aryankalra404/Neuryo-Headset/pcb/README.md

# Neuryo EEG board, rev B (plan)

**Status (5th pass, 11 Nov 2026):** designed in KiCad 10 ([neuryo-rev-b/](neuryo-rev-b/)), ERC/DRC/netlist checked after every step, firmware written, order files drafted ([order-draft-do-not-order/](neuryo-rev-b/review/order-draft-do-not-order/)), **not ordered**: the owner's checks before paying are in [checklist section 9](neuryo-rev-b/REVIEW-CHECKLIST.md) ([5th-pass changes](neuryo-rev-b/CHANGES.md#5th-pass-11-nov-2026), [assembly notes and placement-preview list](neuryo-rev-b/ASSEMBLY.md)). Rev B copies the analog half of a proven open board and adds a ready-made ESP32 board. Rev A (30 Oct, the v3 board: Cyton circuit, auto-routed, 100 × 80 mm, DevKit on sockets) is removed from this folder; it is in the git history (commit `14b8c37` and earlier).

| Folder | What is in it |
|---|---|
| [neuryo-rev-b/](neuryo-rev-b/) | Rev B in KiCad 10: project, [change list](neuryo-rev-b/CHANGES.md), [review checklist](neuryo-rev-b/REVIEW-CHECKLIST.md), renders, ERC/DRC reports, netlist and copper diffs against the reference, the reference imported into KiCad, and the scripts that made the edits |
| [low-cost-eeg/](low-cost-eeg/) | The upstream repo, complete (hardware, production files, firmware, receiver, case STLs, docs). The design rev B copies: [Low-Cost-EEG](https://github.com/XavierAsghar/Low-Cost-EEG) by Xavier Asghar, commit `3730d31` (12 Aug 2026). GPL-3.0 ([LICENSE](low-cost-eeg/LICENSE)); what was left out is listed in its [NOTICE](low-cost-eeg/NOTICE.md). **Do not order from `low-cost-eeg/Production_Files/NC Drill` as it is:** its drill coordinates are offset from the Gerbers (round-hole centres span x 64.4–158.9 mm, y 51.7–97.9 mm, while the Gerber outline is 0–100 × 0–50 mm) |

## Why this board
- **Same chips as ours:** ADS1299 (8 channels, SRB2 reference, bias drive) and an ESP32-S3, battery powered, 4-layer.
- **Built and used:** it recorded ECG, EMG, eyes-closed alpha, SSVEPs and P300s (Final Report, chapter 5), and a second person [rebuilt it](https://github.com/agteo/diy-eeg-mac) from the same files and recorded alpha.
- **Measured:** 1.10 µVpp input-referred noise with the inputs shorted, on the board itself (Final Report, section 6.1; the 2 µVpp earlier in the report is TI's evaluation board). The ADS1299 datasheet gives 1.13 µVpp typical at gain 12, 250 SPS.
- **Its analog section follows the OpenBCI Cyton**, like rev A did.

## What rev B copies unchanged (the analog half, about 55 × 50 mm)
In the KiCad rev B the analog half (x < 56 mm) and the LM27762 block are unchanged apart from the review changes; the TPS7A20 and its two capacitors had to be re-laid out in a strip under the LM27762 block (see [CHANGES B4](neuryo-rev-b/CHANGES.md)).

Placement, routing, ground pours and stitching kept as in the reference, left half of its board:
- Electrode inputs: 2.54 mm pin headers, 8 differential pairs, BIAS, SRB2.
- TPD4E1B06 ESD diodes, then 2.2 kΩ + 1 nF C0G low-pass on every input.
- ADS1299 with its decoupling, bipolar ±2.5 V mode.
- LM27762 charge-pump LDO for ±2.5 V; TPS7A20 low-noise LDO giving the ADS1299 its own 3.3 V.
- Stack-up: signal / ground / segmented power / signal; no split ground plane; analog left, digital right.

## What rev B changes (the digital half)
| Removed from the reference | Added in rev B |
|---|---|
| ESP32-S3-WROOM-1 and its 3.3 V LDO | Seeed XIAO ESP32-S3, soldered flat on castellated pads (Seeed's KiCad footprint); its 3V3 feeds the digital parts |
| USB-C, USB ESD, boot and reset buttons | The XIAO's own USB-C and buttons |
| USB / battery selector switch | Battery on/off slide switch (C&K PCM12, right edge); battery JST-PH (right edge) to the XIAO's BAT pads (the XIAO charges it) and to the LM27762 and TPS7A20 inputs |
| UART header | J6: earlobe MAX30102 and J7: BMI270, 1×4 headers on one I²C bus (the forehead MAX30102 header J8 was dropped) |
| | Battery divider (2 × 220 kΩ + 100 nF) to an ADC pin; USB-present divider; USB interlock (Q1, R37, R38) |
| | Outline 77 × 50 mm (the LM27762 block is kept in place, so 70 was not reachable), 2 mounting holes, for the v6 left pod |

## XIAO pin map
Final map in [neuryo-rev-b/CHANGES.md](neuryo-rev-b/CHANGES.md#final-xiao-pin-map-replaces-the-draft-in-pcbreadmemd). SPI on D1–D5 (330 Ω in series on SCLK, MOSI, CS since the 4th pass), battery on D0, I²C on D7/D8 (4.7 k pull-ups), USB sense on D9, ADS1299 RESET on D10 (4th pass); START and PWDN are tied (change 4).

## Review (8 Nov 2026): changes needed before ordering
Checked against the reference schematic and firmware (upstream `main.cpp`), the ADS1299 datasheet and the Seeed XIAO ESP32-S3 wiki.

| # | Change | Why |
|---|---|---|
| 1 | **Reference through SRB2, filtered.** Move R27 (2.2 kΩ) and C31 (1 nF) from SRB1 (pin 17) to SRB2 (pin 18, the next pin); leave SRB1 open and drop the header's direct SRB2 line. | On the reference, the REF header goes through R27/C31 to SRB1, but its SRB2 pin runs straight to the ADS1299 with no series resistor or filter. Upstream firmware uses SRB1 (MISC1 = 0x20, electrodes on the P inputs). D25 needs SRB2 so channel 8 can run differential (ECG). |
| 2 | **Analog off while USB is plugged in.** XIAO 5V pin → 2N7002 gate (100 kΩ to ground); its drain pulls the LM27762 EN+/EN− and TPS7A20 EN net (100 kΩ up to the battery) low. D9 (GPIO8) reads USB-present through a divider; firmware keeps the SPI pins high-impedance then. | Recording only on battery isolates the patient from mains. The XIAO's 5V pin is live only on USB (Seeed). The reference author lists this as the top-priority fix (Final Report 6.4). |
| 3 | **Charge batteries outside the headset.** Removable JST-PH cell, a separate charger and a spare. | The XIAO ESP32-S3 charges at 50 mA (Seeed), about 20 h for 1000 mAh. |
| 4 | **Pins with no XIAO GPIO:** START to ground through 10 kΩ (use the START command), RESET and PWDN to DVDD through 10 kΩ (RESET command), CLKSEL high as on the reference. Firmware sets BIASREF_INT = 1 (CONFIG3), as upstream does; the BIASREF pin is tied to AVSS on this board. | Datasheet: keep START low when using the command; mode pins through ≥ 10 kΩ. Upstream issue #1 (RESET on GPIO8 vs GPIO14) does not apply: rev B has no RESET GPIO. |
| 5 | **BIAS series resistor 51 kΩ** (R10, was 2.2 kΩ). Inputs stay 2.2 kΩ for the prototype; revisit with the test lab. | The bias amplifier can source 1.1 mA (datasheet) against DC patient-current limits of 10 µA normal and 50 µA single fault. TI's own figures show 51 kΩ patient-protection resistors. A 51 kΩ input resistor would add about 0.23 µVrms of noise, so not on the inputs yet. The reference author found the bias drive gave no benefit on ECG, so test with it on and off. |
| 6 | **Keep the bottom-side parts.** The 17 input filter capacitors, R32–R35, C49 and D6 are on the bottom: order two-sided assembly or hand-solder them; don't move analog parts. | The analog layout is the part that is proven. |
| 7 | **XIAO flat on the board:** its BAT pads are underneath, so the footprint needs matching pads and hot-air or hot-plate soldering; no copper or vias under its other pads. | Castellated edges can be hand-soldered, the underside cannot. |
| 8 | **Stock check:** ADS1299IPAGR, LM27762DSSR, TPS7A2033PDBVR, TPD4E1B06DCKR at LCSC/JLCPCB. | One order. |

## Channel map (v4)
Electrodes on the N inputs with M1 on SRB2 (through the filtered REF path, change 1), as on the Cyton: ch 1 Fp1, ch 2 Fp2, ch 3 Fz, ch 4 Pz, ch 5 M2, ch 6 eye, ch 7 free (no Cz pod anywhere, decision D36, v6.3), ch 8 ECG (SRB2 off, differential, test kit). BIAS to Fpz.

## Steps
1. ~~Import the reference into KiCad and check it~~ (done 8 Nov: BOM references and board/schematic connectivity match; sheet-by-sheet PDF comparison is on the checklist).
2. ~~Remove the module side; add the XIAO, J6, J7, interlock, dividers~~ (done; see the change list).
3. ~~ERC, DRC, netlist diff after every change~~ (done; reports in `neuryo-rev-b/review/`). 3D check in the v6 left pod done in the model (9 Nov, v6.1): with every rev B part at its KiCad position and height, the pod grows to about 98 × 77 mm and 22 mm off the skin (docs/v6.md).
   - Second pass (8 Nov, done): battery and a smaller switch (C&K PCM12) moved back to the right-hand end; XIAO pad 25 to GND (checked against Seeed's module PCB); KiCad SOT-23 for Q1; JLC 1.6 mm stack-up; silkscreen tidied; rev B firmware written ([neuryo-rev-b/firmware/](neuryo-rev-b/firmware/)). See CHANGES "2nd pass".
   - Fifth pass (11 Nov, done): from the 11 Nov review. LCSC numbers for every assembled part (in-stock equivalents for nine out-of-stock reference parts), R37 10 k, J1 drill 0.8 mm, JLCPCB-format placement file, clean order folder (PTH/NPTH split), firmware USB-restart fix, 150 ms reference wait, CONFIG3 0xEE. See CHANGES "5th pass".
   - Fourth pass (10 Nov, done): from the 10 Nov design review. Plated holes through the XIAO's BAT pads and no paste on its pads; 330 Ω on SCLK/MOSI/CS; 4.7 k I²C pull-ups; D10 to ADS1299 RESET; test pads on MISO/DRDY/AEN; bench firmware build and an honest ADS status; LCSC numbers; [ASSEMBLY.md](neuryo-rev-b/ASSEMBLY.md). See CHANGES "4th pass".
4. Professor review ([checklist](neuryo-rev-b/REVIEW-CHECKLIST.md)).
5. Order 2 assembled boards (JLCPCB); hand-solder the XIAOs. For the v6 left pod, leave the electrode input headers off and solder each lead into its two holes (the headers stand about 8.4 mm: Samtec TSW-xxx-26 is a 5.84 mm post on a 2.54 mm body). Footprints and layout stay as in the reference.
   - v7 pod (11 Nov): also leave JP1 and TP1 off (both hand-solder parts in `bom-hand.csv`; their footprints stay on the board). With v7's flat pod face, JP1 with its shunt (16.6 mm off the skin on the pod axis) would set the cover 4 mm higher, TP1 (12.6 mm) just above J1 (12.4 mm). JP1 joins BIAS_OUT to the ADS1299's BIASIN pin; the bias drive to Fpz runs BIAS_OUT → R10 → BIAS and does not go through it, and the firmware leaves BIAS_MEAS off (CONFIG3 0xEE, CHANGES F12). If JP1 ever has to be closed, solder a flat wire link across its two holes instead of the header. For a ground clip during bring-up, use any GND pad instead of TP1.
6. First board: power rails, ADS1299 ID register, shorted-input noise against the 6 µVpp target, then alpha with eyes closed.

## Licence
The reference is GPL-3.0, so rev B's board files will be GPL-3.0 too. That is fine for the prototype; decide before the product whether to keep the board open or redraw it.
