aryankalra404/Neuryo-Headset/pcb/neuryo-rev-b/README.md

# Neuryo rev B (KiCad 10)

The Low-Cost-EEG board (commit `3730d31`) with its ESP32-S3 module side replaced by a Seeed XIAO ESP32-S3, the review changes from `../README.md`, I²C headers for the earlobe MAX30102 and a BMI270, and a 77 × 50 mm outline for the v6 left pod. Battery and switch sit at the right-hand (digital) end. The stack-up is JLCPCB 4-layer 1.6 mm. 4th pass (10 Nov): 330 Ω on SCLK/MOSI/CS, I²C pull-ups, D10 → RESET, test pads, plated XIAO battery holes, bench firmware build. 5th pass (11 Nov): part numbers for everything JLCPCB assembles, R37 10 k, J1 drill 0.8 mm, order folder in [review/order-draft-do-not-order/](review/order-draft-do-not-order/). **Not ordered; waiting for review.**

| Path | What it is |
|---|---|
| `Neuryo_RevB.kicad_pro` / `.kicad_sch` / `.kicad_pcb` / `.kicad_dru` | The rev B project (KiCad 10.0.8). Zones are filled. |
| `Neuryo_RevB.pretty`, `Neuryo_RevB.kicad_sym` | New footprints and symbols: Seeed XIAO-ESP32-S3-SMD (from Seeed's library), KiCad's SOT-23 and SW_SPDT_PCM12 (C&K PCM12 slide switch), 1×4 header, 2N7002, PWR_FLAG |
| `Low_Cost_EEG-import-fps.pretty` | Footprints imported from the reference |
| [CHANGES.md](CHANGES.md) | Every change, why, its source, and whether it is verified |
| [REVIEW-CHECKLIST.md](REVIEW-CHECKLIST.md) | What to check before ordering |
| [ASSEMBLY.md](ASSEMBLY.md) | Hand-soldered parts (XIAO through its battery holes), bench board, battery polarity, electrodes |
| [firmware/](firmware/) | Rev B firmware (PlatformIO, XIAO ESP32-S3): upstream's with rev B pins, SRB2, command-driven RESET/START, USB interlock, battery and I²C status |
| `baseline-import/` | The reference imported into KiCad unchanged (plus the translated Altium clearance rules), for side-by-side comparison |
| `review/` | Renders (`top.png`, `bottom.png`), `schematic.pdf`, `layers.pdf`, ERC/DRC JSON, netlists, the netlist and copper diffs, the baseline's reports, a draft fab set (not for ordering) and `bom-jlc.csv`, the BOM with part numbers to order from |
| `scripts/` | The scripts that made every edit: `edit_sch.py`, `edit_pcb.py`, `edit_pcb2.py`, `silkplace.py` (reference-designator placement), `convmod.py` (KiCad 5 footprint to current format), `edit_sch_mpn.py` (restores the reference's part numbers), `jlcbom.py` (BOM with part numbers, no KiCad needed), `edit_sch4.py` and `edit_pcb4.py` (4th pass, one letter per plan step), `edit_sch5.py` and `edit_pcb5.py` (5th pass), `jlcbom.py` / `jlccpl.py` (BOM and placement file), plus the checks (`netdiff.py`, `copperdiff.py`, `drcsum.py`, `gerbdiff.py`) and `runner.sh`, which runs `kicad-cli` and PlatformIO. The paths inside them are the build machine's. |

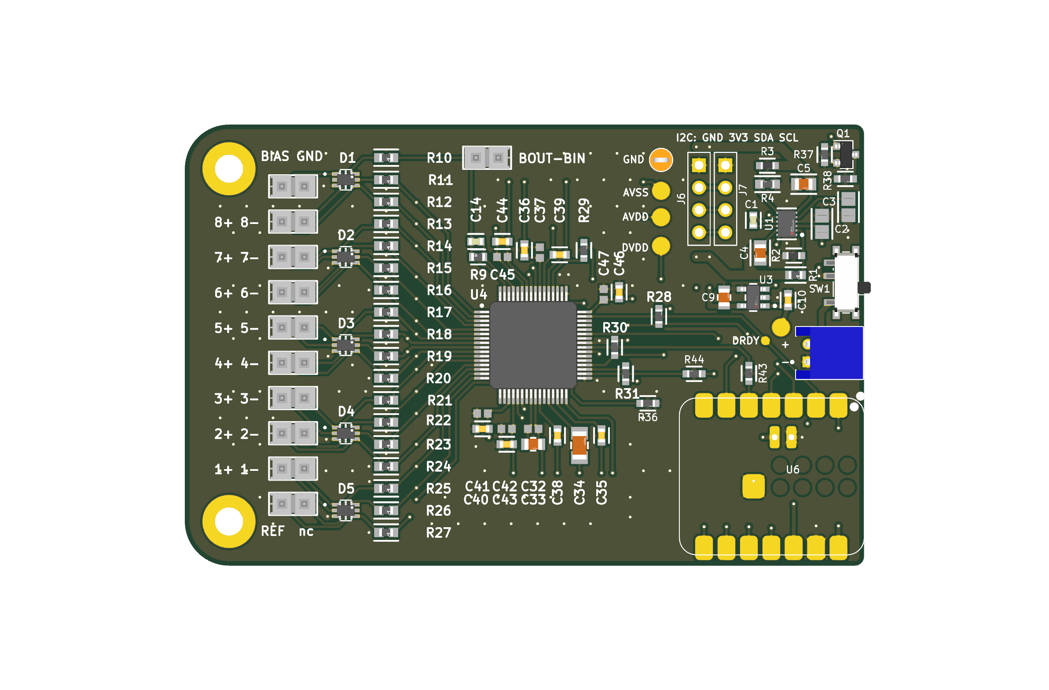
[picture p1: pcb/neuryo-rev-b/review/top.png]
top

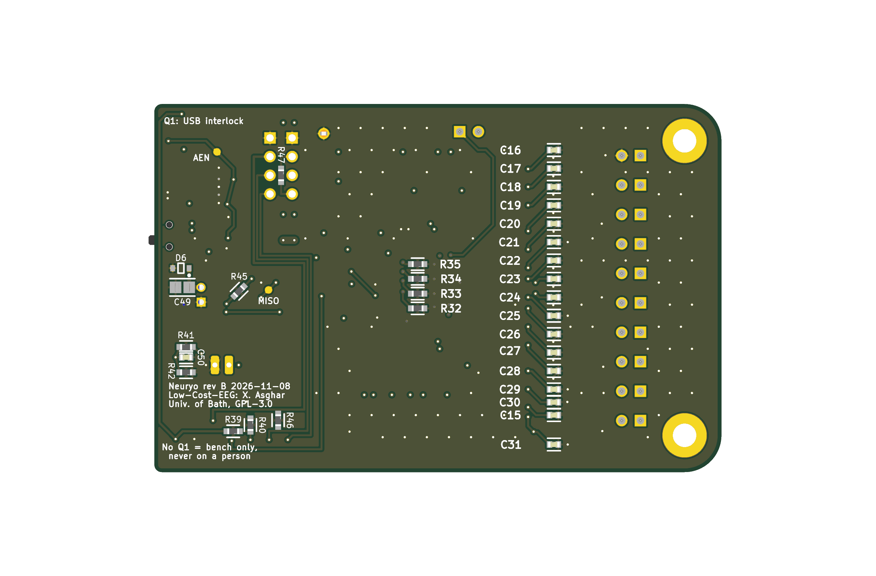
[picture p2: pcb/neuryo-rev-b/review/bottom.png]
bottom
