aryankalra404/Neuryo-Headset/docs/v7.md

# v7 · simplified ring and fixed Fz (11 Nov 2026; v7.1 and v7.2 the same day)

Live: https://aryankalra404.github.io/Neuryo-Headset/designs/v7/

**Status:** proposed lead design; the page and this file are v7.2 (the hair pod and carriage rework, last section; v7.1's fixes from the review of v7 in the section before it). From the 11 Nov design review of v6.3 (commit `de1e33d`) against the Neuryo-Research library (D01 to D36). v6 stays on the page as the adjustable-Fz alternative. Nothing here has been printed or measured: every size is a model estimate unless it says "computed from the model", and those are computed on the shared 540 mm head (nasion–inion 324 mm).

**What it is:** v6's idea, a midline band that lies on the head, made easier to build, slimmer and more repeatable to fit. Unchanged from v6.3: the montage (Fp1, Fp2, Fz, Pz, M2, eye; M1 reference; Fpz bias; no Cz, D36), the forehead and mastoid electrodes, the rev B board layout and KiCad files, the firmware, the shared head and every decision in `00-decisions.md`. v7.2 reworks the hair pod and its carriage (section at the end).

| Part | v7.2 |
|---|---|
| Head ring | One printed strap, 14 × 3 mm PETG, from a pivot behind the left pod, across the forehead, under both pods to a pivot behind the right pod. Unchanged from v6 across the forehead (el 39.5 at the midline, up to 45° each side), then a smooth descent under each pod's lower third, on a lining (3 mm on the forehead as in v6, 1 mm under the pods and to the pivots). Each pod is held on it by 2 × M3 (front hole round, rear hole in the strap a 6 mm slot) in a tunnel in the pod's base. The pods carry no ring tension. v7.1: a shallow cable groove along its upper edge from the anchor to the left pod; printed on its edge as a flat outline with no supports and no heat (to test), the supported edge print in its true curve kept as the fallback. |
| Nape section | The Karam PN521 rear section kept whole (knob, housing, both toothed straps). Each end pivots on the ring strap's 9 mm eye on one M3 screw and a lock nut, left just loose enough to turn. One smooth loop through the hook point under the occiput (15 mm below the inion); the two toothed straps overlap for about 45 mm either side of the dial. Paper mm scale and red index line kept (v6.2). |
| Chin-strap tabs | A printed tab on the ring strap just in front of each pod, hanging 8 mm below the strap's lower edge, with a 12 × 3 mm slot. The strap (10 mm wipe-clean TPU or silicone, side-release buckle, in front of each ear and under the chin) is in the test kit only. |
| Side pods | Outer box about **107.0 × 69.1 × 25.7 mm** (v7 106.7 × 69.0 × 25.2; v6.3 108.4 × 92.8 × 40.2). About 90 × 51 mm along the skin through the pod centre (v6: 97 × 75). Flat outer face parallel to the board, 15.5 mm off the skin at the board centre (v6: 22), with a lower, an upper and a back chamfer. Headset width **180.4 mm** (v7 183.1, v6.3 189.1). Clearance rule 3.0 mm. JP1 and TP1 left off the board; the motion sensor breakout sits on foam tape in the middle of the board. Same shell for the battery pod. Option: lower third in the ring's dark colour (two-tone). |
| Front anchor | As v6 (about 34 × 34 × 7.5 mm), plus three peg holes for the nasion gauge marked 1-3, 4-6, 7-9. Its pointer (v6's notch) now places the forehead strip. v7.1: a snap cap over the two screw heads. |
| Nasion gauge | New. Clip-in TPU 95A stem about 10 × 1.5 mm with a rounded 8 mm foot. Snapped into the anchor at the patient's size, it sets the distance along the skin from the foot (in the nasion) to the band's 0 mm mark to 31.5, 34.5 or 37.5 mm. Removed before recording. |
| Midline band | As v6.3, except: the Fz window is 20 mm long (was 32) with one notch and no numbers; the Pz window's front end is 2 mm further forward; the tail ends in a pull tab with a stretch section and marks; the spare end past the lock folds once in half under two sliding 6 mm TPU keepers. |
| Positions | Zero from the gauge (within 1.5 mm of Fpz). Fz fixed at 69 mm behind the zero (0.2 × 345 mm): at most 9 mm from its 10-20 site over 300–390 mm, up to 7 mm for 320–380 mm. Pz at 0.6 × nasion–inion, nine size notches as v6.3. The model places Fz by interpolation along the band, within 0.1 mm of the readout. |
| Fitting order | Headset first, nasion gauge in, dial, tail, gauge check, gauge out, then the forehead strip from the anchor's pointer. Saved per patient: size number, dial reading, cam-lock mark; only the size number changes where the electrodes sit. |
| Leads | One dark grey colour with a colour band at each end matching the sensor (v7: one pastel colour per lead). The two midline cables run in the ring strap's groove. |
| Midline module | Option, not decided: Display, Midline module off shows the forehead-only configuration (a crown strap from the anchor over the top to the cam lock, the Fz and Pz leads parked on two studs on the left pod, channels 3 and 4 off). Default on. |
| Hair pods (v7.2) | One printed pod body, 14.2 × 8.5 mm, open cavity underneath, solid top and a fill tube up the middle; a 2 × 4 mm Ag/AgCl pin stands 1.5 mm into the foam; single-use tip cartridge (foam in a collar, 12.6 mm chamfered nose, foam 2.5 mm proud) pressed up into the cavity. Two 1.75 mm filament guide pins run in closed slots in the carriage: they stop the pod 3 mm either side of the 1 N position, keep it from turning and point at three force ticks. Snap stud on a removable puck on the carriage top, joined to the pod by a soft pigtail. Carriage: 14.8 mm bore, top at 23.8 mm (was 22). Print files for the pod in `designs/v7/stl/`. |
| Electronics | Unchanged (rev B, XIAO ESP32-S3, BMI270 breakout, 1000 mAh cell in the right pod). |

## What changed from v6, and why

How sure: **Fix** (a clear problem with a clear fix), **Judgement** (a design call), **To test** (needs the frame test).

| ID | v6.3 | v7 | Why | How sure |
|---|---|---|---|---|
| R1 | Front band, then a rigid 98 mm pod, then the rear band: the pod shells carried the ring tension | One continuous ring strap; the pods ride on it (tunnel, 2 × M3, rear hole a 6 mm slot) | The pods acted as stiff links on the side of the head; stiff links whose fit changes with head size are where hot spots came from in the comparison studies v6 cites (C82). A hard-hat headband is one flexible loop with accessories clipped on. The slot lets the strap change curvature for wide and narrow heads without bending the pod | Fix |
| R2 | Nape U with a 60 mm level section and arms ending rigidly at the pods' back corners | PN521 rear section kept whole, pivoting on the ring strap's ends | The pods should not be the mounting points, and a rigid mount fixes the angle of the hook under the occiput, which differs between heads. Flat toothed straps bend round the head but not edgewise, so the loop stays one smooth curve through the gear (the v5 note stands) | Fix |
| R3 | None | Chin-strap tabs on the ring; strap in the test kit | Whatever presses the pods down pulls the ring up by about twice the band tension (`docs/v4.md`); at the 4–10 N of tail tension `tools/band_fit.py` assumes, that is 8–20 N of lift on a ring held by forehead friction and the hook. A chin strap is the standard answer on EEG caps; the tabs cost nothing | To test |
| P1 | Pods about 98 × 77 mm, uniform 22 mm off the skin | Flat face 15 mm off the skin, about 90 × 51 mm along the skin; JP1 and TP1 off; motion sensor lower | The board is flat and the head curves away under its ends, so v6's height was set by the ends while the centre was mostly air | Fix |
| M1 | Anchor notch lined up by eye with the centre mark of a strip placed with a paper template; strip first | Nasion gauge sets the band's zero; headset first, strip after from the anchor's pointer | The size notch is exact; the zero was the weak link. A physical stop repeats it every visit, and shows ride-up for free. Cost: three steps put the zero up to 1.5 mm from 0.1 × nasion–inion | Judgement |
| M2 | Fz carriage slides, five notches (1·2, 3·4, 5·6, 7·8, 9) | Fz fixed, one notch, no numbers; same carriage print as Pz | Fz's range is only 18 mm over 300–390 mm. The product needs the same spot on the same patient every visit (D03), which a fixed pod gives as well as a sliding one. 9 mm is under 3% of nasion–inion; neighbouring 10-10 sites are 10% apart. Removes four notches, labels that did not match Pz's, 12 mm of window and one setting. Cost: v6's "Fz within 2 mm of its site" no longer holds | Judgement |
| M3 | Tail travel "about 50 mm", tension by feel, spare end loose | Travel corrected to about 81 mm; pull tab with a zigzag stretch section and marks; free end folds back up to a keeper on the splice plate | The old figure was left over from the 300–348 mm range. The TPU tail is stiff (about 19 N per mm at 60 mm free length: EA / L with E about 26 MPa and 44 mm²), so a length mark does not set tension, and tension drives band lift and ring ride-up. Spare-end stowing only partly done (see Not done) | To test |
| M4 | None | Print aids in the Build tab: snip-off ribs in the Pz window, shoe gap test first, rinse the plunger sleeves | The rail over the Pz window is a 64 mm curved span that cannot bridge on its edge; the 0.7 mm shoe lip is the most fragile feature; dried saline in a sliding fit can jam | Fix |

## Computed numbers

### P1: what sets the pod height (computed from the v6.3 model)
Height of each part's top above the skin plane at the pod centre, along the pod's normal:

| Part | Top, mm |
|---|---|
| JP1 header with shunt | 16.6 |
| BMI270 breakout and lead (fixed inside the cover in v6) | 15.2 to 16.0 |
| TP1 ground test loop | 12.6 |
| J1 battery connector | 12.4 |
| XIAO USB-C | 11.8 |
| Board top face | 7.6 |

- JP1 and TP1 are "hand-solder if wanted" in `bom-hand.csv`. In v6's uniform shell, leaving JP1 off gained only 0.3 mm (J1 at the board's far end is next); with a flat face it gains 4 mm.
- With JP1 and TP1 not fitted and the BMI270 breakout on 2.1 mm foam tape over the board below the ADS1299 (its top now 12.2 mm, under J1), J1 sets the face: 12.4 + 0.5 mm air + 2 mm wall, so the face is at 15 mm.
- JP1 joins BIAS_OUT to the ADS1299's BIASIN pin. The bias drive to Fpz runs BIAS_OUT → R10 → BIAS and does not go through JP1, and the firmware leaves BIAS_MEAS off (CONFIG3 0xEE). If JP1 ever has to be closed: a flat wire link across its two holes (now in `pcb/README.md` step 5).
- Final pod, v7.1 (fit check, `tools/pod_fit.js`): every board part's bounding-box corners at least **3.01 mm** inside the cover's outer surface (needs 3.0: 0.5 air + 2 wall + 0.5 print margin), set by the XIAO's USB-C; J1 3.06, board 3.49, BMI270 3.6. Face 15.5 mm off the skin at the board centre. (v7: 2.51 mm against a 2.5 mm rule, set by the board's front-low corner, face 15.0 mm.) Footprint about **90 × 51 mm** along the skin through the pod centre (v6: 97 × 75); free space in the pod's board plane: 6.5 mm in front of the board's front edge (lead entry), 12 mm behind its back edge (battery plug, USB-C and switch slots). The footprint follows the board's projection, which drops toward its back end (lower and upper edges on lines, not a rectangle in angle).
- The side walls are taller where the skin falls away under the board's ends and corners. Expected.
- Pod and headset size (`tools/pod_fit.js`, outer box in the pod's own frame; headset width across both pods):

| | Outer box (length × height × thickness) | Along the skin | Headset width |
|---|---|---|---|
| v6.3 | 108.4 × 92.8 × 40.2 mm | 97 × 75 mm | 189.1 mm |
| v7 | 106.7 × 69.0 × 25.2 mm | 90 × 51 mm | 183.1 mm |
| v7.1 | 107.0 × 69.1 × 25.7 mm | 90 × 51 mm | 180.4 mm |
- The battery cell in the right pod moved 4 mm up and 0.6 mm out (model estimate) to clear the strap's tunnel: 1.45 mm between the strap's top and the cell.

### R1: ring path (`tools/ring_check.js`, final keys in the page code)
- Strap's lower edge to the top of the ear: at least **18.7 mm** (needs 8).
- Strap to the forehead strip: at least **3.9 mm** (needs 3), at about 60° each side.
- Strap's top to the board's underside (and its bottom-side parts) under the left pod: at least **2.26 mm** (needs 0.5 with 1 mm lining and 0.5 mm air); the strap fits under the board's lower third.
- No kink: tightest bend of the centre line about 24 mm radius (where the strap descends behind the pod into the nape section, on the head, so it includes the head's own curvature); the turn across each pivot is 1.3°, the same as between neighbouring samples.
- Edge print (model estimate): about 150 × 150 mm in its best-fit plane, inside a 220 × 220 mm bed. It is not flat: the centre line drops about 43 mm from the forehead to the pivots and leaves the best-fit plane by up to 7.9 mm, so printed on its edge it needs supports under the low points.
- Flat-outline edge print (v7.1, to test): developed length **391 mm**, flat outline **154 × 152 mm**, fits a 220 × 220 mm bed. Printed on its edge with the wall vertical, no supports and no heat; it twists into place when worn.

### M3: tail travel (`tools/tail_travel.js`)
The band's rigid part ends **251.5 mm** behind the band's zero (Fpz) for every head (computed from the v6.3 model). The cam lock sits near the inion, 0.895 × nasion–inion behind the zero on this head (290 mm). Free tail:

| Nasion–inion | Free tail |
|---|---|
| 300 mm | 17 mm |
| 324 mm (this head) | 39 mm |
| 390 mm | 98 mm |

- **Travel about 81 mm** (v6 said about 50 mm, from the old 300–348 mm range). Spec estimate was 82 mm (23 to 105 mm with the lock at exactly 0.9 × NI); the model puts the lock at 0.895 × NI along the band.
- At 300 mm the splice plate and the lock's jaw do not meet: about 3 mm between them (plate 16 mm long, jaw 12 mm, model).
- Spare end past the lock (tail plus the 45 mm pull tab), folded once in half (v7.1, F2):

| Nasion–inion | Spare past the lock | Fold reach | Lock to the Pz carriage | Margin |
|---|---|---|---|---|
| 300 mm | 125.6 mm | 62.8 mm | 73.3 mm | 10.5 mm |
| 324 mm (this head) | 103.9 mm | 51.9 mm | 83.0 mm | 31.0 mm |
| 390 mm | 45.0 mm | 22.5 mm | 105.9 mm | 83.4 mm |

- Fold reach is spare / 2, which is conservative. Drawn for this head: the spare end leaves the lock toward the nape, turns up over the tail (second layer, about 43 mm), folds at the splice plate and comes back down (third layer). It reaches 37.6 mm above the lock, because the part below the lock and the two turns use some of the spare.

### M2: Fz offset (fit panel)
Fz is fixed for a 345 mm head. Sign: + means the pod sits behind (further from the nasion than) its 10-20 site.

| Nasion–inion | Pod term 0.2 × (345 − NI) | Gauge step (zero − 0.1 × NI) | Total |
|---|---|---|---|
| 300 mm (size 1, gauge 1-3) | +9.0 | +1.5 | +10.5 |
| 345 mm (size 5, gauge 4-6) | 0 | 0 | 0 |
| 390 mm (size 9, gauge 7-9) | −9.0 | −1.5 | −10.5 |

The fit panel shows both terms. The spec's ±9 mm is the pod term; with the gauge's 1.5 mm steps the extremes are ±10.5 mm.

### Band check (`tools/band_fit_v7.py`, model estimate)
`tools/band_fit.py` copied with v7's band: one 20 mm Fz window with the pod fixed at 0.2 × 345 mm, and the zero from the gauge (three steps) instead of exactly 0.1 × NI. Same assumptions as v6.3 (PETG E about 2.0 GPa, foundation 3 N/mm², all assumed). Largest values over 300–390 mm and front-back vs height ×0.92–1.08:

| Tail / spring | Lift at Pz, v6.3 → v7 → v7.1 | Lift at Fz, v6.3 → v7 → v7.1 | Worst Fz error, v6.3 → v7 → v7.1 | Worst Pz error incl. rounding, v6.3 → v7 → v7.1 |
|---|---|---|---|---|
| 4 N / 1 N | 1.9 → 2.1 → 2.1 mm | 0.2 → 0.3 → 0.3 mm | 2.0 → 10.6 → 10.6 mm | 4.4 → 5.9 → 6.0 mm |
| 4 N / 3 N | 2.6 → 2.8 → 2.8 mm | 0.4 → 0.6 → 0.6 mm | 2.0 → 10.6 → 10.6 mm | 4.9 → 6.5 → 6.5 mm |
| 6 N / 1 N | 1.4 → 1.5 → 1.5 mm | 0.2 → 0.3 → 0.3 mm | 2.0 → 10.6 → 10.6 mm | 4.0 → 5.5 → 5.5 mm |
| 6 N / 3 N | 1.9 → 2.0 → 2.0 mm | 0.3 → 0.3 → 0.3 mm | 2.0 → 10.6 → 10.6 mm | 4.3 → 5.8 → 5.8 mm |
| 10 N / 3 N | 1.1 → 1.2 → 1.2 mm | 0.2 → 0.3 → 0.3 mm | 2.0 → 10.6 → 10.6 mm | 3.7 → 5.2 → 5.2 mm |

- v7.1's 2 mm longer Pz window (F3) shortens the solid section to 93 mm and changes lift by 0.03 mm or less.
- The shorter Fz window and the longer solid section (95 mm, was 90) change lift by 0.2 mm or less. Lift is still at Pz on the largest heads.
- Fz error is the fixed pod (±9 mm) plus the gauge step (±1.5 mm), by design. It repeats for the same patient.
- Pz error grows by 1.5 mm: that is the gauge's step. v6.3's model assumed the template put the zero exactly at 0.1 × NI, which a sticker lined up by eye may not do; the frame test's five-refit check is what compares the two.
- Printing the band in a 345 mm head's curve (still open from v6.3) cuts Pz lift on the largest heads to 0.7–1.9 mm with v7's band too.

## Checks (11 Nov, headless render of `designs/v7/` at v7.2)
Page served from the repo root, Playwright with Chrome (SwiftShader), as `tools/export_glb.js` does. Items 3, 4, 5 and 7 are v7.1's and were not re-run: v7.2 does not change what they measure (side pods, ring strap, tail, band); the folded-tail margin in item 5 uses the carriage's outer radius, which is still 12.2 mm.

1. **Page loads clean.** Product and Test kit mode, with the midline module on and off: every view button, the session walkthrough (11 steps), the pod guide (8 steps, dome and fingered tip, cutaway on and off), the board guide (8 steps), every part in the Parts list (27), every Changes row (40: the 9 v7.2 rows, then v7.1's and the rest), every Build row, every Display toggle on and off, and the nasion–inion slider at 300, 345 and 390 mm: no page errors. Pz readout at 300, 345 and 390 mm unchanged (size 1, 5 and 9). Pod guide: every step screenshotted with the cutaway on; with one hair pod viewed on its own the four layer labels sit on the pod body, the tip cartridge, the Ag/AgCl pin and a guide pin.
2. **Overlaps** (`tools/collide.js`, test kit on): 469 meshes with the midline module on (v7.1: 431; the new carriage is built from more pieces), 300 with it off (as v7.1). Everything v7.1 listed is unchanged. New in v7.2, all by design:
   - in each pod: the Ag/AgCl pin in its socket and in the foam; the guide pins in their holes in the body; the epoxy pot over the pigtail's inner end; the cartridge sleeve in the cavity (press fit) and the foam against the ceiling (the parity test reports a 4.8 mm "depth" at one vertex there, more than the parts are thick, as it does at v7.1's pivot stack);
   - on each carriage: the puck's peg in its hole; the snap stud inside the snap head; the lead's start and its colour end band in the snap head and on the stud.
   - Not reported, as expected: the pod body in the bore (0.3 mm gap), the guide pins through their slots and the pigtail through the slit (under the 0.3 mm tolerance), the spring round the fill tube. The carriage's own pieces are one print and are not compared with each other.
   - The two midline cables still touch at one point beside each other on the band: 0.53 mm (v7.1: 0.44). The lead's route along the band is unchanged; the tube is resampled along its new length.
   - Nothing else touches the hair pods, the carriages, the pucks or the pigtails. With the module off nothing of the hair pods is drawn and nothing touches the two parked leads but what v7.1 listed.
3. **Pod fit** (`tools/pod_fit.js`): every board part's bounding-box corners at least **3.01 mm** inside the cover's outer surface (needs 3.0), set by the XIAO's USB-C; nothing under 3.0. Face 15.5 mm off the skin at the board centre; outer box 107.0 × 69.1 × 25.7 mm; footprint about 90 × 51 mm along the skin; headset 180.4 mm wide (v7: 2.51 mm, 183.1 mm).
4. **Ring path** (`tools/ring_check.js`): strap's lower edge 18.7 mm from the top of the ear, strap 3.9 mm from the forehead strip, strap's top 2.26 mm under the board's underside (set by the board itself, not a bottom-side part), 1.85 mm under the battery cell; the tunnel roof in each pod's base clears the strap by at least 0.44 mm (review fix: the roof was 4.3 mm off the skin and left 0.04 mm at its tightest; it is now 4.7 mm, and the cell sits 0.4 mm higher). No kink: tightest bend about 23.5 mm radius, 1.3° turn across each pivot. Flat-outline edge print: developed length 391 mm, outline 154 × 152 mm, fits a 220 × 220 mm bed. Unchanged by the v7.1 pod chamfers.
5. **Tail travel** (`tools/tail_travel.js`): free tail 17, 39 and 98 mm at nasion–inion 300, 324 and 390 mm; about 81 mm of travel; at 300 mm the splice plate and the lock's jaw are about 3 mm apart. Folded spare end: 10.5, 31.0 and 83.4 mm clear of the Pz carriage at 300, 324 and 390 mm (table in M3).
6. **Pz at sizes 1 and 9** (`tools/pod_clear.js`, the whole Pz group moved to its size 1 and size 9 notch): nearest band lead clip 21.7 mm from the guide-pin ends and 22.3 mm from the stud puck at size 1, over 40 mm at size 9; Fz 17.3 mm (pins) and 23.0 mm (puck). Along the band, the 14.2 mm nose and body sit 2.7 mm behind the Pz window's front end at size 1 (v7.1's F3 contact stays gone) and 1.1 mm in front of its rear end at size 9; 0.92 mm from the rails either side at every size. Overlap test with the Pz group at each notch: it touches nothing outside itself. As before, the leads are drawn for this head's size and do not follow a moved carriage.
7. **Band check** (`tools/band_fit_v7.py`): table above.
8. **Try-on.** `designs/v7/neuryo-v7.glb` re-exported with `tools/export_glb.js` (324 meshes, 5.5 MB; v7.1: 286, 5.0 MB; board, battery and spring left out). `designs/v7/tryon.html` loads it with no page errors (checked with the page's own handle, not a live camera).
9. **Share links.** `#part=fz` reloads with the Fz pod selected; `#part=pz&mode=test` with the Pz pod selected and Test kit on; `#part=crown&view=top&show=nomidline` with the module off, the crown strap selected and the top view. With `show=nomidline`, no mesh of either hair pod or carriage is visible (0 of 84).
10. **Pod travel** (`tools/pod_travel.js`, v7.2): pod and cartridge moved 3 mm up and 3 mm down, spring squeezed or stretched to match. Fz and Pz the same:

| | Up 3 mm (upper stop) | Down 3 mm (lower stop) |
|---|---|---|
| Guide pin to its slot's end | 0.03 mm | 0.03 mm |
| Body top to cap underside | 7.0 mm (spring 7.0 mm long) | 13.0 mm |
| Fill tube top | 7.0 mm above the cap's top face | 1.0 mm above the cap's top face, 1.0 mm below the port ring's rim |
| Touching | only the pod's own parts (as at 1 N) | only the pod's own parts (as at 1 N) |

   Clearances (`tools/pod_clear.js`): the slit and both slots are 60 degrees from a foot's centre, 24.5 degrees from its edge; gap edge to foot edge 19.8 degrees (slit) and 18.3 degrees (slots), 4.2 and 3.9 mm along the outer wall. At the upper stop the stud puck is 2.32 mm and the snap head 2.82 mm from the fill tube (radial).
11. **Print files** (`tools/pod_v72.py`): pod-body.stl 32,392 triangles, 14.2 × 14.2 × 24.55 mm; pod-body-rig.stl 39,446 triangles, 14.2 × 14.2 × 37.55 mm; tip-collar.stl 8,252 triangles, 14.15 × 14.15 × 3.0 mm; stud-puck.stl 7,884 triangles, 11.0 × 11.0 × 6.5 mm; bore-test.stl 62,318 triangles, 60.8 × 19.0 × 6.0 mm. Walls (asserted): socket to guide-pin hole 2.16 mm (needs 1.5), pocket to guide-pin hole 1.67 mm (needs 1.0), guide-pin hole to top face 0.62 mm (needs 0.6), guide-pin hole to ceiling 1.42 mm (needs 1.2). Guide-pin holes checked at 120 and 300 degrees from +x (the lead side).

## Buy-plan delta
Not in the v6 buy-plan PDF (not regenerated; prices not re-read). Nothing is removed.

| Item | For | Qty | Price |
|---|---|---|---|
| Side-release buckle and 10 mm TPU or silicone strap | Chin strap, test kit (R3) | 1 | to quote |
| M3 screws and lock nuts | 2 nape pivots and 4 pod mounts (R1, R2) | 6 | to quote |
| 25 mm plastic cam buckle (option) | Instead of the printed jaw, lever and pin (M3) | 1 | to quote |

The spec listed "4 × M3 screws and lock nuts for the pivots and pod mounts"; the model uses six (one per pivot, two per pod).

v7.2 (hair pod), all to quote, on the Build tab's parts list:

| Item | For | Qty | Price |
|---|---|---|---|
| Sintered Ag/AgCl pellet 2 × 4 mm with silver wire | Pod contact for Fz and Pz, 1 spare (D07, L10) | 3 | to quote |
| Fine silver wire 2 mm, 50 mm | First-build contact and comparison arm: 4 mm pins chlorided in household bleach | 1 | to quote |
| Compression spring 6 mm OD, 0.4 mm wire, about 17 mm long | About 1 N at 10 mm length; check on a kitchen scale | 4 | to quote |
| Silicone wire 28 AWG, 0.5 m, and 4 mm snap studs | Pigtail from each pod to the stud puck on its carriage | 3 studs | to quote |
| Polyester felt pads 10 mm (Emotiv replacement felts) | Tip test arm F (L65, C110) | 1 pack | to quote |
| Baby shampoo, glycerine, distilled water | Saline test arms; rinse water for the pods (C113, C110, C112) | 1 each | to quote |

The TDE-211 row stays (6 bought): 3 for the strip, 3 spare; it is no longer a pod core (the maker lists it as plated, C116). The dropper row is now a needle-free 1 ml syringe. The priced total is unchanged.

## Frame test additions
Add to the existing list:
- Ride-up: after tightening the tail, does the gauge foot still sit in the nasion? Repeat after 5 minutes and after nodding. With and without the chin strap.
- Tail tension with a luggage scale at the pull tab, against band lift at Pz (feeler gauge) and ride-up.
- Refit the same person five times: tape-check Fz and Pz each time. This is the number that matters (D03).
- Pods on the strap: do they rock or leave a gap at the top edge on narrow and wide heads?
- Nape pivot: does the hook seat under the occiput on its own?
- Long hair, a low ponytail and a braid: where do they go relative to the nape strap and the tail?
- Pull-tab coupons: hang 400 g and 600 g; keep the beam width (1.6, 2.0, 2.4 mm at 2 mm thick) that stretches about 10–15 mm at 5 N.
- Ring strap print (v7.1, F5): print it on its edge as a flat outline (wall vertical, no supports, no heat) and check it twists into place on the head without forcing it edgewise; compare with an edge print in its true curve with supports.
- Folded tail (v7.1, F2): on a 300 mm head, does the fold stay clear of the Pz carriage, and do the keepers slide over three layers by hand? Do they catch long hair?
- Press each pod on a kitchen scale and confirm about 100 g at the middle tick (v7.2).
- Bore test print: keep the ring (14.6, 14.8 or 15.0 mm) the pod body slides in without rattling (v7.2).

## Still open
- Nothing printed: every size in this file is a model estimate on one head.
- The ring strap is not flat (up to 7.9 mm out of its best-fit plane). v7.1 prints it on its edge as a flat outline, with no supports and no heat, and lets it twist into place when worn (to test); fallbacks: on its edge in its true curve with supports, two halves joined under the anchor, or the PN521's own headband as the ring if it is the right width at the forehead (a build note in R1).
- Three TPU layers under a keeper may catch hair (v7.1, F2).
- The pull tab's stretch marks are untested, and TPU relaxes under load: the marks may drift with use. Check them against weights at the start of each session day until the frame test says how fast they drift.
- The pods ride on the strap with 2 × M3 each: whether they rock on narrow and wide heads (frame test).
- The nape section's real travel through the PN521 housing (each toothed strap needs about 40 mm for 500–580 mm heads) is on the "measure when it arrives" list.
- The gauge's zero steps add up to 1.5 mm at Pz (band check above). A continuous gauge (a sliding stop with a scale) would remove that at the cost of one more setting.
- Fixed Fz gives up v6's "within 2 mm" at Fz. If the team wants absolute 10-20 accuracy for publication, v6's Fz window goes back in.
- Printing the band in a 345 mm head's curve (from v6.3).
- Disinfecting the pod cavity and pin between patients (v7.2). Rinsing is the maker's guidance for Ag/AgCl (C112); a noncritical device needs low-level disinfection (R18, D32). Test: a 70% isopropyl flush, then drift on the pin.
- Sintered pellet source and price in India. Until then the chlorided silver pin is the first-build contact.
- Real size of the TDE-205 snap head and of the 4 mm studs; the puck's recess is an estimate.
- Whether wet PVA foam under 1 N compresses until the nose touches the hair, and whether that matters. Felt is the stiffer arm.
- Felt pad size against the 10.0 mm collar bore.
- Collar press fit in PETG against TPU: which one releases cleanly after a session.
- Spring from an assortment: how close to 0.14 N/mm the team can get.
- Whether pins 1.5 mm proud catch hair when the headset comes off.

## Not done
- **M3, folding the spare end back up over the tail** (v7): replaced in v7.1 by folding it once in half under two keepers (F2), which clears the Pz carriage on every size.
- **X1** (priority 4, optional): still left. M5 and L1 are in v7.1.
- v7.1 items not done: none. F1 did not reach the review's hoped-for width (see the v7.1 section).
- v7.2, not in its spec: carriage and band print files (the whole v7 frame still has no STLs); the dry spike plunger (a pod-shaped holder for a TDE-212 with its own pigtail and puck), drawn as a placeholder only; a felt option in the pod guide's tip buttons; mobile layout checks beyond "no errors".

## Notes for Neuryo-Research (for Aryan to add under "Still open" only if he agrees; not decisions)
- v7 (11 Nov 2026): continuous head ring with pods riding on it; nape section pivots; nasion gauge sets the band's zero; Fz fixed at 69 mm behind the zero (up to 9 mm from its 10-20 site, repeatable per patient); chin-strap tabs as insurance. Design judgement, no new sources. Would change it: the frame test.
- Fixed Fz gives up v6's "within 2 mm" at Fz. If the team wants absolute 10-20 accuracy for publication, v6's Fz window goes back in.
- Forehead-only configuration: the full-cap subset test should report results with and without Fz and Pz, the same way D36 treats Cz.
- Inclusion gap: no source in the library covers turbans, hijabs or tied-up long hair with midline scalp electrodes.
- Chlorided silver wire as a first-build contact has no row in the evidence log; if kept after the pod test it needs a source.
- D32's wipe-down wording does not yet say the Ag/AgCl pin is rinsed, not wiped (C112).

## On the page
- Fit & finish: the readout adds **Gauge position** (1-3, 4-6, 7-9) and **Fz** (fixed, how far from its site for the head chosen, pod term and gauge step shown); Pz shows its size number and offset.
- Parts: **Nasion gauge** (shown only when picked, in walkthrough steps 5 and 6, and never at the same time as the forehead strip) and, in the test kit, **Chin strap (test kit)**.
- Session walkthrough (11 steps): prep with hair down and combed along the midline; size number on the first visit; tips on and Pz to the size; headset on and gauge in; tail, lock and gauge check; forehead strip from the anchor's pointer; pads and clip; contact check; record; remove and clean.
- Build tab: the v7 frame build (ring strap, pivots, pods with tunnel and M3 mounts, gauge, print aids) and the new parts "to quote"; v7.1 adds the flat strap print (to test), the keepers, the cable groove, the anchor cap and the pod's outer box. Changes tab: v7.1 rows first, then one row per v7 change above the v6 rows.
- v7.1: Display, Midline module (M5); Shell, Two-tone (L1); the walkthrough shows each part from its own step (F4).
- v7.2: the hair pod and carriage rework on the headset; the pod guide rebuilt in 8 steps from the same numbers; Build tab, step 5 and the five pod print files; nine Changes rows on top.

## v7.1 (11 Nov): fixes from the review of v7
Edited in place in `designs/v7/`. Unchanged: v6 and older, the montage, pod internals, the rev B board layout and KiCad files, firmware, the shared head and every decision in `00-decisions.md`. Every size is a model estimate on the 540 mm head.

| ID | What | Why | How sure |
|---|---|---|---|
| F1 | Clearance rule 3.0 mm (0.5 air, 2.0 wall, 0.5 print margin). Face 15.5 mm off the skin; lower, upper and back chamfers; BMI270 moved to the middle of the board. `tools/pod_fit.js` reports the outer box and the headset width. Outer box 107.0 × 69.1 × 25.7 mm, headset 180.4 mm wide (v7 183.1) | v7's 2.5 mm rule had no print margin, and the docs quoted only the skin footprint, which hid the real pod size. The chamfers take corners the board does not use | Fix |
| F2 | Spare end folded once in half under two sliding 6 mm TPU keepers, drawn for this head. `tools/tail_travel.js` reports fold margins: 10.5, 31.0 and 83.4 mm to the Pz carriage at 300, 324 and 390 mm | v7's fold-back reached the Pz carriage on heads under about 341 mm | To test |
| F3 | Pz window's front end 2 mm further forward. `tools/band_fit_v7.py` rerun (band check above); one line added to `docs/v6.md` | At size 1 the Pz pod's tip collar touched the window's front end | Fix |
| F4 | Walkthrough shows each part, its lead and its label only from its own step | The strip socket, the pad leads and the clip lead showed from step 1 | Fix |
| F5 | Ring strap printed on its edge as a flat outline (154 × 152 mm, 391 mm developed length), wall vertical, no supports, no heat; it twists into place when worn. The supported edge print in its true curve stays the fallback. `tools/ring_check.js` reports both | An edge print in the true curve leaves its plane by up to 7.9 mm and needs supports. A 14 × 3 mm PETG strap twists easily, and it has to twist anyway to lie on the head | To test |
| F6 | Fz placed by interpolation between the band's samples, within 0.1 mm of the readout | v7 snapped Fz to the nearest sample | Fix |
| L1 | Leads one dark grey colour with a colour band at each end; a cable groove on the ring strap from the anchor to the left pod; a snap cap over the anchor's screws; a two-tone pod option (Shell: Two-tone) | Pastel leads and loose cables read as lab equipment; the end bands keep each lead identifiable | Judgement |
| M5 | Display, Midline module (default on; share key `show=nomidline`). Off: the band, Fz, Pz, the gauge and their leads are hidden; a crown strap runs from the anchor over the top to the cam lock; the two leads park on studs on the left pod; channels 3 and 4 off; header chip "Forehead-only configuration (option, not decided)" | Lets the team see the forehead-only product if the full-cap subset test says Fz and Pz add little. An option, not a decision | Judgement |

Beyond the review's ask, and notes:
- F1 back chamfer: the review asked for lower and upper chamfers. The XIAO's USB-C sits at the board's back-low corner and set the width, so a third chamfer on the back end was needed to move it. The review hoped for about 3 mm off each side; the board allows about 1.3 mm (width 183.1 → 180.4 mm). The outer box is unchanged because the footprint is.
- F2 keepers are 6 mm wide, not 8: between the splice plate and the lock there is room for two 6 mm keepers with 0.5 mm gaps on this head.
- Still open (F2): three TPU layers under a keeper may catch hair. Check in the frame test with long hair.
- F5 is to test. If the flat-outline strap does not twist into place or has to be forced edgewise, print it on its edge in its true curve with supports, print two halves joined under the anchor, or use the PN521's own headband as the ring.

Review fixes (11 Nov, after v7.1 was merged):
- F5 wording corrected everywhere: the strap is printed on its edge as a flat outline, with no supports and no heat, and twists into place when worn. Earlier text said "printed flat and heat-formed" and called the edge print weak across its layers; neither was meant. On its edge the layers run along the strap, which is the strong direction for wrapping round the head.
- Crown strap text corrected: it runs from the anchor over the top to the cam lock, as the model draws it.
- Strap tunnel under the pods: roof raised from 4.3 to 4.7 mm off the skin, so the strap has at least 0.44 mm of print clearance (was 0.04 mm at the tightest point). The battery cell sits 0.4 mm higher to keep its gap to the roof (now 1.85 mm above the strap's top). Pod fit unchanged (3.01 mm), headset width unchanged (180.4 mm); the pod's outer box is 107.0 × 69.1 × 25.7 mm (was 106.7 × 69.0 × 25.7). The try-on model was not re-exported for this 0.4 mm inside change.

## v7.2 (11 Nov): hair pod and carriage
Edited in place in `designs/v7/`, from the v7.2 change spec (written against commit `61dba76`) and the 11 Nov electrode review (`Neuryo-Research/00-pod-review-v7.md`). Unchanged: everything v7.1 added, the frame, the board, the forehead and mastoid contacts, v1 to v6, the uc-adapter files and every decision in `00-decisions.md`. Every size is a model estimate; nothing has been printed.

### Problems found (review: 1 to 6; reading the carriage code: 7 to 9)
| # | Problem in v7 and v7.1 | Fix in v7.2 | Basis |
|---|---|---|---|
| 1 | Parts list builds the pod on the TDE-211, which is Ag/AgCl plated; build guide asks for sintered | One contact: a 2 × 4 mm Ag/AgCl pin (sintered pellet, or chlorided fine silver for the first build) | C116, L10, L39, D07 |
| 2 | Foam only touches a concave metal face (butt joint, no overlap) | The pin stands 1.5 mm into the foam, and the foam is 1 mm over-length | C110, C113, C85 (all grip or surround the tip) |
| 3 | Fill tube missing; drops fall 8 mm onto a 2 mm hole, then meet a 1.6 mm hole that surface tension can block | Fill tube is part of the pod body and its bore opens directly onto the foam | docs/v5.md; arithmetic |
| 4 | Tip collar is a 15.2 mm flat ring that rides on hair | Cartridge nose is 12.6 mm with a chamfer | C113 (flared pedestal), L58; judgement |
| 5 | No step to seat the pod in hair | Lift by the guide pins and rock 1 to 2 s | C113, C111 |
| 6 | "Wipe everything" includes the Ag/AgCl face; wet tips stored in packs | Rinse the cavity and pin, wipe the rest; tips wetted on the day | C112, C110, C113 |
| 7 | Carriage bore is 21.8 mm round a 14 mm pod: nothing guides the pod and nothing stops the spring pushing it out through the 16 mm band window | 14.8 mm guide bore; two guide pins in closed slots (guide, stop, anti-rotation, force mark) | uc-adapter already works this way |
| 8 | Spring has 5.3 mm of space for "about 6 mm of travel" | 10.0 mm spring space at the 1 N position, carriage 1.8 mm taller | arithmetic |
| 9 | The snap lead's head is drawn 4.8 mm wide on the lid; a real one (about 10 mm) hits the centre tube and spring | Stud moves off the pod to a puck on the carriage top; a soft pigtail joins pod and stud | judgement; lead mass off the moving pod |

### Decisions
| ID | Decision | How sure |
|---|---|---|
| E1 | Pod body is one print: open-bottom cup, solid lid, fill tube. No epoxied lid | Engineering |
| E2 | Contact is a 2 mm × 4 mm Ag/AgCl pin on the lead side, 1.5 mm proud of the cavity ceiling | Judgement |
| E3 | Fill tube bore opens at the cavity ceiling, onto the foam. No gap above the contact, no vent | Engineering |
| E4 | Tip cartridge = foam plug in a collar that press-fits into the pod cavity (the uc-adapter pattern). Nose 12.6 mm, foam 2.5 mm proud | Judgement |
| E5 | Carriage: thick wall with a 14.8 mm bore, two closed pin slots, one lead slit, 10 mm spring space, top at 23.8 mm | Engineering |
| E6 | Guide pins: two 1.75 mm filament pins, 1.5 mm proud of the carriage; they are the lift tabs and the force pointers | Engineering |
| E7 | Snap stud sits on a removable puck on the carriage top; a 28 AWG silicone pigtail runs from the pod through the slit to the puck | Judgement |
| E8 | Paste arm = the same pod with an open collar filled with gel or paste. Dry spike arm needs its own plunger and is drawn but not detailed | Judgement |
| E9 | Procedure: wet on the day, seat by the pins, top up through the tube with a needle-free syringe, rinse cavity and pin, never store a wet tip on a pod | Fix (makers' instructions) |
| E10 | Pod drying test: arm A (1 ml reservoir) dropped; felt, shampoo saline, gel and contact arms added | To test |

### Computed numbers
- Pod body 14.2 × 8.5 mm; cavity 11.6 × 4.7 mm; solid top 3.8 mm; fill tube 4 mm outside, 2.5 mm bore, 16 mm above the body's top.
- Foam 10 × 9 mm free, 2.5 mm proud of the nose, pressed 1 mm by the ceiling. Pin 2 × 4 mm, 1.5 mm into the foam.
- Nose 12.6 mm across: 69% of the old 15.2 mm face's area.
- Bore 14.8 mm (0.3 mm a side round the 14.2 mm body). Travel 3 mm each way from the 1 N position.
- Spring space 10.0 mm at 1 N. Spring: 6 mm OD, 0.4 mm music wire, about 17 mm free, about 10 active coils: about 0.14 N/mm (G = 79 GPa). About 0.6, 1.0 and 1.45 N at the lower stop, the middle tick and the upper stop (13.0, 10.0 and 7.0 mm long); solid height about 4.8 mm, so it never bottoms. From an assortment: one that reads 100 g (± 20) on a kitchen scale when squeezed to 10 mm.
- Carriage top 23.8 mm (was 22). Fill tube top 4 mm above it at 1 N; 7 mm at the upper stop, 1 mm at the lower stop (still inside the 2 mm port ring).
- 1 N on a 10 mm tip is about 12.7 kPa (L54: about 12 kPa was comfortable).
- Drop arithmetic behind E3: a drop can hang over a 1.6 mm hole at about 180 Pa of surface-tension pressure; 1 mm of saline gives about 10 Pa.

### Not changed
Everything v7.1 added (pod chamfers and the 3.0 mm rule, folded tail and keepers, the longer Pz window, cable groove, anchor cap, lead colours, two-tone option, crown strap and the Midline module toggle, walkthrough step visibility), the head ring, nape section, side pods, board, battery, firmware notes, nasion gauge, anchor, the midline band (windows, rails, notches, numbers, tail, lock), the Fz position, the montage, the forehead strip, the mastoid and eye pads, the ear clip, the fit sliders and the try-on page logic. The lead's route along the band is unchanged: only its start moved from the pod lid to the stud on the carriage. The buy-plan PDF was not rebuilt. Nothing in Neuryo-Research was edited.

### On the page and in the repo
- Headset: `POD` and `POD_PROF` next to `makePod`; the pod guide draws from the same numbers. Carriage per section 3.4 of the spec (stacked bands with the slit, two closed slots and the guide lip; force ticks; cap 21.8 to 23.8; port ring r 2.3 to 3.6; stud puck at r 9.8 toward the lead side). Pod layer labels: pod body, tip cartridge, Ag/AgCl pin, guide pin.
- Pod guide: 8 steps (print the body, fit the pin, solder the pigtail and seal, into the carriage, make and wet the tips, tip on and seat it, top up, how it picks up the signal), with a short section of carriage, the spring, both guide pins, the puck and stud and the pigtail where they are needed. The syringe seats on the fill tube's top; drops run down the tube and the foam wets from the top down.
- Texts: Specs ("In hair", "Pods in hair"), references, Fz and Pz parts, buy line, parts list (3 rows edited, 6 added, all to quote; the priced total unchanged), kit list, Build step 5, pod drying test, Indian-hair test, nine Changes rows on top, four walkthrough steps (still 11 steps).
- Print files: `tools/pod_v72.py` writes `designs/v7/stl/`: [pod-body.stl](../designs/v7/stl/pod-body.stl), [pod-body-rig.stl](../designs/v7/stl/pod-body-rig.stl), [tip-collar.stl](../designs/v7/stl/tip-collar.stl), [stud-puck.stl](../designs/v7/stl/stud-puck.stl), [bore-test.stl](../designs/v7/stl/bore-test.stl). The rig body's tube top is at 37.5 mm, the uc-adapter pod's height, so the rig's "flush = 1 N" mark still works; the body is 2.5 mm shorter than the uc pod, so put a 2.5 mm printed washer under the rig's spring. The Build tab lists the five files under the frame steps.
- New tools: `tools/pod_travel.js` (check 10 below), `tools/pod_clear.js` (clearances in check 10).

### Choices made where the spec left them open
- The Ag/AgCl pin, the epoxy pot, the guide pins and the pigtail are added in the carriage loop, where the lead side is known, not passed into `makePod`.
- The pod body now sits beside the tip in the insert group, so the paste arm shows the same pod with an open collar and a paste fill; the dry-spike placeholder (radius 7.1 mm, top at the pod's top) replaces the body. `applyInserts` reads a short list of tips each part goes with.
- Pigtail: drawn in two pieces, the inner part moving with the pod and the slack loop with the carriage. On the headset it crosses the pod's top face at 12.4 mm (the lathe body has no wire channel); in the pod guide and the print file it lies in the 1.4 mm channel at about 11.3 mm. It ends at the puck's rim, where the wire groove starts.
- Snap head 10 × 4 mm (estimate), 0.4 mm above the puck, over the stud. The lead leaves it outward at the same height, swings round outside the carriage toward the left foot and then joins v6.2's last two points.
- Force ticks on one side of each slot, the middle one 2.0 mm long and the two stops 1.2 mm.
- Pod guide state keys: `pin`, `pot`, `cart`, `car` (positions), `fill`, `wet`, `scalp`, `seat` (flags). Lead side at +x; seen from the tube end the pins are 60 and 240 degrees clockwise from it, as on the headset and in the print file; the cutaway keeps the 240 degree slot. Step 6 lifts the pod 3 mm, rocks it and is seen from behind so the ticks show.
- The explode distances (34 and 13 mm) stay: the cartridge comes out below the body.
- The flat tip keeps its last-step texts; one callout that named the old lid stud now says "Pigtail to the stud".
- Text fixes beyond the spec's list, so no hair-pod text contradicts the new pod: page title and header (v7.2); Specs, "Pods in hair" (6 mm of travel and shims replaced by the guide, stops and ticks); the midline band's source line (travel); the spring-assortment row (pick one that reads about 100 g at 10 mm); the dome note ("wetted on the day"; the snap lead clips onto the stud on the carriage top); "pre-wetted" in the Fz part text and the insert name; the hair paste and spike arms' insert names.
- `tools/pod_clear.js` added for the clearances in check 4 of the spec.

### Where the spec did not fit exactly
- Slit and slots against the feet (spec: "at least 24 degrees clear"): each gap's centre is 60 degrees from a foot's centre, so 24.5 degrees from the foot's edge. Edge to edge it is 19.8 degrees for the slit and 18.3 for the slots (4.2 and 3.9 mm along the outer wall).
- Radial-sided gaps (allowed by the spec in the page model) are narrower at the bore than at the outside: at r 7.4 a 2.1 mm slot is 1.58 mm wide against a 1.76 mm pin, and the slit 1.21 mm against a 1.2 mm pigtail. The carriage print, when it is made, needs parallel-sided slots.
- `pod-body.stl`'s tube top measures 24.55 mm, not 24.5: voxel rounding (0.08 mm grid).
- The pod guide's first step shows plain text, so the print-file links went on the Build tab instead (the spec allowed either).
