aryankalra404/Neuryo-Headset/designs/v7/index.html

Loading model…

Neuryo v7.2Forehead-only configuration (option, not decided)v7.2 · 11 Nov · one continuous head ring with the pods riding on it, chamfered flat-faced pods, nasion gauge, fixed Fz, Pz size setting, folded tail, reworked hair pod · no Cz · nothing printed yet

HeadSolidGhostHidden

Display ▾

Show

See-through shellI Electronics onlyE

Overlays

LabelsL SizesS Channel numbersN All 77 10-10 sites Midline module

Colour parts by

How sure the plan isC Single-use vs reusableU v2 behind-ear sites

Try it on Copy link Details ? View in AR

ModeProductTest kit

Fit & finish▾

Head circumference540 mm

Nasion–inion (size tape)324 mm

Soft layerSage

SiliconeKnit ideaSee-through

ShellPorcelain

Everything wipes clean between patients in one step: hard pods, head ring, midline band, carriages and gauge, soft silicone pads where the frame touches the head (D34). The knit sleeve is a dropped idea, kept here only to compare looks.

Test kit · compare options

ForeheadStripGel padsPasteDry flat

HairSemi-dryPasteDry spike

HeartEarlobe+ Forehead

Every option clicks onto the same 4 mm snap, so one frame tests them all. Strip, semi-dry and earlobe are the product; gel pads (three Neo Gel pads with the foam trimmed to 21 mm wide) are the first build; the rest are comparison arms for Study 1 (D30, D22). ECG pads on channel 8 are the reference for the heart sensors.

How sure the plan is

Decided

Needs testing

Design choice

Carried over

After each patient

Single-use: bin

Wipe clean

Washable (knit idea only)

Sealed inside

On intact skin the headset is a CDC “noncritical” item: a low-level disinfectant wipe between patients (R18). Everything that holds gel or touches skin directly is single-use (D32).

×

View on its own

Show everything

PartsSessionBuildChangesSpecsSources

What it is

A 5-minute brain and heart recording taken at each treatment visit; tracks change in the same patient. Monitoring aid, not diagnosis (D01, D31)

First use

Depression treatment courses: baseline, day 7, every follow-up. Hospital psychiatry and rTMS clinics first

On the head

6 channels · Fp1, Fp2, Fz, Pz, M2, eye (VEOG) · no Cz channel (D36, v6.3) · v7.1 option, not decided: forehead-only configuration without the midline band (Fp1, Fp2, M2, eye; Display, Midline module)

EEG chip

ADS1299, 8 channels · ch 7 free · ch 8 ECG (test kit only)

Reference / bias

M1 left mastoid on SRB2 (D25) · bias at Fpz (centre pad of the strip)

Gain, sampling

12 (±375 mV range, D29) · 250 samples/s · 24-bit · noise target < 6 µVpp

Forehead

Single-use 3-pad hydrogel strip, Ag/AgCl (Fp1, Fpz, Fp2), stuck on after the headset is on: centre mark under the front anchor’s pointer, top edge against its tip (v7; the paper nasion template stays in the test kit as the fallback for a pads-first fit); its left end tab carries a small socket; the eye lead plugs in beside the strip, and one short tail cable runs from the socket to the underside of the left pod · one size: pads about 16 mm, 27 mm apart

In hair

Semi-dry pods at Fz and Pz: a one-piece 14.2 mm pod body (8.5 mm tall, fill tube up the middle, Ag/AgCl pin in the cavity) guided in a printed spring carriage by two pins that also show the force · single-use tip cartridge pressed up into each pod, foam 2.5 mm proud, wetted on the day to a set weight (damp, not soaked) · no reservoir: 2 to 4 drops (0.1 to 0.2 ml) of 0.9% saline down the fill tube only when the contact check asks · snap lead clips to a stud on the carriage top, joined to the pod by a soft pigtail

Mastoids, eye

Adhesive gel Ag/AgCl pads (M1, M2) · small hydrogel pad 20 mm below the left eye

Heart

MAX30102 earlobe clip · pulse-rate variability with medication class (D09, D12, D22)

Motion

BMI270 IMU on a breakout inside the left pod, on foam tape in the middle of the board (X29, v7.1)

Main board

Rev B (KiCad), 4-layer, 77 × 50 mm, electrode end forward, in the left pod above the ear; v7: the pod’s outer face is flat, parallel to the board, with JP1 and TP1 left off and the motion sensor lower · v7.1: 3.0 mm clearance rule, face 15.5 mm off the skin at the board centre (v6: 22), chamfered low, high and at the back · pod outer box about 107.0 × 69.1 × 25.7 mm (v7 106.7 × 69.0 × 25.2; v6.3 108.4 × 92.8 × 40.2), about 90 × 51 mm along the skin (v6.3: 97 × 75) · headset 180.4 mm wide (v7 183.1, v6.3 189.1) · fit check of every part on this head, model estimate · analog half copied from Low-Cost-EEG, a built and tested open ADS1299 + ESP32-S3 board (GPL-3.0) · Seeed XIAO ESP32-S3 with USB-C, charger and Bluetooth · flex antenna on the pod’s outer face

Fit

One size for 500–580 mm circumference and 300–390 mm nasion–inion (D19). v7 head ring: one printed strap from a pivot behind the left pod, across the forehead, under both pods (in a tunnel, 2 × M3 each) to a pivot behind the right pod, and the PN521 nape section with the hook and dial pivoting on its ends; chin-strap tabs on the strap for a test-kit chin strap · v4’s midline band lying on the head from a small front anchor to a cam lock above the dial · the band’s zero set from the nasion by a clip-in gauge (three steps, within 1.5 mm of Fpz) · Fz fixed at 69 mm behind the zero (at most 9 mm from its 10-20 site over 300–390 mm, the same spot every visit); Pz at 0.6 × nasion–inion, set by one size number (1–9) from the size tape (size rounding within 3 mm on a bare scalp; hair under the band shifts Pz forward by a few mm) · TPU tail with about 81 mm of travel (free tail 17 mm on a 300 mm head, 98 mm on a 390 mm head: the band’s rigid end is fixed, the lock moves with the head; v6 said about 50 mm), pulled by a tab with stretch marks, spare end folded in half under two sliding keepers (v7.1) · saved per patient: size number, dial reading, lock mark; only the size number changes where the electrodes sit

Pods in hair

Each pod is a plunger in a printed carriage standing on the band’s two rails beside its window, pushed through the window onto the scalp by a compression spring. v7.2: the pod runs in a 14.8 mm bore, 3 mm each way from its 1 N position, stopped by two guide pins in closed slots that point at three force ticks (about 0.6, 1.0 and 1.45 N); the force is checked on a kitchen scale in the frame test. Fz and Pz use the same carriage print; Fz has one notch. Because the band lies on the head, the spring only takes up hair and movement, not head shape (as in Zeto’s cleared headset, C72/C80, and OpenBCI’s spring holders, C71/C77)

Materials

Wipe-clean pods, ring strap, anchor, gauge and carriages (PETG prints for the prototype; PA12 band and PC/ABS shells in the product) · TPU tail with a printed pull tab on the midline band · soft TPU / silicone lining under the ring strap and midline band, the rear hook pad and inside the pods · single-use skin contacts (D32, D34)

Power

1000 mAh LiPo, battery only while worn · about 8–10 h estimated (v4.5: the XIAO ESP32-S3 alone draws about 85 mA with Bluetooth active) · charged through the XIAO’s USB-C, which blocks recording

Session

About 12 min chair time: about 5 min setup (estimate), 5 min recording (EC 2 · EO 1 · EC 2), sitting upright with no headrest behind the head (the rear hook and dial are there), contact checks between blocks (D27, D28)

Output

One-page trend report with personal baseline, change bands, medication class and PHQ-9 on the same timeline (D05)

Regulatory

India: medical device (D23), plan for CDSCO Class B, budget for C · IEC 60601-1, 60601-1-2, 80601-2-26, 62304, ISO 10993

v7.2 (11 Nov 2026): hair pod and carriage rework (one-piece pod with a fill tube, Ag/AgCl pin in the foam, tip cartridge pressed into the pod, guide pins with force ticks, stud on the carriage top). v7.1 (11 Nov 2026): fixes from the review of v7 (pod clearance and chamfers, folded tail, Pz window, walkthrough, flat ring print to test, Fz placement, lead colours, midline module option). v7 (11 Nov 2026, proposed): v6 with one continuous head ring the pods ride on, a pivoting nape section, flat-faced pods 15 mm off the skin, a nasion gauge for the band’s zero, a fixed Fz pod and a pull tab on the tail. v6 stays on the page as the adjustable-Fz alternative. D, K, R and X codes point to decisions and evidence rows in the library. Ring, band, anchor, gauge, lock and pod shapes, part weights and the board layout are model estimates; nothing has been printed or measured.

Every part card says where it comes from. Plan: decisions (D) and evidence IDs from the Neuryo-Research library. Review: the 29 Oct review of v2. From v1: kept from the 26 Oct design doc. Model estimate: a shape or size worked out to make parts fit; measure before building.

New in v4

- Session-based, not continuous (D31). NICE reviews at 2 and 4 weeks; early clinical improvement already has NPV 82–100% but PPV 19–60%, so the day-7 EEG must add to it (D33). NICE NG222 (https://www.nice.org.uk/guidance/ng222/resources/depression-in-adults-treatment-and-management-pdf-66143832307909) · Szegedi 2009 (https://www.psychiatrist.com/jcp/early-improvement-weeks-predictor-treatment-outcome)
- No Cz (D36, v6.3). The session is rest only and every use of Cz in the research library needs a task (P300, P3a). At rest, when single midline electrodes were compared in 168 adults, the depression difference sat at the frontmost site, not Cz. Week-1 central cordance change predicted rTMS outcome in one study of 18; it is a full-array measure this montage cannot claim, and cordance results did not replicate in a third study. Cordance papers: Hunter 2018 (https://searchworks.jioinstitute.edu.in/articles/cmedm__29224411) · Bares 2015 (https://starfos.tacr.cz/vysledky-vyzkumu/RIV%2F00216208%3A11120%2F15%3A43909410) · Bailey 2019 (https://eres.library.adelaide.edu.au/dspace/handle/2440/120632)
- Single-use forehead strip. A cleared home forehead EEG device attaches with a self-adhesive disposable patch at Fp1/Fp2; patients with insomnia or depression self-applied forehead EEG at home. FDA K231546 (https://www.accessdata.fda.gov/cdrh_docs/pdf23/K231546.pdf) · Levendowski 2017 (https://pubmed.ncbi.nlm.nih.gov/28454598/)
- Rigid frame, spring at each pod (D34). Headsets with electrodes in hair hold them with a rigid frame and a spring per electrode: OpenBCI Ultracortex (3D-printable, spring-loaded nodes), Wearable Sensing DSI-24 (spring-loaded arms and pods, about 600 g), Zeto (FDA-cleared semi-rigid, flexible PA12 headset with flexible electrode legs, for outpatient clinics and home). Bitbrain's semi-dry system uses a fabric cap that is washed after every session instead. OpenBCI (https://docs.openbci.com/Deprecated/MarkIII/) · DSI-24 (https://www.medical-xprt.com/products/dry-electrode-eeg-headset-868098) · FDA K260455 (https://fda.innolitics.com/device/K260455) · Bitbrain (https://bci.upatras.gr/training/devices/eeg/bitbrain-versatile/)
- Midline band on the head (v6). Zeto’s FDA-cleared headset holds Fz, Cz and Pz in semi-rigid bands with a spring per electrode and support blocks that carry the headset’s weight; a light strip over the top on a headband was the most comfortable of four systems in Hairston 2014. US 11,166,673 (https://patents.google.com/patent/US11166673B2) · FDA K260455 (https://fda.innolitics.com/device/K260455) · Hairston 2014 (https://doi.org/10.1088/1741-2560/11/4/046018) · Ultracortex Mark IV (https://docs.openbci.com/AddOns/Headwear/MarkIV/)
- Wipe-clean, no fabric (D32, D34). Items on intact skin need low-level disinfection; reusable cloths are often not cleaned well. CDC (https://www.cdc.gov/infection-control/hcp/disinfection-sterilization/rational-approach.html)
- Head-ECG test. ECG reaches head sites (neck and jaw best, forehead worst); mastoids untested, so the earlobe clip stays until Study 1. von Rosenberg 2017 (https://www.commsp.ee.ic.ac.uk/~mandic/WvR_DPM_et_al_Hearables_ECG_RSOS_2017.pdf)
- BMI270 IMU. Current wearable IMU, 685 µA at full rate. Bosch Sensortec (https://www.bosch-sensortec.com/products/motion-sensors/imus/bmi270/)
- Closest competitor. Universal Brain UB ERP: 7 dry channels, about 5 minutes, ERP tasks, now developing treatment-response markers. Universal Brain (https://www.universal-brain.com/)

Why these sites

- Fp1 and Fp2 (D13). A week-1 drop in prefrontal theta predicted antidepressant response, including in an independent Ottawa group (AUC 0.85, n=47). Am J Psychiatry 2006 (https://ajp.psychiatryonline.org/doi/10.1176/ajp.2006.163.8.1426) · Brunovsky 2019 (https://em-consulte.com/article/1299706/article/comparable-efficacy-of-prefrontal-theta-cordance-i) · de la Salle 2020 (https://pmc.ncbi.nlm.nih.gov/articles/PMC10773969/) · Srivastava 2026 meta-analysis (https://journals.sagepub.com/doi/xml/10.1177/02537176241271716)
- Pz for P300 (D08). The FDA-cleared UB ERP system records Fp1, Fp2, F3, F4, Fz, Cz, Pz with a gel EOG. FDA K253767 (https://www.accessdata.fda.gov/cdrh_docs/pdf25/K253767.pdf)
- Eye channel (D26). EOG regression needs a reference channel; ICA can’t run on few channels. Jiang 2019 (https://www.mdpi.com/1424-8220/19/5/987)

Reference and bias

- Mastoid bone (review). The skin around the ear “including the mastoid bone” is described as hair free; adhesive pads fail through hair. Bleichner 2017 (https://www.frontiersin.org/journals/human-neuroscience/articles/10.3389/fnhum.2017.00163/full) · Krishnan 2019 (https://www.andrew.cmu.edu/user/skkelly/Papers/Krishnan_Hydration_BioCAS_2019.pdf)
- No hardware-linked mastoids (D06, D25). Linking ears online bridges the hemispheres; average and REST need far more channels. Yao 2019 (https://link.springer.com/10.1007/s10548-019-00707-x)
- M2 as a heart-artifact reference (judgement). ECG is best seen between the two ears. Anderer 1999 (https://pub.ista.ac.at/~schloegl/publications/Anderer1999a.pdf)

Chip, gain and wiring

- Gain 12 (D29). Input range is ±VREF/gain: ±187.5 mV at 24, ±375 mV at 12; noise 0.16 vs 0.14 µVrms. Electrode offset tolerance is ±300 mV. TI ADS1299 datasheet (https://www.ti.com/lit/ds/symlink/ads1299.pdf) · Xu 2017 (https://repository.tudelft.nl/file/File_0d85ae59-f110-49dd-bb92-282a10ec16e5)
- Reference on SRB2. SRB2 is set per channel (P input); SRB1 ties every N input together, so no channel could run differential. OpenBCI Cyton SDK (https://docs.openbci.com/Cyton/CytonSDK/)
- Battery only, ±2.5 V (judgement). Cyton runs from a battery only and regulates +2.5 V and −2.5 V. OpenBCI Cyton specs (https://docs.openbci.com/Cyton/CytonSpecs/)
- Lead-off between blocks (D27). AC lead-off runs at 7.8 or 31.2 Hz, inside the EEG band. TI ADS1299 datasheet (https://www.ti.com/lit/ds/symlink/ads1299.pdf)

Electrodes

- No dry contact at theta sites (D30). Dry electrodes raised delta and theta against gel and lost more data (10.5% vs 3.9%); high impedance in warm rooms added slow noise. Heijs 2021 (https://pmc.ncbi.nlm.nih.gov/articles/PMC8541549/) · Hinrichs 2020 (https://link.springer.com/10.1038/s41598-020-62154-0) · Kappenman 2010 (https://erpinfo.org/s/Kappenman-2010-Psychophys-Impedance-p398.pdf)
- Paste on the forehead (review). Fp1 to Fpz is 26.9 mm on this head; the budget’s 32 × 25 mm pads would touch. Neo Gel pad size (https://www.tindie.com/products/upsidedownlabs/neo-gel-electrodes-msgst-27x-100pcs-pack/)
- Semi-dry in hair. Under 40 kΩ for 5 h; PVA/PAM 18.2 kΩ on hair. Plain sponges rose in impedance after about 20 min without rewetting (L37); v4.3 records for 5 min, so a pre-wetted tip plus top-up drops on demand replaces the reservoir (D21: a rewetting method is kept). Commercial saline sensors work the same way: wet before use, a few drops through the top when contact drops, no reservoir (C110, C113). Hua 2019 (https://www.mdpi.com/2072-666X/10/8/518) · Li 2024 (https://doaj.org/article/3ff8871db978483683c420e4b16df287) · Emotiv Flex manual (https://emotiv.gitbook.io/flex-2.0-user-manual/flex-wires-and-sensors/flex-saline-sensor-kit) · EGI net manual (https://med.stanford.edu/content/dam/sm/lucasmri/documents/16_0824_EGI_geodesic_sensor_net.pdf)
- Mixing contact types is fine. UB ERP pairs dry EEG with a gel EOG; with a high-impedance amplifier, unequal contacts mainly add mains hum. FDA K253767 (https://www.accessdata.fda.gov/cdrh_docs/pdf25/K253767.pdf) · Ferree 2001 (https://www.eeginfo.com/research/ElectrodeImpedance.pdf)
- Ag/AgCl (D07). Lowest drift and noise. Alves 2026 (https://www.mdpi.com/2079-6412/16/7/781)

Heart sensor and fit

- Earlobe PPG (D22). Earlobe PRV vs ECG HRV r > 0.92 at rest. Vescio 2018 (https://www.mdpi.com/1424-8220/18/3/844) · Mejía-Mejía 2020 (https://www.frontiersin.org/journals/physiology/articles/10.3389/fphys.2020.00779/pdf)
- ECG in the test kit (D09). PPG must be checked against ECG on our own sensor and site before any HRV claim.
- Fitted frame (D19). Re-placement 3.0 mm with a fitted cap vs 9.8 mm with straps. Hunold 2020 (https://link.springer.com/10.1186/s12938-020-00792-1) · Indian adult head circumference 499–578 mm. Shah 2018 (https://proc.3dbody.tech/papers/2018/18114shah.pdf)
- Size range (v4.4). Adult nasion–inion typically 32–38 cm. Campbell 2009 (https://pmc.ncbi.nlm.nih.gov/articles/PMC2824445/) · 80 adult dry skulls 305–356 mm. Rashid 2025 (https://www.ovid.com/jnls/chri/fulltext/10.4103/cjhr.cjhr_11_25~morphometric-localization-of-bregma-in-dry-skull-and-its)
- Mechanics check (v5). Pod forces, hold-down, spine stiffness and fit range: Neuryo headset concept study (7 Nov 2026). Head-surface angles and the pod fit measured on this head model; weights and forces are estimates.
- Main board (v4.5). ADS1299 + ESP32-S3 board built and tested (ECG, EMG, alpha, SSVEP, P300), GPL-3.0. Low-Cost-EEG (https://github.com/XavierAsghar/Low-Cost-EEG) · rebuilt, alpha test. diy-eeg-mac (https://github.com/agteo/diy-eeg-mac)
- Microcontroller (v4.5). XIAO ESP32-S3: 21 × 17.8 mm, LiPo charger, reset and boot buttons, U.FL antenna, about 85 mA with Bluetooth active. Seeed (https://wiki.seeedstudio.com/xiao_esp32s3_getting_started/) · ESP32-S3 has two I²C controllers. Espressif (https://docs.espressif.com/projects/esp-idf/en/v4.4.8/esp32s3/api-reference/peripherals/i2c.html)

Mannequin

- Head, ears, neck. MakeHuman base mesh (CC0), 540 mm head circumference. MakeHuman (https://github.com/makehumancommunity/makehuman)
- M1 and M2 measured on this head by tools/mastoid.py: halfway between ear-canal and earlobe height, 16 mm behind the back edge of the ear so a 25 mm pad clears it.
- Electrode sizes. FRI does not publish TDE-211/212 dimensions; disc, stud and socket sizes are model estimates. Measure the parts and update DIM at the top of the page script.

Still to prove on this hardware

- Contact on Indian hair, oiled and washed, warm and cool rooms: impedance every 15 min for an hour, semi-dry vs paste vs dry spike.
- Forehead strip vs paste; same-day and 1-week retest against the VIT wet cap (theta and alpha at Fp1, Fp2, Fz).
- Earlobe PPG, forehead PPG and the M2 minus M1 head-ECG vs chest ECG on channel 8. No Cz pod (D36). Cz would only come back with an oddball task in the session or if the full-cap subset test shows it adds; either means a reprinted band with a Cz window.
- Setup under 5 minutes; comfort at 0, 30 and 60 minutes. Noise floor with shorted inputs (< 6 µVpp).

Measure: click a pointClearDone

#### How to use this page

- Turn and zoom: drag and scroll. Click any part to see what it is, what to buy, how sure the plan is and where its numbers come from.
- Mode (top left): Product is what a patient wears; Test kit adds the ECG pads, the forehead heart window and the comparison electrodes.
- Fit & finish: slide the head circumference (500–580 mm) and the nasion–inion (300–390 mm) to see the rear dial, the gauge position, the band size number (1–9) that sets Pz and how far the fixed Fz pod sits from its site; compare the silicone pads with the dropped knit idea; pick colours.
- Display: see-through shell, sizes, channel numbers, colour by confidence or by single-use vs reusable.
- Details: Parts, Session (the 12-minute visit), Build (parts, wiring, tests), Changes from v6, Specs, Sources. The nasion gauge and the test-kit chin strap show when you pick them in Parts.
- Guides: the session walkthrough, the electrode pod and the board. Measure gives the distance between two points.
- Copy link shares exactly what you are looking at. Anything marked model estimate: measure before you build.

Keys: 1–5 views · I see-through · E electronics · L labels · S sizes · N channels · C confidence · U single-use · F soft layer · G session · M measure · T test kit · Esc close

Got it

ExitBackNext

← Headset

TipDomeFingers

Cutaway Show underside

BackNext
