aryankalra404/Neuryo-Headset/designs/v7/tryon.html

Neuryo v7 try-onHead ring, midline band and side pods, true to size

v7 3D model

# Try on Neuryo v7

Face the camera and the headset appears on your head, true to size. Turn your head up to about three-quarters; a full side view loses the face.

Start camera The video stays on this device. Face tracking runs in your browser (Google MediaPipe); nothing is uploaded.

Size115%

Up / down1 mm

Forward / back-8 mm

Take photo Show head guide Switch camera Use the head guide to line up the fit, then hide it.
