aryankalra404/Neuryo-Headset/docs/buy-plan/Neuryo-v6-buy-plan.pdf

Neuryo v6 prototype buy plan · 9 Nov 2026 | Page 1

# Neuryo v6 prototype buy plan

9 Nov 2026, updated 10 Nov (v6.2) and 11 Nov (v6.3: no Cz) · for v6 with the rev B board (77 × 50 mm, KiCad) · prices marked 9 Nov were read on the seller page that day; 7 Nov / 8 Nov come from your v4.4 and v5.2 plans; yellow rows are estimates · USD at ₹94.05 mid-market (7 Nov), ₹97.34 on the card

What | When | Total
Domestic orders: Upside Down Labs, Robu, Probots, Vishaworld, Robocraze, Amazon, ToolBuy, chemist | Now | ₹17,186
FRI TDE-211 Ag/AgCl pod cores × 3 (import through VIT) | Now (2–3 weeks by DHL) | ₹6,990
Rev B board × 2 assembled at JLCPCB, Standard PCBA double-sided (import through VIT) | After the professor’s review | ₹32,819
Total, imports through VIT | | | | | ₹56,995
If the VIT lab has PETG, TPU, a 0.01 g scale, a caliper and a breadboard set (−₹4,125) | ₹52,870
If both imports go as personal imports instead (42.08% duty) | ₹68,314

Recommendation. Order the domestic lists and the FRI pods now, and the boards the day your professor signs off. Through VIT this lands at about ₹56,995 (₹52,870 if the lab has the filament, tools and a breadboard set), about ₹2,870 over the ₹50,000 grant. The board is the biggest line and the one that decides the demo, so this plan pays for JLCPCB to place both sides of it rather than you hand-soldering the 17 input filter capacitors on the underside (that option saves about ₹6,341; section 3). Upload the rev B Gerbers, positions and bom-jlc.csv to JLCPCB for the real quote before paying.
v6.3 (11 Nov). No Cz channel in the product or the test kit (decision D36), so there is no Cz pod: FRI pod cores go from 4 to 3 (Fz, Pz and one for the Pz paste fallback), and the snap-cable pack has 2 spares instead of a test-kit Cz lead (same pack, same price). v6.2 (10 Nov): the 2 mm dowel pins are removed (the carriages click into notches). No prices were re-read on 10 or 11 Nov: the totals only drop the fourth FRI core.
Changes from your v4.4 and v5.2 plans. Rev B now exists, so the board is priced from its BOM. Standard PCBA (double-sided) replaces Economic, because rev B has 28 parts on the bottom. No ESP32-S3 DevKitC (the bench XIAO does bench firmware), no Koss headphones (v5 arch only), no BMI270 chips on the board (rev B takes a breakout on J7), no PA12 band (PETG is enough for the demo), no PVA powder or glycerol. One of everything for one headset: 1 cell, 1 charger, 1 MAX30102, 1 BMI270, 1 PN521, 1 snap-cable pack (no ECG pair), 3 FRI pods, and 2 XIAOs (bench + board). Added: a TP4056 charger (the review says to charge the cell outside the headset), JST leads (the only in-stock cell has the wrong plug), the logic analyzer (back in stock) and Ten20 paste as demo insurance. The second JLCPCB board is the assembly minimum: leave it unpopulated until needed.

## 1 · Order now: domestic

## Upside Down Labs

Item | For | Qty | Price | Line Read | Link
UDL colour snap cables, pack of 10 (100 cm, snap one end) | 8 head leads (Fp1, Fp2, Fpz bias, eye, M1, M2, Fz, Pz) + 2 spare; cut the plug end and solder into the board holes | 1 | ₹1,999 | ₹1,999 9 Nov | store.upsidedownlabs.tech/product/differ ent-color-s… (https://store.upsidedownlabs.tech/product/different-color-snap-cables-pack-of-10/)
UDL Neo Gel electrodes, 100 pcs (3.2 × 2.5 cm) | Forehead pads (Fp1, Fpz, Fp2), M1, M2, eye pad, ECG pair | 1 | ₹799 | ₹799 9 Nov | store.upsidedownlabs.tech/product/neo- gel-electrode… (https://store.upsidedownlabs.tech/product/neo-gel-electrodes/)
Upside Down Labs total | Free delivery above ₹999 (store page). | | | ₹2,798

## Robu

Item | For | Qty | Price | Line Read | Link

Seeed Studio XIAO ESP32S3 (plain, not Sense/Plus) 1 for bench firmware now, 1 soldered on the board (rev B footprint is

| the plain XIAO) | 2 | ₹1,139 | ₹2,278 9 Nov | robu.in/product/seeed-studio-xiao…
PETG 1.75 mm, 1 kg (skip if the lab has it) | Pods, midline band (fit tests), carriages, anchor, cam lock, ear clip | 1 | ₹780 | ₹780 7 Nov | robu.in/product/numaker-petg-hs-1…
TPU 95A 1.75 mm, 1 kg (skip if the lab has it) | Midline band tail through the cam lock (v6 needs it); linings can be the silicone sheet | 1 | ₹2,149 | ₹2,149 est
Robu total | XIAO in stock on 9 Nov (Robu search page). Filament: skip if the VIT printer room has it. | | | ₹5,207

## Probots

Item | For | Qty | Price | Line Read | Link
Li-ion 3.7 V 950 mAh YB-503450, protected (50 × 34 × 5 mm) | The headset’s cell; its plug is listed as 3-pin 1.25 mm, so fit the 2 mm JST lead below | 1 | ₹399 | ₹399 9 Nov | probots.co.in/lithium-ion-rechargeable-…
TP4056 1 A charger module, Type-C, with DW01 protection | Rev B review change 3: charge the cell outside the headset | 1 | ₹49 | ₹49 9 Nov | probots.co.in/tp4056-1a-li-ion-lithium-…
GY-MAX30102 pulse sensor | Earlobe clip; check the I²C pull-ups go to 3.3 V | 1 | ₹199 | ₹199 9 Nov | probots.co.in/search/max30102
USB logic analyzer, 24 MHz, 8 ch | Debug the ADS1299 SPI and the USB interlock at bring-up | 1 | ₹449 | ₹449 9 Nov | probots.co.in/search/logic%20analyzer% 2… (https://probots.co.in/search/logic%20analyzer%208%20channel)
Probots shipping | | 1 | ₹99 | ₹99 7 Nov
Probots total | ₹99 flat shipping under ₹4,999 (7 Nov plan). Only in-stock protected cell on 9 Nov. | | | ₹1,195

## Vishaworld

Item | For | Qty | Price | Line Read | Link
7Semi BMI270 Nano IMU (Qwiic) | Rev B: breakout on a 4-wire lead to J7 | 1 | ₹501 | ₹501 9 Nov | vishaworld.com/search (https://vishaworld.com/search?q=bmi270)
Vishaworld total | Shipping shown at checkout. | | | ₹501

## Robocraze

Item | For | Qty | Price | Line Read | Link

2 mm pitch 2-pin JST cable with connector, pack of

10 | Battery leads into J1 (JST-PH 2.0); check polarity against the "+" on the board | 1 | ₹55 | ₹55 9 Nov | robocraze.com/search (https://robocraze.com/search?q=jst+ph+2.0+2+pin)
Robocraze total | Free delivery from ₹999; this order is small, so add it to another Robocraze order or expect a delivery fee. | | | ₹55

## Amazon.in

Item | For | Qty | Price | Line Read | Link
Stainless compression spring assortment | Pod springs, about 1 N at 6 mm; pick on the scale | 1 | ₹300 | ₹300 est
OLEIO M3 × 12 mm screws with nuts | Anchor tongue, band splice, cam lock, pod shells (nuts in printed pockets) | 1 | ₹289 | ₹289 7 Nov | amazon.in/dp/B0HKJ7692J
Silicone rubber sheet 2 mm, 1 × 1 ft | Front band and midline linings, rear hook pad, pod linings | 1 | ₹459 | ₹459 7 Nov | amazon.in/dp/B0D243VWDB
Worison black foam sheets, A4 × 10 | Light-blocking pad on the ear clip | 1 | ₹175 | ₹175 7 Nov | amazon.in/dp/B09G3BDXYL
Araldite Standard 90 g | Seal pod lids, strain relief on soldered leads | 1 | ₹195 | ₹195 7 Nov | amazon.in/dp/B01HS00QX0
Romsons alcohol swabs, 100 | Skin prep | 1 | ₹179 | ₹179 7 Nov | amazon.in/dp/B0G653LQPL
Weaver NuPrep skin prep gel, 114 g | Abrasive skin prep: lowers impedance under the forehead, mastoid and eye gel pads (and the Pz paste fallback); alcohol alone does much less | 1 | ₹1,480 | ₹1,480 9 Nov | amazon.in/s (https://www.amazon.in/s?k=nuprep+skin+prep+gel)
Hypoallergenic medical tape, 2 rolls | Hold leads and pads, strain relief on the ear clip and strip tail | 1 | ₹283 | ₹283 9 Nov | amazon.in/s (https://www.amazon.in/s?k=3m+micropore+surgical+tape+1+inch)
PVA sponge, pack of 2 | Cut into the pods’ foam tips | 1 | ₹239 | ₹239 7 Nov | amazon.in/dp/B0BRGG1LFY
Flat 6-core 28 AWG cable, 5 m | Ear-clip lead (4 wires into J6) and the BMI270 lead (J7) | 1 | ₹140 | ₹140 7 Nov | amazon.in/dp/B084V1TR88
Breadboard, jumper wires, male headers (skip if the lab has it) | Bench firmware on the bench XIAO with the MAX30102 and BMI270 | 1 | ₹508 | ₹508 est
IONIX 150 cm tailor tape | Head circumference, nasion–inion, size tape | 1 | ₹99 | ₹99 7 Nov | amazon.in/dp/B098R1VVWX
Weaver Ten20 paste, 228 g | Demo insurance: paste + a TDE-211 at Pz if the semi-dry pods are not ready for the review. Check seal and expiry | 1 | ₹1,890 | ₹1,890 8 Nov
ATOM pocket scale, 200 g × 0.01 g (skip if the lab has it) | Pod force (1 N ≈ 102 g) and spring picking | 1 | ₹289 | ₹289 7 Nov | amazon.in/dp/B06XMZV7RH
Vinabo digital caliper 150 mm (skip if the lab has it) Print fit, pad and spring sizes | 1 | ₹399 | ₹399 7 Nov | amazon.in/dp/B0BDLX8DWG
Amazon.in total | Delivery depends on the seller. | | | ₹6,924

## ToolBuy

Item | For | Qty | Price | Line Read | Link
Karam PN521 ratchet helmet (harness only) | Cut out the rear dial and both toothed straps (range not published: measure on arrival) | 1 | ₹306 | ₹306 9 Nov | toolbuy.com/tp/karam-isi-marked-shelm … (https://www.toolbuy.com/tp/karam-isi-marked-shelmet-ratchet-type-safety-helmet-with-plastic-cradle-red-pn521)
ToolBuy shipping | | 1 | ₹100 | ₹100 est
ToolBuy total | Dispatch in 2 business days. | | | ₹406

## Chemist

Item | For | Qty | Price | Line Read | Link
0.9% saline + three 1 ml syringes (no needle) | Wetting the pod tips | 1 | ₹60 | ₹60 est
Cotton buds | Apply NuPrep and gel | 1 | ₹40 | ₹40 est
Chemist total | | | | ₹100

## 2 · Imports (route both through VIT purchase)

FRI TDE-211 reusable Ag/AgCl snap electrode | | | | Amount Link

3 × ₹500 (read 9 Nov on FRI’s store): 2 pods (Fz, Pz) + 1 for the Pz paste fallback (v6.3: no Cz pod, D36). No spares: a lost one
means a second DHL shipment

₹1,500 fri-fl-shop.com/products/reusable-snap-ag…

DHL shipping (your 29 Oct cart; FRI shows it only at checkout) | ₹4,400
Duty and clearance through VIT (~10% + ₹500, plan assumption) | ₹1,090
FRI total through VIT (personal import ₹8,883) | | | | ₹6,990

Gate: the professor’s review of rev B. Leave the electrode headers (J10–J19), J6, J7 and the XIAO off the JLCPCB order: you solder the leads and the XIAO (its underside pads need hot air or a hot plate, so borrow the lab’s). J1, JP1 and TP1 are through-hole: solder them yourself too.

Rev B, 2 boards assembled at JLCPCB (Standard PCBA, both sides) | USD Read | Link
4-layer PCB, 1.6 mm, 77 × 50 mm, 5 pcs | | | $10.00 est
Standard PCBA engineering fee, double-sided | $51.12 9 Nov | jlcpcb.com/help/article/pcb-assembly…
Stencil, double-sided assembly | $16.42 9 Nov | jlcpcb.com/help/article/pcb-assembly…
Component loading, about 29 SMT part types × $1.53 | $44.37 est | jlcpcb.com/help/article/pcb-assembly…
SMT joints, about 1,040 × $0.0016 | $1.66 est | jlcpcb.com/help/article/pcb-assembly…
ADS1299IPAGR × 2 at $70.817 (367 in stock) | $141.63 9 Nov | jlcpcb.com/partdetail/TexasInstrumen…
LM27762DSSR × 2, TPS7A2033PDBVR × 2, TPD4E1B06DCKR × 10 | $6.64 7 Nov | jlcpcb.com/parts/componentSearch
0.1 % thin-film resistors, C0G caps, other passives, Q1, SW1 (bom-jlc.csv) | $15.00 est
Shipping to India | | | $15.00 est
Board total $301.84 × ₹97.34 = ₹29,381; through VIT (~10% + ₹500) ₹32,819; personal import ₹42,245 | $301.84

## 3 · Options and what not to buy

Option | Effect

Economic PCBA, top side only, and hand-solder the 28 bottom
parts

About ₹26,478 instead of ₹32,819 (saves about ₹6,341). Not recommended: the 17 underside parts are the input filter capacitors on the noise-critical analog half, and those parts must then be bought separately.

UDL gold cup electrodes, pack of 10 (₹2,999 on 8 Nov) instead of
FRI

Saves about ₹3,991 through VIT. Gold, not Ag/AgCl, so more drift with saline; your semi-dry evidence is for Ag/AgCl. Only if money runs short.

ECG test pair (channel 8) | Needs a second snap-cable pack (₹1,999) for its 2 leads. Left out: the earlobe sensor already gives heart rate; add it after the demo.
Skip Ten20 (₹1,890) | Fine if the semi-dry pods pass the drying test before the review; it is there so the demo can show eyes-closed alpha even if they do not.

Option | Effect
Only if a test fails | EVA foam 7 mm for a small-head insert (only if the PN521 will not close small enough), PVA powder + glycerol for a hydrogel tip (only if the damp foam tips fail the drying test).
Do not buy | ESP32-S3 DevKitC, Koss headphones, BMI270 chips for the board, PA12 bands, heat-set insert kits (M3 nuts in printed pockets), FR4 strip, Philips 13955C pads, OpenBCI parts, BioAmp EXG Pill, drone LiPo packs (unprotected; the in-stock 1000 mAh ones on Robu are these).

## 4 · Checks before paying

- Re-open each link the day you pay; pay if the price is within 15% of this plan. 9 Nov stock: XIAO in stock at Robu (sold out at TNT and Atomlab); every protected 1000 mAh wearable cell at Robu and Probots was out of stock, which is why the 950 mAh YB-503450 is used.
- Battery plug: the YB-503450 page lists a 3-pin 1.25 mm connector; rev B’s J1 is a 2-pin JST-PH 2.0. Cut it off and crimp or solder the 2 mm JST lead, red to the "+" beside J1 pin 2. Check with a meter before plugging in: rev B has no reverse-polarity protection.
- TP4056 charges at a fixed 1 A, about 1 C for this cell: charge on a hard surface, never inside the pod. Charge between sessions (950 mAh lasts hours; a session is about 5 minutes).
- GY-MAX30102: check the I²C pull-ups go to 3.3 V, not 1.8 V, before wiring it to J6.
- JLCPCB: upload the Gerbers, positions.csv and bom-jlc.csv for the real quote; the loading fee basis ("per system") and part count are estimates here. Recheck ADS1299 stock (367 on 9 Nov).
- Ask VIT purchase whether the JLCPCB and FRI orders can go through the institute import route; the ~10% duty is a plan assumption, not a quote.
- PN521: the harness range is not published. Measure it the day it arrives.

## Sources

Opened 9 Nov 2026: seller pages linked in each row (Robu and Probots via their search results), FRI TDE-211, JLCPCB ADS1299IPAGR part page, JLCPCB assembly price (https://jlcpcb.com/help/article/pcb-assembly-price) (Standard double-sided $51.12 setup, $16.42 stencil, $1.53 per component; Economic $8.18, $1.53, $3.07 per extended part). 7 Nov / 8 Nov rows: your v4.4 and v5.2 buy plans. Exchange rate: x-rates, 7 Nov.
