aryankalra404/Neuryo-Headset/pcb/low-cost-eeg/Documentation/Poster.pdf

# Prototyping a

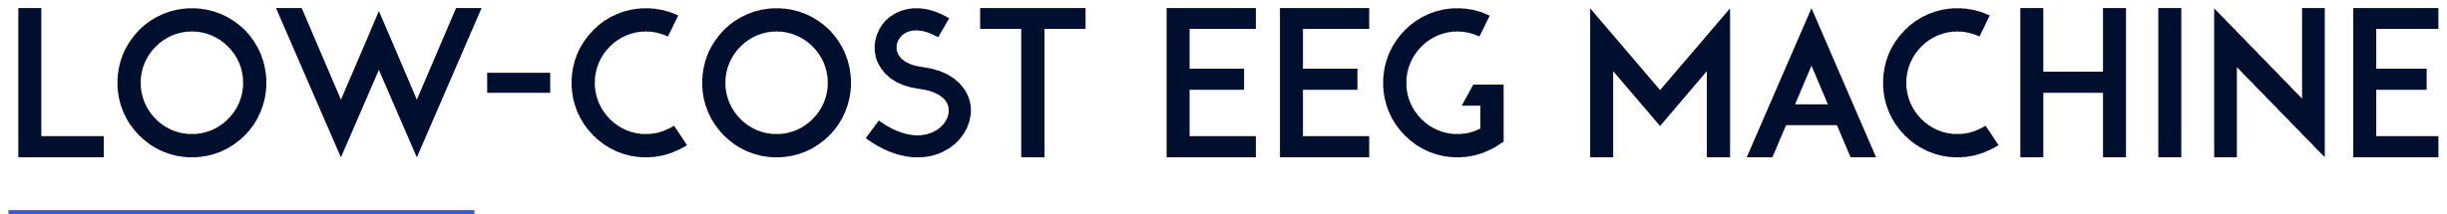
[picture p51: figure]
low - cost EEG machine

## Xavier Asghar – Meng Final Year Project – 2025/26

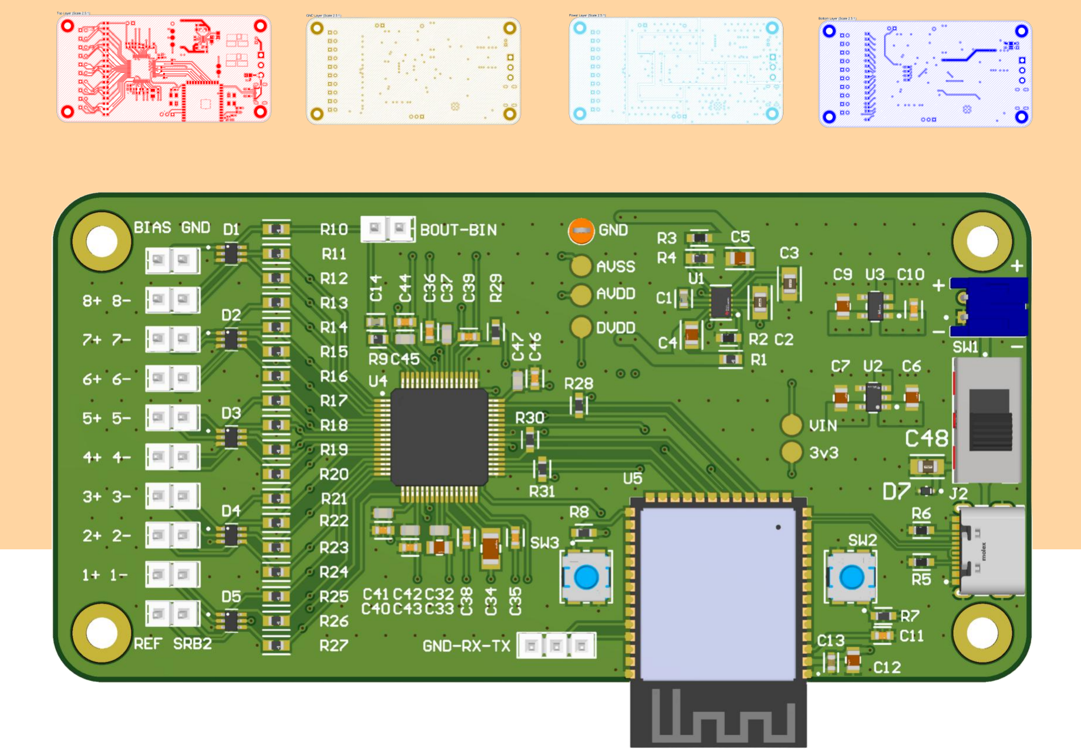
[picture p52: figure]

## The Hardware

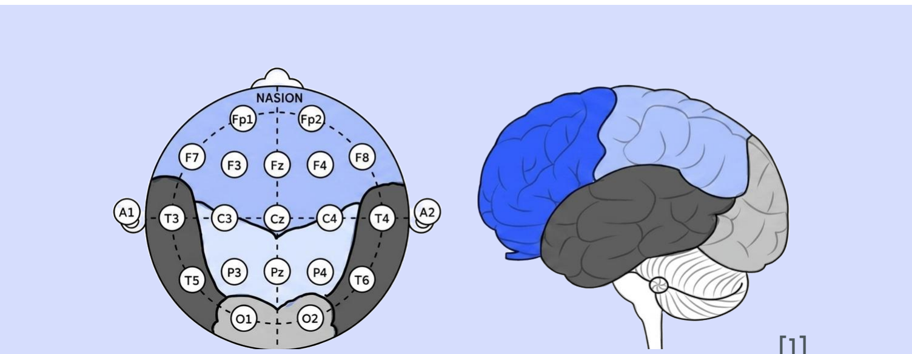
[picture p53: figure]

- Up to 8-channels of electrodes can be connected to the input pin headers
- Texas Instruments ADS1299 EEG Analogue Front-End amplifies and digitises the EEG signal at up to 500 SPS
- The ESP32-S3 then reads the EEG data, and transmits it to a a host computer using Bluetooth Low Energy
- A python script on the host computer unpacks the EEG data, and pushes it to the Lab-Streaming-Layer, for visualisation and recording
- The module is battery powered to ensure patient safety via electrical isolation
- The built in driven right leg helps to cancel common-mode noise

## Introduction

- Electroencephalography (EEG) is a non-invasive method of recording electrical activity in the brain
- EEG has many developing applications, particularly involving brain-computer interfaces (BCIs)
- However, commercial EEG headsets are prohibitively expensive, costing approximately £1000, while clinical EEG machines cost even more
- This project aims to lower the cost of EEG technology, such that it can be utilised in an educational environment, for instance in student research projects, or coursework activites.

# What it Detects

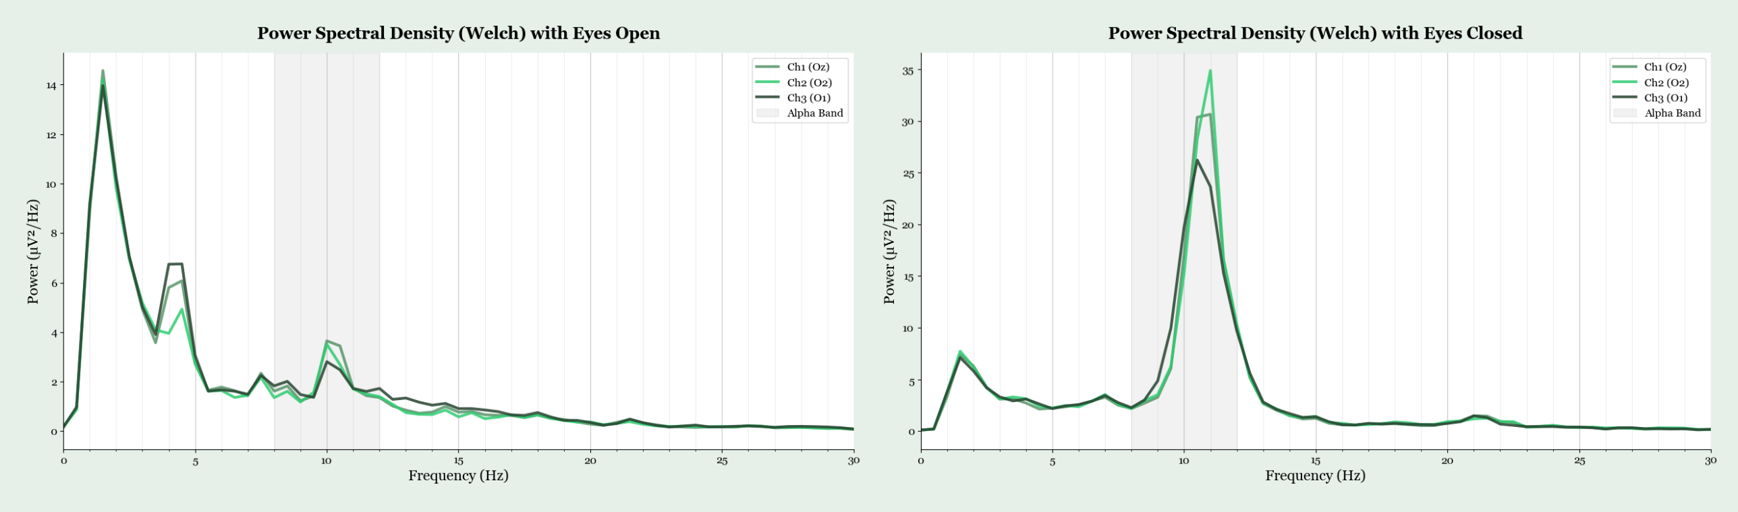
[picture p54: figure]
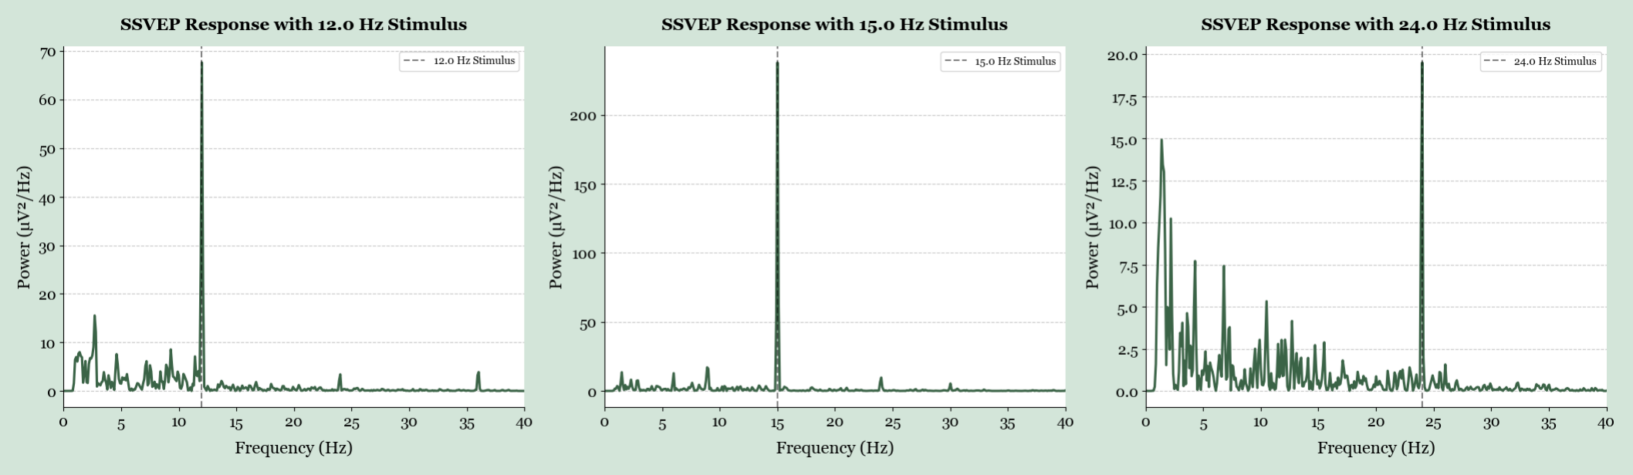
[picture p55: figure]

# Conclusions

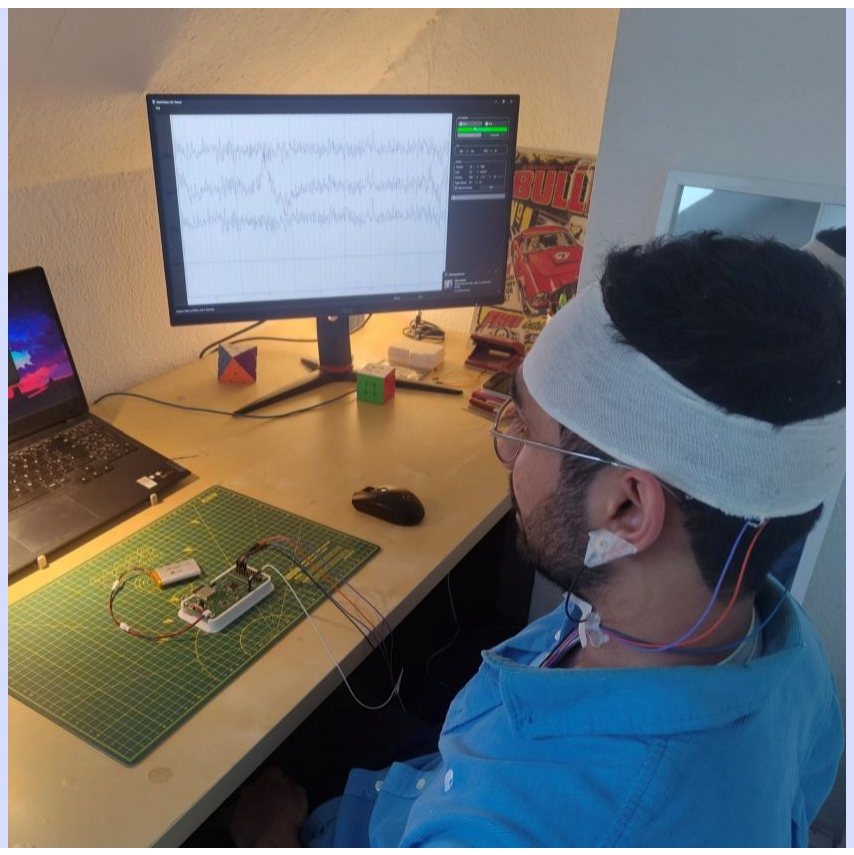
[picture p56: figure]

- The proposed system has been proven to accurately measure EEG features commonly used in BCIs
- The module has a minimum component cost of just £68
- This represents an almost order of magnitude reduction compared to commercial EEG systems, like the OpenBCI Cyton module (£940), or the Emotiv EPOC X headset (£885)
- With this board it would now be feasible to use EEG technology in a final year project, or give to students as part of a coursework task
Alpha Waves • Alpha waves are 8 – 12 Hz oscillations, recorded from the occipital region of the cortex, from an awake subject with their eyes closed. • They are thought to represent the functional inhibition of the brain [66] | P300 Wave • The P300 is a positive deflection occurring approximately 300 ms after a subject detects an informative, task relevant stimulus [38] • The exact origins of the P300 are not yet fully understood.

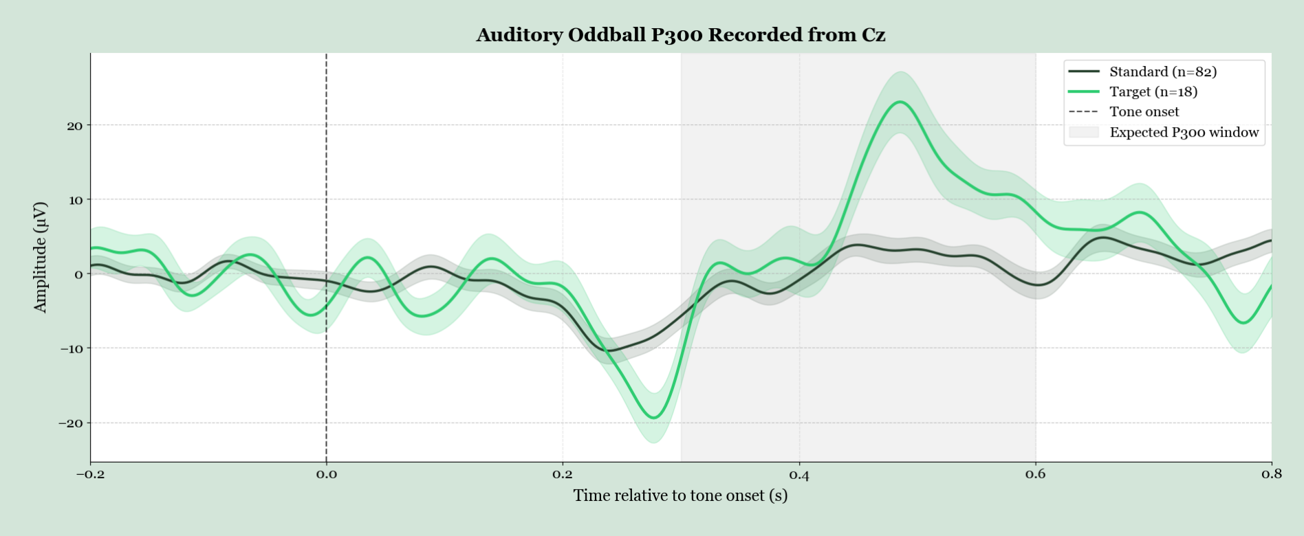
[picture p57: figure]

Steady State Visually Evoked Potentials (SSVEPS) • SSVEPs are evoked responses induced by flickering stimuli, appearing as an increase in amplitude at the frequency of the stimulus [70] • SSVEPs are often used for BCI applications, e.g. BCI spellers | Concealed Information Protocol • The P300 can be used as a forensic tool for memory detection [78] • The subject chose a secret colour (green), and had to count a target colour (yellow). The response to different colour flashes has been recorded:

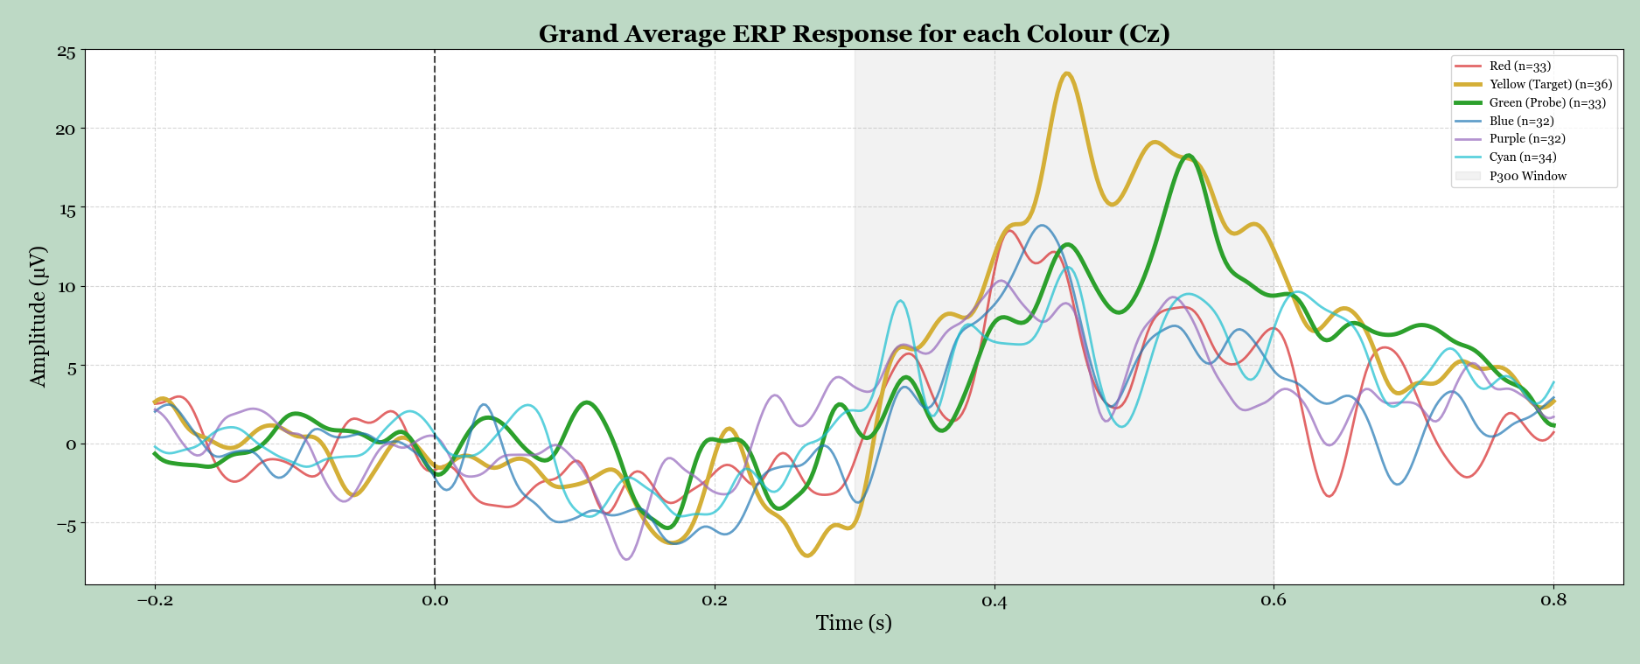
[picture p58: figure]

[1] ‘TMSi — an Artinis company — What Is the 10-20 System for EEG?’, TMSi — an Artinis company. Accessed: Apr. 17, 2026. [Online]. Available: https://www.tmsi.artinis.com/blog/the-10-20-system-for-eeg
[66] W. Klimesch, ‘Alpha-band oscillations, attention, and controlled access to stored information’, Trends Cogn. Sci., vol. 16, no. 12, pp. 606–617, Dec. 2012, doi: 10.1016/j.tics.2012.10.007.
[70] F.-B. Vialatte, M. Maurice, J. Dauwels, and A. Cichocki, ‘Steady-state visually evoked potentials: Focus on essential paradigms and future perspectives’, Prog. Neurobiol., vol. 90, no. 4, pp. 418–438, Apr. 2010, doi: 10.1016/j.pneurobio.2009.11.005.
[38] T. W. Picton, ‘The P300 wave of the human event-related potential’, J. Clin. Neurophysiol. Off. Publ. Am. Electroencephalogr. Soc., vol. 9, no. 4, pp. 456–479, Oct. 1992, doi: 10.1097/00004691-199210000-00002.
[78] L. A. Farwell and E. Donchin, ‘The truth will out: interrogative polygraphy (“lie detection”) with event-related brain potentials’, Psychophysiology, vol. 28, no. 5, pp. 531–547, Sep. 1991, doi: 10.1111/j.1469-8986.1991.tb01990.x.

[1]

Supervisor :
Dr Nic Zhang
