aryankalra404/Neuryo-Headset/docs/v6.md

# v6 · head ring + v4 midline (8 Nov 2026; v6.2, 10 Nov; v6.3, 11 Nov)

Live: https://aryankalra404.github.io/Neuryo-Headset/designs/v6/

**What it is:** v4's midline band and spring carriages on a lighter frame. Electronics are unchanged from v4.5 / v5. The headset has 6 channels on the head (Fp1, Fp2, Fz, Pz, M2, eye; M1 reference, Fpz bias). Since v6.3 there is no Cz channel in the product or the test kit (decision D36 in Neuryo-Research), and the band has no Cz window. See [v6.3](#v63-11-nov-no-cz-two-window-band).

| Part | v6 |
|---|---|
| Head ring | Printed front band (14 × 3 mm, silicone-lined) from pod to pod across the forehead, about 13 mm above the strip; a rear band from pod to pod under the occiput with a hook pad and a dial (rear section cut from a Karam PN521 harness). The rear band is a U: a nearly level section about 60 mm wide under the occiput, where the dial's two toothed straps overlap on one smooth curve, then arms rising to the lower back corner of each pod. (v5's V met at an angle at the dial; a ratchet's straps must run parallel through its gear, so it would jam.) |
| Midline band | v4.4: 30 × 1.8 mm, printed already in the head's midline curve, lying on a 1.2 mm lining. Two real windows (16 mm wide; Fz 32, Pz 64 mm long) with 7 mm rails, 3 mm thick beside the windows (v6.2); solid 1.8 mm for about 90 mm between them (v6.3, no Cz window). Size notches on the right rail's outer edge (Fz 5, Pz 9), numbers on the left rail. TPU tail spliced behind Pz (2 × M3). |
| Front anchor | About 34 × 34 × 7.5 mm (model estimate): a saddle on the front band and a tongue on the band's front end (2 × M3). Its notch goes on the strip's centre mark, so the band's 0 mm mark is over Fpz on every fit. Replaces v4's brow module (about 140 × 65 mm, 29.5 mm off the skin). |
| Cam lock | On a bracket above the rear dial: jaw, two posts and a lever on a pin. The tail runs through it; the mark is saved per patient. |
| Carriages | One print each. v6.2: its two feet wrap the rails (over the top, down the outer edge, a lip underneath), so it slides along the window but cannot lift off; a printed latch in the right shoe clicks into the size notch and a mark on the left shoe points at the size number. A top-up port on top and a slot in the wall for the snap lead (as tall as the pod's travel). Two on the product headset (Fz, Pz). Spring about 6 mm of travel, start at about 1 N, printed shims for 0.5 to 3 N. |
| Positions | Fz and Pz at 0.2 and 0.6 × nasion–inion from Fpz, set by one size number (1–9) from the size tape (v6.3 table: size 1 is 300–309 mm … size 9 is 380–390 mm). Worst case 300–390 mm on a bare scalp: Fz 2, Pz 3 mm, under a fitted cap's 3 mm re-placement error (P186). Hair under the band and band lift on large heads add a forward shift at Pz (estimates in v6.2 and v6.3 below). |
| Electronics | Rev B board (77 × 50 mm, placed from the KiCad file) in a pod above the left ear, electrode end forward; battery in a matching pod above the right (v5). Pods about 98 × 77 mm and 22 mm off the skin (v6.1). |
| Leads | Midline leads about 3 mm outboard of the band's left edge (v6.2: in clips on the solid sections, so the shoes slide past them; v6.3: two clips on the long section between the Fz and Pz windows), past the anchor and along the front band into the front of the left pod. M2 and battery along the rear band; M2 and the right ECG lead run forward inside the pod under the board's lower edge, the battery plugs into J1 at the board's back edge. Each lead ends on its rev B pad (v6.1). |

## Why (changes from v4 and v5)
- **Midline on the head, not over it.** A band lying on the head sets each pod's height from the scalp, so the spring only takes up hair. v5's rigid spine stood 29 mm off the head; the gap changed with head shape, which forced a long spring, wedge-cut carriages and an offset arch. Same principle as Zeto's FDA-cleared headset (semi-rigid bands with fixed Fz, Cz, Pz and a spring per electrode: Neuryo-Research C72, C80) and OpenBCI's spring holders (C71, C77). A light strip over the top on a headband was the most comfortable layout in Hairston 2014 (C82).
- **Small front anchor instead of the brow module.** The board is now above the left ear, so the front only has to hold the band's end and set its 0 mm mark over Fpz.
- **Head ring instead of the arch.** A band that lies on the head has to be held at both ends; the arch could not hold its front end. The front band and anchor do.
- **Cam lock above the dial.** v4 clamped the tail on the battery pod at the back; the battery is now above the right ear.

## Checks
- Model: windows and lining are real openings and the lead leaves each carriage through a slot. A collision check of the frame, band, anchor, carriages, pods and leads on the page (8 Nov) found no parts passing through each other; the only overlaps left are leads plugging into their snap heads and the pods.
- Not yet measured: the harness range (PN521), the front band's fit on small and large foreheads, the anchor size, spring force (kitchen scale). Patent: Zeto US 11,166,673 is probably still in force; check its claims before a product.

## v6.1 (9 Nov): the real rev B board
The board in the model is now rev B as laid out in KiCad (`pcb/neuryo-rev-b`), not the 70 × 50 mm placeholder carried from v1.

| What | v6.1 | Why |
|---|---|---|
| Board | 77 × 50 mm. Copper, pads and silkscreen textures (`designs/v6/revb-top.jpg`, `revb-bottom.jpg`) drawn from `Neuryo_RevB.kicad_pcb`; all 90 other parts at their KiCad positions, the 28 bottom-side parts underneath | The model showed connectors rev B does not have (J2, J3, J5, an on-board IMU) |
| Orientation | Electrode end (input header holes) forward, XIAO, battery connector and switch at the back | Forehead and midline leads arrive from the front; battery from the rear band |
| Part heights | ADS1299 1.2 mm (TQFP-64), J1 4.8 mm (JST part data), JP1 header with shunt about 9 mm (posts 8.4 mm, pcb/README), 0805 1.25 mm, 1206 1.6 mm. Model estimates: XIAO with USB-C 4.2 mm, switch 1.5 mm, GND test loop 5 mm | Fit check below |
| Pods | About 98 × 77 mm (97 × 75 along the skin), 22 mm off the skin at the centre; flatter top and steeper sides. Was about 83 × 72 × 20.5 mm. Same shell for the battery pod | With a 2 mm wall and 0.5 mm air, every part clears by at least 0.9 mm (fit check of every part on this head; ray check on the page: at least 2.7 mm to the shell's outer surface). The flat board's ends sit about 9 mm further from the skin than its centre, which sets the depth. Standing the board upright was worse (the XIAO misses by 3.3 mm) |
| Head ring | Front band and rear band now end at the pods' real edges (from the shell size, not fixed angles) | The pods grew |
| Leads | Each lead ends on its rev B pad: channels on the − hole of their header, M1 on REF, Fpz bias on BIAS, ECG on 8+ and 8−, earlobe clip in J6, battery plug in J1 | Rev B channel map (pcb/README) |
| Motion sensor | BMI270 breakout on a 4-wire lead to J7, fixed inside the pod cover (spot: model estimate) | Rev B has J7 for a breakout, no IMU on the board |
| Board guide | Rewritten for rev B: real connectors, parts, power path and USB interlock | |

Checks (9 Nov, headless render of the page): no page errors in any view, mode or guide; collision check (`tools/collide.js`) with every lead and the test kit shown finds no lead passing through the board; the remaining hits are the same kinds as before (leads ending in their pods and snap heads, the head ring entering the pods) plus the bottom-side parts touching the board's underside (0.02 mm clear, confirmed in board coordinates).

Still model estimates: pod shape and wall, the XIAO stack height, the motion-sensor breakout's size and spot, the battery pouch size (the Witty Fox listing gives no dimensions).

## Try-on (9 Nov)
`designs/v6/tryon.html`: webcam try-on (Google MediaPipe face tracking, in the browser). The headset is `designs/v6/neuryo-v6.glb`, exported from this page with `tools/export_glb.js` (board and battery left out: they sit inside the pods); the shared head is the hidden occluder. Alignment: the head's nasion is placed on MediaPipe's canonical nasion (landmark 168), scaled 1.08 (canonical face vs this head: 1.05 at the eyes, 1.11 at the ears); the Size, Up/down and Forward/back sliders fine-tune it. Defaults (9 Nov) are the fit checked on a real face: Size 115 % (range 85–145 %), Up +1 mm, Forward −8 mm; each viewer's own setting is remembered in their browser.

## v6.2 (10 Nov): fixes from the design review
A review of v6.1 against the Neuryo-Research library (10 Nov). Only the points that are clear problems with a clear fix are changed here. Nothing is printed yet, so sizes are still model estimates. Board changes from the same review are not made yet (listed at the end).

| What | v6.1 | v6.2 | Why |
|---|---|---|---|
| Carriage hold-down | Stood on the rails with a loose 2 mm pin in a size hole | Shoes that wrap the rails: over the top, down the outer edge, a 0.7 mm lip underneath. A printed latch in the right shoe clicks into a notch on the rail's outer edge | The spring pushes the pod down and the carriage up with the same 1–3 N. A pin in a hole stops sliding, not lifting, so the carriage would come off the band. No loose pin to drop in a clinic |
| Rails beside the windows | 7 × 1.8 mm | 7 × 3 mm | Two 1.8 mm rails beside a 64 mm window are the band's weakest point and bridge badly when the band is printed on its edge; the shoes also need an edge to grip. The band is still 1.8 mm everywhere else, so it still follows the head |
| Lining under the rails | 6 mm wide | 3.6 mm, on the window side | Leaves room for the shoe's lip under the rail's outer edge |
| Size marks | Holes in the middle of the right rail; numbers under the carriage's left foot | Notches on the right rail's outer edge; each number 6.5 mm in front of its position, so it shows at the pointer mark on the left shoe's front edge | The number was hidden under the carriage once it was set |
| Leads from the pods | On the band's left edge | 3 mm outboard of the edge, over the left shoe, in clips on the solid sections | The left shoe now slides along that edge |
| Cz pod | Third hair pod, channel 7 | Test kit only. Product headset: Fz and Pz. The band keeps the Cz window and notches, channel 7 stays free on the board | See below |
| Fitting step | Pin each carriage, then fit | Slide to the size number until it clicks; after the tail is locked, slide each carriage one click forward and back | The slide works the tip through the hair, as twisting does on an Ultracortex node (C71) |
| Try-on model | v6.1 | `neuryo-v6.glb` exported again from the v6.2 page with `tools/export_glb.js` | |
| Lead clips (drawn) | Not drawn | Two printed clips on the band's left edge, on the solid sections between the windows: an arm under the leads, an outer wall and a roof; the leads press in through a 2 mm gap beside the band | The section in front of the Fz window is too short for one; the leads go straight on to the anchor there. Sizes are model estimates |
| Dial reading (drawn) | Numbers on the knob | Plain knob; a paper mm scale on the left toothed strap, read at a red index line at the housing edge | The PN521 knob has no numbers. Scale length and place are model estimates |
| Forehead pads, first build (drawn) | Not drawn | Test kit, Forehead option "Gel pads": three Neo Gel pads with about 2 mm of foam trimmed off each long side (25 to 21 mm); the gel is not cut | Untrimmed pads leave about 2 mm between them at 27 mm centres. The trim width is a model estimate |

**Why Cz moved to the test kit (v6.2; superseded by v6.3, which drops Cz altogether).** Its two reasons do not apply to the session as planned: the P300 evidence (M10, C03) needs a task and the 5-minute session is rest only, and central cordance (K102, n=18) cannot be claimed from a 6 to 8 channel montage (D18). The 19+ channel wet-cap study answers whether Cz adds anything, and it does that without a Cz pod on the headset. Dropping it removes one contact that has to pass before a session counts (D11) and one pod to build. v6.2 kept the Cz window so the pod could go back in. v6.3 removes the window too (D36): Cz returns only if an oddball task is added to the session or the subset test shows it adds, and either way that means a reprinted band.

**Kept as it was: two side pods of the same size.** The review suggested moving the battery into the left pod. That was wrong on balance: the board and the cell weigh about the same, so one each side balances the headset, and matching shells look right. Keep both. Twist the battery's two wires together along the rear band, since they carry the radio's current pulses next to the M2 lead.

**Checks (10 Nov, headless render).** No page errors in Product or Test kit mode. `tools/collide.js`: no new overlaps apart from each shoe meeting its own foot (one print) and the thicker rails meeting the band they are part of. Second pass the same day: the session walkthrough (9 steps), pod guide (6 steps, three tips) and board guide (8 steps) were stepped through with no page errors; their text now says two hair pods (two tip cartridges, no Cz highlight). The clips, strap scale and trimmed pads add no overlaps with the leads, band or head ring. The re-exported model loads in `tryon.html` and shows Fz and Pz only (checked with a set head pose, not a live camera).

**Added to the frame test (not model changes).**
- **Hair under the band (estimate).** The band's marks are scalp distances, but the band rides on the hair. A hair mat h thick over the roughly 1.8 rad from the hairline to Pz puts the Pz pod about 1.8 × h forward of the site: 4–7 mm for 2–4 mm of hair, about 1 mm at Fz. It repeats for the same patient unless the hair changes. Tape-check Fz and Pz (30% and 70% of nasion to inion) on short and thick hair. If Pz is off by more than 5 mm, zero the band at the vertex instead of Fpz, which halves the distance the error builds over.
- **Carriages:** none jumps its notch while nodding; the latch can be worked with one hand; the shoes slide on a PETG rail without binding (print the shoe gap at 0.3, 0.4 and 0.5 mm and keep the one that slides).
- **Dial reading:** the PN521 knob has no numbers. Stick a paper scale on the toothed strap and read it at the housing edge, or the saved setting cannot be repeated.
- **Forehead pads:** the 32 × 25 mm gel pads at 27 mm centres leave about 2 mm between them with the 25 mm side across. Trim the foam borders so the gels cannot touch.

**From the same review, for the board (not changed yet):** input capacitors 1 nF down to 100–220 pF (a 30 kΩ pod against a 5 kΩ reference pad limits 50 Hz rejection to about 42 dB with 1 nF); 51 kΩ input resistors on any board a patient wears; 100 Ω in series on SCLK, MOSI and CS; gain 12 in the firmware; the ear sensor at 100 samples a second with its supply pair twisted.

## v6.3 (11 Nov): no Cz, two-window band
Decision D36 (Neuryo-Research, 11 Nov): no Cz channel in the product or the test kit, and the band needs no Cz window. Reasons: the session is rest only and every use of Cz in the library needs a task; at rest, the depression difference among single midline electrodes was at the frontmost site, not Cz (P202); each hair pod is one more contact that must pass before a session counts (D11). Channel 7 stays free on the board; the board is not changed.

| What | v6.2 | v6.3 | Why |
|---|---|---|---|
| Cz | Test-kit pod in the band's Cz window, its own carriage, spring, lead and label; channel 7 | Removed everywhere: pod, carriage, spring, lead, label, parts list, guides, Build and Changes tabs. Channel 7 free | D36 |
| Band windows | Fz, Cz, Pz | Fz and Pz only. The band is solid 1.8 mm from the Fz window to the Pz window, about 90 mm | Nothing to hold at Cz |
| Long solid section | (two short solid sections, 29 and 13 mm) | Kept at 1.8 mm, no rib | Model check below: it bends about half as stiffly as the 7 × 3 mm rail pairs, so it follows the head; a 2.2 mm section helped a little at 6–10 N of tail tension but tripled the lift at Fz at 4 N |
| Lead clips | One between the Fz and Cz windows, one between Cz and Pz | Two on the long section: 15 mm behind the Fz window and 8 mm in front of the Pz window | About where v6.2's two were, so the Pz lead's longest free run stays about 68 mm (one clip in the middle would leave about 100 mm). Still none in front of the Fz window (too short) |
| Size table | Sizes centred 304–384 mm; a 390 mm head fell 6 mm from size 9 (Pz 3.6 mm off) | Centred 305–385 mm: size 1 is 300–309 … size 9 is 380–390 | Fz within 2 and Pz within 3 mm on a bare scalp at every NI from 300 to 390 (the page's fit readout uses the new table) |
| Buy plan | 4 FRI pod cores; snap-cable pack with a test-kit Cz lead | 3 FRI cores (Fz, Pz, Pz paste fallback); the pack's 10th lead is a second spare | Through VIT ₹56,995 (was ₹57,545); ₹52,870 if the lab has filament and tools. Prices not re-read since 9 Nov |

**Band check (model estimate, `tools/band_fit.py`).** A sagittal beam model on the shared head scaled to nasion–inion 300–390 mm and front-back vs height ×0.92–1.08: band printed in this head's curve (324 mm), clamped at the front anchor, pulled by the tail, lying on a soft foundation (lining and hair), pushed off at each carriage by its pod spring. Every input is assumed, not measured: PETG E about 2.0 GPa (PA12 about 1.7), tail tension 4–10 N, pod spring 1–3 N, foundation stiffness. Results (largest values over all heads):

| Tail / spring | Lift at the Pz carriage, v6.2 → v6.3 | Lift at Fz | Worst Pz error incl. size rounding, v6.2 → v6.3 |
|---|---|---|---|
| 4 N / 1 N | 1.9 → 1.9 mm | 0.1 → 0.2 mm | 5.1 → 4.4 mm |
| 4 N / 3 N | 2.8 → 2.6 mm | 0.5 → 0.4 mm | 6.4 → 4.9 mm |
| 6 N / 1 N | 1.2 → 1.4 mm | 0.1 → 0.2 mm | 4.4 → 4.0 mm |
| 6 N / 3 N | 1.7 → 1.9 mm | 0.2 → 0.3 mm | 4.9 → 4.3 mm |
| 10 N / 3 N | 0.8 → 1.1 mm | 0.1 → 0.2 mm | 4.0 → 3.7 mm |

- Removing the Cz window changes lift at the carriages by 0.3 mm or less in either direction. Fz stays within 2 mm in every case.
- The lift is at Pz on the largest heads (370–390 mm), and it is there in v6.2 too. It comes from the band being printed in a 324 mm head's curve and from the rear end of the band, not from the Cz change. Lift makes the Pz pod land forward, which adds to the hair shift (v6.2 estimate). On a bare scalp, rounding alone keeps Pz within 3 mm; with modelled lift the worst case is 3.7–4.9 mm.
- The model's best lever was printing the band in a mid-range head's curve: printed for a 345 mm head, Pz lift on the largest heads fell to 1.2–1.3 mm at 6 N / 3 N and the worst Pz error to 3.8 mm. Not changed here: it is a design call for the frame test (Neuryo-Research, Still open, 11 Nov).
- Peak bending stress in the band when fitted to the largest or smallest heads: about 7–10 MPa (sustained while worn). Creep of a pre-curved PETG band at that stress is not known (README gap).
- Not modelled: twist, side-to-side curvature, friction, the tail's rise into the cam lock, creep, print anisotropy.

**Checks (11 Nov, headless render).**
- No page errors in Product or Test kit mode. The session walkthrough (9 steps), pod guide and board guide were stepped through with no errors; none shows Cz except the board guide's note that channel 7 is left empty.
- `tools/collide.js` (test kit on): every Cz overlap from v6.2 is gone; no new overlap. The one new report, the lining strips beside the Pz window "inside" the long solid band piece, was checked: the lining stops at 1.2 mm off the scalp where the band starts, so they touch by design (the ray test misreads the long open sweep).
- Open (found in the v7 review, 11 Nov; not changed here): at size 1 the Pz pod's tip collar touches the front end of its window by about 1 mm. v7.1 moves that end 2 mm forward (`docs/v7.md`).
- Carriages moved to their size 1 and size 9 notches: no carriage touches a lead clip (at least 7.9 mm clear); the size number shows just in front of the pointer mark on both carriages at sizes 1, 5 and 9. Top and side views of the band at both sizes looked right (leads in those views are drawn for this head's size, so they do not follow the moved carriages).
- `neuryo-v6.glb` re-exported (214 meshes, was 244: the Cz window's rails, notches and numbers are gone); it loads in `tryon.html` with no errors (checked with a set head pose, not a live camera).
- Not tested on a real print: every size, force and lift above is a model estimate.
