aryankalra404/Neuryo-Headset/docs/v4.md

# v4 · 7 Nov product design

**Status:** current plan. Replaces v3.

**Open it:** [designs/v4/](https://aryankalra404.github.io/Neuryo-Headset/designs/v4/). A **View in AR** button appears on headsets that support WebXR (carried over from v3, not yet tested on the Quest). Try-on is v1 only.

**Source:** the "Neuryo v4 product specification" doc (7 Nov 2026) and the Neuryo-Research library (`00-product-v4.md`, decisions D31 to D34, `07-mechanical/frame-and-fit.md`).

**v4.1 frame update (7 Nov 2026):** the soft midline strap, S/M/L frames and knit cover were replaced by a buildable frame: a bought hard-hat ratchet halo, a rigid 3D-printed spine with spring-loaded pod carriages, and a wipe-clean silicone lining (D34). Everything on the frame can be bought online or 3D-printed.

**v4.2 fit update (7 Nov 2026):** the rigid spine is replaced by a flexible midline band that lies on the head, the forehead strip is placed by a nasion template instead of by the frame, and the fit range is 500 to 580 mm to match D19. Why: see [Fit across heads](#fit-across-heads-v42) below.

**v4.3 clinic update (7 Nov 2026):** pods are set by one size number (1 to 5) instead of mm readings, the hair pods use a pre-wetted single-use tip cartridge with a 2 mm top-up hole instead of a 1 ml reservoir, and the contact check tells staff which pod needs drops. The pod is three printed parts (carriage, sealed pod body, tip cartridge) with its cable along the band edge; the ear clip is a printable design; and the test-kit forehead heart sensor moves to its own I²C bus. See [Pods and wetting](#pods-and-wetting-v43-v44) and [Ear clip](#ear-clip-and-heart-sensor-wiring-v43). Codes like D31 are decisions in `00-decisions.md`; codes like K102, C69, R18 or X29 are evidence rows in `evidence-log.csv`.

**v4.4 review update (7 Nov 2026):** four problems found in an outside check of v4.3, and their fixes. See [What changed in v4.4](#what-changed-in-v44-and-why).
1. **Size range too small.** v4.3 assumed nasion–inion 300–348 mm, this mannequin's ratio (0.60 × circumference). Living adults are typically 320–380 mm (P200) and bare skulls alone span 305–356 mm (P201). Now nine sizes cover 300–390 mm, and the page takes nasion–inion as its own measurement.
2. **FR4 band could not be made at its length.** JLCPCB makes 0.6 mm boards only up to 100 × 100 mm and 0.8–1.0 mm only up to 300 × 300 mm (C74). Now the pod section of the band is 3D-printed already in the head's curve and spliced behind Pz to a TPU tail.
3. **Halo range unknown.** Karam publishes no size range for the PN521 (C75). The plan now assumes it closes only to 54 cm, like 3M's suspension, and adds a 7 mm small-head insert next to the 3 mm lining.
4. **Spring squeezes saline out of the tip.** Tips now stick out 2–3 mm instead of 4–6, are wetted to a set weight, start at about 1 N, and a PVA hydrogel tip is added to the drying test.
5. **Session rule:** sit upright with no headrest behind the head. The battery stays at the back, where it balances the brow module.

**v4.5 board update (7 Nov 2026):** the main board copies the analog half of [Low-Cost-EEG](https://github.com/XavierAsghar/Low-Cost-EEG), a built and tested open ADS1299 + ESP32-S3 board, and uses a **Seeed XIAO ESP32-S3** for the rest: about 70 × 50 mm, still in the brow module, which grows to about 140 × 65 mm and 29.5 mm off the skin. Rev A is removed from [pcb/](../pcb/README.md). The v5 side-box trial is dropped. Why: see [Main board](#main-board-v45).

## What the product is
A 5-minute brain and heart recording taken in clinic at baseline, day 7 and every follow-up visit of a depression treatment course. It tracks change in the same patient against their own baseline and shows it next to PHQ-9 and the medication class. It is a monitoring aid, not a diagnosis (D01, D31). First customers: hospital psychiatry departments and rTMS clinics.

Why sessions and not continuous wear (D31): the early-change evidence is all session-based; clinicians do not want streams of passive data; and head-worn devices lose adherence fast when worn at home.

## Spec
| | |
|---|---|
| On the head | 7 channels · Fp1, Fp2, Fz, Cz, Pz, M2, eye (VEOG) |
| EEG chip | ADS1299, 8 channels · ch 7 Cz · ch 8 ECG (test kit only) |
| Reference / bias | M1 left mastoid on SRB2 (D25) · bias at Fpz, the centre pad of the strip |
| Gain, sampling | 12 (±375 mV range, D29) · 250 samples/s · 24-bit · noise target under 6 µVpp |
| Forehead | Single-use 3-pad hydrogel Ag/AgCl strip (Fp1, Fpz, Fp2), placed on the skin with a nasion template (centre pad at 10% of nasion to inion) and plugged into the brow module by a 3-way tail. One size: pads about 16 mm, centres 27 mm apart. Prototype: three 22 × 22 mm Ag/AgCl snap pads |
| In hair | Semi-dry pods at Fz, Cz, Pz: a 9 mm sealed pod body (cup + epoxied lid, 4 mm stud) inside a one-piece printed spring carriage; snap lead out through a small window in the carriage's side. Single-use foam tip cartridge that clicks onto each pod, sticking out 2–3 mm and wetted to a set weight (damp, not soaked). No reservoir: 2 to 4 drops (0.1 to 0.2 ml) of 0.9% saline through a 2 mm lid hole, only when the contact check asks |
| Mastoids, eye | Adhesive gel Ag/AgCl pads (M1, M2) · small hydrogel pad 20 mm below the left eye |
| Heart | MAX30102 breakout in a printed earlobe clip (hinge below the lobe, black padded opposite jaw, light torsion spring) · 5-wire lead to J6 on I²C bus 0 · pulse-rate variability read with the medication class (D09, D12, D22). Test-kit forehead MAX30102 on I²C bus 1 (J8): every MAX30102 has the same address, 0x57 |
| Motion | BMI270 IMU on the frame (X29) |
| Main board | v4.5: rev B, 4-layer, about 70 × 50 mm in the brow module (not yet laid out). Analog half copied from Low-Cost-EEG (inputs, filters, ADS1299, ±2.5 V supply). Seeed XIAO ESP32-S3 (21 × 17.8 mm) soldered flat on its castellated pads: Bluetooth LE 5.0, USB-C, LiPo charger, 3.3 V regulator, reset and boot buttons already on it. Flex antenna on its U.FL socket, stuck inside the shell |
| Fit | One size for 500 to 580 mm circumference and 300 to 390 mm nasion to inion (D19). Bought hard-hat ratchet harness (PN521; range not published, assumed 54–63 cm until measured) with a 3 mm lining, or a 7 mm small-head insert for heads under about 521 mm. Midline band printed already in the head's midline curve, lying on the head, from the brow module to a TPU tail through a cam lock on the battery pod. Each pod passes through a window in the band, and a pin under its carriage foot drops into one hole of a single row beside the window: the patient's size number (1 to 9), read off a size tape laid from nasion to inion (Fz, Cz, Pz at 0.2, 0.4, 0.6 × nasion to inion from Fpz). Circumference, nasion to inion, dial and size number are saved per patient |
| Pods in hair | Each pod is a plunger in a printed carriage pinned to the band, pushed through a window in the band onto the scalp by a compression spring (about 6 mm travel). Start at about 1 N; printed shims under the spring set 0.5 to 3 N, chosen in the frame and drying tests (the only force data, for dry multipin electrodes, found 2 to 3 N best: L26). Because the band follows the head, the spring only takes up hair and movement. Same idea as OpenBCI Ultracortex's printed spring holders (C71); Zeto's cleared headset is semi-rigid PA12 (C72) |
| Materials | Wipe-clean shell and band (PETG prints for the prototype; band printed already curved, PA12 SLS or MJF for Study 1; TPU tail; PC/ABS shell in the product) · soft TPU or silicone lining where the frame touches the head · single-use skin contacts · no fabric (D32, D34) |
| Power | 1000 mAh LiPo wired to the XIAO's battery pads, runs on battery only while worn · about 8–10 h estimated (v4.5; the XIAO alone draws about 85 mA with Bluetooth active) · charged through the XIAO's USB-C (about 50 mA, so about 20 h from empty), which blocks recording |
| Session | About 12 min chair time: under 5 min setup, 5 min recording (eyes closed 2, open 1, closed 2), sitting upright with no headrest behind the head, contact checks between blocks (D27, D28) |
| Output | One-page trend report: personal baseline, change bands, medication class and PHQ-9 on one timeline (D05) |
| Regulatory | India: medical device (D23), plan for CDSCO Class B and budget for C · IEC 60601-1, 60601-1-2, 80601-2-26, 62304, ISO 10993 |

### Channel map
| ADS1299 | Site | Contact |
|---|---|---|
| ch 1 | Fp1 | Strip pad (single-use) |
| ch 2 | Fp2 | Strip pad (single-use) |
| ch 3 | Fz | Semi-dry pod |
| ch 4 | Pz | Semi-dry pod |
| ch 5 | M2 | Gel pad |
| ch 6 | Eye (VEOG) | Small hydrogel pad |
| ch 7 | Cz | Semi-dry pod (new in v4) |
| ch 8 | ECG | Chest pads, test kit only |
| SRB2 | M1 reference | Gel pad |
| BIAS | Fpz | Strip centre pad |

## What changed from v3, and why
| Change | v3 | v4 | Why | How sure |
|---|---|---|---|---|
| Use case finalised | Tracks change | 12-min session (5 min recording) at baseline, day 7, every visit | Early-change evidence is session-based; clinicians are overloaded by passive data; head wearables lose adherence (D31) | High |
| Cz on channel 7 | Ch 7 ECG, ch 8 free | Ch 7 Cz, ch 8 ECG | Central cordance change predicted rTMS outcome (K102); P300 drop in depression largest at Cz (M10). Kept only if Study 1 says it adds | Low to medium |
| Single-use forehead strip | Snap + Ten20 paste | 3-pad hydrogel strip | No paste, no cleanup; a cleared forehead EEG device uses a disposable patch (C69, D32). Paste stays as the fallback | Medium |
| Eye pad | Snap + paste, ring | Small hydrogel pad | Single-use and quicker to place (D32) | Engineering |
| Pod parts | Bare cups on the arc | Three printed parts: carriage, sealed pod body, tip cartridge | v4.3: no separate cap or socket ring (the carriage housing covers the pod), lid epoxied on so one fewer joint can leak, snap lead straight onto the pod's stud. Wipes clean between patients (R18) | Design |
| Midline band, spring pods | Soft midline strap | Band on the head, printed in the head's curve, + spring carriages | A strap cannot hold a pod upright or push it through hair (D34). The v4.1 rigid spine fixed that but stood at one height, so the gap to the scalp changed by 7 to 10 mm across heads (see below); v4.2 made the band lie on the head. v4.4 prints it already curved instead of the v4.3 flat FR4: see [Band](#band-v44-printed-in-the-heads-curve). Spring per electrode as in Ultracortex (C71), semi-rigid PA12 frame as in Zeto (C72) | Medium |
| Pod positions from one tape | Carriage offsets from the 540 mm mannequin | Fz, Cz, Pz at 0.2, 0.4, 0.6 × nasion to inion from Fpz | 10-20 sites are percentages of nasion to inion, so one tape measurement places all three pods on any head shape (D19) | High |
| Size holes 1 to 9 | Slot + thumb nut, mm reading | One row of numbered holes beside each window; one size number per patient | v4.4: nasion to inion runs 300 to 390 mm, not 300 to 348 (P200, P201). Nine 10 mm sizes keep pods within 2 mm (Fz, Cz) and 3 mm (Pz) of their sites, under a fitted cap's 3 mm (P186). See [Size range](#size-range-v44) | High |
| Wet tip, no reservoir | Cup with 1 ml saline above the contact | Damp tip cartridge (set weight, 2–3 mm proud) + 2 to 4 drops when flagged | A standing pool drips into hair and can bridge sites (L06), and the 13 mm cup could not hold 1 ml (model estimate). Recording is 5 min; sponges held about 20 min without rewetting and feedback rewetting held 5–9 kΩ for 90 min (L37), so drops on demand keep a rewetting method (D21). v4.4: less squeeze, see [Pods and wetting](#pods-and-wetting-v43-v44). Decided by the pod drying test | Medium |
| Wetting check | Green or red contact check | Green / amber / red per pod with "add drops" prompts | AC lead-off between blocks (D27) gives each pod's impedance; channel noise flags drying during recording (D11) | Medium |
| Strip placed by template | Strip clicks onto the brow module | Nasion template, then a 3-way tail into the module | The strip's height followed wherever the halo landed. A template puts the centre pad within about 2 mm; one size fits because Fp1 to Fpz is 25.0 to 29.0 mm on 500 to 580 mm heads | High |
| Silicone lining, no fabric | None | Soft wipe-clean lining | A knit cover was tried in the first v4 and dropped: laundry and spares for no gain (R18, D34) | Design |
| Bought ratchet halo | Fitted frame | Hard-hat ratchet harness with a 3 mm lining or a 7 mm small-head insert | Buyable, not made. Karam publishes no PN521 size range (C75); harnesses that do close to 52 cm (Klein, C73) or 54 cm (3M G2N, C76). Indian women go down to 499 mm (P190), so v4.4 assumes 54 cm: the 3 mm lining takes about 19 mm off (2π × 3) and a 7 mm insert about 44 mm. Repeatable fit: 3.0 mm vs 9.8 mm with straps (P186, D19) | Medium |
| Brow module | 45° wide, 19 mm thick | v4.3: 52° wide, 15 mm thick. v4.5: about 140 × 65 mm, 29.5 mm off the skin at its centre | v4.5: holds the 70 × 50 mm board (fit check in [Main board](#main-board-v45)). Shape is still a model estimate | Design |
| Main board | Rev A (Cyton circuit, auto-routed, 100 × 80 mm) | v4.5: Low-Cost-EEG analog half + XIAO, about 70 × 50 mm | The noise-critical half is copied from a board that was built and recorded EEG; only the digital side is new | Engineering |
| Microcontroller | ESP32-S3-MINI-1 module on the board | Seeed XIAO ESP32-S3 soldered flat (v4.5) | A bare module needs our own 3.3 V, reset, boot, USB and charger circuit; the XIAO is the same chip with all of that on it, tested and replaceable by hand. See [Main board](#main-board-v45) | Engineering |
| Battery | 2000 mAh | 1000 mAh, kept at the back | About 8–10 h (v4.5 estimate: XIAO about 85 mA with Bluetooth active, ADS1299 about 5 mW per channel; v4.3 said 14 h at 0.25 W) covers a clinic day of 5-minute sessions if it is switched off between patients. At the back it balances the brow module and shares one rear part with the dial and cam lock; moving it would not help with headrests (the dial and Pz pod are there too). Lay the cell flat | Judgement |
| Motion sensor | MPU-6050 | BMI270 | A current wearable IMU; the MPU-6050 lifecycle could not be confirmed (X29) | Engineering |
| Forehead heart window | None | Test kit only | Compare forehead and earlobe PPG against ECG before choosing (X26, X27, D22) | High |
| Head-ECG check | Not planned | M2 minus M1 vs chest ECG | If it matches, a later version can drop the earlobe clip (X28) | Judgement |

## What changed in v4.4, and why

| Change | v4.3 | v4.4 | Why | How sure |
|---|---|---|---|---|
| Size range | 5 sizes, nasion to inion 300–348 mm (mannequin ratio 0.60 × circumference) | 9 sizes, 300–390 mm; nasion to inion measured, not worked out from circumference | Living adults typically 320–380 mm (P200); bare adult skulls 305–356 mm (P201) | High |
| Size holes | Two staggered rows behind each carriage, pin on a tab | One row in the side rail beside each window, pin under the carriage foot; Fz holes serve two sizes each | A fixed pin can only reach one row, so staggered rows did not work; one row is simpler and still within 2–3 mm | High (geometry) |
| Band | Flat FR4 bare PCB, 0.6–0.8 mm, 26 mm | Printed already in the head's curve, 30 × 1.8 mm, PA12 (PETG for fit tests), spliced to a TPU tail behind Pz | JLCPCB size limits (C74); a flat strip is bent all day and springs off the head near its ends | Medium (frame test) |
| Halo lining | 3 mm only | 3 mm or a 7 mm small-head insert | PN521 range not published (C75); others close only to 52–54 cm | Medium (measure) |
| Foam tip | 4–6 mm proud, stored soaked | 2–3 mm proud, wetted to a set weight; spring from about 1 N with shims to 3 N; hydrogel tip as a test arm | 1–2 N on a 10 mm tip is about 13–25 kPa, enough to squeeze a soaked tip (arithmetic); hydrogel semi-dry worked on hairy scalp (L36) | Medium (drying test) |
| Posture | Seated | Upright, no headrest behind the head | The dial, battery pod and Pz pod are at the back of the head | Design |

## Band (v4.4): printed in the head's curve

A band only has to lie on the head and hold the pods' carriages. v4.3 made it from flat FR4 so it would not creep the way a bent PETG print does. That has two problems:

- **It cannot be made at its length.** JLCPCB makes 0.6 mm boards only up to 100 × 100 mm and 0.8–1.0 mm only up to 300 × 300 mm (C74). The band runs from the brow to past Pz and on to the cam lock, about 290 mm on this 540 mm head before the cam-lock tail (model estimate), and more on larger heads.
- **A flat strip fights the head all day.** Bent to a 60–90 mm radius, 0.8 mm FR4 carries about 0.45–0.67% strain (arithmetic, t/2R), and a stiff strip springs back off the head near its ends.

**Fix:** print the pod section already in the head's midline curve (this mannequin's), standing on its edge so the printed lines run along its length. It then only flexes by the difference between heads: for a 95 mm mean radius and 85–105 mm heads, about 0.1% strain at 1.8 mm thick (judgement), a small fraction of the bent-flat case, so creep is not a concern. Check anyway: leave one band on a head form for 48 h and see whether it takes a set.

| Part | Make it | Notes |
|---|---|---|
| Pod section | Print: PETG on the VIT printer (100% infill) for fit tests; PA12 SLS or MJF from an online service for Study 1 | 30 mm wide, 1.8 mm thick (print 1.5 and 2.0 too, keep the one that lies on the head without lifting at the pods). From the brow module to 12 mm behind the Pz window, about 195 mm chord, fits a 220 × 220 mm bed. Windows and size holes printed in, numbers embossed |
| Tail | Print: TPU 95A, 22 × 2 mm | Spliced to the pod section with a printed plate and two M3 screws; runs through the cam lock on the battery pod |
| Cam lock | Print: PETG | Same as v4.3, five → nine marks |

Every head-worn frame has one trade-off the band cannot remove: whatever presses the pods down pulls the halo up, by about twice the band tension. Keep the pod force low (start at about 1 N) and seat the ratchet low, under the bulge at the back of the head; the frame test checks that the halo does not ride up.

FR4 stays only as a fallback: 0.8 mm, under 300 mm, with 3 mm or larger radii on every window corner.

## Size range (v4.4)

- v4.3 worked out nasion to inion as 0.60 × circumference, this mannequin's ratio, which gives 300–348 mm for 500–580 mm heads. Living heads run longer: a sleep-EEG methods paper gives 32–38 cm as typical for adults (P200), and 80 bare adult skulls already measured 305–356 mm (P201), before any scalp.
- v4.4 covers 300–390 mm in nine 10 mm sizes (centres 304, 314, … 384 mm). The page now has a separate nasion–inion slider; circumference only sets the halo, its lining and the strip spacing.
- **Size holes:** one row per pod in the band's side rail, beside the window, so hole k sits where the pod stands for size k and a pin under the carriage foot drops into it. Cz and Pz have one hole per size (4 and 6 mm apart). One Fz step is only 2 mm, so 5 Fz holes 4 mm apart serve two sizes each (1·2, 3·4, 5·6, 7·8, 9). Worst case anywhere in 300–390 mm: Fz 2 mm, Cz 2 mm, Pz 3 mm, under a fitted cap's 3 mm re-placement error (P186).
- **Windows** are as long as each pod's travel plus the pod: about 32 mm at Fz, 48 mm at Cz and 64 mm at Pz, 16 mm wide, leaving 7 mm rails on a 30 mm band.
- **Size tape:** a printed paper tape laid from nasion to inion with coloured bands 1–9 and the strip height for each, so staff read the size directly. Fpz is 30–39 mm above the nasion across this range.
- **Check before freezing the range:** tape-measure circumference and nasion to inion on 15–20 people, half women, including the largest heads you can find. If they all fall inside a narrower range, drop the unused holes.

## Fit across heads (v4.2)

Modelled on the shared head: the 540 mm mannequin's midline, a frame held between the brow (Fpz) and the back of the halo (inion), and the head scaled to 500 and 580 mm, then made 8% taller or flatter for its length. Numbers are how far the scalp under each pod moves relative to a rigid spine of fixed shape (positive = closer).

| Head | Fz (mm) | Cz (mm) | Pz (mm) |
|---|---|---|---|
| 500 mm, mannequin shape | −4.4 | −6.6 | −6.0 |
| 580 mm, mannequin shape | +4.4 | +6.6 | +6.0 |
| 540 mm, 8% taller for its length | +2.3 | +3.4 | +3.1 |
| 540 mm, 8% flatter for its length | −2.2 | −3.3 | −3.0 |
| 500 mm and flat | −6.5 | −9.7 | −8.8 |
| 580 mm and tall | +6.9 | +10.3 | +9.3 |

- With v4.1's spring (about 0.23 N/mm and 1.4 N at 6 mm, C71), a head 6.6 mm closer bottoms the spring out and one 6.6 mm farther lets the pod lift off. The band lies on the head, so this gap no longer depends on the head.
- The size rows are geometry. The shape rows assume the height-to-length ratio varies up to 8% either way (about 2 SD, judgement); real Indian head shapes may vary more.
- Forehead: Fp1 to Fpz is 5% of circumference, 25.0 mm at 500 mm and 29.0 mm at 580 mm, so one strip with 27 mm centres is off by 2 mm at most, under the 3 mm re-placement error of a fitted cap (P186). Fpz is 10% of nasion to inion above the nasion, 30 to 35 mm.
- Halo (v4.4): the PN521's range is not published (C75); assume it closes to 54 cm like 3M's G2N until measured. Indian adult heads run 499 to 578 mm (P190): the 3 mm lining covers down to about 521 mm and the 7 mm small-head insert down to about 496 mm.

## Pods and wetting (v4.3, v4.4)

**Pod: three printed parts plus bought ones.**

| Part | Make it | Notes |
|---|---|---|
| Carriage | Print, PETG, 0.2 mm layers | One piece: housing, two feet that stand on the band edges either side of the pod window, the size-pin tab, and a small side window (about 5 × 6 mm) for the snap lead. The ring on top is the top-up port. No LED: the app shows contact status. |
| Pod body | Print, resin (SLA) or PETG with 4 or more walls | 14 mm wide, 9 mm tall cup with a side slot for the internal lead, and a lid with a 2 mm top-up hole in the middle and a 4 mm snap stud off to one side. After the contact goes in, the lid is epoxied on for good: one sealed part. |
| Tip cartridge | Print collar (PETG or TPU) + PVA foam | 10 mm foam tip pressed into a thin collar so 2–3 mm sticks out (v4.4; was 4–6), wetted to a set weight and stored in a sealed pack, clicks onto the pod body from below. Single-use. Dome and fingered tips to compare; PVA hydrogel tip as a test arm. |
| Spring, Ag/AgCl contact, 4 mm stud, snap lead | Buy | Spring sits between the carriage top and the pod lid (about 6 mm travel). Start at about 1 N; printed shims set 0.5 to 3 N. Snap lead: FRI TDE-205. |

What changed from the first v4.3 pod: no reservoir (a standing pool drips into hair and can bridge sites, L06); no separate pod cap or socket ring (the carriage housing already covers the pod, and every extra joint can leak); no status LEDs; cup 9 mm instead of 13, so the whole pod stands about 24 mm above the scalp instead of 28.5 and puts less sideways lever on the band.

**Cables from the pods.** The snap lead clips onto the pod's stud, leaves through a small window in the carriage's side with a slack loop (the pod moves about 6 mm on its spring), drops to the band edge outside the carriage feet, and runs forward in printed cable clips into the brow module to J1. Fz and Pz run along the left edge, Cz along the right, so no cable passes under a pod window.

**Top-up.** Drops go through the lid and the contact's centre hole straight into the foam: 2 to 4 drops (0.1 to 0.2 ml) of 0.9% saline, between blocks only, with a dropper or blunt syringe. Tap water works in a pinch (L30); distilled water does not conduct.

Size holes (v4.4): one row per pod in the band's side rail, right beside the window; a pin under the carriage foot drops into the patient's hole. Cz and Pz: nine holes, 4 and 6 mm apart. Fz: five holes 4 mm apart, two sizes each. See [Size range](#size-range-v44).

Build notes: keep saline away from the snap and solder joint; seal the lead slot with epoxy or silicone, not hot glue. All sizes here are model estimates until the first print.

Has it been done before: semi-dry electrodes with a small saline supply are published (Hua 2019 P29, Zhu 2024 L05, Li 2024 L36, Mota 2013 L04) and sold (Brain Products R-Net: Ag/AgCl pellets with exchangeable saltwater sponges in a silicone net). This exact pod has not been tested.

**Less squeeze (v4.4).** A 1–2 N spring on a 10 mm tip presses the foam at about 13–25 kPa (arithmetic: force / 78.5 mm²), enough to squeeze saline out of a soaked tip. So:
- wet each tip to a set weight (weigh it dry and wet; the drying test sets the number), damp, not soaked;
- let only 2–3 mm stick out, so the spring compresses less foam;
- start at about 1 N and only go up if contact needs it;
- test a PVA hydrogel tip, which holds its water under pressure (a PVA/PAM hydrogel semi-dry electrode reached 18.2 kΩ through hair, L36).

The pods are 60–78 mm apart, so a wet path between them is unlikely; drips running onto the mastoid or forehead pads are the realistic risk, and the drying test records them.

**Will it dry out?** Possibly. Sponges rose in impedance after about 20 min on hairy scalp without rewetting (L37); the tips go on about 8 to 10 min before the session ends, so the margin is roughly 2× but untested in warm rooms or on oiled hair. That is why the top-up hole stays.

**Wetting check (app and firmware).**
- Between blocks: the ADS1299's AC lead-off (31.2 Hz) runs on one pod at a time and gives its impedance; it is in band, so never during recording (D27).
- During recording: rising 50 Hz on a channel, slow drift, extra low-frequency noise or a flat line flag that pod for the next pause.
- Colours (starting points, set in Study 1): green under about 20 kΩ and steady; amber 20 to 40 kΩ or up more than 50% since the first check (top up at the next pause); red over about 40 kΩ (top up now, recheck before the next block).
- Calibrate first: 5, 20, 50 and 100 kΩ resistors in place of an electrode; the app should read each within 10%.
- Log every reading, so Study 1 shows how often and when top-ups are needed.

**Pod drying test (before freezing the pod).** Five or more heads with oiled, thick and short hair, normal room without AC, impedance every 2 min for 20 min. A: v4.1 cup with 1 ml reservoir. B: damp tip only. C: damp tip plus 2 to 4 drops when flagged. D: PVA hydrogel tip. Spring at 1, 2 and 3 N. Also dome against fingered tip. A lab LCR meter works before the EEG board exists. Pass: under 40 kΩ, no steep rise to 15 min, no drips and no wet path from a pod. Ship the simplest that passes (B, then C, then D).

## Forehead contacts and the brow module (v4.3)

- **MVP:** three separate 22 × 22 mm Ag/AgCl snap pads stuck on through the nasion template card (centres 27 mm apart, centre pad at 10% of nasion to inion), with three snap leads to the board: Fp1 to J2, Fp2 to J3, Fpz to the bias input. This is how ECG pads are connected, so there is nothing new to design.
- **Product:** one custom 3-pad strip with a single connector tail, made by a disposable-electrode supplier once the MVP has fixed pad size, spacing and adhesive.
- **Pads first, headset second.** The pads hold themselves on; placing them by template means their position does not depend on where the halo lands.
- **The brow module never presses on them.** Its underside sits 6.5 mm off the skin over the pads (a pocket), and it rests on a soft pad on the upper forehead. A rigid module on gel pads is uncomfortable and moves them with every frown. The board sits higher in the module as a result.
- **Later option:** a soft insert under the module with three floating snap sockets, so the headset clicks onto the pads and needs no forehead leads. Not in the MVP: it adds a part to align and could add motion noise, for no gain in signal.

## Ear clip and heart-sensor wiring (v4.3)

**Buy the sensor, print the clip.** A small MAX30102 breakout (sold widely in India). Ready-made "ear-clip pulse sensors" mostly output only a beat pulse, not the raw waveform needed for pulse-rate variability; hospital ear probes are transmissive and need a different front end.

**Clip to print (black PETG or TPU 95A):**
- The earlobe's free edge is at the bottom, so the hinge sits below the lobe and the jaws close upward over it.
- Outer jaw: a pocket sized to the module you bought, with the sensor window flush with the inner face.
- Inner jaw: black, with a black foam pad, so room light cannot shine through the thin lobe.
- A small torsion spring on the hinge pin gives a light, repeatable squeeze. PPG signal rises with contact pressure up to a point and then falls as the vessels collapse (in a lab phantom the best was about 35 to 48 mmHg, X30), so the spring must hold without pinching.
- A strain-relief boot where the lead leaves the top; the lead runs up in front of the ear into the halo.
- Quickest prototype: glue the module to a screw-adjustable clip-on earring finding; the screw sets the pressure.

**Wiring.** Five wires to J6: 3.3 V, ground, SDA, SCL and the interrupt line (optional, makes the firmware simpler). I²C at 100 kHz over a thin twisted cable, about 30 to 40 cm. Some cheap MAX30102 boards pull SDA and SCL up to 1.8 V instead of 3.3 V and are then not detected: check yours and rewire the pull-ups if needed.

**Fix from v4:** the test-kit forehead MAX30102 cannot share the earlobe sensor's bus, because every MAX30102 answers at the same I²C address (0x57). It moves to the ESP32-S3's second I²C bus (J8). A TCA9548A multiplexer is the alternative.

## Main board (v4.5)

**The board copies a proven open design.** Rev B takes the analog half of [Low-Cost-EEG](https://github.com/XavierAsghar/Low-Cost-EEG) (X. Asghar, GPL-3.0) unchanged: electrode inputs, ESD diodes, the 2.2 kΩ + 1 nF C0G filters, the ADS1299 with its decoupling, its LM27762 ±2.5 V supply and the separate TPS7A20 3.3 V for the ADS1299, on the same 4-layer signal/ground/power/signal stack. Only the digital side is new: a Seeed XIAO ESP32-S3 in place of its ESP32-S3-WROOM-1, plus the BMI270 and the two heart-sensor connectors. The files are in [pcb/](../pcb/README.md).

**Why copy it.** EEG is microvolts, so the analog layout decides the noise, and there is one order. Low-Cost-EEG is an ADS1299 + ESP32-S3 board (100 × 50 mm, 4-layer) that was built and recorded ECG, EMG, eyes-closed alpha, SSVEPs and P300s; a second person [rebuilt it](https://github.com/agteo/diy-eeg-mac) from the same files and recorded alpha. Its report gives no noise figure for the board itself: the 2 µVpp in it was measured on TI's evaluation board. Its analog section follows the OpenBCI Cyton, like rev A.

**Why not copy all of it.** It has no I²C connectors for the two MAX30102s (they need separate buses: both answer at 0x57) or the BMI270, and at 100 mm it would push the brow module about 36 mm off the forehead. Its analog half is about 55 × 50 mm; with the XIAO beside it, rev B is about 70 × 50 mm (could reach 75 once laid out).

**Fit check (7 Nov 2026, on this head).** The forehead curves with a radius of about 67 mm, so a flat board lifts off the skin at its ends. Outer height at the thickest point, with 3 mm tall parts, the 6.5 mm pocket over the forehead pads and a 1.5 mm wall:

| Board | Brow module | At the back or side (no pad pocket) |
|---|---|---|
| v4.3's drawn 60 × 32 mm | about 24 mm (the model showed 21.5, so it was already too thin) | about 14 mm |
| Rev B, about 70 × 50 mm | **about 29 mm** | about 17–19 mm |
| Low-Cost-EEG as is, 100 × 50 mm | about 36 mm | about 22 mm |

v4.5 keeps the board in the front: the brow module grows to about 140 × 65 mm and stands about 29.5 mm off the skin at its centre (v4.3: about 141 × 51 mm, 21.5 mm). Its top stays about 20 mm below the Fz pod on this head. A smaller custom board, or a flex board, can slim it in the product once the prototype has proven the signal.

**The microcontroller: Seeed XIAO ESP32-S3**

| | |
|---|---|
| Size | 21 × 17.8 mm, castellated pads, soldered flat by hand (JLCPCB does not place it) |
| On the board already | USB-C, LiPo charger (about 50 mA), 3.3 V regulator (up to 700 mA), reset and boot buttons, so rev B has no ESP32 power, boot or USB circuit of its own |
| Radio | Bluetooth LE 5.0 through a flex antenna on a U.FL socket (one comes with each); stick it inside the shell, away from the board's ground |
| Pins | 11 on the edges; rev B uses 10 (draft map in [pcb/](../pcb/README.md)): ADS1299 SPI (SCLK, MOSI, MISO, CS, DRDY), two I²C buses (the ESP32-S3 has two controllers), battery voltage through a divider. ADS1299 START and RESET are sent as SPI commands |
| Power | About 85 mA with Bluetooth active, 27 mA in modem sleep (Seeed) |
| Buy | Robu, ₹1,139 incl. GST, in stock on 7 Nov. The XIAO ESP32-S3 Plus (18 pins, 100 mA charging) was out of stock at Robu, Robocraze, Hubtronics, Amazon.in and Probots |

Sources: [Low-Cost-EEG](https://github.com/XavierAsghar/Low-Cost-EEG) (files, Final_Report.pdf), [diy-eeg-mac](https://github.com/agteo/diy-eeg-mac), [Seeed XIAO ESP32-S3 wiki](https://wiki.seeedstudio.com/xiao_esp32s3_getting_started/), [Espressif I²C (ESP32-S3)](https://docs.espressif.com/projects/esp-idf/en/v4.4.8/esp32s3/api-reference/peripherals/i2c.html).

**Other options looked at (7 Nov):**
| Option | Why not |
|---|---|
| New 60 × 32 mm layout of the Cyton circuit (first v4.5 plan) | A fresh analog layout is the riskiest part with one order |
| Low-Cost-EEG as is, in the brow module | No I²C for the heart sensors and IMU; about 36 mm off the forehead |
| Low-Cost-EEG as is, at the back, side or in a clip-on box | Needs changes anyway for I²C; the back already holds the ratchet and band lock; the side box looked forced (v5 trial, dropped); a box off the head is not wearable |
| Rev B at the back with the battery | About 19 mm plus the battery, but it must clear the ratchet knob and band lock; leads to the forehead about 25–30 cm (workable: clinical EEG uses long passive leads) |
| Bare ESP32-S3-MINI-1 or WROOM-1 on the board | Our own ESP32 power, boot, USB and charger circuit: more ways for the one order to fail |
| DevKit on the board | Too big, no charger |
| Cerelog ESP-EEG | Hardware files are non-commercial (CC-BY-NC-SA) and no published noise figures |
| XIAO ESP32-C3 | Only one I²C controller |
| Waveshare ESP32-S3-Zero, Adafruit QT Py ESP32-S3 | No battery charger |
| XIAO nRF52840 | Lower Bluetooth power, same footprint, but a different chip and toolchain. Keep the option: rev B's pin map should let it drop in later |

**Before ordering:** a professor's review of the changed parts (digital side, battery and charger wiring, the Altium-to-KiCad import), battery polarity, the UDL snap-lead ends on the 2.54 mm input headers, LM27762 and TPS7A20 stock at JLCPCB. On the first board: power rails, ADS1299 ID register, then shorted-input noise against the 6 µVpp target.

## Cleaning model (D32, D34, R18)
- **Single-use, binned after every session:** forehead strip, M1/M2 pads, eye pad, three wet tip cartridges.
- **Wiped between patients (low-level disinfection, noncritical item):** everything else: shell, band, carriages, pod bodies, lining, earlobe clip, dial, halo. Nothing to wash.

Turn on **Display → Single-use vs reusable** (or press U) to see this on the model.

## Prototype budget
**Current prices and order:** the Neuryo v4.4 prototype buy plan (7 Nov, updated for v4.5). The figures below are the earlier 29 Oct budget.

₹42,555 priced (including two Karam PN521 helmets for their harness, ₹612) plus 10 items to quote (PA12 band prints, forehead snap leads, ear-clip cable and spring, 1000 mAh cells, BMI270 breakout, hydrogel discs and eye pads, spring assortment, M3 screws and heat-set inserts, TPU filament or silicone strip, 22 × 22 mm snap pads). That leaves ₹7,445 of the ₹50,000 grant for all ten, with no margin: quote them before ordering anything large.

## Frame: buy or 3D-print
| Part | Buy or print | Notes |
|---|---|---|
| Halo + dial | Buy | Harness from a ratchet-type safety helmet (Karam PN521, about ₹306). Keep the headband and knob; remove the cradle, chin strap and shell |
| Brow module, battery pod | Print | PETG on the VIT printer or PA12 SLS online; battery pod clips over the ratchet housing |
| Midline band + cam lock | Print | Pod section printed already in the head's curve, on its edge: PETG (VIT) for fit tests, PA12 SLS or MJF for Study 1; 30 × 1.8 mm, windows, one row of size holes and embossed numbers 1–9 printed in. TPU tail spliced on behind Pz with two M3 screws, through a printed cam lock on the battery pod with nine marks |
| 3 pod carriages | Print | One part each: housing, two feet on the band's side rails with a 2 mm pin under one foot, small side window for the snap lead. The pin drops into the size hole. Start from the open-source Ultracortex spring holder, resized for the saline pod |
| Nasion template + size tape | Print | Card with a nose-bridge notch and a 30 to 39 mm scale for the strip centre; paper tape with size bands 1–9 laid from nasion to inion |
| Springs | Buy | Compression spring assortment covering about 0.5–3 N at 6 mm; printed shims fine-tune it. Pick by pressing each pod on a kitchen scale |
| M3 screws, nuts, heat-set inserts | Buy | Robu / Amazon |
| Lining | Print or buy | TPU 95A: 3 mm standard and 7 mm small-head insert; or stick-on silicone strip |

**Build order:** measure 15–20 heads and the bare harness first, then print the frame and test it before ordering boards. Wear it on thick, oiled and short hair, nod and turn, check the pods stay upright and on the scalp and the halo does not ride up, weigh the front and the back, and check the spring force at Fz, Cz and Pz.

**Only for the launched product (contract manufacturer):** moulded shell, moulded band in the same curve, moulded silicone lining, a branded ratchet.

### Building the frame, step by step (7 Nov 2026 notes)

**1. Halo and dial from a safety helmet.** Buy a ratchet-type safety helmet and keep only its harness. Tested choice: Karam PN521 ratchet type with plastic cradle, ₹306 incl. GST on [ToolBuy](https://www.toolbuy.com/tp/karam-isi-marked-shelmet-ratchet-type-safety-helmet-with-plastic-cradle-red-pn521) (also on Karam's own store and Amazon.in). Buy two.
- Keep: the black headband and the ratchet knob (the knob sits at the back of the head).
- Remove: the white X-shaped cradle (unclip its 4 legs from the shell; it sits where Fz, Cz and Pz go), the chin strap and the red shell.
- Check on the first one: whether the headband hooks onto the cradle legs or is riveted. If riveted, cut the legs leaving 1 to 2 cm stubs; they make good screw points for the brow module and battery pod.
- In the headset, the midline band does the job the white cradle did: it holds the halo at the right height.

**2. How the printed parts attach.**
- Brow module: slot on its back; the front of the headband slides in and two M3 screws lock it.
- Battery pod: clips over the ratchet housing, with a hole so the knob stays reachable. On most ratchet harnesses the two toothed headband ends slide past each other inside the housing and stick out sideways as the knob tightens; the pod's clip must leave room for them at the tightest setting, or the knob jams before the halo is snug.
- Midline band: front end pins into the top of the brow module; the back end runs through a cam lock on top of the battery pod, so its length is set per patient. Fitting order: size holes first, headset on, dial snug, then pull the tail until the band lies on the head and close the cam lock. Tightening the dial pulls the back of the halo in a few millimetres, so a band locked first would end up slack; the size mark on the lock is only a starting point. A notch under the brow module lines up with the strip's centre mark, which puts the band's 0 mm mark over Fpz.

**3. Spring carriage (one per pod).**
- The band has a window for each pod and, in its side rail right beside the window, one row of numbered holes: Cz and Pz one per size 1–9 (nasion to inion 304 to 384 mm), Fz one per two sizes. A 2 mm pin under the carriage's foot drops into the patient's hole. The pod passes down through the window.
- Carriage is a printed sleeve; the pod cup slides inside it (about 0.5 mm clearance) with a small flange at its top and a lip at the sleeve bottom so it cannot drop out.
- A bought compression spring (outer diameter about 8 to 10 mm) sits between the sleeve top and the cup, about 6 mm of travel. Starting point: about 1 N; OpenBCI's electrode spring is about 0.23 N/mm, about 1.4 N at 6 mm (C71). Printed shims under the spring tune it; check with a kitchen scale.
- The snap lead clips onto the pod's stud, leaves the carriage through a small side window and runs along the band edge, with slack for the travel.
- Fit test: print sleeves at 14.4, 14.6 and 14.8 mm inner diameter and keep the one that slides best.

**4. Version 1 is simpler on purpose.** First print a curved band with fixed windows at Fz, Cz and Pz for your own heads (no size holes), with springs and pods in them. Print it at 1.5 and 2.0 mm and keep the one that lies on the head without lifting at the pods. Test that the pods stay upright and touch the scalp. Add the windows and size holes for sizes 1–9 in version 2.

**5. Measure the harness, then update the model.** Send: headband width and thickness at the front, ratchet housing width, height and depth, how far the toothed headband ends stick out of the housing at the tightest setting, and the distance from the front of the band to the knob. The 3D model shows the layout correctly but not these exact sizes yet, so the brow module slot, battery pod clip and cam lock are set once these are measured. Also measure the harness fully closed and fully open, bare, with the 3 mm lining and with the 7 mm insert: with the insert it must reach 500 mm.

**Order of work:** frame first (a few hundred rupees), electronics on the bench in parallel (no frame needed; paste and tape or the VIT wet cap for first signals), then put the electronics in the frame with dry or paste inserts, then saline pods. The saline pod (no leaks, foam stays wet) is the riskiest part, not the frame. The full parts list with links is in **Details → Build** on the page.

## On the page
| Control | Where | What it does |
|---|---|---|
| Mode: Product / Test kit | Left | Test kit adds ECG pads, the forehead heart window and the comparison inserts |
| Fit & finish | Left | Head circumference (500 to 580 mm) and nasion to inion (300 to 390 mm) sliders give the ratchet setting and lining (3 mm or the 7 mm insert), the strip height, and the band size number (1 to 9) that sets all three pods and the band lock; the dial on the model turns |
| Soft layer: Silicone / Knit idea / See-through | Left | The product's silicone lining, or the dropped knit sleeve to compare looks (F cycles) |
| Lining and shell colours | Left | Six lining colours, four shell colours |
| Inserts (test kit) | Left | Forehead: strip / paste / dry. Hair: semi-dry / dry spike. Heart: earlobe / + forehead |
| Head: Solid / Ghost / Hidden | Top | Mannequin display |
| Display menu | Top | See-through shell (I), Electronics only (E), Labels (L), Sizes (S), Channel numbers (N), all 77 10-10 sites, colour by How sure the plan is (C) or Single-use vs reusable (U) |
| Copy link | Top | Copies a link that reopens exactly this view, including size, cover, colours and overlays |
| Views | Bottom | Front, Side, Back, Top, Skin side; Explode slider; Measure |
| Guides | Bottom | Session walkthrough (G), Electrode build, Board guide |
| Details | Top | Parts, Session, Build, Changes, Specs, Sources tabs |

The **Session walkthrough** steps through one clinic session on the model in 9 steps: check in, prep the skin, place the strip with the template, click on the wet tips, fit the frame at the patient's size, pads and heart clip, contact check, record (upright, no headrest), remove and clean. Arrow keys move between steps; Esc exits.

## Still open
- Study 1 decides whether Cz earns its channel, strip vs paste on the forehead, and earlobe vs forehead PPG.
- Head-ECG (M2 minus M1) vs chest ECG: if it matches, the earlobe clip may go in a later version.
- Ear clip spring force and jaw size: set on the first print against the module you buy.
- Brow-module shape, board outline and chip positions are model estimates for the product designer.
- Rev B: not laid out yet (see [Main board](#main-board-v45)): final size (70–75 × 50 mm), brow-module fit on small and large heads, real battery life on the 1000 mAh cell.
- Pod spring force, band thickness (1.5, 1.8 or 2.0 mm), whether the halo rides up, and total weight: set by the frame test (D34). Pass marks: the same force at Fz, Cz and Pz on 10 or more heads spanning 500 to 580 mm with only the size number changed; Cz within 5 mm of tape-measured Cz across two operators.
- Size range: 300–390 mm until 15–20 real heads are measured (P200, P201).
- Whether a printed PA12 band takes a set over weeks (48 h head-form check first).
- PN521 harness range, bare and with the 3 mm lining and 7 mm insert (with the insert it must close to 500 mm).
- Pod drying test (A vs B vs C vs D hydrogel, dome vs fingered tip, 1–3 N), the tip's wetting weight and the wetting thresholds.
- Strip pad size and adhesive to be set with the hydrogel supplier.
- CDSCO class (B vs C) to be confirmed with a regulatory consultant.
- Ideas from the 7 Nov review (threaded carriages for head height, deeper spine, weight estimate, frame test on small, large and oiled-hair heads) are in [ideas-v4-review.md](ideas-v4-review.md). Not adopted yet.
