aryankalra404/Neuryo-Headset/docs/v3.md

# v3 · 29 Oct review

**Status:** superseded by [v4](v4.md) (7 Nov product design). Replaced v2.

**Open it:** [designs/v3/](https://aryankalra404.github.io/Neuryo-Headset/designs/v3/). AR and try-on are not set up for this version yet.

**Source:** the 29 Oct review of v2 ("Neuryo v2 review and v3 plan" doc) and the Neuryo-Research library. Codes like D29 are decisions in `00-decisions.md`; codes like P197 or X22 are evidence rows in `evidence-log.csv`.

## Spec
| | |
|---|---|
| On the head | 6 channels · Fp1, Fp2, Fz, Pz, M2, eye (VEOG) |
| EEG chip | ADS1299, 8 channels · ch 7 ECG (test kit only) · ch 8 free |
| Reference | M1, left mastoid bone, on SRB2. Linked mastoids only in software |
| Bias (DRL) | Fpz |
| Gain | 12 · input range ±375 mV (D29) |
| Contact metal | Ag/AgCl at every site |
| Sockets | One 4 mm snap socket at each frame site (Fp1, Fp2, Fpz, Fz, Pz); inserts swap without tools |
| Forehead (Fp1, Fp2, Fpz) | Flat Ag/AgCl snap + a pea-sized dab of Ten20 paste |
| In hair (Fz, Pz) | Semi-dry reservoir pod. Test arms: flat snap + paste, Ag/AgCl 5 mm spikes (dry) |
| Mastoids (M1, M2) | Adhesive gel Ag/AgCl pads, 32 × 25 mm, long side vertical |
| Eye (VEOG) | Spare flat snap + paste under a small adhesive ring, about 20 mm below the left eye |
| Heart | MAX30102 in a left-earlobe clip · pulse-rate variability. Lead runs up in front of the ear |
| Motion | MPU-6050 on the frame (prototype) |
| Power | Battery only while worn · Cyton-style ±2.5 V analog + 3.3 V digital · USB-C for charging and firmware |
| Main recording | Eyes-closed rest block; impedance between blocks |
| Fit | Fitted frame for 500–580 mm heads. Fz slides ±7 mm, Pz ±17 mm |
| Test kit | 2 ECG pads below the collarbones (or on both forearms) on ch 7, plus the comparison inserts |
| Intended use | Tracks change in the same patient across visits. Monitoring aid, not diagnosis (D01) |

## Channel map
| ADS1299 input | Site | Contact | Purpose |
|---|---|---|---|
| Ch 1 | Fp1 | Flat Ag/AgCl + paste | Week-1 frontal theta (core) |
| Ch 2 | Fp2 | Flat Ag/AgCl + paste | Week-1 frontal theta (core) |
| Ch 3 | Fz | Semi-dry pod | Prague region, frontal midline theta |
| Ch 4 | Pz | Semi-dry pod | P300 if adopted; posterior alpha check |
| Ch 5 | M2 | Adhesive gel | Offline linked mastoids; heartbeat reference |
| Ch 6 | Below left eye | Flat Ag/AgCl + paste | VEOG for eye-artifact regression |
| Ch 7 | Chest or forearms | 2 adhesive gel pads, SRB2 off | ECG, test kit only |
| Ch 8 | Free | | Option: Fpz as a channel, or Cz |
| SRB2 | M1 | Adhesive gel | Single online reference |
| Bias | Fpz | Flat Ag/AgCl + paste | Common-mode drive |

## What changed from v2, and why

| Change | v2 | v3 | Why (decision · evidence) | How sure |
|---|---|---|---|---|
| Reference site | TP9, moved 15 mm back | **M1, mastoid bone** | The skin around the ear "including the mastoid bone" is described as hair free (P197); hair cover at TP9 is not reported; adhesive pads fail through hair (L37) | Medium |
| Second mastoid channel | TP10 | **M2** | Moves with the reference | Low to medium |
| EEG chip | ADS1299-6 | **8-channel ADS1299** | Already the part in the 29 Oct budget; same 64-pin package (X22). Frees ch 7 for ECG and ch 8 | Very sure |
| Gain | 24 (from v1) | **12** | ±187.5 mV at gain 24 cannot hold the ±300 mV offset tolerance or the IEC 300 mV test (X22, R17, C01); noise 0.16 vs 0.14 µVrms (D29) | Very sure |
| Reference routing | SRB1 | **SRB2, per channel** | SRB1 ties every N input together; with SRB2 one channel can run differential for ECG (X25) | High |
| Forehead contact | Hydrogel pad on a snap | **Flat Ag/AgCl + Ten20 paste in a snap socket** | Fp1 to Fpz is 26.9 mm on the 540 mm head; the budget's 32 × 25 mm pads would touch (L51). Wet Ag/AgCl is the reference standard. Small hydrogel discs stay a valid alternative | Medium |
| Electrode mounting | Fixed pods | **One 4 mm snap socket per site, swappable inserts** | Lets the team compare paste, semi-dry and dry on the same frame, as the test plan needs. Mixed contact types are fine with a high-impedance amplifier (L53, C03) | Engineering choice |
| Dry contacts | Not in the plan | **Test arms only (D30)** | Dry raised delta and theta against gel and lost more data (L19, L02); high impedance in warm rooms added slow noise (L46) | High-medium |
| Eye contact | Small gel pad | **Spare flat snap + paste, small ring** | The 32 × 25 mm budget pad would reach the lower eyelid at 20 mm below the eye. Uses a part already bought | Engineering choice |
| Power | MT3608 boost → 5 V LDO | **Cyton-style ±2.5 V, battery only** | Avoids a switching boost in front of the analog supply; matches the design being copied (X24) | Judgement call |
| Top arc | Fixed pods | **Sliding Fz and Pz mounts** | 10–20 sites scale with each head: nasion–inion 300–348 mm for 500–580 mm heads, so Fz moves ±7 mm and Pz ±17 mm | High (geometry) |
| Earlobe clip lead | Behind the ear | **In front of the ear** | Keeps it clear of the M1 pad | Engineering choice |
| Test kit | none | **ECG pads on ch 7, comparison inserts** | Validate earlobe PPG against ECG on our own sensor and site (D09) | High |

## On the page
**Top left · Mode:** *Product* is what a patient wears in a session. *Test kit* adds the ECG pads (ch 7) and an insert picker: forehead paste or dry flat; hair semi-dry, paste or dry spike. Test-only parts are labelled.

**Top right**
- **Display** menu: see-through shell, electronics only, labels, sizes (27 mm forehead spacing, Fz/Pz slide ranges), confidence colours, v2 behind-ear sites, all 77 10-10 sites.
- **Copy link** copies a link that opens exactly the current view: part, camera view, mode, inserts and overlays. Links from the start page look like `…/Neuryo-Headset/#v3/part=ref&view=side&show=v2`.
- **Details** panel:
  - **Parts**: every part; click for what it is, how sure the plan is, what to buy, and where its numbers come from.
  - **Build**: parts list matching the revised budget, wiring table (electrode → connector → ADS1299 pin; click a row to light up its lead with the see-through shell), and the tests in order with pass marks.
  - **Changes**: every change from v2 with the reason and how sure it is; click one to see it on the model.
  - **Specs** and **Sources**.
- **?** opens the how-to card (shown once on a first visit).

**Bottom bar:** camera views, explode, **Measure** (click two points for a straight-line distance), and **Guides** (electrode pod build, board guide).

**Keys:** 1–5 views · I see-through · E electronics · L labels · S sizes · C confidence · M measure · T test kit · Esc close.

## Budget notes (corrections to the 29 Oct review)
- **ADuM3160 is not needed for the prototype.** USB isolation only helps if the patient side has its own supply, and the TP4056 charger on the same USB-C port ties the board to the laptop's ground anyway (X23). Stream over Bluetooth; use USB only for charging and firmware with nothing attached to a person. Saves about ₹1,018.
- **Eye contact uses the spare TDE-211**, so no extra pad pack is needed.
- **Lead count:** 8 head contacts + 2 ECG = 10, exactly one FRI 10-pack, no spare.

## Model notes
- M1/M2 measured by `tools/mastoid.py`: halfway between ear-canal and earlobe height, 16 mm behind the back edge of the ear so a 25 mm pad clears it. Stored in `designs/shared/head/head.json` under `extra`.
- FRI does not publish TDE-211/212 dimensions. Disc (12 mm), stud (4 mm) and socket sizes are model estimates in the `DIM` object at the top of the page script: measure the real parts and update them.
- The front module, board outline and battery are still v1 shapes. The 8-input board is not designed yet; the board guide labels are v3 but part positions are estimates.
- ECG pad placement and lead routing are model estimates.

## Still to prove on real hardware
1. Contact on your own hair, oiled and washed: impedance every 15 min for 60 min, paste vs semi-dry vs dry spike at Fz/Pz, and paste vs dry flat at Fp1/Fp2.
2. Same-day and 1-week retest against the VIT wet cap (theta and alpha at Fp1, Fp2, Fz).
3. Earlobe PPG vs ECG on channel 7.
4. M1 vs TP9 on a few heads: pad adhesion and impedance through a session.
5. Noise floor with shorted inputs under 6 µVpp, on the Cyton-style supply.
