aryankalra404/Neuryo-Headset/designs/v1/index.html

Loading model…

NeuryoEEG + heart-rate headset

HeadSolidGhostHidden

Labels Details Try it on (https://aryankalra404.github.io/Neuryo-Headset/tryon.html) View in AR

×

View on its own

Show everything

PartsSpecsSources

EEG channels

4 · AF7, AF8, Fz, Pz

Reference

Both mastoids, linked

Ground (bias)

Fpz, centre forehead

Electrodes

Saline sponge on Ag/AgCl

Heart

Forehead PPG · HR, HRV, breathing

Sampling

250 samples/s · 24-bit

Wireless

Bluetooth LE

Battery

2000 mAh · ≥ 3 h target

Session

≈ 3 min setup + 2 min test

Front module

≈ 105 × 55 × 19 mm

Parts cost

≈ ₹10,700 per headset

Intended use

Tracks change across clinic visits. Research device; no diagnosis.

From the 26 Oct design doc. The module size is from this model. Mannequin: the shared Neuryo head (MakeHuman base mesh, CC0, 540 mm), with sites placed by the 10-20 rules; the mastoid pods sit 15 mm behind the standard TP9/TP10 point to clear its ear.

Every part card says where its details come from. Design doc: your 26 Oct NeuroRipple design doc. Model estimate: a shape or size the doc doesn’t give, worked out to make the parts fit; check before building. Added: a build detail not in the doc, backed by the source below.

Added build details

- Seal the solder joint; choose sintered Ag/AgCl. In saline, sintered Ag/AgCl had the most stable potential and lowest noise; tin (the main metal in solder) corroded and had noise 1–2 orders of magnitude higher. Alves, Fiedler & Fonseca, Coatings 2026 (https://doi.org/10.3390/coatings16070781)
- Hole in the electrode for saline. Standard EEG cups have “a hole in the top for electrolyte injection.” Electrode Store, GH series (https://electrodestore.com/products/gh)
- Blot excess saline. Electrolyte spreading between electrodes forms bridges that shrink the signal; remove excess before recording. Greischar et al., Clin. Neurophysiol. 2004 (https://doi.org/10.1016/j.clinph.2003.10.028)
- Sliding pod mounts. 10–20 sites are set at 10% and 20% steps of each person’s own nasion–inion distance, so fixed spacing can’t fit every head. 10–20 system (after Jasper 1958) (https://en.wikipedia.org/wiki/10%E2%80%9320_system_(EEG))

Ideas for the team (not in the model)

- Smaller front module: ESP32-S3-MINI-1 is 15.4 × 20.5 × 2.4 mm vs 18 × 25.5 × 3.1 mm, but has 2 MB PSRAM instead of 8 MB. Espressif datasheet (https://documentation.espressif.com/esp32-s3-mini-1_mini-1u_datasheet_en.pdf)
- Heart sensor pressure: PPG amplitude rises steadily with contact pressure, so keep strap pressure consistent and test it. Bangari et al., SPIE 2026 (https://doi.org/10.1117/12.3091708)

← Headset

TipDomeFingersFlat

Cutaway Show underside

BackNext
