aryankalra404/Neuryo-Headset/designs/v2/index.html

Loading model…

Neuryo v229 Oct research plan · 6-channel EEG + heart-rate headset

HeadSolidGhostHidden

Labels All sites Details View in AR

×

View on its own

Show everything

PartsSpecsSources

EEG channels

6 · Fp1, Fp2, Fz, Pz, TP10, eye (VEOG)

Reference

TP9 alone on SRB1. Linked mastoids only in software (D06, D25)

Bias (DRL)

Fpz, centre forehead

Contact metal

Ag/AgCl at every site (D07)

Forehead

Flat Ag/AgCl snap + hydrogel pad (Fp1, Fp2, Fpz)

In hair

Semi-dry: PVA sponge fed by a saline reservoir (Fz, Pz)

Ear + eye

Disposable adhesive gel Ag/AgCl (TP9, TP10, VEOG)

Heart

MAX30102 in an earlobe clip · pulse-rate variability (D22, D09)

EEG chip

ADS1299-6 (or 8-channel part, 2 spare)

Main recording

Eyes-closed rest block (D28)

Contact check

Impedance between blocks only (D27)

Fit

Fitted frame for 500–580 mm heads, no loose straps (D19)

Sampling

250 samples/s · 24-bit (from v1)

Wireless

Bluetooth LE (from v1)

Battery

2000 mAh (from v1)

Intended use

Tracks change in the same patient across visits. Monitoring aid, not diagnosis (D01).

From the 29 Oct research plan (Neuryo-Research, 00-montage-options.md). D numbers are decisions in 00-decisions.md. Module, board layout and battery are carried over from v1 and not yet redesigned.

Every part card says where it comes from. Plan: the 29 Oct research plan, with decision (D) and evidence IDs from the Neuryo-Research library. From v1: kept from the 26 Oct design doc. Model estimate: a shape or size worked out to make parts fit; check before building.

Why these sites

- Fp1 and Fp2 (D13). A week-1 drop in prefrontal theta cordance predicted antidepressant response (Fp1, Fpz, Fp2; and Fp1, Fp2, Fz). Am J Psychiatry 2006 (https://ajp.psychiatryonline.org/doi/10.1176/ajp.2006.163.8.1426) · Brunovsky 2019 (https://em-consulte.com/article/1299706/article/comparable-efficacy-of-prefrontal-theta-cordance-i) · Srivastava 2026 meta-analysis (https://journals.sagepub.com/doi/xml/10.1177/02537176241271716)
- Pz for P300 (D08). The FDA-cleared UB ERP system records Fp1, Fp2, F3, F4, Fz, Cz, Pz with an earlobe reference and gel EOG. FDA K253767 (https://www.accessdata.fda.gov/cdrh_docs/pdf25/K253767.pdf)
- No AF7/AF8 (D24). Muse temporal channels were unusable in 17 of 19 recordings while its indicator showed green; frontal agreement was weak. Mikhaylov 2024 (https://pmc.ncbi.nlm.nih.gov/articles/PMC11679099)
- Eye channel (D26). EOG regression needs a reference channel; ICA can’t run on few channels. Jiang 2019 (https://www.mdpi.com/1424-8220/19/5/987)

Reference and bias

- No hardware-linked mastoids (D06, D25). Linking ears online bridges the hemispheres; average and REST need far more channels. Yao 2019 (https://link.springer.com/10.1007/s10548-019-00707-x)
- Contact check between blocks (D27). ADS1299 AC lead-off runs at 7.8 or 31.2 Hz, inside the EEG band. TI ADS1299 datasheet (https://www.ti.com/lit/ds/symlink/ads1299.pdf)

Electrodes

- Ag/AgCl (D07). Lowest drift and noise; gold, tin and steel drifted far more. Alves 2026 (https://www.mdpi.com/2079-6412/16/7/781)
- No plain sponges (D21). Saline sponge impedance rose after about 20 min without rewetting. Krishnan 2019 (https://www.andrew.cmu.edu/user/skkelly/Papers/Krishnan_Hydration_BioCAS_2019.pdf)
- Semi-dry in hair. Under 40 kΩ for 5 h, 23.89 kΩ at hairy Oz. Hua 2019 (https://www.mdpi.com/2072-666X/10/8/518) · PVA/PAM 18.2 kΩ on hair. Li 2024 (https://doaj.org/article/3ff8871db978483683c420e4b16df287)

Heart sensor and fit

- Earlobe PPG (D22). Earlobe PRV vs ECG HRV r > 0.92 at rest. Vescio 2018 (https://www.mdpi.com/1424-8220/18/3/844) · earlobe and finger closest to ECG. Mejía-Mejía 2020 (https://www.frontiersin.org/journals/physiology/articles/10.3389/fphys.2020.00779/pdf)
- Fitted frame (D19). Re-placement 3.0 mm with a fitted cap vs 9.8 mm with straps. Hunold 2020 (https://link.springer.com/10.1186/s12938-020-00792-1) · Indian adult head circumference 499–578 mm. Shah 2018 (https://proc.3dbody.tech/papers/2018/18114shah.pdf)

Mannequin

- Head, ears, neck. MakeHuman base mesh, released under CC0. Scaled to a 540 mm head circumference, the middle of Indian adult male (548 mm) and female (532 mm) means. MakeHuman (https://github.com/makehumancommunity/makehuman) · Shah 2018 (https://proc.3dbody.tech/papers/2018/18114shah.pdf)
- Electrode sites measured on this head with the 10-20 rules: nasion to inion, ear to ear over Cz, and the circumference. TP9 and TP10 moved back along their ring to clear this mannequin’s ear.

Still to prove on this hardware

- Same-day and 1-week test-retest against a wet cap.
- Impedance over 60 min on Indian hair, oiled and washed (decides forehead and hair-site electrode type).
- 3-electrode cordance vs full-cap cordance (D18). Earlobe PPG vs ECG.

← Headset

TipDomeFingers

Cutaway Show underside

BackNext
