aryankalra404/Neuryo-Headset/designs/v7/revb-bottom.jpg

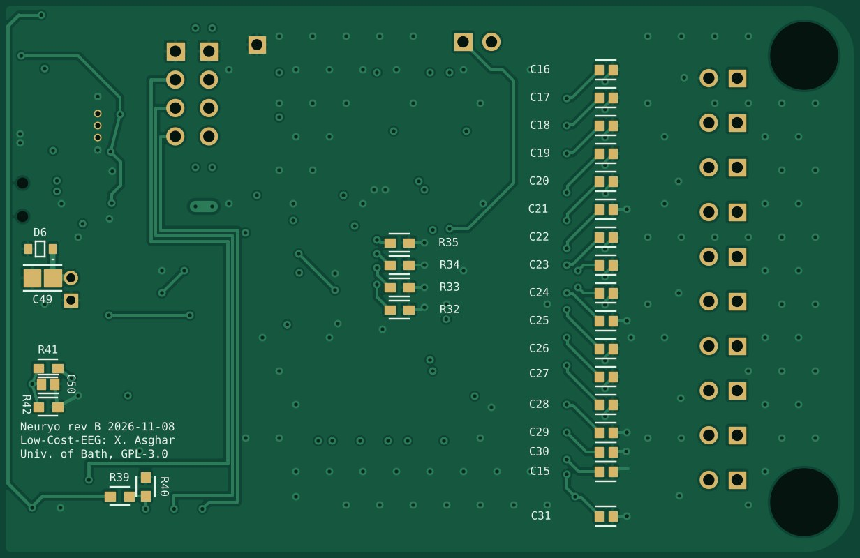
designs/v7/revb-bottom.jpg
