aryankalra404/Neuryo-Headset/designs/v7/revb-top.jpg

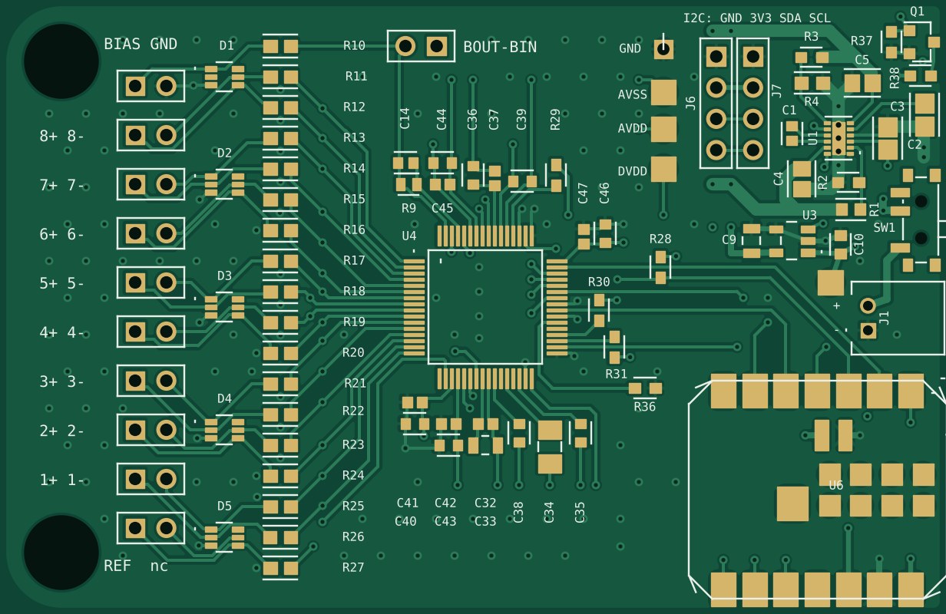
designs/v7/revb-top.jpg
