aryankalra404/Neuryo-Headset/pcb/neuryo-rev-b/review/baseline/bottom.png

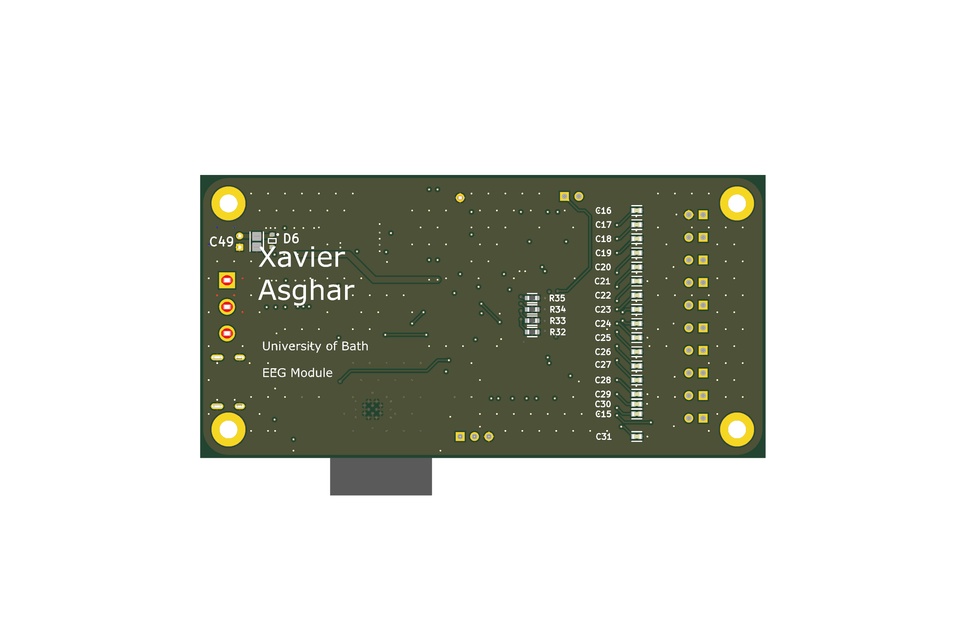
pcb/neuryo-rev-b/review/baseline/bottom.png
