aryankalra404/Neuryo-Headset/pcb/neuryo-rev-b/review/baseline/top.png

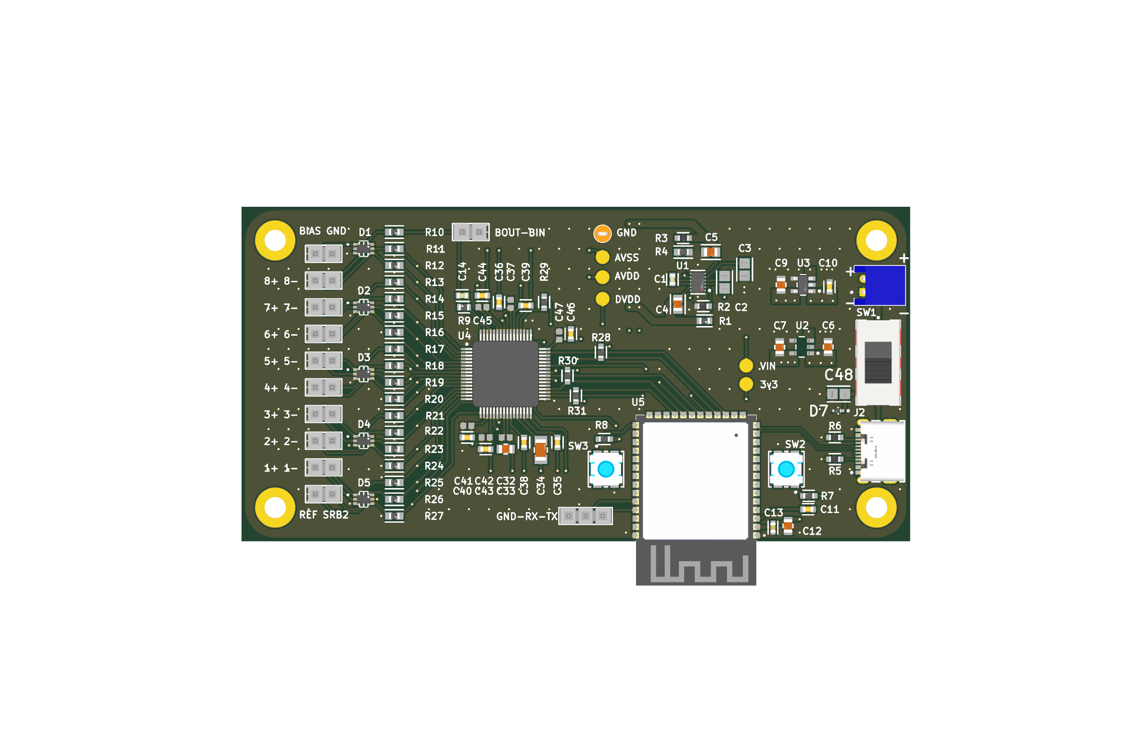
pcb/neuryo-rev-b/review/baseline/top.png
