aryankalra404/Neuryo-Headset/pcb/low-cost-eeg/Production_Files/PCB Bill of Materials.xlsx

Line # | Name | Description | Designator | Quantity | Manufacturer 1 | Manufacturer Part Number 1 | Supplier 1 | Supplier Part Number 1 | Supplier Unit Price 1 | Supplier Subtotal 1
 | C0603C474K4RACAUTO | Cap Ceramic 0.47uF 16V X7R 10% Pad SMD 0603 125C Automotive T/R | C1 | 1 | Yageo Group | C0603C474K4RACAUTO | Mouser | 80-C0603C474K4RAUTO | 0.32434 | 0.32434
 | GCJ21BR71C475KA01K | Multilayer Ceramic Capacitors MLCC - SMD/SMT 0805 4.7uF 10%, 16VDC, X7R 15% | C2, C3, C48, C49 | 4 | Murata | GCJ21BR71C475KA01K | Mouser | 81-GCJ21BR71C475KA1K | 0.27909 | 1.12
 | GCM21BR71C225KA64K | Ceramic Capacitor for Automotive 2.2uF ±10% 16VDC X7R 0805 Embossed T/R | C4, C5 | 2 | Murata | GCM21BR71C225KA64K | Mouser | 81-GCM21BR71C225KA4K | 0.16594 | 0.33189
 | GRJ21BR61E106KE01L | CAP CER MLCC | C6, C7, C9, C12, C33 | 5 | Murata | GRJ21BR61E106KE01L | Mouser | 81-GRJ21BR61E106KE1L | 0.05129 | 0.51291
 | CC0603KRX7R7BB105 | CAP CER 1UF 16V X7R 0603 | C10, C11, C35, C36, C38, C39, C40, C43, C44, C46 | 10 | Yageo Group | CC0603KRX7R7BB105 | Mouser | 603-CC603KRX7R7BB105 | 0.03696 | 0.3696
 | CGA3E2X7R1H104K080AD | Cap Ceramic 100nF 50V X7R 10% Pad SMD 0603 +125°C Automotive T/R | C13 | 1 | TDK | CGA3E2X7R1H104K080AD | Mouser | 810-C1608X7R1H104KEP | 0.09051 | 0.09051
 | C0603C152J1GACTU | CAP CER 1500PF 100V NP0 0603 | C14 | 1 | Murata | GRM1885C2A152JA01D | Mouser | 81-GRM1885C2A152JA1D | 0.07543 | 0.07543
 | C0603C102F5GACTU | CAP CER 1000PF 50V 1% NP0 0603 | C15, C16, C17, C18, C19, C20, C21, C22, C23, C24, C25, C26, C27, C28, C29, C30, C31 | 17 | Yageo Group | C0603C102F5GACTU | Mouser | 80-C0603C102F5G | 0.44578 | 7.58
 | C0603X104J4RACTU |  | C32, C37, C41, C42, C45, C47 | 6 | Yageo Group | C0603X104J4RACTU | Mouser | 80-C0603X104J4R | 0.10485 | 1.05
 | GRM31CR61A107MEA8L | Chip Multilayer Ceramic Capacitors for General Purpose, 1206, 100uF, X5R, 15%, 20%, 10V | C34 | 1 | Murata | GRM31CR61A107MEA8L | Mouser | 81-GRM31CR61A107MA8L | 0.35451 | 0.35451
 | TPD4E1B06DCKR | Quad 0.7-pF, Â±5.5-V, Â±12-kV ESD protection diode with 0.5-nA max leakage in SOT & SC70 packages | D1, D2, D3, D4, D5 | 5 | Texas Instruments | TPD4E1B06DCKR | Mouser | 595-TPD4E1B06DCKR | 0.72411 | 3.62
 | SD05T1G | Transient Voltage Suppressor Diode, for ESD Protection, 2-Pin SOD-323, Pb-Free, Tape and Reel | D6 | 1 | onsemi | SD05T1G | Mouser | 863-SD05T1G | 0.33189 | 0.33189
 | ESD5Z5.0T5G | ESD5Z5.0T5G Trans Voltage Suppressor Diode, 174W, 5V V(RWM), Unidirectional, 1 Element, Silicon | D7 | 1 | onsemi | ESD5Z5.0T5G | Mouser | 863-ESD5Z5.0T5G | 0.17349 | 0.17349
 | S2B-PH-K-S(LF)(SN) | Male Header, Pitch 2 mm, 1 x 2 Position, Height 4.8 mm, Tail Length 3.4 mm, -25 to 85 degC, RoHS, Bulk | J1 | 1 | JST | S2B-PH-K-S(LF)(SN) | Arrow Electronics | S2B-PH-K-S(LF)(SN) | 0.07596 | 0.07596
 | 217179-0001 | CONN RCP USB2.0 TYP C 24P SMD RA | J2 | 1 | Molex | 217179-0001 | Mouser | 538-217179-0001 | 0.62606 | 0.62606
 | TSW-102-26-F-S | 0.025" SQ Post Header, Through-hole, Vertical, -55 to 125 degC, 2.54 mm Pitch, 2-Pin, Male, RoHS | J3A, J3B, J3C, J3D, J3E, J3F, J3G, J3H, J3I, J3J, JP1 | 11 | Samtec | TSW-102-26-F-S | Mouser | 200-TSW10226FS | 0.23383 | 2.57
 | TSW-103-07-T-S | 0.025" SQ Post Header, Through-hole, Vertical, -55 to 105 degC, 2.54 mm Pitch, 3-Pin, Male, RoHS | J5 | 1 | Samtec | TSW-103-07-T-S | Mouser | 200-TSW10307TS | 0.09806 | 0.09806
 | MCT06030D1303BP100 | RES SMD 100 OHM 1% 1/8W 0603 | R1 | 1 | Vishay | MCT06030D1303BP100 | Mouser | 594-MCT06030D1303BP1 | 0.43749 | 0.43749
 | RT0603BRD07120KL | RES SMD 120K OHM 0.1% 1/10W 0603 | R2 | 1 | Yageo Group | RT0603BRD07120KL | Mouser | 603-RT0603BRD07120KL | 0.1056 | 0.1056
 | RT0603BRD07105KL | RES SMD 105K OHM 0.1% 1/10W 0603 | R3 | 1 | Yageo Group | RT0603BRD07105KL | Mouser | 603-RT0603BRD07105KL | 0.18857 | 0.18857
 | AT0603BRD07100KL | Thin Film Chip Resistors Automotive Grade 100kΩ 0.1% 25ppm/°C 0603 | R4 | 1 | Yageo Group | AT0603BRD07100KL | Mouser | 603-AT0603BRD07100KL | 0.24137 | 0.24137
 | RT0603FRE075K1L | RES SMD 5.1K OHM 1% 1/10W 0603 | R5, R6 | 2 | Yageo Group | RT0603FRE075K1L | Mouser | 603-RT0603FRE075K1L | 0.00603 | 0.06034
 | AC0603FR-7W10KL | RES 10kΩ 1.00% 0.2W 0603 | R7, R8, R28, R29, R30, R31, R32, R33, R34, R35 | 10 | Yageo Group | AC0603FR-7W10KL | Mouser | 603-AC0603FR-7W10KL | 0.0083 | 0.08297
 | MCT06030C1004FPW00 | RES SMD 100 OHM 1% 1/8W 0603 | R9 | 1 | Vishay | MCT06030C1004FPW00 | Mouser | 594-MCT06030C1004FPW | 0.09051 | 0.09051
 | MCT06030D2201BP500 | RES SMD 100 OHM 1% 1/8W 0603 | R10, R11, R12, R13, R14, R15, R16, R17, R18, R19, R20, R21, R22, R23, R24, R25, R26, R27 | 18 | Vishay | MCT06030D2201BP500 | Mouser | 594-MCT06030D2201BP5 | 0.05959 | 1.07
 | 1101M2S3CQE2 | SWITCH SLIDE SPDT 6A 120V | SW1 | 1 | C&K Components | 1101M2S3CQE2 | Mouser | 611-1101M2S3CQE2 | 4.19 | 4.19
 | 7914J-1-032 | SWITCH TACTILE SPST-NO 0.1A 16V | SW2, SW3 | 2 | Bourns | 7914J-1-032 | Mouser | 652-7914J-1-032 | 0.79954 | 1.6
 | 5003 | Test Point, Orange, 1-Pin THD, RoHS | TP1 | 1 | Keystone | 5003 | Mouser | 534-5003 | 0.25646 | 0.25646
 | TP | 2mm diameter circular test point, | TP2, TP3, TP4, TP5, TP6 | 5
 | LM27762DSSR | IC REG CHARGE PUMP ADJ DL 12WSON | U1 | 1 | Texas Instruments | LM27762DSSR | Mouser | 595-LM27762DSSR | 1.55 | 1.55
 | TLV75733PDBVR | IC REG LINEAR 3.3V 1A SOT23-5 | U2 | 1 | Texas Instruments | TLV75733PDBVR | Mouser | 595-TLV75733PDBVR | 0.24891 | 0.24891
 | TPS7A2033PDBVR | IC REG LINEAR 3.3V 300MA SOT23-5 | U3 | 1 | Texas Instruments | TPS7A2033PDBVR | Mouser | 595-TPS7A2033PDBVR | 0.24137 | 0.24137
 | ADS1299IPAGR | Low-Noise, 8-Channel, 24-Bit Analog Front-End for Biopotential Measurement, 16 KSPS, -40 to 85 degC, 64-Pin PQFP (PAG-64), RoHS, Tape and Reel | U4 | 1 | Texas Instruments | ADS1299IPAGR | Mouser | 595-ADS1299IPAGR | 64.87 | 64.87
 | ESP32-S3-WROOM-1-N8R8 | Bluetooth, WiFi 802.11b/g/n, Bluetooth v5.0 Transceiver Module 2.4GHz PCB Trace Surface Mount | U5 | 1 | Espressif | ESP32-S3-WROOM-1-N8R8 | Mouser | 356-EP32S3WROOM1N8R8 | 4.68 | 4.68
