aryankalra404/Neuryo-Headset/pcb/neuryo-rev-b/review/fab-draft-do-not-order/bom-jlc.csv

Comment | Designator | Footprint | Quantity | MPN | LCSC Part # | Note
0.47uF | C1 | FP-C0603C-CF-MFG | 1 | KEMET C0603C474K4RACAUTO | C561783
4.7uF | C2, C3, C49 | FP-GCJ21B-0_3-IPC_A | 3 | Samsung CL21B475KOFNNNE | C107365 | In-stock equivalent (same value, tolerance, case) of the reference Murata GCJ21BR71C475KA01K
2.2uF | C4, C5 | FP-GCM21B-0_15-IPC_B | 2 | Murata GCM21BR71C225KA64K | C1852484
10uF | C9, C33 | FP-GRJ21B-0_3-0_2-MFG | 2 | Samsung CL21A106KAYNNNE | C15850 | In-stock equivalent (same value, tolerance, case) of the reference Murata GRJ21BR61E106KE01L
1uF | C10, C35, C36, C38, C39, C40, C43, C44, C46 | FP-CC0603-DA-MFG | 9 | Yageo CC0603KRX7R7BB105 | C106248
1.5nF | C14 | FP-C0603C-CF-MFG | 1 | Murata GRM1885C1H152JA01D | C162204 | In-stock equivalent (same value, tolerance, case) of the reference Murata GRM1885C2A152JA01D
1nF | C15, C16, C17, C18, C19, C20, C21, C22, C23, C24, C25, C26, C27, C28, C29, C30, C31 | FP-C0603C-CF-MFG | 17 | Murata GRM1885C1H102FA01D | C913702 | In-stock equivalent (same value, tolerance, case) of the reference Yageo C0603C102F5GACTU
0.1uF | C32, C37, C41, C42, C45, C47 | CAPC1608X87X45LL20T05 | 6 | KEMET C0603C104J4RACTU | C22401913 | In-stock equivalent (same value, tolerance, case) of the reference Yageo C0603X104J4RACTU
100uF | C34 | FP-GRM31C-0_3-e0_3_0_8-IPC_B | 1 | Murata GRM31CR61A107MEA8L | C883598
0.1uF | C50 | FP-C0603C-CF-MFG | 1 | YAGEO CC0603KRX7R9BB104 | C14663
TPD4E1B06DCKR | D1, D2, D3, D4, D5 | TVS_TPD4E1B06DCKR | 5 | Texas Instruments TPD4E1B06DCKR | C840093
SD05T1G | D6 | ONSC-SOD-323-2-477-02_G_V | 1 | onsemi SD05T1G | C233423
2N7002 | Q1 | SOT-23 | 1 | Nexperia 2N7002,215 | C65189
130k | R1 | FP-MCT0603-IPC_B | 1 | Yageo RT0603BRD07130KL | C861109 | In-stock equivalent (same value, tolerance, case) of the reference Vishay MCT06030D1303BP100
120k | R2 | FP-RT0603-MFG | 1 | Yageo RT0603BRD07120KL | C705720
105k | R3 | FP-RT0603-MFG | 1 | Yageo RT0603BRD07105KL | C861072
100k | R4 | FP-AT0603-IPC_A | 1 | Yageo AT0603BRD07100KL | C855559
1M | R9 | FP-MCT0603-MFG | 1 | UNI-ROYAL 0603WAF1004T5E | C22935 | In-stock equivalent (same value, tolerance, case) of the reference Vishay MCT06030C1004FPW00
51k | R10 | FP-MCT0603-IPC_A | 1 | Yageo RT0603BRD0751KL | C861458 | In-stock equivalent (same value, tolerance, case) of the reference Vishay MCT06030D5102BP500
2.2k | R11, R12, R13, R14, R15, R16, R17, R18, R19, R20, R21, R22, R23, R24, R25, R26, R27 | FP-MCT0603-IPC_A | 17 | Yageo RT0603BRD072K2L | C861295 | In-stock equivalent (same value, tolerance, case) of the reference Vishay MCT06030D2201BP500
10k | R28, R29, R30, R31, R32, R33, R34, R35 | FP-AC0603-MFG | 8 | UNI-ROYAL 0603WAF1002T5E | C25804 | JLCPCB Basic equivalent (10k 1% 0603 thick film) of the reference Yageo AC0603FR-7W10KL
10k | R36, R37 | FP-AC0603-MFG | 2 | UNI-ROYAL 0603WAF1002T5E | C25804
100k | R38, R39 | FP-AC0603-MFG | 2 | UNI-ROYAL 0603WAF1003T5E | C25803
150k | R40 | FP-AC0603-MFG | 1 | UNI-ROYAL 0603WAF1503T5E | C22807
220k | R41, R42 | FP-AC0603-MFG | 2 | UNI-ROYAL 0603WAF2203T5E | C22961
330 | R43, R44, R45 | FP-AC0603-MFG | 3 | UNI-ROYAL 0603WAF3300T5E | C23138
4.7k | R46, R47 | FP-AC0603-MFG | 2 | UNI-ROYAL 0603WAF4701T5E | C23162
PCM12SMTR | SW1 | SW_SPDT_PCM12 | 1 | C&K PCM12SMTR | C221841
LM27762DSSR | U1 | FP-DSS0012B-MFG | 1 | Texas Instruments LM27762DSSR | C473398
TPS7A2033PDBVR | U3 | FP-DBV0005A-MFG | 1 | Texas Instruments TPS7A2033PDBVR | C2862740
ADS1299IPAGR | U4 | PAG0064A_M | 1 | Texas Instruments ADS1299IPAGR | C476817
