aryankalra404/Neuryo-Headset/pcb/neuryo-rev-b/review/fab-draft-do-not-order/bom.csv

Refs | Value | Footprint | Qty | DNP
C1 | 0.47uF | Low_Cost_EEG-import-fps:FP-C0603C-CF-MFG | 1
C2 | 4.7uF | Low_Cost_EEG-import-fps:FP-GCJ21B-0_3-IPC_A | 1
C3 | 4.7uF | Low_Cost_EEG-import-fps:FP-GCJ21B-0_3-IPC_A | 1
C4 | 2.2uF | Low_Cost_EEG-import-fps:FP-GCM21B-0_15-IPC_B | 1
C5 | 2.2uF | Low_Cost_EEG-import-fps:FP-GCM21B-0_15-IPC_B | 1
C9 | 10uF | Low_Cost_EEG-import-fps:FP-GRJ21B-0_3-0_2-MFG | 1
C10 | 1uF | Low_Cost_EEG-import-fps:FP-CC0603-DA-MFG | 1
C14 | 1.5nF | Low_Cost_EEG-import-fps:FP-C0603C-CF-MFG | 1
C15 | 1nF | Low_Cost_EEG-import-fps:FP-C0603C-CF-MFG | 1
C16 | 1nF | Low_Cost_EEG-import-fps:FP-C0603C-CF-MFG | 1
C17 | 1nF | Low_Cost_EEG-import-fps:FP-C0603C-CF-MFG | 1
C18 | 1nF | Low_Cost_EEG-import-fps:FP-C0603C-CF-MFG | 1
C19 | 1nF | Low_Cost_EEG-import-fps:FP-C0603C-CF-MFG | 1
C20 | 1nF | Low_Cost_EEG-import-fps:FP-C0603C-CF-MFG | 1
C21 | 1nF | Low_Cost_EEG-import-fps:FP-C0603C-CF-MFG | 1
C22 | 1nF | Low_Cost_EEG-import-fps:FP-C0603C-CF-MFG | 1
C23 | 1nF | Low_Cost_EEG-import-fps:FP-C0603C-CF-MFG | 1
C24 | 1nF | Low_Cost_EEG-import-fps:FP-C0603C-CF-MFG | 1
C25 | 1nF | Low_Cost_EEG-import-fps:FP-C0603C-CF-MFG | 1
C26 | 1nF | Low_Cost_EEG-import-fps:FP-C0603C-CF-MFG | 1
C27 | 1nF | Low_Cost_EEG-import-fps:FP-C0603C-CF-MFG | 1
C28 | 1nF | Low_Cost_EEG-import-fps:FP-C0603C-CF-MFG | 1
C29 | 1nF | Low_Cost_EEG-import-fps:FP-C0603C-CF-MFG | 1
C30 | 1nF | Low_Cost_EEG-import-fps:FP-C0603C-CF-MFG | 1
C31 | 1nF | Low_Cost_EEG-import-fps:FP-C0603C-CF-MFG | 1
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
R35 | 10k | Low_Cost_EEG-import-fps:FP-AC0603-MFG | 1
R36 | 10k | Low_Cost_EEG-import-fps:FP-AC0603-MFG | 1
R37 | 10k | Low_Cost_EEG-import-fps:FP-AC0603-MFG | 1
R38 | 100k | Low_Cost_EEG-import-fps:FP-AC0603-MFG | 1
R39 | 100k | Low_Cost_EEG-import-fps:FP-AC0603-MFG | 1
R40 | 150k | Low_Cost_EEG-import-fps:FP-AC0603-MFG | 1
R41 | 220k | Low_Cost_EEG-import-fps:FP-AC0603-MFG | 1
R42 | 220k | Low_Cost_EEG-import-fps:FP-AC0603-MFG | 1
R43 | 330 | Low_Cost_EEG-import-fps:FP-AC0603-MFG | 1
R44 | 330 | Low_Cost_EEG-import-fps:FP-AC0603-MFG | 1
R45 | 330 | Low_Cost_EEG-import-fps:FP-AC0603-MFG | 1
R46 | 4.7k | Low_Cost_EEG-import-fps:FP-AC0603-MFG | 1
R47 | 4.7k | Low_Cost_EEG-import-fps:FP-AC0603-MFG | 1
SW1 | PCM12SMTR | Neuryo_RevB:SW_SPDT_PCM12 | 1
TP1 |  | Low_Cost_EEG-import-fps:KSTN-5003 | 1
TP2 | TP | Low_Cost_EEG-import-fps:TP_SMD_2mm | 1
TP3 | TP | Low_Cost_EEG-import-fps:TP_SMD_2mm | 1
TP4 | TP | Low_Cost_EEG-import-fps:TP_SMD_2mm | 1
TP6 | TP | Low_Cost_EEG-import-fps:TP_SMD_2mm | 1
U1 | LM27762DSSR | Low_Cost_EEG-import-fps:FP-DSS0012B-MFG | 1
U3 | TPS7A2033PDBVR | Low_Cost_EEG-import-fps:FP-DBV0005A-MFG | 1
U4 | ADS1299IPAGR | Low_Cost_EEG-import-fps:PAG0064A_M | 1
U6 | XIAO ESP32-S3 | Neuryo_RevB:XIAO-ESP32-S3-SMD | 1
