aryankalra404/Neuryo-Headset/designs/uc-adapter/stl/node-ring.stl

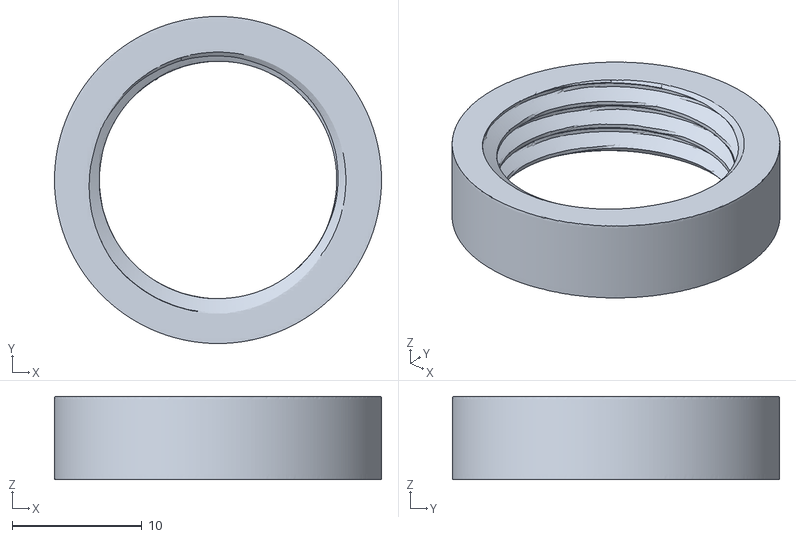
[picture p63: CAD file, 2026-11-07]
designs/uc-adapter/stl/node-ring.stl
25.2 x 25.2 x 6.40
