aryankalra404/Neuryo-Headset/designs/v7/stl/pod-body.stl

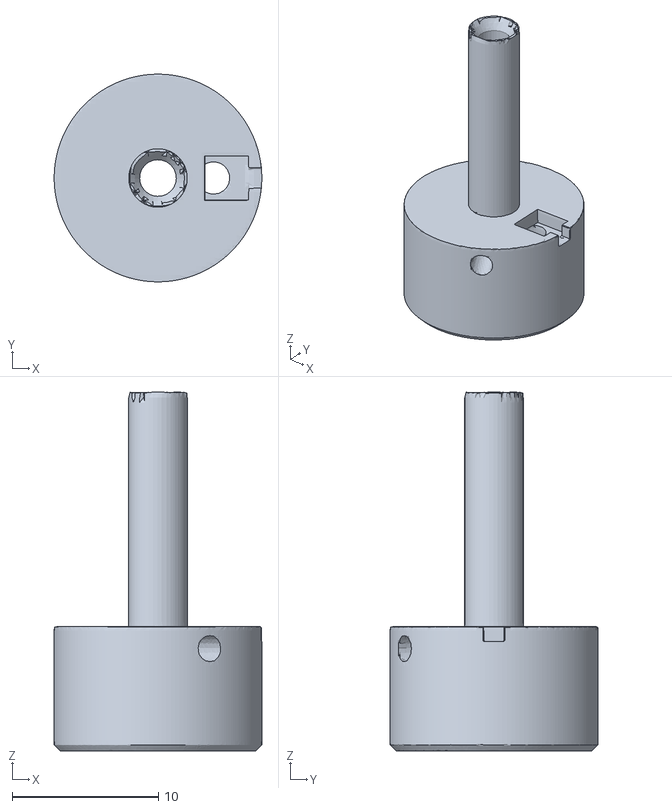
[picture p64: CAD file, 2026-11-11]
designs/v7/stl/pod-body.stl
14.2 x 14.2 x 24.5
