aryankalra404/Neuryo-Headset/pcb/low-cost-eeg/Hardware/Enclosure_Inventor_Project/Enclosure_Top.stp

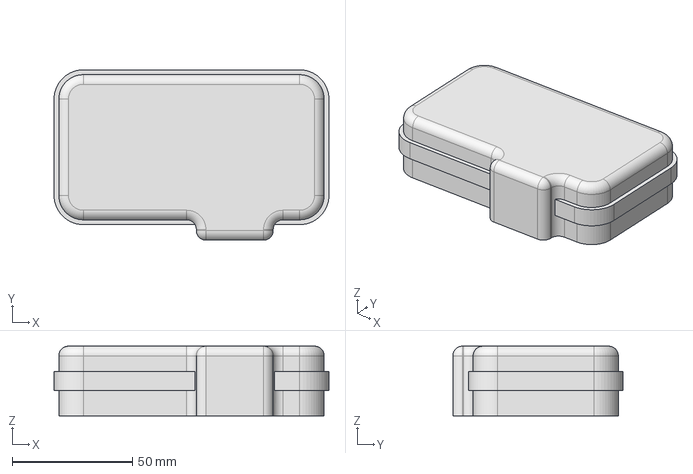
[picture p65: CAD file, 2026-11-08]
pcb/low-cost-eeg/Hardware/Enclosure_Inventor_Project/Enclosure_Top.stp
114.4 x 70.9 x 29.0 mm
