aryankalra404/Neuryo-Headset/designs/uc-adapter/stl/pod-body.stl

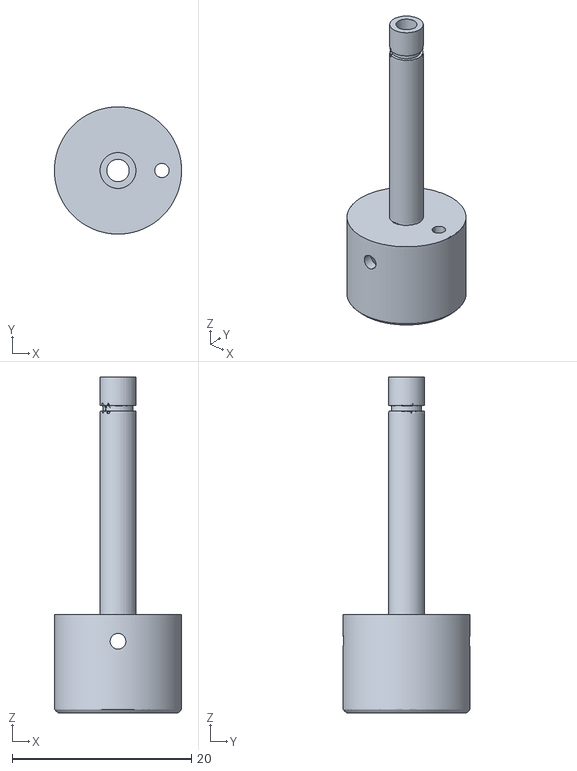
[picture p66: CAD file, 2026-11-07]
designs/uc-adapter/stl/pod-body.stl
14.2 x 14.2 x 37.5
