aryankalra404/Neuryo-Headset/designs/v7/stl/stud-puck.stl

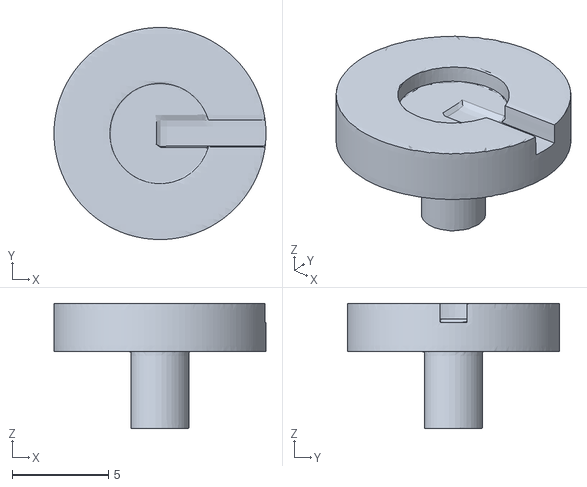
[picture p67: CAD file, 2026-11-11]
designs/v7/stl/stud-puck.stl
11.0 x 11.0 x 6.50
