aryankalra404/Neuryo-Headset/pcb/low-cost-eeg/Hardware/Enclosure_Inventor_Project/Enclosure Bottom.stp

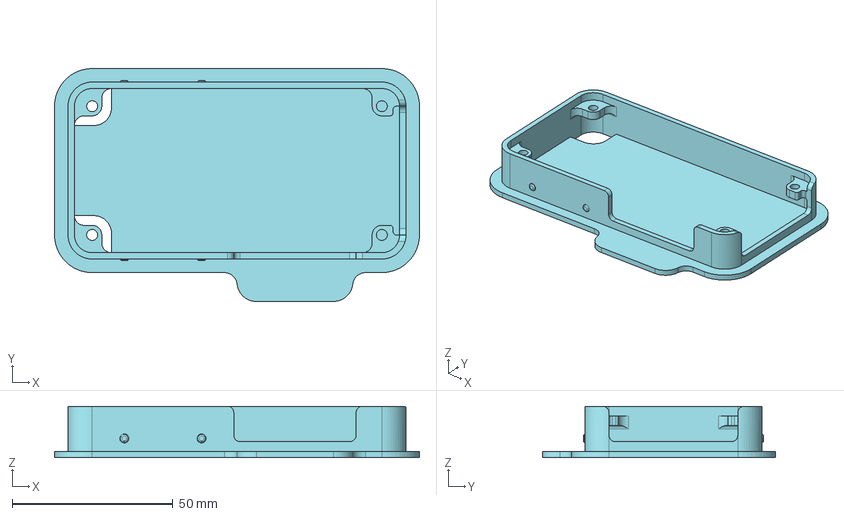
[picture p68: CAD file, 2026-11-08]
pcb/low-cost-eeg/Hardware/Enclosure_Inventor_Project/Enclosure Bottom.stp
113.4 x 72.4 x 16.0 mm
