aryankalra404/Neuryo-Headset/designs/uc-adapter/stl/pod-tube.stl

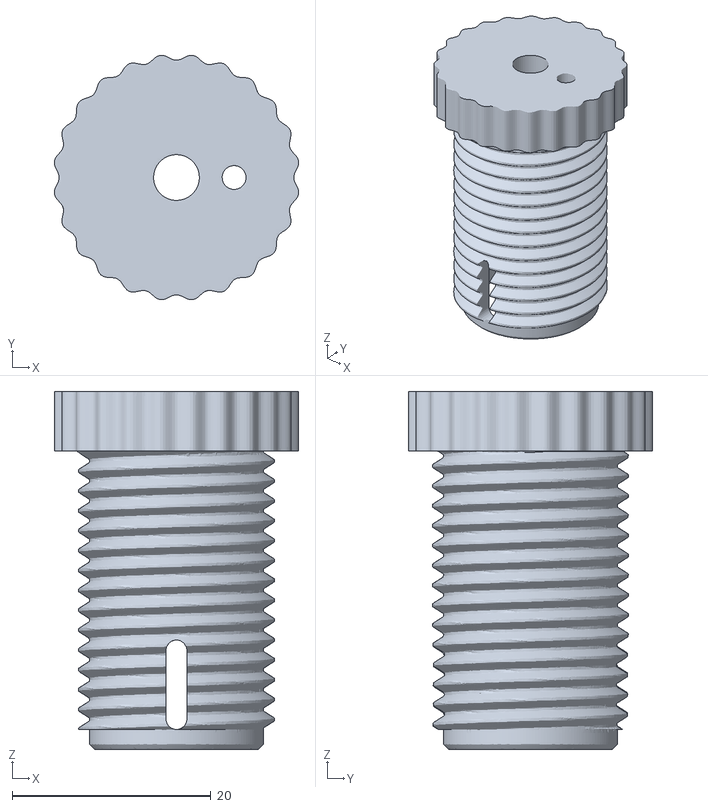
[picture p69: CAD file, 2026-11-07]
designs/uc-adapter/stl/pod-tube.stl
24.6 x 24.6 x 36.0
