aryankalra404/Neuryo-Headset/designs/v7/stl/bore-test.stl

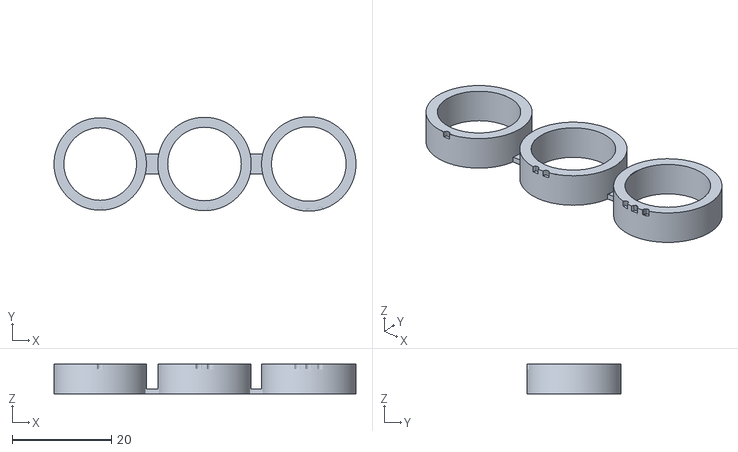
[picture p70: CAD file, 2026-11-11]
designs/v7/stl/bore-test.stl
60.8 x 19.0 x 6.00
