aryankalra404/Neuryo-Headset/designs/uc-adapter/stl/tip-collar.stl

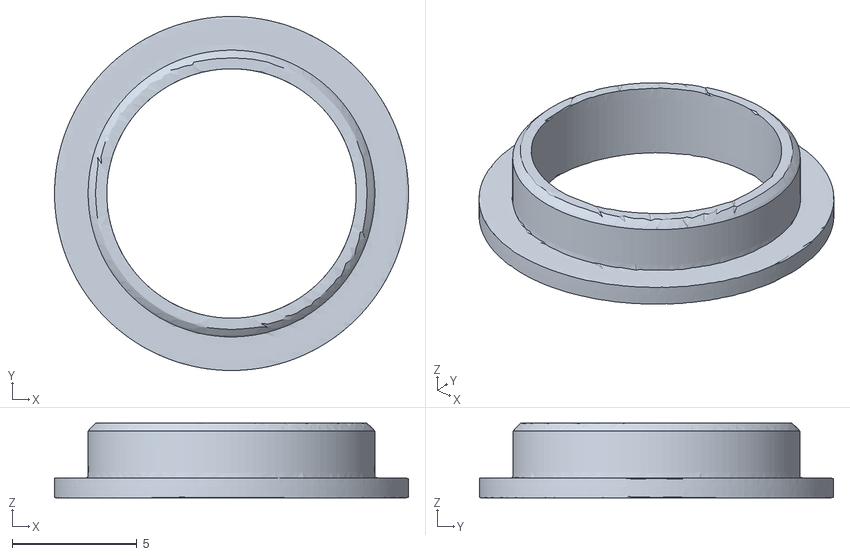
[picture p71: CAD file, 2026-11-07]
designs/uc-adapter/stl/tip-collar.stl
14.2 x 14.2 x 3.00
