aryankalra404/Neuryo-Headset/designs/v7/stl/pod-body-rig.stl

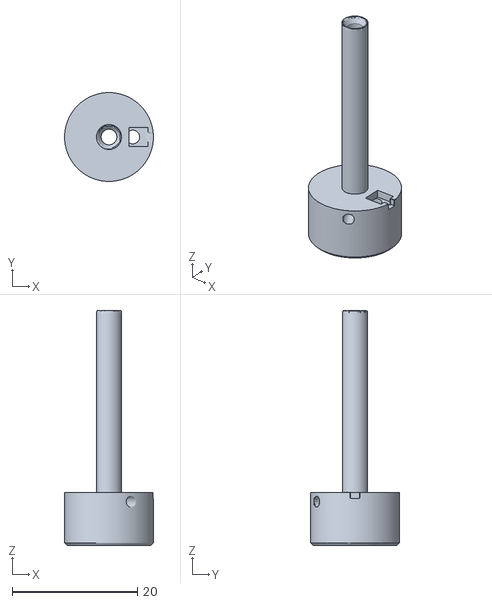
[picture p72: CAD file, 2026-11-11]
designs/v7/stl/pod-body-rig.stl
14.2 x 14.2 x 37.6
