aryankalra404/Neuryo-Headset/designs/v7/stl/tip-collar.stl

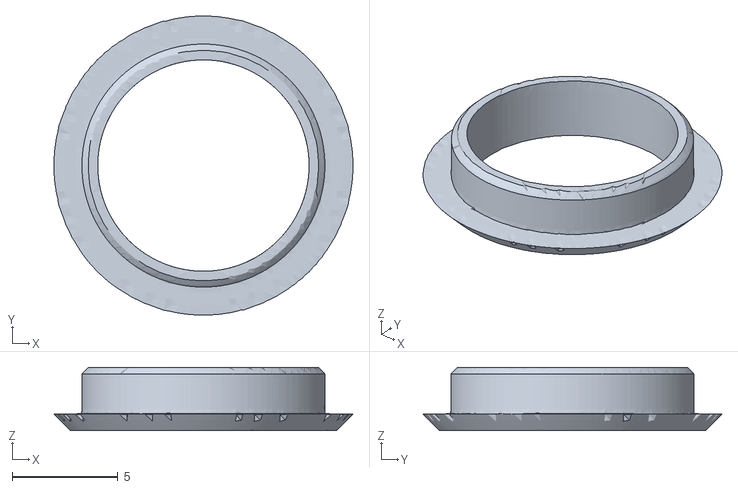
[picture p73: CAD file, 2026-11-11]
designs/v7/stl/tip-collar.stl
14.2 x 14.2 x 3.00
