aryankalra404/Neuryo-Headset/(list of files, cad)

Other CAD files:
pcb/low-cost-eeg/Production_Files/Enclosure STL Files/Enclosure_Top.stl
pcb/low-cost-eeg/Production_Files/Enclosure STL Files/Enclosure Bottom.stl
pcb/low-cost-eeg/Hardware/Enclosure_Inventor_Project/Enclosure Bottom.ipt
pcb/low-cost-eeg/Hardware/Enclosure_Inventor_Project/Enclosure_Multibody.ipt
pcb/low-cost-eeg/Hardware/Enclosure_Inventor_Project/Enclosure_Top.ipt
