aryankalra404/Neuryo-Headset/pcb/neuryo-rev-b/CHANGES.md

# Neuryo rev B: change list against Low-Cost-EEG (commit 3730d31)

Every difference between rev B and the reference board, why it was made, and where the reason comes from.
**Verified** = checked against an opened source (datasheet, wiki, the reference files) or by KiCad's own checks.
**Unverified** = not checked yet; listed again in [REVIEW-CHECKLIST.md](REVIEW-CHECKLIST.md).

Coordinates are in mm from the reference board's top-left corner (the same frame as the original Altium board).

## How the changes were made and checked

- **Import.** The reference Altium project (`low-cost-eeg/Hardware/PCB_Altium_Project`) was imported with KiCad 10.0.8 (File → Import Non-KiCad Project → Altium). The result is kept in [baseline-import/](baseline-import/).
- **Import checked.**
  - **Parts:** the imported schematic has the same 118 references as the reference BOM (`Production_Files/PCB Bill of Materials.xlsx`).
  - **Connections:** the imported board and the imported schematic give the same 78 multi-pin nets, pin for pin. The only difference is the ESP32 module's extra thermal-pad GND pads.
- **Design rules.** KiCad's importer only brought over Altium's generic 10 mil clearance, which produced 499 false DRC errors. The per-object clearance table was read from the PcbDoc rules and written to `*.kicad_dru`:
  - generic clearance: 10 mil
  - track to track: 0.1 mm
  - track to SMD pad: 0.1 mm
  - track to via: 0.2 mm
  - SMD pad to SMD pad: 0.15 mm
  - via to plane: 0.2 mm
  - via to hole: 0.2 mm
  - SMD pad to hole: 0.45 mm
  - board outline: 20 mil

  The Altium diff-pair rule covered only the USB pair, which rev B removes, so it was not translated.
- **Checks after every change.** All edits are scripted ([scripts/](scripts/)). After each step, KiCad's own `kicad-cli` ran:
  - ERC
  - DRC with schematic parity and refilled zones
  - netlist export

  Each netlist was compared pin by pin with the previous one ([review/netlist-diff-by-step.txt](review/netlist-diff-by-step.txt)). This check caught one accidental break in the first attempt: a clean-up step had cut the electrode-input wires. It was fixed before anything else was built on it.
- **Final result.**
  - **Schematic and board agree:** the rev B board and the rev B schematic give the same 75 multi-pin nets, pin for pin (78 after the 4th pass, which split SCLK, MOSI and CS).
  - **DRC:** 0 unconnected items. The only DRC errors left are ones the unchanged import already has:
    - 11 malformed courtyards on the imported footprints
    - 1 zero-length track crossing at IN6P/IN5N (26.25, 22.25)
  - **ERC:** 1 error, left in deliberately. It is U1 PGOOD (open-drain, tied to GND as the LM27762 datasheet allows) meeting a PWR_FLAG on GND.
  - **Remaining warnings:**
    - library links from the import
    - wire stubs that were already in the reference
    - silkscreen: the XIAO footprint's own outline crossing its own pads (18, Seeed's drawing; the fab clips it), SW1's outline past the edge (its actuator overhangs on purpose), and 3 overlaps that were already on the reference (R9/C14, C15/C30, C29/C30)
- **Second pass (8 Nov, "fix everything").** The first rev B left open items: the stack-up, the XIAO pad 25 question, a generic 2N7002 pattern, battery current near the analog half, untidy silkscreen, and no firmware. They are fixed below (rows marked **2nd pass**). The checks above were rerun on the result.

## Schematic and netlist changes

The full list is in [review/netlist-diff-original-vs-revb.txt](review/netlist-diff-original-vs-revb.txt).

| # | Change | Why | Source | Status |
|---|---|---|---|---|
| R1 | **Removed the ESP32-S3 module side:** U5 (ESP32-S3-WROOM-1), U2 (TLV75733 3.3 V LDO) with C6/C7, J2 (USB-C) with R5/R6/C48/D7, SW2/SW3 (boot, reset) with R7/R8/C11, C12/C13, J5 (UART header), TP5 (3v3) | The Seeed XIAO ESP32-S3 replaces all of them (it has its own regulator, USB-C and buttons) | Reference schematic; [Seeed XIAO ESP32-S3 wiki](https://wiki.seeedstudio.com/xiao_esp32s3_getting_started/) | Verified |
| R2 | **Change 1, reference on SRB2, filtered.** The R27 (2.2 k) / C31 (1 nF) node moves from ADS1299 pin 17 (SRB1) to pin 18 (SRB2). Pin 17 is left open. The header's SRB2 pin (J3J.2, now J19.2) and its ESD channel (D5 IO4) become net SRB2_HDR and no longer reach the ADS1299 | Upstream firmware uses SRB1 (MISC1 = 0x20). The Neuryo channel map needs SRB2 so channel 8 can be turned off SRB2 and run differential (ECG). The reference's SRB2 pin had no series resistor or filter | Reference schematic and `main.cpp`; ADS1299 datasheet (CHnSET SRB2 bit, MISC1 SRB1 bit) | Verified (netlist) |
| R3 | **Change 5, R10 (BIAS series) 2.2 k → 51 k**, Vishay MCT06030D5102BP500 (same series and footprint as the original) | Bias amplifier short-circuit current 1.1 mA against patient DC limits of 10 µA normal / 50 µA single fault. TI's own figures use 51 k protection resistors | ADS1299 datasheet; AAMI ES-1 limits as summarised by Fluke and MDDI (see pcb/README.md) | Part number from a [DigiKey listing](https://www.digikey.com.mx/en/products/detail/vishay/MCT06030D5102BP500/462825); availability unverified |
| R4 | **Change 4, START tied low:** new R36 10 k from ADS_START to GND. RESET (R30), PWDN (R31) and CLKSEL (R29) keep the reference's 10 k pull-ups to DVDD; they lose their MCU connection | The XIAO has no spare GPIOs. Datasheet: keep START low when using the START command; mode pins through ≥ 10 k. RESET is done with the RESET command | ADS1299 datasheet | Verified |
| R5 | **Change 2, analog off while USB is plugged in.** LM27762 EN+ (pin 12) and EN− (pin 8) and TPS7A20 EN (pin 3) move from VIN to a new net AEN. R38 100 k pulls AEN up to VIN. Q1 2N7002 pulls AEN to GND when the XIAO's 5 V pin is live (gate R37 100 k to GND). | Recording only on battery keeps the patient off mains-powered USB. The XIAO 5V pin has no voltage on battery. **LM27762:** EN pins active high, VIH 1.2 V, VIL 0.4 V, absolute max VIN, outputs actively discharged when disabled. **TPS7A20:** VEN(HI) 0.9 V, VEN(LOW) 0.3 V, internal 500 k pull-down (so AEN sits at about 0.83 × VIN until the regulator turns on), and the P version has active output discharge. **2N7002:** pin 1 G, 2 S, 3 D, VGS(th) 1–2.5 V, RDSon ≤ 5.3 Ω at 4.5 V. | [LM27762](https://www.ti.com/lit/ds/symlink/lm27762.pdf), [TPS7A20](https://www.ti.com/lit/ds/symlink/tps7a20.pdf), [Nexperia 2N7002](https://assets.nexperia.com/documents/data-sheet/2N7002.pdf) datasheets; Seeed wiki; Final Report 6.4 (author's own top fix) | Verified; LM27762 EN input current is not specified (assumed small against 100 k, unverified) |
| R6 | **USB-present sense:** R39 100 k / R40 150 k from the XIAO 5V pin to D9 (GPIO8): 5 V → 3.0 V | Firmware needs to know when USB is present so it can hold the SPI pins high-impedance while the ADS1299 is unpowered | Seeed wiki (5V pin) | Divider arithmetic verified; exact 5V-pin voltage unverified |
| R7 | **Battery voltage:** R41 / R42 220 k + C50 100 nF from VIN to D0 (GPIO1) | Battery gauge (VIN/2, at most 2.1 V at 4.2 V) | – | GPIO1 being on ADC1 is from the ESP32-S3 datasheet, not re-opened here (unverified) |
| R8 | **XIAO ESP32-S3 (U6)** with Seeed's own KiCad symbol and SMD footprint (castellated plus underside pads). BAT+ pad → VIN, BAT− → GND, 3V3 → XIAO_3V3, 5V → VUSB. **2nd pass:** pad 25 → GND, with a via in the pad. Underside pads 15–22 stay unconnected and are copper only (no mask opening, no paste), so nothing is soldered to the module's JTAG/EN/USB test pads. | Pin map below. Pad 25 faces the module's exposed GND copper | [Seeed OPL KiCad library](https://github.com/Seeed-Studio/OPL_Kicad_Library) (`XIAO-ESP32-S3-SMD`); Seeed's own module PCB in the same library (`Seeed Studio XIAO ESP32S3/ESP32S3.kicad_pcb`): its castellations and BAT/GND/test pads line up with the footprint to about 0.02 mm, and its bottom mask has a 2.75 × 2.5 mm opening over the GND pour where pad 25 sits | Verified |
| R9 | **I²C headers J6 (earlobe MAX30102) and J7 (BMI270):** 1×4, 2.54 mm. Pads copied from the reference's TSW-103 header. Pinout 1 GND, 2 3V3, 3 SDA, 4 SCL. No on-board pull-ups (4th pass: R46/R47 added, row P4). | Same bus (D8 SDA, D7 SCL). Leads are soldered in, as for the electrodes. "All Qwiic devices have pull-up resistors on the I2C lines" | [SparkFun Qwiic guide](https://learn.sparkfun.com/tutorials/qwiic-adapter-hookup-guide/hardware-overview) | Pull-ups on the actual modules unverified |
| R10 | **SW1 changes role:** battery on/off (throw 1 VBAT, common VIN, throw 3 now open; it was VBUS). **2nd pass: part changed** from the 12.9 × 6.8 mm through-hole 1101M2S3CQE2 to a C&K **PCM12SMTR** (SMD right-angle slide, 0.3 A at 6 V DC, 70 mΩ, terminal 2 common; JLC C221841), KiCad library footprint `SW_SPDT_PCM12`. Same pins, so no netlist change | The small switch lets the battery entry stay at the right-hand end (B8). 0.3 A covers the XIAO's BLE peaks plus the analog side | [C&K PCM datasheet](https://www.ckswitches.com/media/1424/pcm.pdf); JLCPCB part page; KiCad footprint library | Verified (rating, pinout); stock unverified |
| R12 | **2nd pass: Q1 footprint** is now KiCad's standard `SOT-23` (pads 1 G, 2 S, 3 D as Nexperia) instead of a hand-made one | A library pattern, not mine | KiCad footprint library | Verified (pin order); not compared with Nexperia's reflow drawing |
| R13 | **2nd pass: firmware** for rev B in [firmware/](firmware/) (below) | The board can't run the upstream firmware: different pins, no RESET/START GPIO, SRB2, interlock | Upstream `main.cpp`; OpenBCI Cyton library; Seeed variant file | Compiles with 0 errors and 0 warnings ([build log](firmware/build-log.txt)); not run on hardware |
| R11 | **ERC housekeeping:** PWR_FLAGs on VIN, VBAT, GND, AVDD, AVSS and DVDD; power symbols numbered #PWR001…; symbol instance paths set to the root sheet. **2nd pass:** the ten electrode headers J3A–J3J are renamed **J10–J19** in the same order (J3A → J10 … J3J → J19), on the schematic and the board. KiCad reads a reference with no trailing number as unannotated, so the BOM showed "J3A?" | The import had no power-output pins on those nets (6 ERC errors) and left power symbols un-numbered. No netlist change (checked) | – | Verified |
| R14 | **3rd pass (9 Nov): part numbers restored.** Every symbol now has one hidden `MPN` field ("Manufacturer PartNumber"), 94 added from the reference's production BOM (the parts it was built and tested with), and an `LCSC` field on U1, U3, U4 and D1–D5 (the numbers under "Change 8" below). The 19 wrong "RES SMD 100 OHM" descriptions on R1, R9 and R11–R27 now give the real value and tolerance (R1 130 kΩ 0.1 %, R9 1 MΩ 1 %, R11–R27 2.2 kΩ 0.1 %; Vishay code letter B = 0.1 %, F = 1 %). C14: the import's field said KEMET C0603C152J1GACTU, the production BOM says Murata GRM1885C2A152JA01D (both 1.5 nF C0G 0603); the `MPN` follows the production BOM. Made by `scripts/edit_sch_mpn.py`; `scripts/jlcbom.py` writes [bom-jlc.csv](review/fab-draft-do-not-order/bom-jlc.csv) with these fields, since kicad-cli's default BOM leaves them out | The import kept part numbers on only some symbols, under four different field names, and many had none, so a JLCPCB order filled from values alone could get parts the reference was never tested with (for example 1 % thick film in the ±2.5 V feedback dividers R1–R4 instead of 0.1 % thin film) | Reference `Production_Files/PCB Bill of Materials.xlsx` | Verified: only `MPN`/`LCSC` fields and the 19 descriptions changed (scripted comparison with the previous file); 108 placed parts in the new BOM + 4 copper test pads = the 112 of the kicad-cli BOM |

### Final XIAO pin map (replaces the draft in pcb/README.md)

The SPI and I²C pins were chosen so that the reference's SPI traces reach the XIAO's top row in the same order, and the I²C lines reach the bottom row without crossing. The ESP32-S3 routes SPI and I²C through its GPIO matrix, so any GPIO can be used.

| XIAO pin | GPIO | Net |
|---|---|---|
| D0 | 1 | VBAT_SENSE (VIN / 2) |
| D1 | 2 | DRDY |
| D2 | 3 | CS_X → R45 330 Ω → CS (R28 10 k pull-up to DVDD stays on the ADS1299 side). GPIO3 is a strapping pin (JTAG source), used only if the eFuse is set (unverified here) |
| D3 | 4 | MOSI_X → R44 330 Ω → MOSI (ADS1299 DIN) |
| D4 | 5 | SCLK_X → R43 330 Ω → SCLK |
| D5 | 6 | MISO (ADS1299 DOUT) |
| D6 | 43 | not connected (UART0 TX boot log) |
| D7 | 44 | I2C_SCL (4th pass: R47 4.7 k to XIAO_3V3) |
| D8 | 7 | I2C_SDA (4th pass: R46 4.7 k to XIAO_3V3) |
| D9 | 8 | USB_SENSE |
| D10 | 9 | ADS_RESET (4th pass; with R30 10 k pull-up to DVDD; firmware drives it open-drain only) |
| 5V / 3V3 / BAT+ / BAT− | – | VUSB / XIAO_3V3 / VIN / GND |

## Board changes

The full list is in [review/copper-and-placement-diff.txt](review/copper-and-placement-diff.txt).

| # | Change | Why | Status |
|---|---|---|---|
| B1 | **Outline 77 × 50 mm** (asked for: about 70 × 50). Left corners R5 as on the reference; right corners R1. The two right-hand mounting holes (x = 95) are gone; the two left ones stay. | The LM27762 block (U1, C1–C5, R1–R4) sits at x 63–76 on the reference and was kept exactly in place. 77 mm is the smallest width that keeps it. The XIAO's bottom-right pad needs a square-ish corner. | **Deviation from the request:** the v6 left pod must be checked for 77 × 50 (unverified). Right end of the board needs a printed clip in the pod |
| B2 | **Analog half (x < 56) unchanged except:** (a) SRB: R27/C31's via (25.5, 44.5) is joined on B.Cu (2 short segments) to the old SRB2 run, which still lands on pin 18. The SRB1 run to pin 17 (4 segments) and the header SRB2 run from D5 onwards (1 via, 3 segments) are removed; the J19.2–D5 copper stays. (b) START trace ends at R36 (52.5, 31.6). (c) RESET/PWDN traces stop at R30/R31. (d) At the boundary: the old ESP32 GND via at (55.75, 42.75) is gone and the I²C SCL line runs on B.Cu at x = 55.75. (e) The orphan teardrops of B13. No other track, via, pour or part in the analog half moved (2nd pass: the first pass's battery parts and copper at x 44–55 are gone again). | Changes 1 and 4, and space for the battery parts | Verified by the copper diff |
| B3 | **LM27762 enables:** its two VIN vias at EN− (66.25, 10.25) and EN+ (67.10, 13.60), with their four short traces, become AEN. They are joined on B.Cu to a via at U3 EN and to Q1. The In2 VIN plane now clears them. | Change 2 | Verified (DRC, 0 unconnected) |
| B4 | **TPS7A2033 (U3) with C9/C10** moved from x 80–88 into the strip under the LM27762 block (x 60.5–69, y 18–21), in the same order (C9 output, U3, C10 input). The reference's five small copper polygons (5.5 mm tall) are replaced by traces: DVDD 0.5 mm to the existing DVDD vias, VIN 0.4 mm, GND to a new via, EN to AEN. | No room for the 5.5 mm block on a 77 mm board. **This is a re-layout of a part the request listed as unchanged.** | Review item |
| B5 | **XIAO** at (56, 31), rotated 270°: USB-C flush with the right edge, top row facing the SPI traces. Old ESP32 copper under it removed (thermal-pad fan-out, GND vias, the stray GND stubs). No vias under the XIAO's pads; tented vias under its body only away from its pads (DRC clearance to the underside pads passes). | Change 7 | Verified (DRC) |
| B6 | **SPI:** same traces from the ADS1299; only the last bend of each is re-aimed at the XIAO pads (DRDY, CS, SCLK on F.Cu; MOSI and MISO from their existing vias) | – | Verified |
| B7 | **Interlock (Q1, R37, R38) on top**, **2nd pass:** in the top-right corner between C5 and C3 (Q1 at 75.0, 3.4). AEN runs on B.Cu to the LM27762 EN vias and on to U3 EN; VUSB comes up the right edge on B.Cu (x 76.3) from the XIAO 5V pad. USB-sense and battery dividers (R39–R42, C50) on the **bottom**, under the XIAO, as clones of the reference's bottom 0603 parts. J6/J7 left of the LM27762 block. Their B.Cu lines run over the In2 VIN plane, then DVDD, then VIN (not over AVDD/AVSS). | Space | Verified (DRC) |
| B8 | **Battery, 2nd pass: at the right-hand end, as on the reference.** J1 (same JST-PH side-entry part) at (73.1, 25.9), same rotation as the reference, opening at the right edge. SW1 (PCM12) at (74.65, 17.9), actuator out over the right edge (about 1 mm). VBAT 0.6 mm on F.Cu from J1 to SW1; D6 (TVS) and C49 (4.7 µF) on the bottom next to J1 pin 2. SW1 common → two vias → the In2 VIN plane that feeds the LM27762. TP6 (VIN) at (67.6, 23.0) on C10's VIN pad. The first pass had all of this at the bottom-left, next to the analog half; that copper is gone and its 4 GND stitching vias are back. | Battery and XIAO currents now stay at x > 62, the digital end. Nothing of the battery path is in the analog half | Verified (DRC, copper diff) |
| B9 | **In2:** the old 3v3 plane under the module is renamed VIN (same outline, extended at the right edge to join the old VIN plane). AVSS, AVDD, DVDD and GND planes are unchanged. | VIN reaches the XIAO and the bottom dividers | Verified |
| B10 | **GND stitching vias** removed where they clashed with new copper (19, all at x ≥ 56): (56.5, 12.25), (56.5, 30.25), (58, 9.25), (59.5, 6.25), (59.5, 12.25), (59.5, 30.25), (61, 9.25), (62.5, 6.25), (62.5, 12.25), (64, 21.25), (67, 21.25), (68.5, 24.25), (70, 27.25), (71.5, 24.25), (73, 3.25), (73, 21.25), (74.5, 6.25), (74.5, 18.25), (76, 3.25) | Clearance (SMD pad to hole 0.45 mm included) | Verified (DRC) |
| B11 | **Silkscreen:** ESP-side labels removed; TP labels right-aligned left of the test points; "REF nc"; "I2C: GND 3V3 SDA SCL" (pin 1 first); attribution on the bottom under the XIAO (Neuryo rev B; Low-Cost-EEG, X. Asghar, University of Bath, GPL-3.0). **2nd pass:** reference designators at the right-hand end (and of the new bottom parts) re-placed by a script (`scripts/silkplace.py`) so none sits on a pad, another label or an outline; all 0.8 mm text | – | Verified (DRC: no silk overlap left that isn't already on the reference) |
| B12 | **2nd pass: stack-up** set to JLCPCB's 4-layer 1.6 mm JLC04161H-7628: 35 µm outer copper, 7628 prepreg 0.2104 mm (εr 4.4), 15.2 µm inner copper, core 1.065 mm (εr 4.6), 7628 prepreg 0.2104 mm, 35 µm outer copper; ENIG finish (flat pads for the XIAO's underside pads). The import carried Altium's 0.59 mm template | No impedance-controlled line is left (USB went with the module), so nothing in the layout depends on it | [JLCPCB impedance page](https://jlcpcb.com/impedance) | Verified |
| B13 | **2nd pass: teardrops.** 15 teardrop zones whose track had been deleted are removed (5 in the analog half, all on tracks removed by B2: the old SRB1 and header-SRB2 runs and the trimmed RESET/PWDN stubs); 2 on the renamed R27/C31 track follow it from SRB1 to SRB2. **Correction (4th pass):** the committed rev B board has **no** teardrop zones at all; the baseline import has 417 (counted in both files). They were lost at the first rev B save, not only the 15 above. Cosmetic: no connection depends on them (DRC 0 unconnected) and they are not restored | Orphan copper | Corrected 10 Nov: Verified (zone count in both .kicad_pcb files) |
| B14 | **3rd pass (9 Nov): battery polarity on the silkscreen.** "+" at (166.60, 104.90) beside J1 pad 2 (VBAT) and "-" at (166.60, 106.90) beside pad 1 (GND), F.SilkS, 0.8 mm, left of the connector outline. Clearances measured from the file: 0.41 mm to TP6's pad, 0.30 mm to J1's own pin-1 mark; the board's silk clearance rule is 0 mm and its minimum text height 0.8 mm | JST-PH battery leads are sold wired both ways and the board has no reverse-polarity protection; a reversed cell would reach the XIAO's BAT pads and both regulators | Not yet checked by KiCad's DRC or shown in the renders: rerun `runner.sh` |

## Not changed (deliberately)

- **Leaving out the seven + side input capacitors (3rd pass review, not done).** With SRB2 closed the ADS1299 joins the + inputs of channels 1–7 to SRB2 (OpenBCI Cyton SDK), so C15, C29, C27, C25, C23, C21 and C19 sit on the reference with C31: 8 nF there against 1 nF on each electrode input. That mismatch turns common-mode (mains) pickup into signal through electrode impedance. Leaving them out balances it when the reference and electrode impedances are similar, but makes it worse when the electrode is far higher than the reference (for example a 5 kΩ gel M1 and 50 kΩ semi-dry pods: about −55 dB now, −37 dB without them, at 50 Hz). Not certain to help, so the board keeps the tested values; it is a bench A/B test in REVIEW-CHECKLIST.md (remove them from one board with hot air and compare).
- **No "ON" mark at SW1.** The PCM datasheet's table gives POS.1 = terminals 1-2 (battery on) but its text does not say which way the slider moves; check with a multimeter on the first board, then add the mark.

- **Change 3** (charge batteries outside the headset) needs no board change. J1 stays a removable JST-PH. The XIAO still charges at 50 mA when USB and the switch are both on (Seeed wiki); the analog side is off then (interlock).
- **Change 6.** Bottom-side parts are kept, and five more are added (R39–R42, C50). The board needs two-sided assembly.
- **Change 8** (stock): LCSC/JLCPCB numbers found:
  - ADS1299IPAGR: C476817
  - LM27762DSSR: C473398
  - TPS7A2033PDBVR: C2862740
  - TPD4E1B06DCKR: C840093 (LCSC)

  The JLC pages say "Extended". Live stock is not shown on the pages (unverified).

## Firmware (2nd pass)

[firmware/](firmware/) is the upstream PlatformIO project changed for rev B. Packet format, BLE service and characteristic, batching, sample rate and gain are the same as upstream.

| # | Change | Why | Source | Status |
|---|---|---|---|---|
| F1 | Board `seeed_xiao_esp32s3`; pins DRDY 2, CS 3, MOSI 4, SCLK 5, MISO 6, VBAT_SENSE 1, USB_SENSE 8, I²C SDA 7 / SCL 44 | Rev B pin map | PlatformIO board file (espressif32 v6.13.0); arduino-esp32 2.0.17 `XIAO_ESP32S3/pins_arduino.h` (D0–D5 = 1–6, D7 = 44, D8 = 7, D9 = 8; A0 = 1) | Verified |
| F2 | No RESET/START GPIO: the library takes −1 for them, resets with the RESET command (0x06) after tPOR and starts with the START command (0x08) after RDATAC | Change 4. Datasheet: hold START low when using the command | ADS1299 datasheet; same order as OpenBCI's `startADS()` | Verified |
| F3 | MISC1 = 0x00 (SRB1 open); CH1–7SET = 0x68 (gain 24, SRB2 closed); CH8SET = 0x60 (SRB2 open, ECG); BIAS_SENSN = 0x7F, BIAS_SENSP = 0x00; LOFF_SENSN = 0xFF, LOFF_SENSP = 0x81. CONFIG1/3/4, LOFF as upstream | Change 1 and the channel map: electrodes on the N inputs, M1 on SRB2 | OpenBCI Cyton library (SRB2 = CHnSET bit 3, "connect this P side to SRB2"; MISC1 0x00 opens SRB1) | Register bits verified; the bias and lead-off choice is a starting point to test at bring-up |
| F4 | **Interlock:** SCLK, MOSI, CS stay inputs at boot; if USB_SENSE is high the ADS1299 is not touched. On a USB plug-in an interrupt clears their output enables in one register write; on removal the ADS1299 is set up again | Change 2: don't back-power the unpowered ADS1299 through its I/O diodes | Rev B schematic | Written; needs a bench test |
| F5 | New BLE characteristic (read/notify) with USB state, ADS state, battery mV (D0 × 2) and the I²C addresses found (MAX30102 0x57, BMI270 0x68/0x69) | On battery there is no serial port | – | Written |
| F6 | ADS1299 ID read and printed (0x3E expected) | First check at bring-up | OpenBCI library (`ADS_ID 0x3E`) | Written |

## 4th pass (10 Nov 2026)

From the design review of 10 Nov ([review/REVB-4TH-PASS-PLAN.md](review/REVB-4TH-PASS-PLAN.md)). Made by `scripts/edit_sch4.py` and `scripts/edit_pcb4.py` (one letter per plan step), on the 3rd-pass files after KiCad had refilled them. After every step `kicad-cli` 10.0.8 ran ERC, DRC with schematic parity and refilled zones, the netlist export and the renders; the netlist diff of every step is in [review/netlist-diff-by-step.txt](review/netlist-diff-by-step.txt), and the copper and Gerber diffs in [review/4th-pass-diffs.txt](review/4th-pass-diffs.txt). Coordinates as above (mm from the top-left corner, y down).

| # | Change | Why | Source | Status |
|---|---|---|---|---|
| P1 | **Step A, XIAO battery pads.** U6 pads 23 (BAT+, VIN) and 24 (BAT−, GND) are plated through-holes: same 2.5 × 1.1 mm roundrect, 0.7 mm drill (0.2 mm ring on the narrow side), copper and mask on both sides. No paste on any XIAO pad (1–14 and 25 are F.Cu + F.Mask; 15–22 copper only as before). Pad 25 stays SMD (the B.Cu XIAO_3V3 run passes under it at y 41.5). The library footprint `Neuryo_RevB.pretty/XIAO-ESP32-S3-SMD` got the same pads, so the board copy and the library now match (DRC's library-mismatch warning for U6 is gone) | BAT+ is under the module, out of reach of an iron; through the hole it is soldered from the back. Paste on the pads would leave reflowed bumps and the module would not sit flat | Plan step A | Verified: DRC (no annular, hole or clearance item; 0 unconnected); outside each pad the zones are VIN on In2 and GND on In1 and B.Cu (zone polygons of the refilled board); netlist unchanged; Gerbers: paste gone from the 17 pads, B.Mask opens at both holes |
| P2 | **Step B, interlock labels.** Bottom silkscreen "Q1: USB interlock" directly behind Q1 (top-right corner), and "No Q1 = bench only, never on a person" (two lines) under R39/R40, beside the attribution block | Bench bring-up needs the analog side running on USB (Q1 removed by hand); the label says this board must then never go on a person. **Deviation:** the plan asked for the Q1 label on the top silkscreen; there is no free 11 mm strip of top silkscreen near Q1 (I²C label, R3/R4/C5, R37/Q1/R38, C3/C2), so it is on the bottom behind Q1 | Plan step B | Verified: DRC (no new silk item after moving the bench note off R39/R40 on the first try); netlist unchanged |
| P3 | **Step C, 330 Ω in series on SCLK, MOSI and CS** (R43, R44, R45; UNI-ROYAL 0603WAF3300T5E, JLCPCB C23138, Basic). The nets split at the XIAO end: SCLK_X / MOSI_X / CS_X on the XIAO side. R28 (CS pull-up) stays on the ADS1299 side. R43 sits in the vertical SCLK run at (63.96, 28.2); R44 in the MOSI run at (57.75, 28.25), before the via at (60.0, 28.25). CS had no room for an in-line 0603 (DRDY at y 21.75 and MISO at 23.72 beside it), so its diagonal run drops to B.Cu through two new vias on its own line, (63.80, 23.73) and (67.20, 27.13), with R45 on the bottom between them at (65.5, 25.43), 135° | With USB present the ADS1299 is unpowered and the XIAO is live: 330 Ω keeps the current into its input diodes to about 8 mA at 3.3 V (datasheet limit 10 mA continuous per pin). At 1–4 MHz SPI, 330 Ω with about 15 pF adds about 5 ns | Plan step C; ADS1299 datasheet (as quoted in the plan); JLCPCB part page C23138 | Verified: netlist diff (3 nets split, 3 parts added, nothing else); DRC; smallest gap from new copper to another net 0.33 mm (MOSI_X via to the CS_X track) |
| P4 | **Step D, I²C pull-ups** R46 (SDA) and R47 (SCL), 4.7 kΩ to XIAO_3V3 (UNI-ROYAL 0603WAF4701T5E, JLCPCB C23162, Basic), both on the bottom. R46 under the XIAO body between the B.Cu XIAO_3V3 run (y 41.5) and the I2C_SDA run (y 44.4); R47 between the J6 and J7 columns, from the 3V3 row to the SCL row. R47's two silkscreen body lines are left off (they would have run over the J6.3/J7.3 pads) | Some MAX30102 modules pull SDA/SCL up to 1.8 V, below the ESP32-S3's input-high level at 3.3 V; the board had no pull-ups of its own | Plan step D; JLCPCB part page C23162 | Verified: netlist diff (2 parts, no net renamed); DRC; no via under any XIAO pad |
| P5 | **Step E, XIAO D10 (GPIO9) → ADS1299 RESET.** ADS_RESET (U4 pin 36, R30 pin 1) gains U6 pad 11. Route: F.Cu from R30 pad 1 (48.75, 26.10) east along y 26.10 (the reference's own RESET corridor, empty since the 1st pass) to a via at (54.30, 26.10); B.Cu south along x 54.30 to y 46.90, east to x 66.50, north to a via at (66.50, 45.75); F.Cu into pad 11. R30 (10 k to DVDD) stays; no series resistor | The datasheet's first-choice reset path; D10 was free (D6 stays free for the ROM boot log). Firmware only pulls the line low (open-drain), so it cannot back-power the ADS1299 | Plan step E | Verified: netlist diff (one pin added); DRC; no existing track, via or part moved. At x < 56 this step adds the F.Cu trace, one via and the B.Cu run at x 54.3 (the plan's own route; its check line counted only the first two). Gerbers: at x < 56 the only differences from the 3rd pass are this route and its clearances in the top and bottom GND pours and in In1/In2 around the via. Gaps: 0.27 mm from the B.Cu run to the GND via at (55.00, 39.25), 0.42 mm from the via to SCLK |
| P6 | **Step F, test pads** TP7 MISO (bottom, on the MISO B.Cu run at 61.5, 25.25), TP8 DRDY (top, on the DRDY run at 65.83, 24.50), TP9 AEN (bottom, on the AEN run at 68.5, 6.5). 1.0 mm round SMD pads, mask open, no paste (new footprint `Neuryo_RevB:TP_SMD_D1.0`, excluded from BOM and position files), labelled on the silkscreen. SCLK, MOSI and CS can be probed on R43–R45 | Logic analyzer clip points for bring-up | Plan step F | Verified: netlist diff (3 single-pin parts); DRC; gaps ≥ 0.61 mm |
| P7 | **Step H, part numbers.** LCSC numbers added, each checked on its JLCPCB part page on 10 Nov: 10 k C25804 (R28–R36), 100 k C25803 (R37–R39), 150 k C22807 (R40), 220 k C22961 (R41, R42), all UNI-ROYAL 0603WAF…, 1 %, Basic; 100 nF 50 V X7R C14663 (YAGEO CC0603KRX7R9BB104, C50, Basic); Q1 keeps Nexperia 2N7002,215, C65189 (Extended). The `MPN` fields now name the part each LCSC number is (R28–R35 were the reference's Yageo AC0603FR-7W10KL: same value, tolerance and size; the BOM note says so). `scripts/jlcbom.py` writes [bom-jlc.csv](review/fab-draft-do-not-order/bom-jlc.csv) without the parts JLCPCB does not assemble and lists those in [bom-hand.csv](review/fab-draft-do-not-order/bom-hand.csv): U6, J1, J6, J7, J10–J19, JP1, TP1. Assembly notes in [ASSEMBLY.md](ASSEMBLY.md) | One order, nothing left unchecked | JLCPCB part pages C23138, C23162, C25804, C25803, C22807, C22961, C14663, C65189 | Verified (part pages); live stock unverified. Still without LCSC numbers: the reference's precision passives (R1–R4, R9–R27, C1–C5, C9, C10, C14–C47 except C50) and D6, which keep the reference's MPNs |

### Firmware (4th pass)

| # | Change | Why | Status |
|---|---|---|---|
| F7 | **Honest status.** `adsStart()` returns false, leaves `adsRunning` false and releases the SPI lines when `(ID & 0x1F) != 0x1E`. The status string is `usb=<0|1> ads=<0|1> id=<hex> vbat=<mV> i2c=<...>` | It reported `ads=1` whatever the ID read, and on battery that BLE string is the only thing visible | Written; compiles (both environments, see below); not run on hardware |
| F8 | **Bench build:** PlatformIO environment `xiao_esp32s3_bench` (`-D BENCH_NO_INTERLOCK`). USB_SENSE is ignored and the ADS1299 starts on USB; it prints `BENCH BUILD: interlock ignored, not for use on a person` at boot and appends it to the status string. The default environment is unchanged | First bring-up with the board on USB (Q1 removed) | Written; compiles (both environments, see below); not run on hardware |
| F9 | **Hardware reset on D10** (`ADS_RESET_PIN 9`, `static_assert(D10 == 9)` against the Seeed variant): set open-drain, low 10 µs (datasheet minimum 2 tCLK), back to input, wait 1 ms (minimum 18 tCLK), then the RESET command as before. Never driven high; not passed to the library (it would drive the pin push-pull). Register values, gain, sample rate, packet format, BLE UUIDs and the USB ISR are unchanged | Step E | Written; compiles (both environments, see below); not run on hardware |

### Check results after the 4th pass

- **ERC:** 1 error, the same one (U1 PGOOD on GND meeting the GND PWR_FLAG). Warnings: 179 library-link warnings (171 before; 8 new symbols carry the import's library names), 50 wire stubs, 1 label warning, as before. No new warning type.
- **DRC:** 0 unconnected. Errors: the 11 malformed courtyards and the zero-length track crossing at (26.25, 22.25), as before. Warnings: 44 library-mismatch (40 before: +5 cloned 0603s, −1 for U6 whose library copy now matches), and the same silkscreen items as before. No new clearance, hole or silk item.
- **Schematic ↔ board:** 78 of 78 multi-pin nets identical pin for pin (75 + SCLK_X, MOSI_X, CS_X). KiCad's parity report: the same 199 net-name conflicts from the import and 99 field differences.
- **Netlist against the 3rd pass:** parts added R43–R47, TP7–TP9; SCLK, MOSI and CS split at the XIAO; U6 pad 11 joined to ADS_RESET; nothing else.
- **Firmware build:** both environments, `xiao_esp32s3` and `xiao_esp32s3_bench`, build with 0 errors and 0 warnings (10 Nov, PlatformIO espressif32 6.13.0, Arduino core 2.0.17, runner v4 on the owner's Mac). RAM 13.9 %, flash 28.1 % / 28.0 %. The `static_assert(D10 == 9)` passed, so the Seeed variant confirms D10 is GPIO9. Log: [firmware/build-log.txt](firmware/build-log.txt). Verified (compile only; nothing has run on hardware).
- **Gerbers against the upstream board** (plan section 3; `scripts/gerbdiff.py`, see [review/4th-pass-diffs.txt](review/4th-pass-diffs.txt)): compared with the same check on the 3rd pass, the only changed regions at x < 56 lie along the step E route. On the top layer the new F.Cu RESET trace puts back copper the upstream board has there, so two "only on rev B" pour regions in that corridor shrink. Bottom paste is still identical to upstream. The plan's snippet needs gerbonara and cairosvg, which could not be installed (no package downloads on either machine), so `gerbdiff.py` is a small rasterizer for the features both Gerber sets use; run on the 3rd-pass Gerbers it reproduces the 10 Nov result for bottom paste (identical). Its many 0.008 mm² specks on the copper layers sit on pad and via edges in both runs and are rendering differences between Altium's and KiCad's pad shapes, not copper changes.

## 5th pass (11 Nov 2026)

From the review of 11 Nov ([review/REVB-REVIEW-11NOV.md](review/REVB-REVIEW-11NOV.md)), reviewed at commit `a3c452d`. Made by `scripts/edit_sch5.py` and `scripts/edit_pcb5.py` (one number per step), on the committed 4th-pass files. After every step `kicad-cli` 10.0.8 ran ERC, DRC with schematic parity and refilled zones, the netlist export and the renders (runner v5). Netlist diffs per step are in [review/netlist-diff-by-step.txt](review/netlist-diff-by-step.txt). Nothing at x < 56 mm changed: the Gerbers of the 5th pass are identical to the 4th pass on all eight copper, mask and paste layers (`scripts/gerbdiff.py --revb`, 0 differing regions per layer).

| # | Change | Why | Source | Status |
|---|---|---|---|---|
| Q1 | **BOM: every assembled part now has an LCSC number** (31 lines, 97 parts). The 17 lines the review listed: exact MPN kept for C1 (C561783), C4/C5 (C1852484), C10 + 8 (C106248), C34 (C883598), D6 (C233423), R2 (C705720), R3 (C861072), R4 (C855559). In-stock equivalents, with the `MPN` field now naming the part ordered and the reference part kept in a new `Reference MPN` field (and in the BOM note): C15–C31 Murata GRM1885C1H102FA01D (C913702); C32, C37, C41, C42, C45, C47 KEMET C0603C104J4RACTU (C22401913); R1 Yageo RT0603BRD07130KL (C861109); R9 UNI-ROYAL 0603WAF1004T5E (C22935); R10 Yageo RT0603BRD0751KL (C861458); R11–R27 Yageo RT0603BRD072K2L (C861295); C2, C3, C49 Samsung CL21B475KOFNNNE (C107365); C9, C33 Samsung CL21A106KAYNNNE (C15850); C14 Murata GRM1885C1H152JA01D (C162204). C1's manufacturer is corrected from Yageo to KEMET (its JLCPCB page) | 66 assembled parts had no LCSC number; six reference MPNs were at zero stock, one not listed, two nearly out (review section 1) | Review section 1; every JLCPCB part page opened again on 11 Nov (MPN, value, tolerance, rating, case); stock read from each LCSC page the same night | Verified: value, tolerance and case match the BOM row on all 17 pages; same technology (0.1 % thin film, C0G, X7R/X5R) except **R9**, now 1 % thick film (100 ppm/°C) instead of thin film; **C14** is 50 V instead of 100 V (C0G both; it sits between BIAS_INV and BIAS_OUT, inside the ±2.5 V rails); C913702 is C0G (RS page for GRM1885C1H102FA01D; JLCPCB's page does not state it). LCSC stock on 11 Nov: tightest is R11–R27 at 100 (34 needed for two boards); the others 650 or more. **JLCPCB's own assembly stock is Unverified**: its part pages load stock by script and the fetch did not show it; check at order time |
| Q2 | **R37 100 k → 10 k** (UNI-ROYAL 0603WAF1002T5E, C25804, Basic; same 0603 footprint). The second Description field R37 carried since the 2nd pass is corrected too | R37 is Q1's gate pull-down on VUSB, which the XIAO drives straight from VBUS with no series resistor, so with USB in the gate still sees 5 V. On battery the only source on that node is the leakage of Seeed's VBUS Schottky (datasheet limit 30 µA at 10 V): into 100 k ‖ 250 k (R39 + R40) ‖ Seeed's 100 k ≈ 42 kΩ that is up to 1.25 V, above the 2N7002's 1 V minimum threshold; with 10 k (≈ 8.8 kΩ) it is 0.26 V | Review section 6; CHANGES R5; netlist (VUSB: Q1.1, R37.1, R39.1, U6.14) | Verified: netlist identical to step 1 (a value change); DRC and ERC unchanged; the node arithmetic. Seeed's 100 k and Schottky on VBUS and the 30 µA limit are the review's reading of Seeed's board file and the LMBR4010BST5G datasheet, not re-opened here; the diode's real leakage is Unverified (checklist 9) |
| Q3 | **J1 drill 0.7 → 0.8 mm** on both pins, pad 1.2 mm unchanged (0.2 mm ring), on the board and in the library footprint `Low_Cost_EEG-import-fps:JST-S2B-PH-K-S_V` | JST asks for Ø0.7 +0.1/−0 and the post's diagonal is 0.71 mm; JLCPCB's hole tolerance (+0.13/−0.08) can finish a 0.7 hole at 0.62 | Review section 6 | Verified: DRC. **One new DRC error:** `pth_inside_courtyard`, J1 pin 2's hole now reaches 0.05 mm into the courtyard of C49 (0805, bottom, same VBAT net). The hole edge is 0.44 mm from C49's pad and about 1.15 mm from its body; with the 0.7 mm hole the edge already sat on that courtyard line. Not fixed: clearing it means moving C49, i.e. existing copper. Left for the owner to decide (checklist 9) |
| Q4 | **Placement file in JLCPCB's format:** `scripts/jlccpl.py` turns KiCad's position file into [cpl-jlc.csv](review/order-draft-do-not-order/cpl-jlc.csv) with the headers Designator, Mid X, Mid Y, Rotation, Layer (Top/Bottom), values in mm. Angles are KiCad's as exported: **no part is pre-rotated**. Only the 97 parts of bom-jlc.csv are in it (the script stops if one is missing). The parts the review expects JLCPCB's preview to show turned, D6 first, are listed with their correct pin 1 in [ASSEMBLY.md](ASSEMBLY.md) | KiCad's headers (Ref, PosX, PosY, Rot, Side) are not JLCPCB's | Review section 3; [JLCPCB help](https://jlcpcb.com/help/article/how-to-generate-the-bom-and-centroid-file-from-kicad) | Verified: headers, 97 = 97 parts, pin-1 positions in ASSEMBLY.md read from the board file. The expected preview angles are Unverified (JLCPCB's preview decides) |
| Q5 | **Clean order folder** [review/order-draft-do-not-order/gerber-and-drill/](review/order-draft-do-not-order/gerber-and-drill/): Gerbers for F.Cu, In1.Cu, In2.Cu, B.Cu, both paste, both silkscreen, both mask and Edge.Cuts (11 files), and Excellon drill with plated and non-plated holes in separate files (runner v5 option `order`). BOM, CPL and the hand-solder list sit beside it | The draft had a dozen extra layers | Review section 6; [JLCPCB KiCad guide](https://jlcpcb.com/help/article/how-to-generate-gerber-and-drill-files-in-kicad-8) | Verified: `Neuryo_RevB-NPTH.drl` (KiCad attribute `NonPlated,NPTH`) holds exactly 4 holes: the SW1 pegs Ø0.9 at (74.98, 16.40) and (74.98, 19.40) and the mounting holes Ø3.2 at (5.00, 5.00) and (5.00, 45.00); none of them is in `Neuryo_RevB-PTH.drl` (260 plated holes, J1 at 0.8 mm) |

### Firmware (5th pass)

| # | Change | Why | Status |
|---|---|---|---|
| F10 | **Clean restart after USB plug-in then unplug.** New flag `adsStarted` (set when `adsStart()` succeeds, cleared in `adsStop()`). `loop()` calls `adsStop()` on plug-in whenever `adsStarted` is set, and `adsStart()` on unplug only when it is clear, so `SPI.end()` always runs before the next `SPI.begin()`. The plug-in → unplug sequence is written out step by step in a comment in `loop()` | The ISR clears `adsRunning`, so the old `if (usb && adsRunning)` never stopped the ADS1299; `SPI.end()` never ran and `SPI.begin()` returned early on the restart (arduino-esp32 2.0.17) | Verified: compiles; logic by reading. Not run on hardware |
| F11 | **150 ms after the CONFIG3 write** that turns the internal reference on, before any conversion | Internal reference start-up time 150 ms (ADS1299 datasheet 7.5, p. 11; the power-up flow, Figure 67, says to wait for it to settle) | Verified: compiles; datasheet |
| F12 | **CONFIG3 = 0xEE** (0b1110 1110) instead of 0xFE: only BIAS_MEAS (bit 4) cleared. Bits from datasheet Table 15 (p. 49, reset 0x60): 7 PD_REFBUF 1, 6:5 reserved 1 1 (must be 3h), 4 BIAS_MEAS 0, 3 BIASREF_INT 1, 2 PD_BIAS 1, 1 BIAS_LOFF_SENS 1, 0 BIAS_STAT read-only. The BOOT-button (record mode) write changes the same way, 0xFC → 0xEC (it differs from the start-up value only in BIAS_LOFF_SENS) | No channel uses MUX 010 to measure BIAS_IN | Verified: compiles; datasheet |

### Check results after the 5th pass
- **ERC:** 1 error, the same U1 PGOOD one; 179 library-link warnings, 50 wire stubs, 1 label warning: unchanged from the 4th pass.
- **DRC:** 0 unconnected. 13 errors: the import's 11 malformed courtyards and 1 zero-length track crossing, plus the new J1-hole / C49-courtyard item above. Warnings unchanged (44 library-mismatch and the same silkscreen items).
- **Netlist against the 4th pass:** no change after any step (R37 is a value change; the rest are fields and a drill).
- **Schematic ↔ board:** 78 of 78 multi-pin nets identical; KiCad's parity report has the same 199 net-name conflicts from the import and 99 field differences.
- **Firmware:** both environments build with 0 errors and 0 warnings (11 Nov; RAM 13.9 %, flash 28.1 % / 28.0 %). Log: [firmware/build-log.txt](firmware/build-log.txt).
- **Gerbers:** identical to the 4th pass on every copper, mask and paste layer. The drill changes only at J1.
