aryankalra404/Neuryo-Headset/pcb/neuryo-rev-b/firmware/build-log.txt

Processing xiao_esp32s3 (platform: espressif32@~6.13.0; board: seeed_xiao_esp32s3; framework: arduino)
--------------------------------------------------------------------------------
Verbose mode can be enabled via `-v, --verbose` option
CONFIGURATION: https://docs.platformio.org/page/boards/espressif32/seeed_xiao_esp32s3.html
PLATFORM: Espressif 32 (6.13.0) > Seeed Studio XIAO ESP32S3
HARDWARE: ESP32S3 240MHz, 320KB RAM, 8MB Flash
DEBUG: Current (cmsis-dap) External (cmsis-dap, esp-bridge, esp-builtin, esp-prog, iot-bus-jtag, jlink, minimodule, olimex-arm-usb-ocd, olimex-arm-usb-ocd-h, olimex-arm-usb-tiny-h, olimex-jtag-tiny, tumpa)
PACKAGES: 
 - framework-arduinoespressif32 @ 3.20017.241212+sha.dcc1105b 
 - tool-esptoolpy @ 2.41100.260830 (4.11.0) 
 - toolchain-riscv32-esp @ 8.4.0+2021r2-patch5 
 - toolchain-xtensa-esp32s3 @ 8.4.0+2021r2-patch5
LDF: Library Dependency Finder -> https://bit.ly/configure-pio-ldf
LDF Modes: Finder ~ chain, Compatibility ~ soft
Found 34 compatible libraries
Scanning dependencies...
Dependency Graph
|-- ADS1299
|-- ESP32 BLE Arduino @ 2.0.0
|-- Wire @ 2.0.0
Building in release mode
Compiling .pio/build/xiao_esp32s3/src/main.cpp.o
Building .pio/build/xiao_esp32s3/bootloader.bin
Generating partitions .pio/build/xiao_esp32s3/partitions.bin
esptool.py v4.11.0
Creating esp32s3 image...
Merged 1 ELF section
Successfully created esp32s3 image.
Compiling .pio/build/xiao_esp32s3/libf2f/SPI/SPI.cpp.o
Compiling .pio/build/xiao_esp32s3/lib970/ADS1299/ADS1299.cpp.o
Compiling .pio/build/xiao_esp32s3/libe46/BLE/BLE2902.cpp.o
Compiling .pio/build/xiao_esp32s3/libe46/BLE/BLE2904.cpp.o
Compiling .pio/build/xiao_esp32s3/libe46/BLE/BLEAddress.cpp.o
Compiling .pio/build/xiao_esp32s3/libe46/BLE/BLEAdvertisedDevice.cpp.o
Compiling .pio/build/xiao_esp32s3/libe46/BLE/BLEAdvertising.cpp.o
Compiling .pio/build/xiao_esp32s3/libe46/BLE/BLEBeacon.cpp.o
Compiling .pio/build/xiao_esp32s3/libe46/BLE/BLECharacteristic.cpp.o
Archiving .pio/build/xiao_esp32s3/libf2f/libSPI.a
Indexing .pio/build/xiao_esp32s3/libf2f/libSPI.a
Compiling .pio/build/xiao_esp32s3/libe46/BLE/BLECharacteristicMap.cpp.o
Compiling .pio/build/xiao_esp32s3/libe46/BLE/BLEClient.cpp.o
Compiling .pio/build/xiao_esp32s3/libe46/BLE/BLEDescriptor.cpp.o
Archiving .pio/build/xiao_esp32s3/lib970/libADS1299.a
Compiling .pio/build/xiao_esp32s3/libe46/BLE/BLEDescriptorMap.cpp.o
Indexing .pio/build/xiao_esp32s3/lib970/libADS1299.a
Compiling .pio/build/xiao_esp32s3/libe46/BLE/BLEDevice.cpp.o
Compiling .pio/build/xiao_esp32s3/libe46/BLE/BLEEddystoneTLM.cpp.o
Compiling .pio/build/xiao_esp32s3/libe46/BLE/BLEEddystoneURL.cpp.o
Compiling .pio/build/xiao_esp32s3/libe46/BLE/BLEExceptions.cpp.o
Compiling .pio/build/xiao_esp32s3/libe46/BLE/BLEHIDDevice.cpp.o
Compiling .pio/build/xiao_esp32s3/libe46/BLE/BLERemoteCharacteristic.cpp.o
Compiling .pio/build/xiao_esp32s3/libe46/BLE/BLERemoteDescriptor.cpp.o
Compiling .pio/build/xiao_esp32s3/libe46/BLE/BLERemoteService.cpp.o
Compiling .pio/build/xiao_esp32s3/libe46/BLE/BLEScan.cpp.o
Compiling .pio/build/xiao_esp32s3/libe46/BLE/BLESecurity.cpp.o
Compiling .pio/build/xiao_esp32s3/libe46/BLE/BLEServer.cpp.o
Compiling .pio/build/xiao_esp32s3/libe46/BLE/BLEService.cpp.o
Compiling .pio/build/xiao_esp32s3/libe46/BLE/BLEServiceMap.cpp.o
Compiling .pio/build/xiao_esp32s3/libe46/BLE/BLEUUID.cpp.o
Compiling .pio/build/xiao_esp32s3/libe46/BLE/BLEUtils.cpp.o
Compiling .pio/build/xiao_esp32s3/libe46/BLE/BLEValue.cpp.o
Compiling .pio/build/xiao_esp32s3/libe46/BLE/FreeRTOS.cpp.o
Compiling .pio/build/xiao_esp32s3/libe46/BLE/GeneralUtils.cpp.o
Compiling .pio/build/xiao_esp32s3/lib861/Wire/Wire.cpp.o
Compiling .pio/build/xiao_esp32s3/FrameworkArduino/Esp.cpp.o
Compiling .pio/build/xiao_esp32s3/FrameworkArduino/FirmwareMSC.cpp.o
Compiling .pio/build/xiao_esp32s3/FrameworkArduino/FunctionalInterrupt.cpp.o
Compiling .pio/build/xiao_esp32s3/FrameworkArduino/HWCDC.cpp.o
Compiling .pio/build/xiao_esp32s3/FrameworkArduino/HardwareSerial.cpp.o
Compiling .pio/build/xiao_esp32s3/FrameworkArduino/IPAddress.cpp.o
Compiling .pio/build/xiao_esp32s3/FrameworkArduino/IPv6Address.cpp.o
Compiling .pio/build/xiao_esp32s3/FrameworkArduino/MD5Builder.cpp.o
Compiling .pio/build/xiao_esp32s3/FrameworkArduino/Print.cpp.o
Archiving .pio/build/xiao_esp32s3/libe46/libBLE.a
Compiling .pio/build/xiao_esp32s3/FrameworkArduino/Stream.cpp.o
Indexing .pio/build/xiao_esp32s3/libe46/libBLE.a
Compiling .pio/build/xiao_esp32s3/FrameworkArduino/StreamString.cpp.o
Archiving .pio/build/xiao_esp32s3/lib861/libWire.a
Compiling .pio/build/xiao_esp32s3/FrameworkArduino/Tone.cpp.o
Indexing .pio/build/xiao_esp32s3/lib861/libWire.a
Compiling .pio/build/xiao_esp32s3/FrameworkArduino/USB.cpp.o
Compiling .pio/build/xiao_esp32s3/FrameworkArduino/USBCDC.cpp.o
Compiling .pio/build/xiao_esp32s3/FrameworkArduino/USBMSC.cpp.o
Compiling .pio/build/xiao_esp32s3/FrameworkArduino/WMath.cpp.o
Compiling .pio/build/xiao_esp32s3/FrameworkArduino/WString.cpp.o
Compiling .pio/build/xiao_esp32s3/FrameworkArduino/base64.cpp.o
Compiling .pio/build/xiao_esp32s3/FrameworkArduino/cbuf.cpp.o
Compiling .pio/build/xiao_esp32s3/FrameworkArduino/esp32-hal-adc.c.o
Compiling .pio/build/xiao_esp32s3/FrameworkArduino/esp32-hal-bt.c.o
Compiling .pio/build/xiao_esp32s3/FrameworkArduino/esp32-hal-cpu.c.o
Compiling .pio/build/xiao_esp32s3/FrameworkArduino/esp32-hal-dac.c.o
Compiling .pio/build/xiao_esp32s3/FrameworkArduino/esp32-hal-gpio.c.o
Compiling .pio/build/xiao_esp32s3/FrameworkArduino/esp32-hal-i2c-slave.c.o
Compiling .pio/build/xiao_esp32s3/FrameworkArduino/esp32-hal-i2c.c.o
Compiling .pio/build/xiao_esp32s3/FrameworkArduino/esp32-hal-ledc.c.o
Compiling .pio/build/xiao_esp32s3/FrameworkArduino/esp32-hal-matrix.c.o
Compiling .pio/build/xiao_esp32s3/FrameworkArduino/esp32-hal-misc.c.o
Compiling .pio/build/xiao_esp32s3/FrameworkArduino/esp32-hal-psram.c.o
Compiling .pio/build/xiao_esp32s3/FrameworkArduino/esp32-hal-rgb-led.c.o
Compiling .pio/build/xiao_esp32s3/FrameworkArduino/esp32-hal-rmt.c.o
Compiling .pio/build/xiao_esp32s3/FrameworkArduino/esp32-hal-sigmadelta.c.o
Compiling .pio/build/xiao_esp32s3/FrameworkArduino/esp32-hal-spi.c.o
Compiling .pio/build/xiao_esp32s3/FrameworkArduino/esp32-hal-time.c.o
Compiling .pio/build/xiao_esp32s3/FrameworkArduino/esp32-hal-timer.c.o
Compiling .pio/build/xiao_esp32s3/FrameworkArduino/esp32-hal-tinyusb.c.o
Compiling .pio/build/xiao_esp32s3/FrameworkArduino/esp32-hal-touch.c.o
Compiling .pio/build/xiao_esp32s3/FrameworkArduino/esp32-hal-uart.c.o
Compiling .pio/build/xiao_esp32s3/FrameworkArduino/firmware_msc_fat.c.o
Compiling .pio/build/xiao_esp32s3/FrameworkArduino/libb64/cdecode.c.o
Compiling .pio/build/xiao_esp32s3/FrameworkArduino/libb64/cencode.c.o
Compiling .pio/build/xiao_esp32s3/FrameworkArduino/main.cpp.o
Compiling .pio/build/xiao_esp32s3/FrameworkArduino/stdlib_noniso.c.o
Compiling .pio/build/xiao_esp32s3/FrameworkArduino/wiring_pulse.c.o
Compiling .pio/build/xiao_esp32s3/FrameworkArduino/wiring_shift.c.o
Archiving .pio/build/xiao_esp32s3/libFrameworkArduino.a
Indexing .pio/build/xiao_esp32s3/libFrameworkArduino.a
Linking .pio/build/xiao_esp32s3/firmware.elf
Retrieving maximum program size .pio/build/xiao_esp32s3/firmware.elf
Checking size .pio/build/xiao_esp32s3/firmware.elf
Advanced Memory Usage is available via "PlatformIO Home > Project Inspect"
RAM:   [=         ]  13.9% (used 45404 bytes from 327680 bytes)
Flash: [===       ]  28.1% (used 937629 bytes from 3342336 bytes)
Building .pio/build/xiao_esp32s3/firmware.bin
esptool.py v4.11.0
Creating esp32s3 image...
Merged 2 ELF sections
Successfully created esp32s3 image.
========================= [SUCCESS] Took 6.92 seconds =========================

Processing xiao_esp32s3_bench (platform: espressif32@~6.13.0; board: seeed_xiao_esp32s3; framework: arduino)
--------------------------------------------------------------------------------
Verbose mode can be enabled via `-v, --verbose` option
CONFIGURATION: https://docs.platformio.org/page/boards/espressif32/seeed_xiao_esp32s3.html
PLATFORM: Espressif 32 (6.13.0) > Seeed Studio XIAO ESP32S3
HARDWARE: ESP32S3 240MHz, 320KB RAM, 8MB Flash
DEBUG: Current (cmsis-dap) External (cmsis-dap, esp-bridge, esp-builtin, esp-prog, iot-bus-jtag, jlink, minimodule, olimex-arm-usb-ocd, olimex-arm-usb-ocd-h, olimex-arm-usb-tiny-h, olimex-jtag-tiny, tumpa)
PACKAGES: 
 - framework-arduinoespressif32 @ 3.20017.241212+sha.dcc1105b 
 - tool-esptoolpy @ 2.41100.260830 (4.11.0) 
 - toolchain-riscv32-esp @ 8.4.0+2021r2-patch5 
 - toolchain-xtensa-esp32s3 @ 8.4.0+2021r2-patch5
LDF: Library Dependency Finder -> https://bit.ly/configure-pio-ldf
LDF Modes: Finder ~ chain, Compatibility ~ soft
Found 34 compatible libraries
Scanning dependencies...
Dependency Graph
|-- ADS1299
|-- ESP32 BLE Arduino @ 2.0.0
|-- Wire @ 2.0.0
Building in release mode
Compiling .pio/build/xiao_esp32s3_bench/src/main.cpp.o
Building .pio/build/xiao_esp32s3_bench/bootloader.bin
Generating partitions .pio/build/xiao_esp32s3_bench/partitions.bin
esptool.py v4.11.0
Creating esp32s3 image...
Merged 1 ELF section
Successfully created esp32s3 image.
Compiling .pio/build/xiao_esp32s3_bench/libf2f/SPI/SPI.cpp.o
Compiling .pio/build/xiao_esp32s3_bench/lib970/ADS1299/ADS1299.cpp.o
Compiling .pio/build/xiao_esp32s3_bench/libe46/BLE/BLE2902.cpp.o
Compiling .pio/build/xiao_esp32s3_bench/libe46/BLE/BLE2904.cpp.o
Compiling .pio/build/xiao_esp32s3_bench/libe46/BLE/BLEAddress.cpp.o
Compiling .pio/build/xiao_esp32s3_bench/libe46/BLE/BLEAdvertisedDevice.cpp.o
Compiling .pio/build/xiao_esp32s3_bench/libe46/BLE/BLEAdvertising.cpp.o
Compiling .pio/build/xiao_esp32s3_bench/libe46/BLE/BLEBeacon.cpp.o
Compiling .pio/build/xiao_esp32s3_bench/libe46/BLE/BLECharacteristic.cpp.o
Compiling .pio/build/xiao_esp32s3_bench/libe46/BLE/BLECharacteristicMap.cpp.o
Archiving .pio/build/xiao_esp32s3_bench/libf2f/libSPI.a
Indexing .pio/build/xiao_esp32s3_bench/libf2f/libSPI.a
Compiling .pio/build/xiao_esp32s3_bench/libe46/BLE/BLEClient.cpp.o
Compiling .pio/build/xiao_esp32s3_bench/libe46/BLE/BLEDescriptor.cpp.o
Archiving .pio/build/xiao_esp32s3_bench/lib970/libADS1299.a
Compiling .pio/build/xiao_esp32s3_bench/libe46/BLE/BLEDescriptorMap.cpp.o
Indexing .pio/build/xiao_esp32s3_bench/lib970/libADS1299.a
Compiling .pio/build/xiao_esp32s3_bench/libe46/BLE/BLEDevice.cpp.o
Compiling .pio/build/xiao_esp32s3_bench/libe46/BLE/BLEEddystoneTLM.cpp.o
Compiling .pio/build/xiao_esp32s3_bench/libe46/BLE/BLEEddystoneURL.cpp.o
Compiling .pio/build/xiao_esp32s3_bench/libe46/BLE/BLEExceptions.cpp.o
Compiling .pio/build/xiao_esp32s3_bench/libe46/BLE/BLEHIDDevice.cpp.o
Compiling .pio/build/xiao_esp32s3_bench/libe46/BLE/BLERemoteCharacteristic.cpp.o
Compiling .pio/build/xiao_esp32s3_bench/libe46/BLE/BLERemoteDescriptor.cpp.o
Compiling .pio/build/xiao_esp32s3_bench/libe46/BLE/BLERemoteService.cpp.o
Compiling .pio/build/xiao_esp32s3_bench/libe46/BLE/BLEScan.cpp.o
Compiling .pio/build/xiao_esp32s3_bench/libe46/BLE/BLESecurity.cpp.o
Compiling .pio/build/xiao_esp32s3_bench/libe46/BLE/BLEServer.cpp.o
Compiling .pio/build/xiao_esp32s3_bench/libe46/BLE/BLEService.cpp.o
Compiling .pio/build/xiao_esp32s3_bench/libe46/BLE/BLEServiceMap.cpp.o
Compiling .pio/build/xiao_esp32s3_bench/libe46/BLE/BLEUUID.cpp.o
Compiling .pio/build/xiao_esp32s3_bench/libe46/BLE/BLEUtils.cpp.o
Compiling .pio/build/xiao_esp32s3_bench/libe46/BLE/BLEValue.cpp.o
Compiling .pio/build/xiao_esp32s3_bench/libe46/BLE/FreeRTOS.cpp.o
Compiling .pio/build/xiao_esp32s3_bench/libe46/BLE/GeneralUtils.cpp.o
Compiling .pio/build/xiao_esp32s3_bench/lib861/Wire/Wire.cpp.o
Compiling .pio/build/xiao_esp32s3_bench/FrameworkArduino/Esp.cpp.o
Compiling .pio/build/xiao_esp32s3_bench/FrameworkArduino/FirmwareMSC.cpp.o
Compiling .pio/build/xiao_esp32s3_bench/FrameworkArduino/FunctionalInterrupt.cpp.o
Compiling .pio/build/xiao_esp32s3_bench/FrameworkArduino/HWCDC.cpp.o
Compiling .pio/build/xiao_esp32s3_bench/FrameworkArduino/HardwareSerial.cpp.o
Compiling .pio/build/xiao_esp32s3_bench/FrameworkArduino/IPAddress.cpp.o
Compiling .pio/build/xiao_esp32s3_bench/FrameworkArduino/IPv6Address.cpp.o
Compiling .pio/build/xiao_esp32s3_bench/FrameworkArduino/MD5Builder.cpp.o
Compiling .pio/build/xiao_esp32s3_bench/FrameworkArduino/Print.cpp.o
Archiving .pio/build/xiao_esp32s3_bench/libe46/libBLE.a
Compiling .pio/build/xiao_esp32s3_bench/FrameworkArduino/Stream.cpp.o
Compiling .pio/build/xiao_esp32s3_bench/FrameworkArduino/StreamString.cpp.o
Indexing .pio/build/xiao_esp32s3_bench/libe46/libBLE.a
Archiving .pio/build/xiao_esp32s3_bench/lib861/libWire.a
Compiling .pio/build/xiao_esp32s3_bench/FrameworkArduino/Tone.cpp.o
Indexing .pio/build/xiao_esp32s3_bench/lib861/libWire.a
Compiling .pio/build/xiao_esp32s3_bench/FrameworkArduino/USB.cpp.o
Compiling .pio/build/xiao_esp32s3_bench/FrameworkArduino/USBCDC.cpp.o
Compiling .pio/build/xiao_esp32s3_bench/FrameworkArduino/USBMSC.cpp.o
Compiling .pio/build/xiao_esp32s3_bench/FrameworkArduino/WMath.cpp.o
Compiling .pio/build/xiao_esp32s3_bench/FrameworkArduino/WString.cpp.o
Compiling .pio/build/xiao_esp32s3_bench/FrameworkArduino/base64.cpp.o
Compiling .pio/build/xiao_esp32s3_bench/FrameworkArduino/cbuf.cpp.o
Compiling .pio/build/xiao_esp32s3_bench/FrameworkArduino/esp32-hal-adc.c.o
Compiling .pio/build/xiao_esp32s3_bench/FrameworkArduino/esp32-hal-bt.c.o
Compiling .pio/build/xiao_esp32s3_bench/FrameworkArduino/esp32-hal-cpu.c.o
Compiling .pio/build/xiao_esp32s3_bench/FrameworkArduino/esp32-hal-dac.c.o
Compiling .pio/build/xiao_esp32s3_bench/FrameworkArduino/esp32-hal-gpio.c.o
Compiling .pio/build/xiao_esp32s3_bench/FrameworkArduino/esp32-hal-i2c-slave.c.o
Compiling .pio/build/xiao_esp32s3_bench/FrameworkArduino/esp32-hal-i2c.c.o
Compiling .pio/build/xiao_esp32s3_bench/FrameworkArduino/esp32-hal-ledc.c.o
Compiling .pio/build/xiao_esp32s3_bench/FrameworkArduino/esp32-hal-matrix.c.o
Compiling .pio/build/xiao_esp32s3_bench/FrameworkArduino/esp32-hal-misc.c.o
Compiling .pio/build/xiao_esp32s3_bench/FrameworkArduino/esp32-hal-psram.c.o
Compiling .pio/build/xiao_esp32s3_bench/FrameworkArduino/esp32-hal-rgb-led.c.o
Compiling .pio/build/xiao_esp32s3_bench/FrameworkArduino/esp32-hal-rmt.c.o
Compiling .pio/build/xiao_esp32s3_bench/FrameworkArduino/esp32-hal-sigmadelta.c.o
Compiling .pio/build/xiao_esp32s3_bench/FrameworkArduino/esp32-hal-spi.c.o
Compiling .pio/build/xiao_esp32s3_bench/FrameworkArduino/esp32-hal-time.c.o
Compiling .pio/build/xiao_esp32s3_bench/FrameworkArduino/esp32-hal-timer.c.o
Compiling .pio/build/xiao_esp32s3_bench/FrameworkArduino/esp32-hal-tinyusb.c.o
Compiling .pio/build/xiao_esp32s3_bench/FrameworkArduino/esp32-hal-touch.c.o
Compiling .pio/build/xiao_esp32s3_bench/FrameworkArduino/esp32-hal-uart.c.o
Compiling .pio/build/xiao_esp32s3_bench/FrameworkArduino/firmware_msc_fat.c.o
Compiling .pio/build/xiao_esp32s3_bench/FrameworkArduino/libb64/cdecode.c.o
Compiling .pio/build/xiao_esp32s3_bench/FrameworkArduino/libb64/cencode.c.o
Compiling .pio/build/xiao_esp32s3_bench/FrameworkArduino/main.cpp.o
Compiling .pio/build/xiao_esp32s3_bench/FrameworkArduino/stdlib_noniso.c.o
Compiling .pio/build/xiao_esp32s3_bench/FrameworkArduino/wiring_pulse.c.o
Compiling .pio/build/xiao_esp32s3_bench/FrameworkArduino/wiring_shift.c.o
Archiving .pio/build/xiao_esp32s3_bench/libFrameworkArduino.a
Indexing .pio/build/xiao_esp32s3_bench/libFrameworkArduino.a
Linking .pio/build/xiao_esp32s3_bench/firmware.elf
Retrieving maximum program size .pio/build/xiao_esp32s3_bench/firmware.elf
Checking size .pio/build/xiao_esp32s3_bench/firmware.elf
Advanced Memory Usage is available via "PlatformIO Home > Project Inspect"
RAM:   [=         ]  13.9% (used 45404 bytes from 327680 bytes)
Flash: [===       ]  28.0% (used 936725 bytes from 3342336 bytes)
Building .pio/build/xiao_esp32s3_bench/firmware.bin
esptool.py v4.11.0
Creating esp32s3 image...
Merged 2 ELF sections
Successfully created esp32s3 image.
========================= [SUCCESS] Took 6.54 seconds =========================

Environment         Status    Duration
------------------  --------  ------------
xiao_esp32s3        SUCCESS   00:00:06.917
xiao_esp32s3_bench  SUCCESS   00:00:06.536
========================= 2 succeeded in 00:00:13.453 =========================
pio exit 0
