aryankalra404/Neuryo-Headset/pcb/neuryo-rev-b/review/schematic.pdf

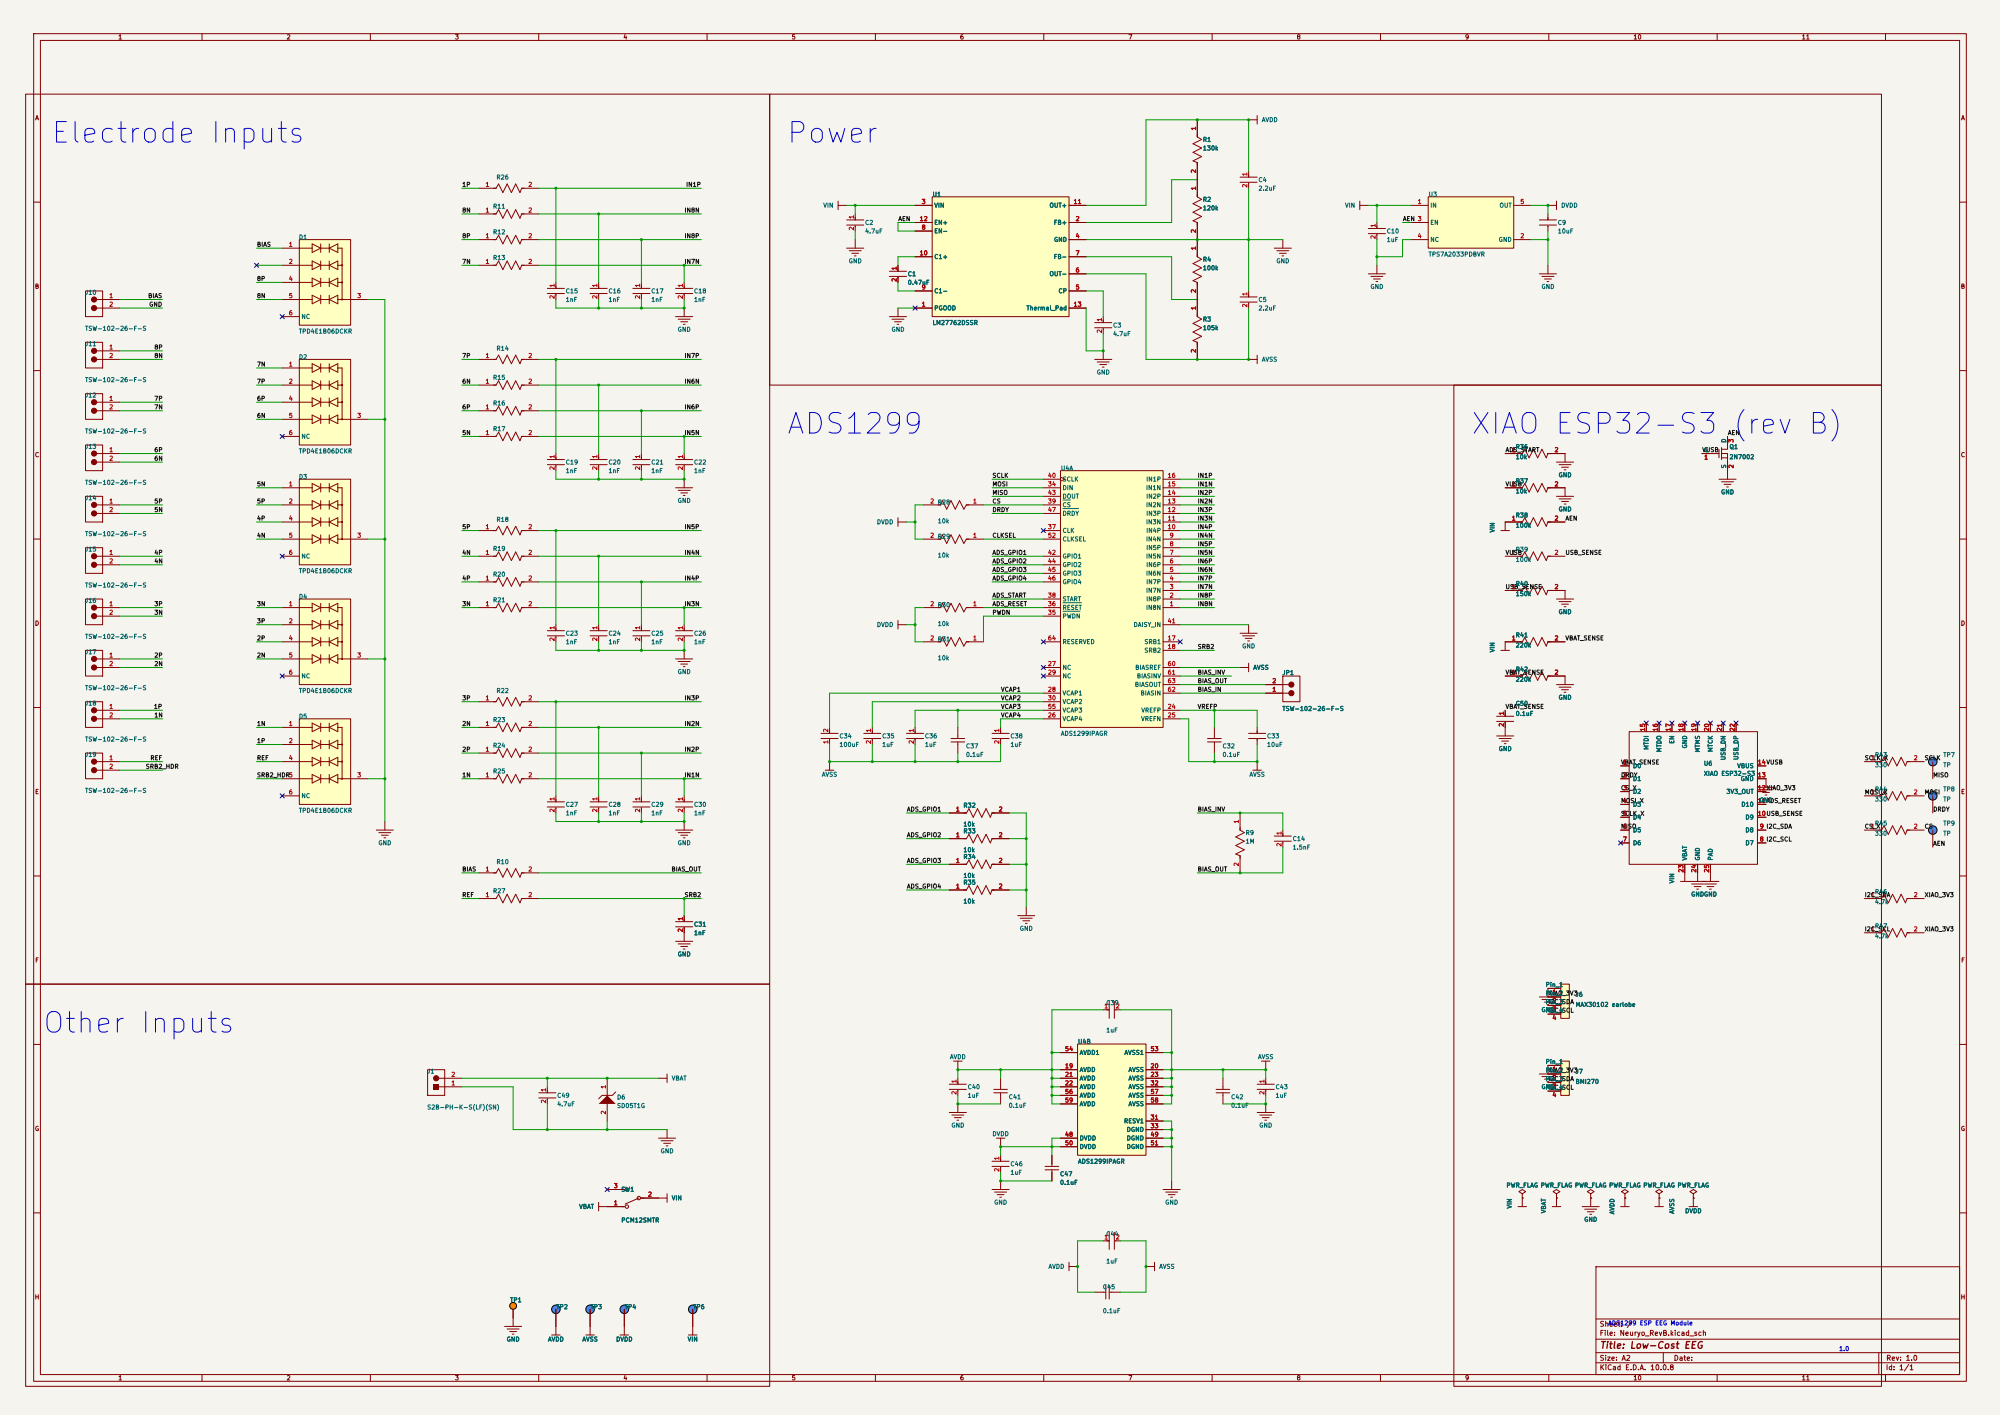
[picture p81: page 1]

ADS1299 ESP EEG Module Power

Sheet: / File: Neuryo_RevB.kicad_sch

Title: Low-Cost EEG 1.0
Size: A2 | Rev: 1.0
KiCad E.D.A. 10.0.8 | Id: 1/1
