aryankalra404/Neuryo-Headset/pcb/neuryo-rev-b/review/baseline/schematic.pdf

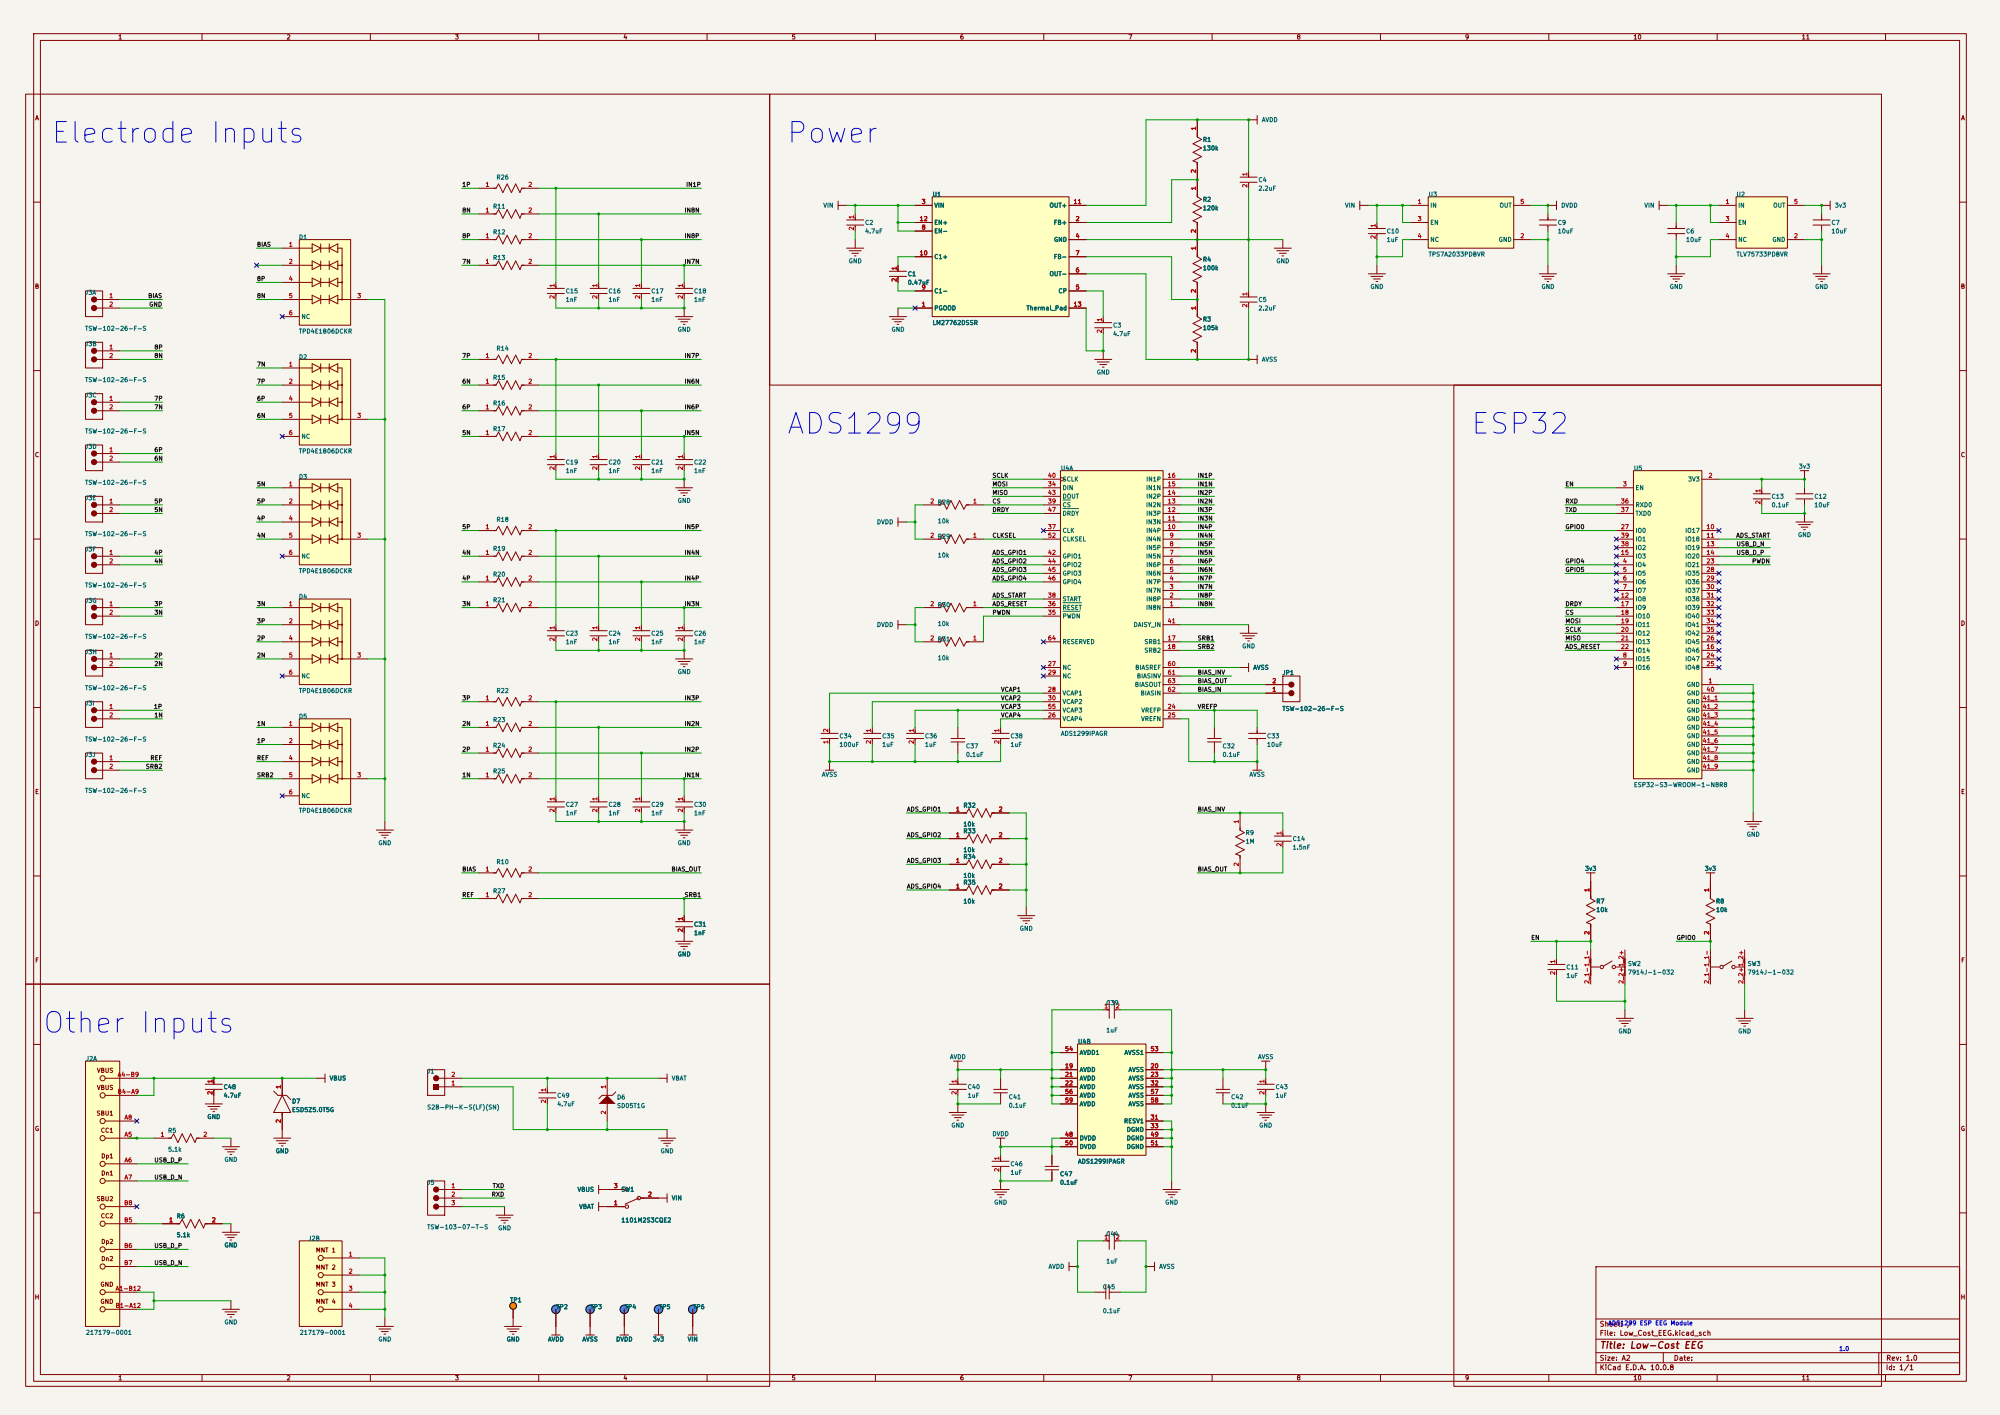
[picture p82: page 1]

1uF GND
VBUS MNT 1 MNT 2 MNT 3 MNT 4

Sheet: / File: Low_Cost_EEG.kicad_sch

Title: Low-Cost EEG

Size: A2 | Rev: 1.0
KiCad E.D.A. 10.0.8 | Id: 1/1
