aryankalra404/Neuryo-Headset/pcb/neuryo-rev-b/review/layers.pdf

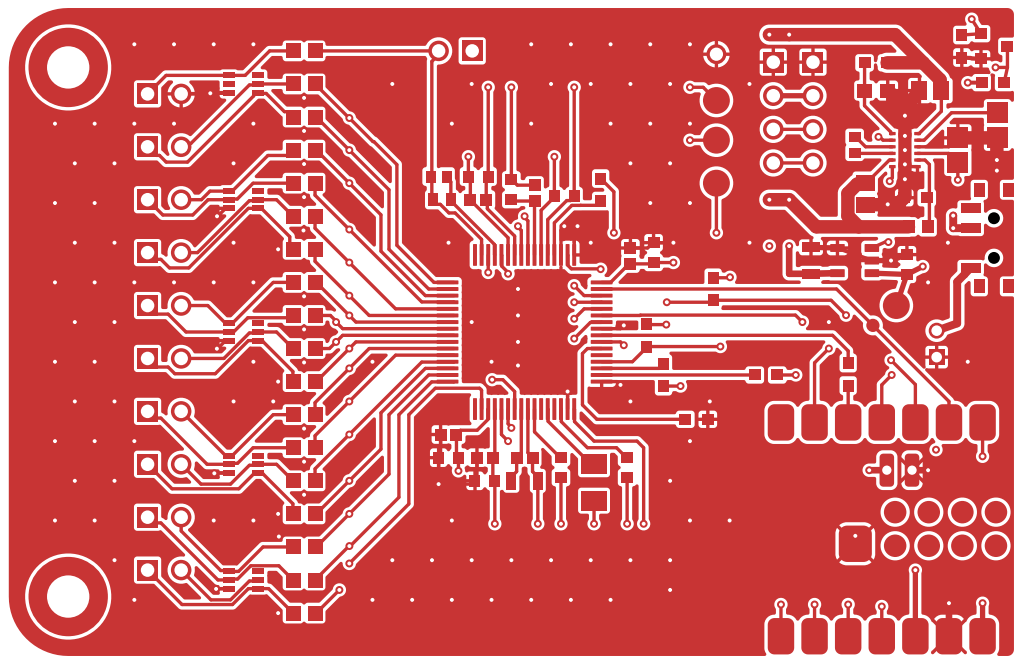
[picture p83: page 1]

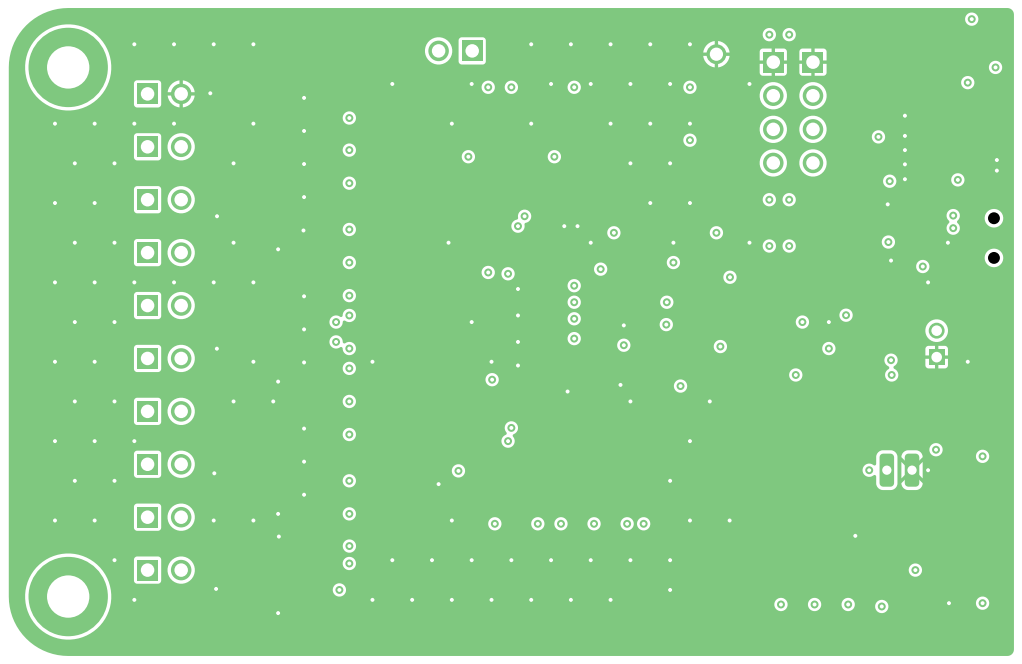
[picture p84: page 2]

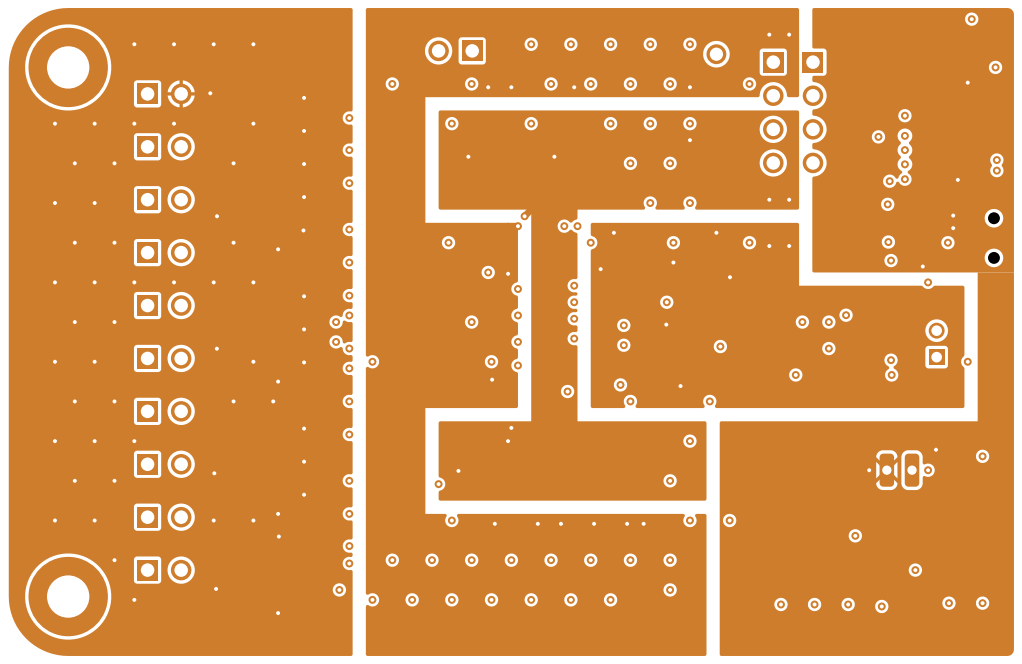
[picture p85: page 3]

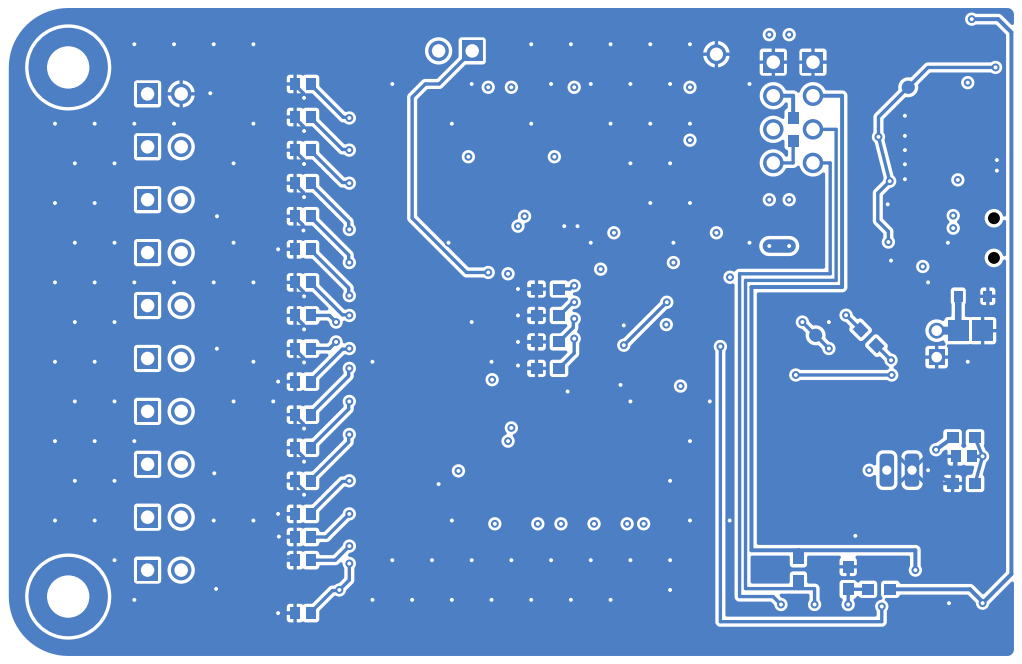
[picture p86: page 4]

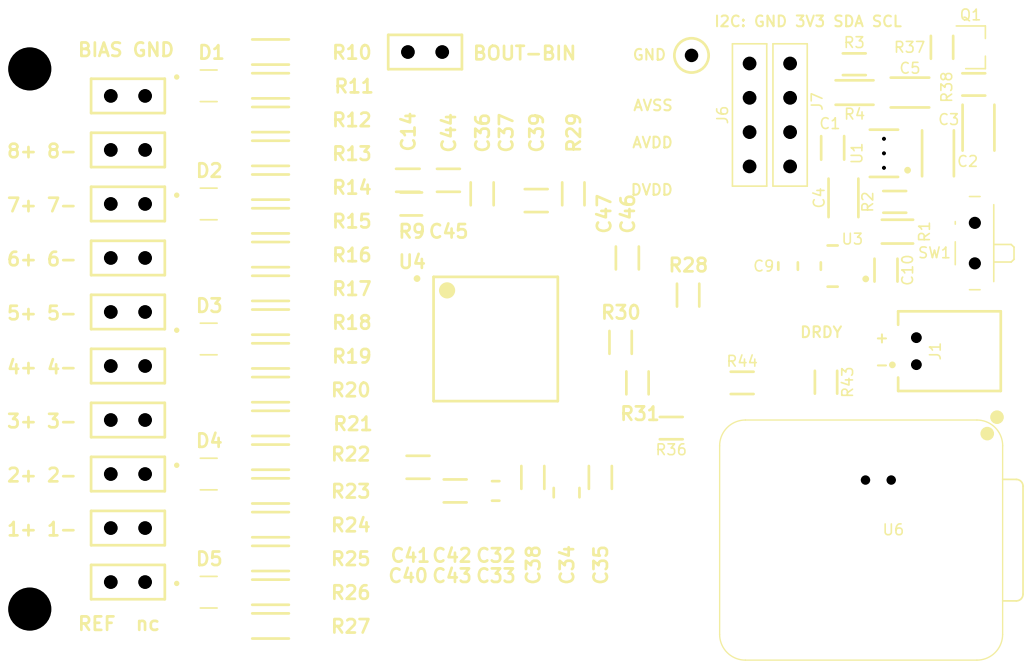
[picture p87: page 5]

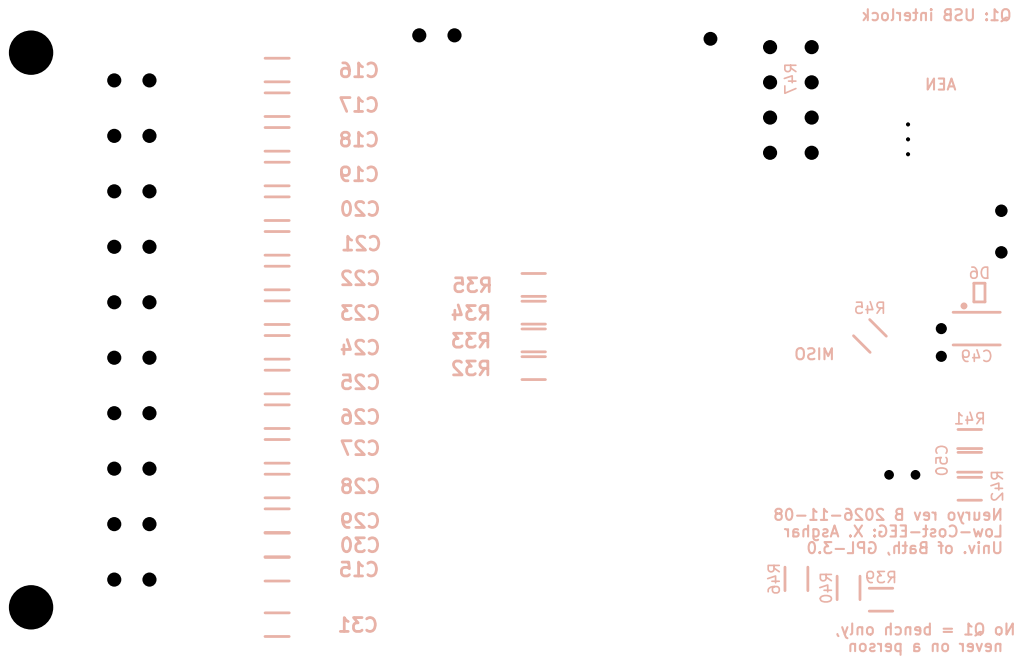
[picture p88: page 6]

2026-11-08 B rev Neuryo Asghar X. Low-Cost-EEG: GPL-3.0 Bath, of Univ. MISO

only, bench = Q1 No person a on never

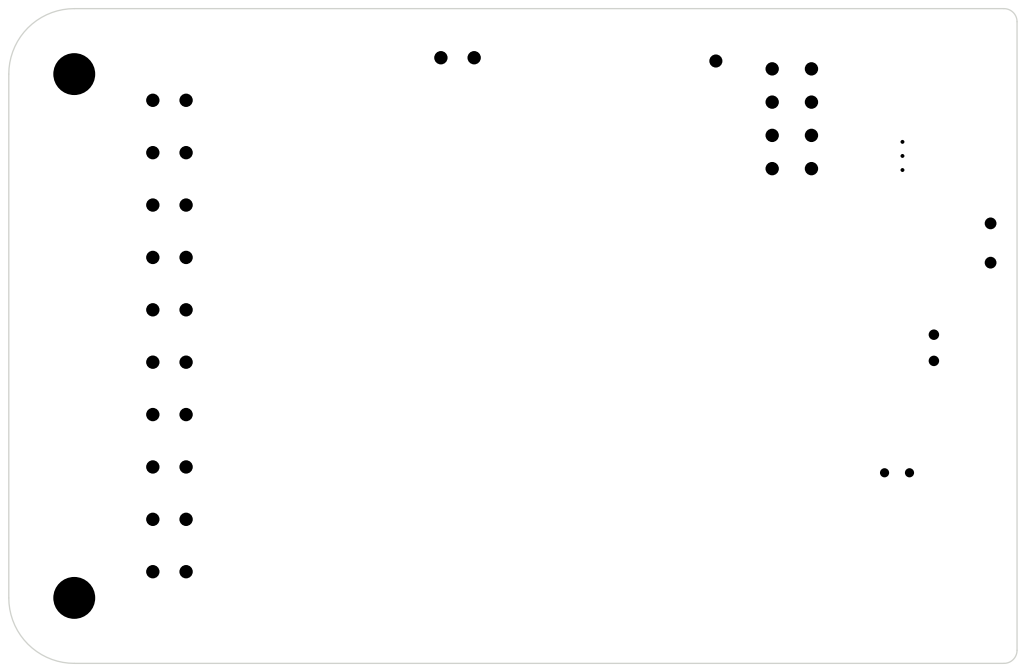
[picture p89: page 7]
