aryankalra404/Neuryo-Headset/(list of files, drawings)

Other design files:
pcb/low-cost-eeg/Hardware/PCB_Altium_Project/Component Libraries/ESP32-S3-WROOM-1-N8R8/ESP32-S3-WROOM-1-N8R8.SchLib
pcb/low-cost-eeg/Hardware/PCB_Altium_Project/Component Libraries/ESP32-S3-WROOM-1-N8R8/XCVR_ESP32S3WROOM1N8R8.PcbLib
pcb/low-cost-eeg/Hardware/PCB_Altium_Project/EEG_PCB.PcbDoc
pcb/low-cost-eeg/Hardware/PCB_Altium_Project/EEG_Schematic.SchDoc
pcb/low-cost-eeg/Hardware/PCB_Altium_Project/Low_Cost_EEG.PrjPcb
