aryankalra404/Neuryo-Headset/pcb/neuryo-rev-b/Neuryo_RevB.kicad_pcb

## KiCad design pcb/neuryo-rev-b/Neuryo_RevB.kicad_pcb (2026-11-10)

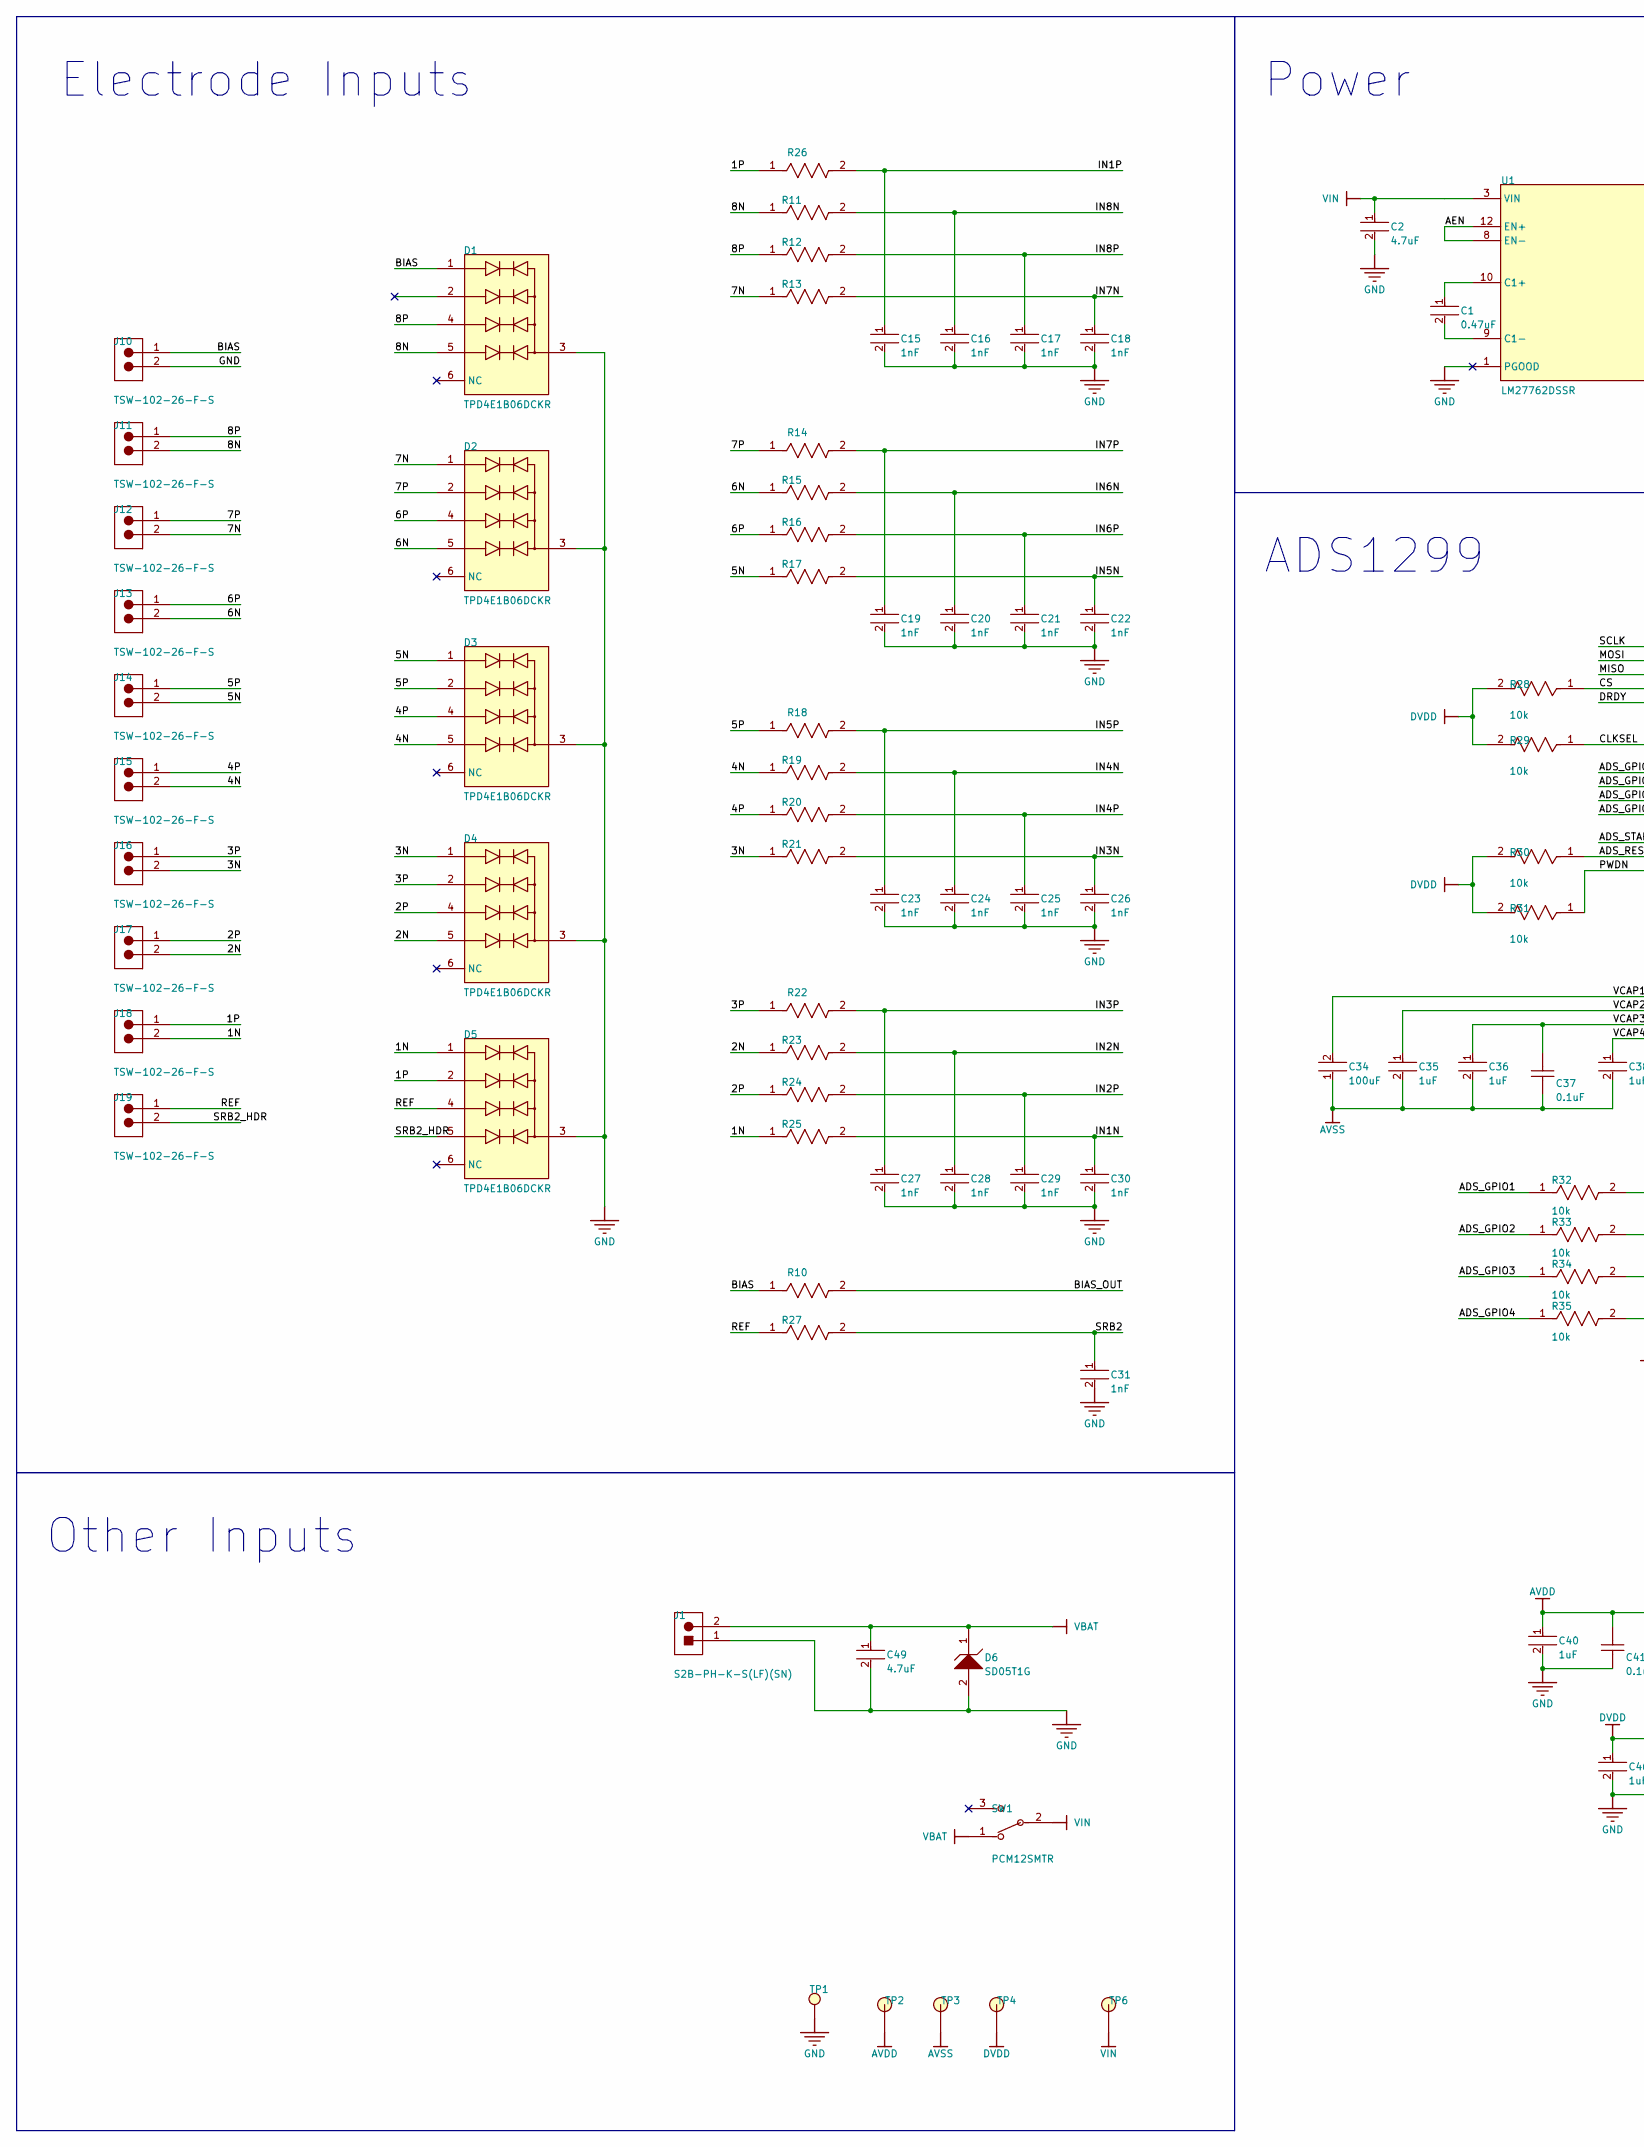
[picture p90: schematic Neuryo_RevB.kicad_sch, Low-Cost EEG, part in row 1, column 1]

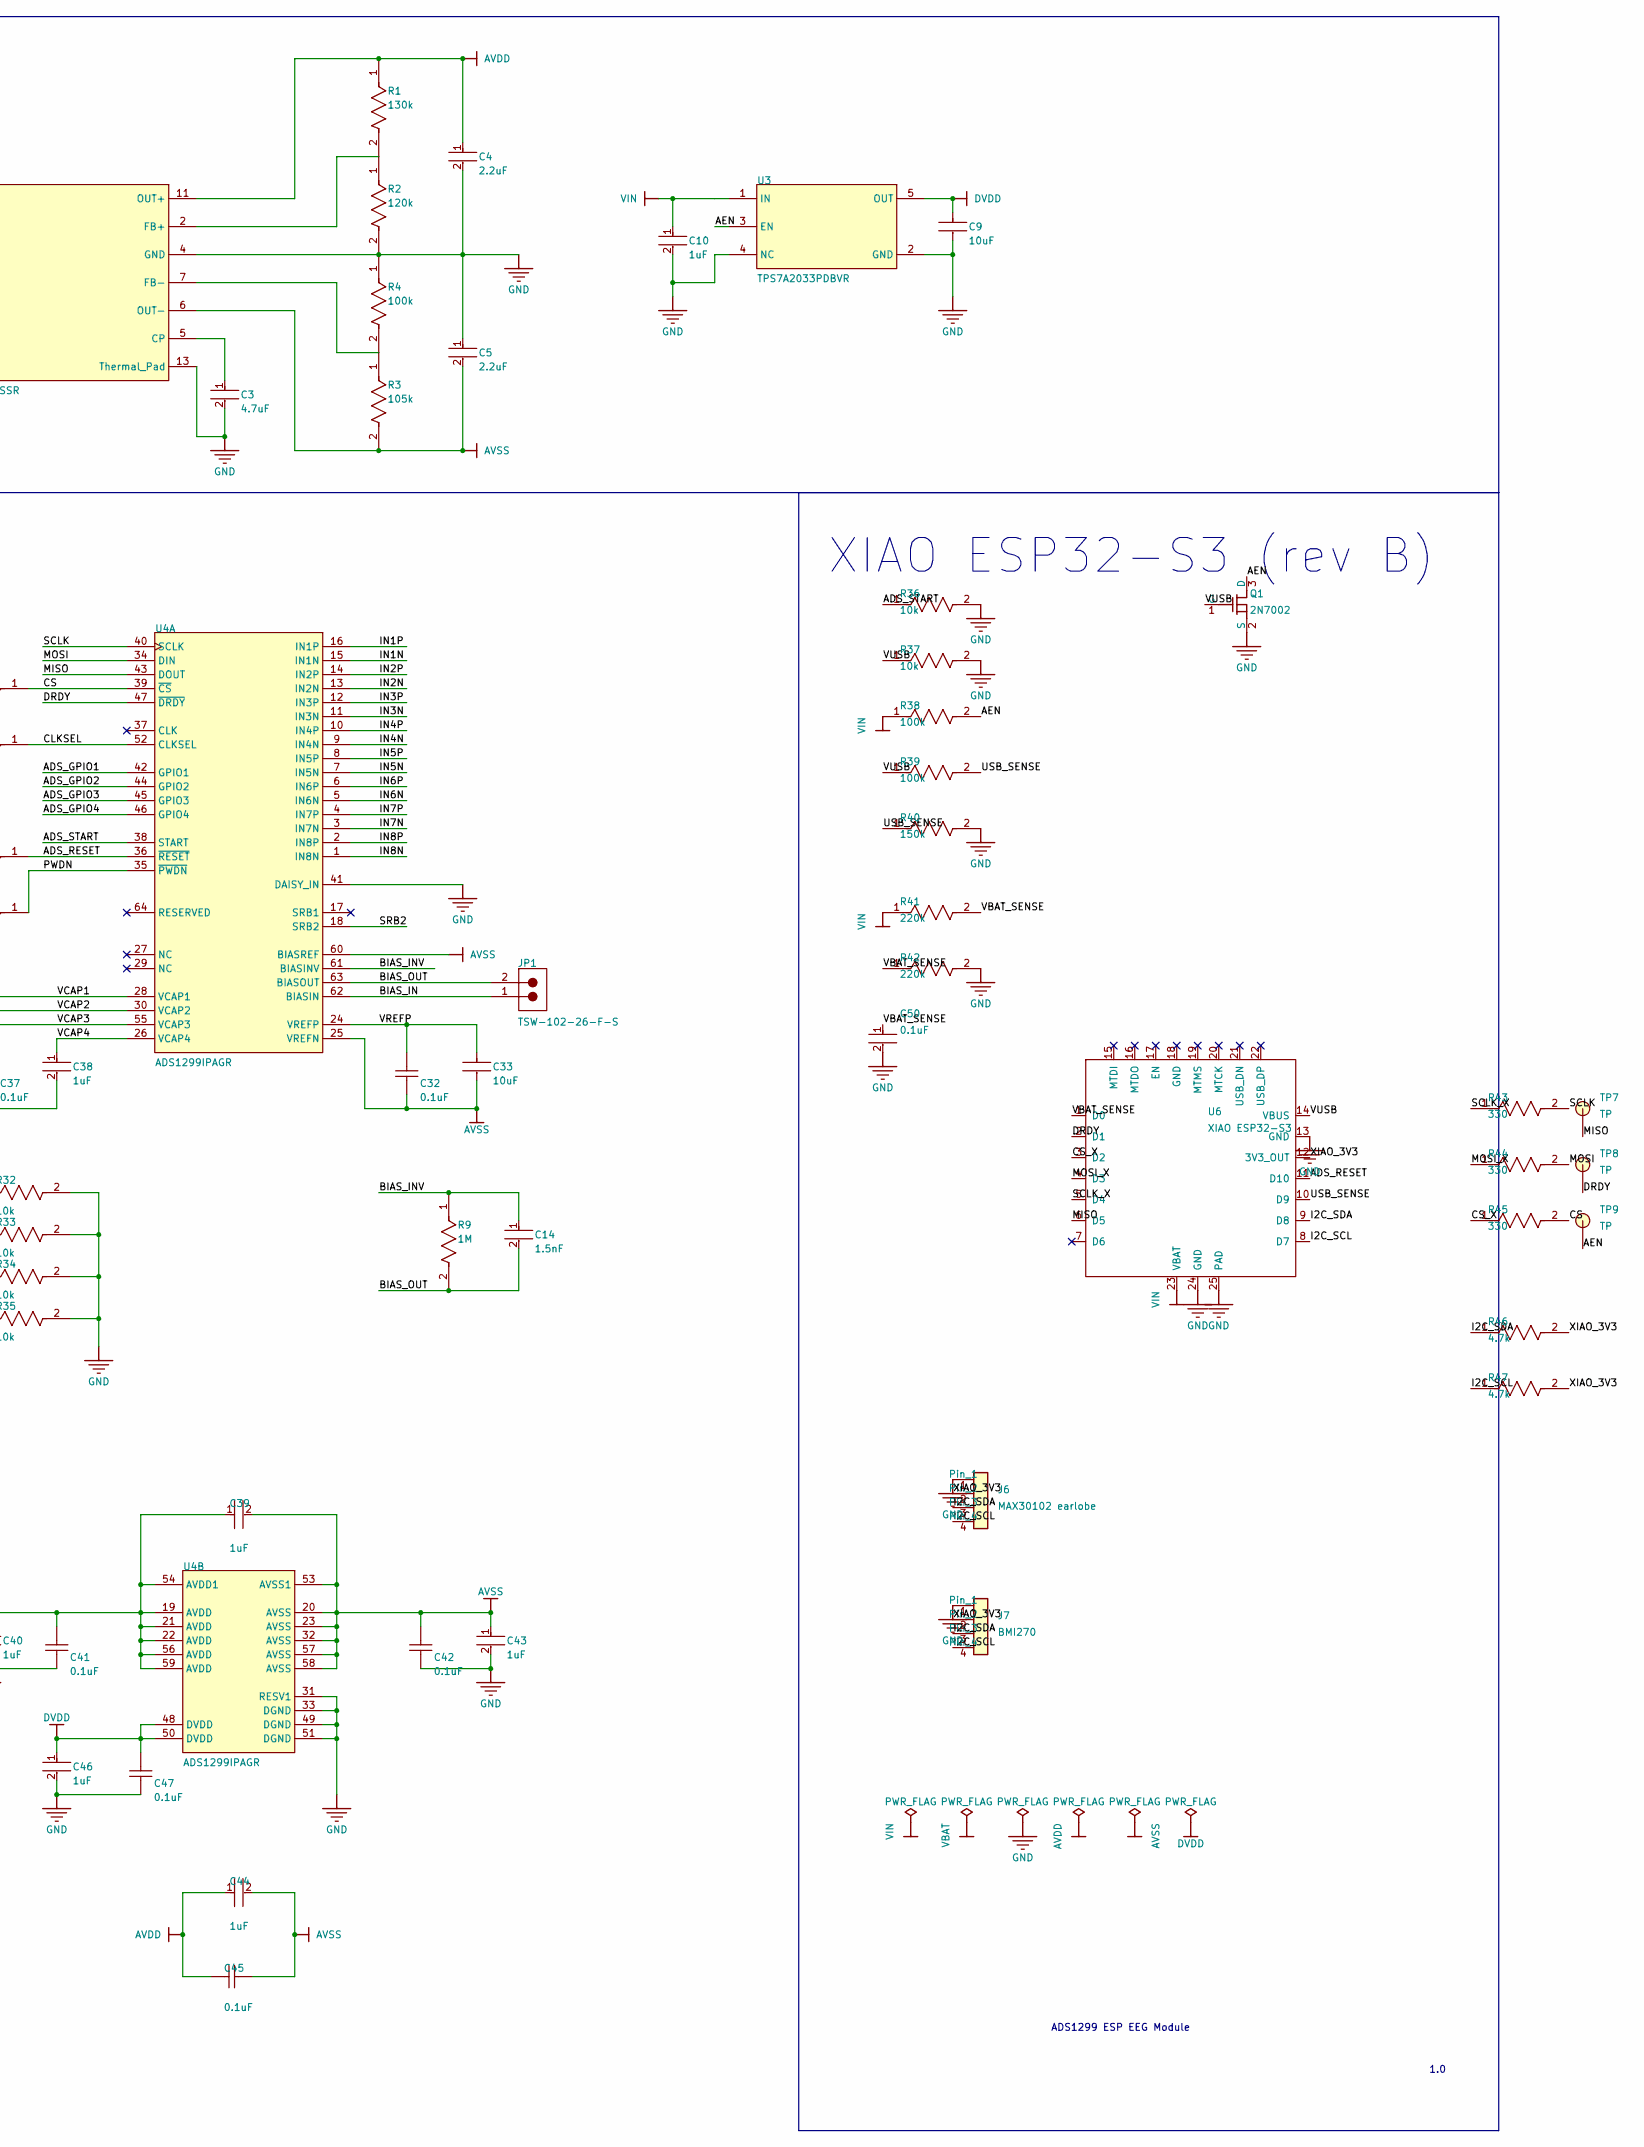
[picture p91: schematic Neuryo_RevB.kicad_sch, Low-Cost EEG, part in row 1, column 2]

Parts:
C1: 0.47uF; FP-C0603C-CF-MFG; VOLTAGE RATING 16 V; TOLERANCE 0.1; MPN KEMET C0603C474K4RACAUTO; DIGIKEY DESCRIPTION Cap Ceramic 0.47uF 16V X7R 10% Pad SMD 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
C2, C3, C49: 4.7uF; FP-GCJ21B-0_3-IPC_A; TOLERANCE 10%; VOLTAGE RATING (DC) 16V; MPN Samsung CL21B475KOFNNNE; LCSC C107365
C4, C5: 2.2uF; FP-GCM21B-0_15-IPC_B; VOLTAGE RATING (DC) 16V; TOLERANCE 10%; MPN Murata GCM21BR71C225KA64K; LCSC C1852484
C9, C33: 10uF; FP-GRJ21B-0_3-0_2-MFG; MPN Samsung CL21A106KAYNNNE; LCSC C15850
C10, C35, C36, C38, C39, C40, C43, C44, C46: 1uF; FP-CC0603-DA-MFG; TOLERANCE 0.1; VOLTAGE 16 V; MPN Yageo CC0603KRX7R7BB105; DIGIKEY DESCRIPTION CAP CER 1UF 16V X7R 0603
C14: 1.5nF; FP-C0603C-CF-MFG; VOLTAGE RATING 100 V; TOLERANCE 0.05; MPN Murata GRM1885C1H152JA01D; DIGIKEY DESCRIPTION CAP CER 1500PF 100V NP0 0603
C15, C16, C17, C18, C19, C20, C21, C22, C23, C24, C25, C26, C27, C28, C29, C30, C31: 1nF; FP-C0603C-CF-MFG; VOLTAGE RATING 50 V; TOLERANCE 0.01; MPN Murata GRM1885C1H102FA01D; DIGIKEY DESCRIPTION CAP CER 1000PF 50V 1% NP0 0603
C32, C37, C41, C42, C45, C47: 0.1uF; CAPC1608X87X45LL20T05; MPN KEMET C0603C104J4RACTU; LCSC C22401913
C34: 100uF; FP-GRM31C-0_3-e0_3_0_8-IPC_B; MPN Murata GRM31CR61A107MEA8L; LCSC C883598
C50: 0.1uF; FP-C0603C-CF-MFG; MPN YAGEO CC0603KRX7R9BB104; LCSC C14663
D1, D2, D3, D4, D5: TPD4E1B06DCKR; TVS_TPD4E1B06DCKR; MPN Texas Instruments TPD4E1B06DCKR; LCSC C840093
D6: SD05T1G; ONSC-SOD-323-2-477-02_G_V; MPN onsemi SD05T1G; LCSC C233423
J1: S2B-PH-K-S(LF)(SN); JST-S2B-PH-K-S_V; TOLERANCE 20%; VOLTAGE RATING (DC) 50 V; MPN JST S2B-PH-K-S(LF)(SN)
J6: MAX30102 earlobe; PinHeader_1x04_P2.54_TSW; MPN Samtec TSW-104-07-T-S or leads soldered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
J7: BMI270; PinHeader_1x04_P2.54_TSW; MPN Samtec TSW-104-07-T-S or leads soldered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
J10, J11, J12, J13, J14, J15, J16, J17, J18, J19: TSW-102-26-F-S; SMTC-TSW-102-26-XX-S; MPN Samtec TSW-102-26-F-S
JP1: TSW-102-26-F-S; SMTC-TSW-102-26-XX-S; MPN Samtec TSW-102-26-F-S
Q1: 2N7002; SOT-23; MPN Nexperia 2N7002,215; LCSC C65189
R1: 130k; FP-MCT0603-IPC_B; VOLTAGE RATING (DC) 50V; TOLERANCE 0.1%; MPN Yageo RT0603BRD07130KL; LCSC C861109
R2: 120k; FP-RT0603-MFG; TOLERANCE 0.001; VOLTAGE RATING 75V; MPN Yageo RT0603BRD07120KL; MOUSER DESCRIPTION Thin Film Resistors - SMD 1/10W 120K oh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
R3: 105k; FP-RT0603-MFG; POWER RATING 0.1W; VOLTAGE RATING 75V; MPN Yageo RT0603BRD07105KL; MOUSER DESCRIPTION Thin Film Resistors 1/10W 105K ohm .1% 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
R4: 100k; FP-AT0603-IPC_A; RATINGS AEC-Q200; TOLERANCE 0.1%; MPN Yageo AT0603BRD07100KL; LCSC C855559
R9: 1M; FP-MCT0603-MFG; TOLERANCE 1%; MPN UNI-ROYAL 0603WAF1004T5E; LCSC C22935
R10: 51k; FP-MCT0603-IPC_A; TOLERANCE 0.1%; MPN Yageo RT0603BRD0751KL; LCSC C861458
R11, R12, R13, R14, R15, R16, R17, R18, R19, R20, R21, R22, R23, R24, R25, R26, R27: 2.2k; FP-MCT0603-IPC_A; TOLERANCE 0.1%; MPN Yageo RT0603BRD072K2L; LCSC C861295
R28, R29, R30, R31, R32, R33, R34, R35, R36, R37: 10k; FP-AC0603-MFG; MPN UNI-ROYAL 0603WAF1002T5E; LCSC C25804
R38, R39: 100k; FP-AC0603-MFG; MPN UNI-ROYAL 0603WAF1003T5E; LCSC C25803
R40: 150k; FP-AC0603-MFG; MPN UNI-ROYAL 0603WAF1503T5E; LCSC C22807
R41, R42: 220k; FP-AC0603-MFG; MPN UNI-ROYAL 0603WAF2203T5E; LCSC C22961
R43, R44, R45: 330; FP-AC0603-MFG; MPN UNI-ROYAL 0603WAF3300T5E; LCSC C23138
R46, R47: 4.7k; FP-AC0603-MFG; MPN UNI-ROYAL 0603WAF4701T5E; LCSC C23162
SW1: PCM12SMTR; SW_SPDT_PCM12; MPN C&K PCM12SMTR; LCSC C221841
TP1: KSTN-5003; FORWARD VOLTAGE 1.08 V; MPN Keystone 5003
TP2, TP3, TP4, TP6: TP; TP_SMD_2mm
TP7, TP8, TP9: TP; TP_SMD_D1.0; MPN (copper test pad, not assembled)
U1: LM27762DSSR; FP-DSS0012B-MFG; MPN Texas Instruments LM27762DSSR; LCSC C473398
U3: TPS7A2033PDBVR; FP-DBV0005A-MFG; MPN Texas Instruments TPS7A2033PDBVR; LCSC C2862740
U4: ADS1299IPAGR; PAG0064A_M; MPN Texas Instruments ADS1299IPAGR; LCSC C476817
U6: XIAO ESP32-S3; XIAO-ESP32-S3-SMD; MPN Seeed Studio XIAO ESP32-S3 (113991114)

Connections:
1N: D5.1 (IO1), J18.2, R25.1
1P: D5.2 (IO2), J18.1, R26.1
2N: D4.5 (IO4), J17.2, R23.1
2P: D4.4 (IO3), J17.1, R24.1
3N: D4.1 (IO1), J16.2, R21.1
3P: D4.2 (IO2), J16.1, R22.1
4N: D3.5 (IO4), J15.2, R19.1
4P: D3.4 (IO3), J15.1, R20.1
5N: D3.1 (IO1), J14.2, R17.1
5P: D3.2 (IO2), J14.1, R18.1
6N: D2.5 (IO4), J13.2, R15.1
6P: D2.4 (IO3), J13.1, R16.1
7N: D2.1 (IO1), J12.2, R13.1
7P: D2.2 (IO2), J12.1, R14.1
8N: D1.5 (IO4), J11.2, R11.1
8P: D1.4 (IO3), J11.1, R12.1
ADS_GPIO1: R32.1, U4.42 (GPIO1)
ADS_GPIO2: R33.1, U4.44 (GPIO2)
ADS_GPIO3: R34.1, U4.45 (GPIO3)
ADS_GPIO4: R35.1, U4.46 (GPIO4)
ADS_RESET: R30.1, U4.36 (~RESET), U6.11 (D10)
ADS_START: R36.1, U4.38 (START)
AEN: Q1.3 (D), R38.2, TP9.1, U1.8 (EN-), U1.12 (EN+), U3.3 (EN)
AVDD: C4.1, C39.1, C40.1, C41.2, C44.1, C45.2, R1.1, TP2.1, U1.11 (OUT+), U4.19 (AVDD), U4.21 (AVDD), U4.22 (AVDD), U4.54 (AVDD1), U4.56 (AVDD), U4.59 (AVDD)
AVSS: C5.2, C32.1, C33.2, C34.1, C35.2, C36.2, C37.1, C38.2, C39.2, C42.2, C43.1, C44.2, C45.1, R3.2, TP3.1, U1.6 (OUT-), U4.20 (AVSS), U4.23 (AVSS), U4.25 (VREFN), U4.32 (AVSS), U4.53 (AVSS1), U4.57 (AVSS), U4.58 (AVSS), U4.60 (BIASREF)
BIAS: D1.1 (IO1), J10.1, R10.1
BIAS_IN: JP1.1, U4.62 (BIASIN)
BIAS_INV: C14.1, R9.1, U4.61 (BIASINV)
BIAS_OUT: C14.2, JP1.2, R9.2, R10.2, U4.63 (BIASOUT)
CLKSEL: R29.1, U4.52 (CLKSEL)
CS: R28.1, R45.2, U4.39 (~CS)
CS_X: R45.1, U6.3 (D2)
DRDY: TP8.1, U4.47 (~DRDY), U6.2 (D1)
DVDD: C9.1, C46.1, C47.2, R28.2, R29.2, R30.2, R31.2, TP4.1, U3.5 (OUT), U4.48 (DVDD), U4.50 (DVDD)
GND: C2.2, C3.2, C4.2, C5.1, C9.2, C10.2, C15.2, C16.2, C17.2, C18.2, C19.2, C20.2, C21.2, C22.2, C23.2, C24.2, C25.2, C26.2, C27.2, C28.2, C29.2, C30.2, C31.2, C40.2, C41.1, C42.1, C43.2, C46.2, C47.1, C49.2, C50.2, D1.3 (GND), D2.3 (GND), D3.3 (GND), D4.3 (GND), D5.3 (GND), D6.2 (A), J1.1, J6.1, J7.1, J10.2, Q1.2 (S), R2.2, R4.1, R32.2, R33.2, R34.2, R35.2, R36.2, R37.2, R40.2, R42.2, TP1.1, U1.1 (PGOOD), U1.4 (GND), U1.13 (Thermal_Pad), U3.2 (GND), U3.4 (NC), U4.31 (RESV1), U4.33 (DGND), U4.41 (DAISY_IN), U4.49 (DGND), U4.51 (DGND), U6.13 (GND), U6.24 (GND), U6.25 (PAD)
I2C_SCL: J6.4, J7.4, R47.1, U6.8 (D7)
I2C_SDA: J6.3, J7.3, R46.1, U6.9 (D8)
IN1N: C30.1, R25.2, U4.15 (IN1N)
IN1P: C15.1, R26.2, U4.16 (IN1P)
IN2N: C28.1, R23.2, U4.13 (IN2N)
IN2P: C29.1, R24.2, U4.14 (IN2P)
IN3N: C26.1, R21.2, U4.11 (IN3N)
IN3P: C27.1, R22.2, U4.12 (IN3P)
IN4N: C24.1, R19.2, U4.9 (IN4N)
IN4P: C25.1, R20.2, U4.10 (IN4P)
IN5N: C22.1, R17.2, U4.7 (IN5N)
IN5P: C23.1, R18.2, U4.8 (IN5P)
IN6N: C20.1, R15.2, U4.5 (IN6N)
IN6P: C21.1, R16.2, U4.6 (IN6P)
IN7N: C18.1, R13.2, U4.3 (IN7N)
IN7P: C19.1, R14.2, U4.4 (IN7P)
IN8N: C16.1, R11.2, U4.1 (IN8N)
IN8P: C17.1, R12.2, U4.2 (IN8P)
MISO: TP7.1, U4.43 (DOUT), U6.6 (D5)
MOSI: R44.2, U4.34 (DIN)
MOSI_X: R44.1, U6.4 (D3)
NetC1_1: C1.1, U1.10 (C1+)
NetC1_2: C1.2, U1.9 (C1-)
NetC3_1: C3.1, U1.5 (CP)
NetR1_2: R1.2, R2.1, U1.2 (FB+)
NetR3_1: R3.1, R4.2, U1.7 (FB-)
PWDN: R31.1, U4.35 (~PWDN)
REF: D5.4 (IO3), J19.1, R27.1
SCLK: R43.2, U4.40 (SCLK)
SCLK_X: R43.1, U6.5 (D4)
SRB2: C31.1, R27.2, U4.18 (SRB2)
SRB2_HDR: D5.5 (IO4), J19.2
USB_SENSE: R39.2, R40.1, U6.10 (D9)
VBAT: C49.1, D6.1 (K), J1.2, SW1.1
VBAT_SENSE: C50.1, R41.2, R42.1, U6.1 (D0)
VCAP1: C34.2, U4.28 (VCAP1)
VCAP2: C35.1, U4.30 (VCAP2)
VCAP3: C36.1, C37.2, U4.55 (VCAP3)
VCAP4: C38.1, U4.26 (VCAP4)
VIN: C2.1, C10.1, R38.1, R41.1, SW1.2 (COMM), TP6.1, U1.3 (VIN), U3.1 (IN), U6.23 (VBAT)
VREFP: C32.2, C33.1, U4.24 (VREFP)
VUSB: Q1.1 (G), R37.1, R39.1, U6.14 (VBUS)
XIAO_3V3: J6.2, J7.2, R46.2, R47.2, U6.12 (3V3_OUT)

Notes on the sheet:
XIAO ESP32-S3 (rev B)
Electrode Inputs
ADS1299 ESP EEG Module
Other Inputs
ADS1299
${REVISION}
Power

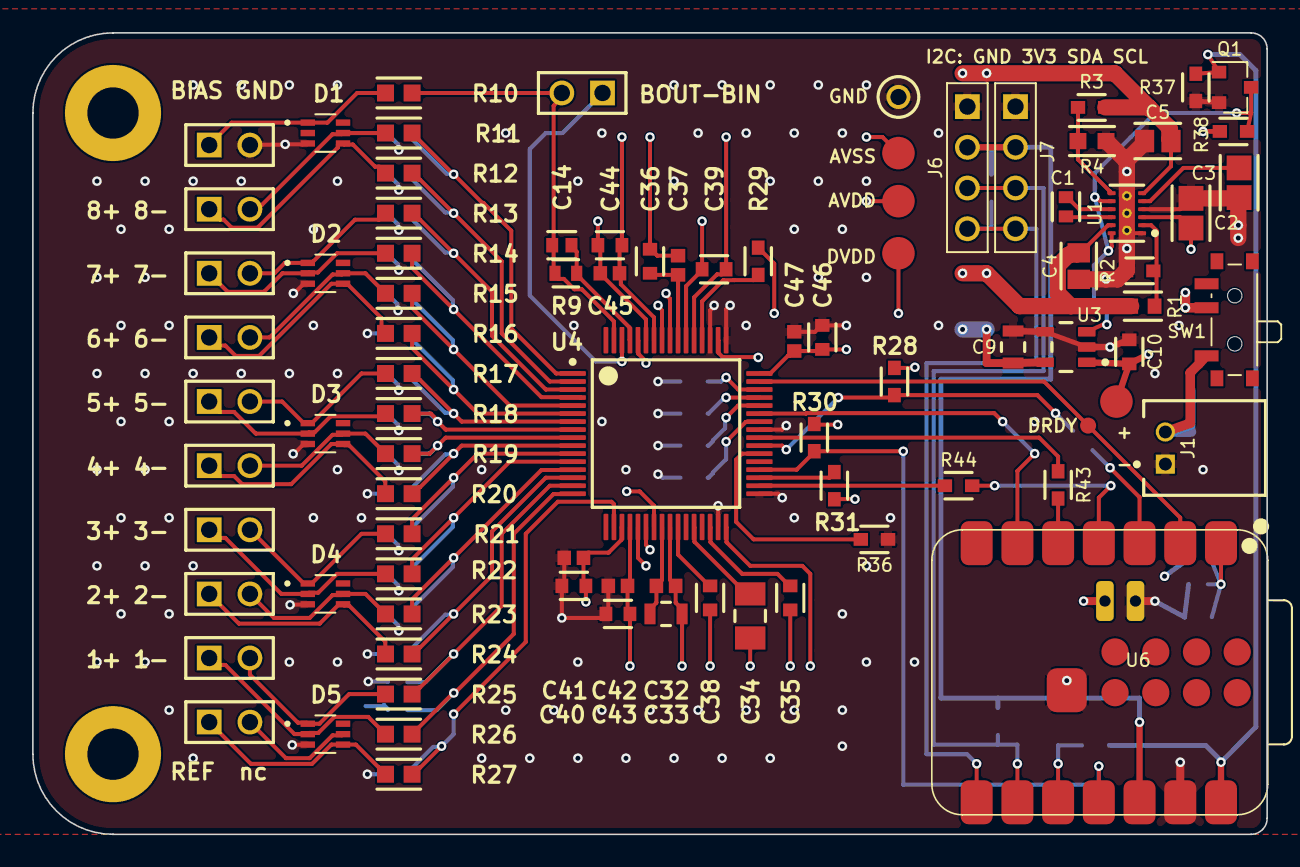
[picture p92: board Neuryo_RevB.kicad_pcb from above]

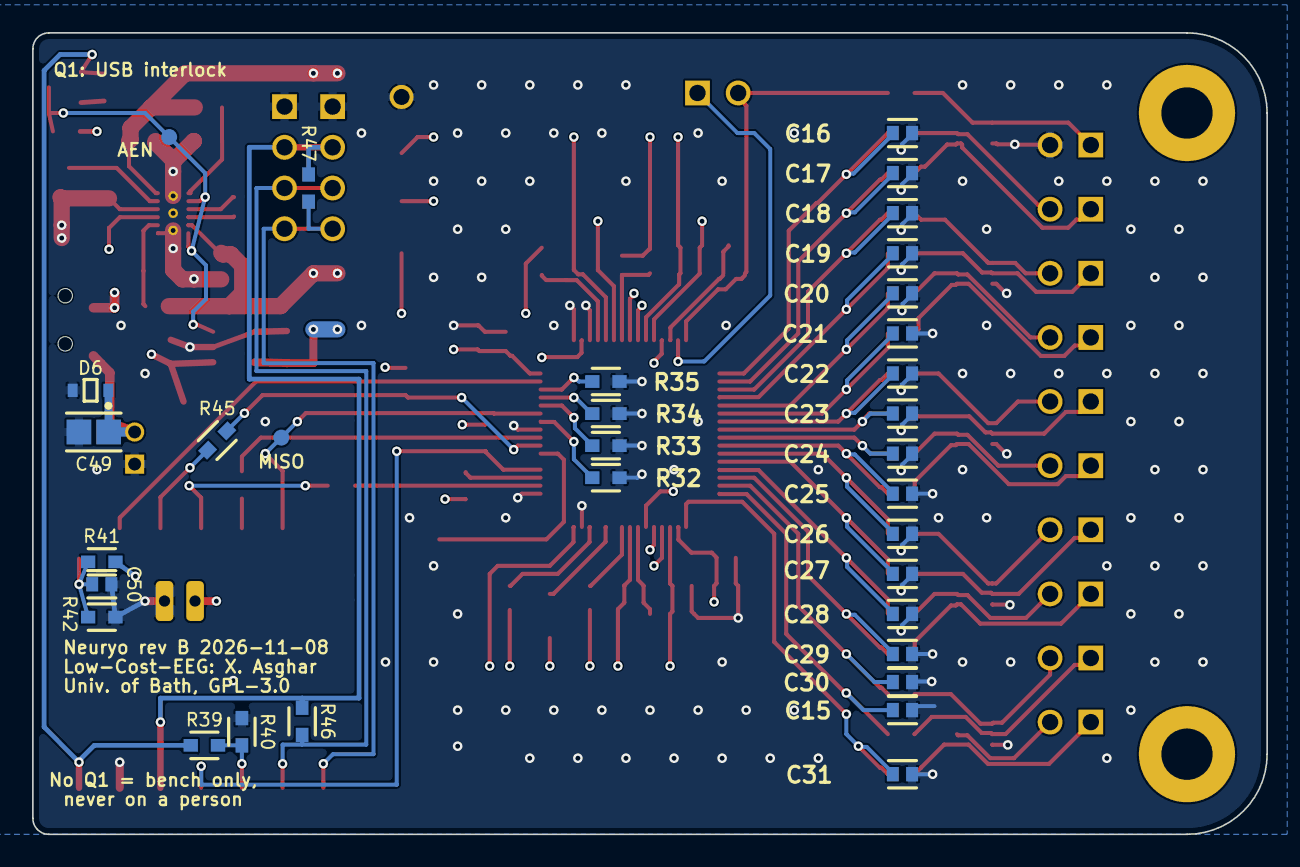
[picture p93: board Neuryo_RevB.kicad_pcb from below]

Board: 4 copper layers, 77.0 x 50.0 mm, 120 parts (33 on the bottom side), 78 nets.
