aryankalra404/Neuryo-Headset/pcb/neuryo-rev-b/review/copper-and-placement-diff.txt

FOOTPRINTS
  removed C11 (84.75, 45.25)
  removed C12 (81.75, 47.75)
  removed C13 (79.5, 48.0)
  removed C48 (89.32, 28.0)
  removed C6 (87.75, 20.95)
  removed C7 (80.5, 21.0)
  removed D7 (89.25, 30.5)
  removed J2 (95.85, 36.57)
  removed J5 (54.0, 46.25)
  removed R5 (88.75, 37.75)
  removed R6 (88.75, 34.5)
  removed R7 (84.85, 43.25)
  removed R8 (54.25, 34.75)
  removed SW2 (81.5, 39.25)
  removed SW3 (54.5, 39.25)
  removed TP5 (75.5, 26.5)
  removed U2 (83.8, 20.95)
  removed U5 (68.0, 43.91)
  removed hole@95,45 (95.0, 45.0)
  removed hole@95,5 (95.0, 5.0)
  added   C50 (72.7, 34.4, '180', 'B.Cu')
  added   J6 (58.3, 4.6, '-90', 'F.Cu')
  added   J7 (61.3, 4.6, '-90', 'F.Cu')
  added   Q1 (75.0, 3.4, '0', 'F.Cu')
  added   R36 (52.5, 31.6, '0', 'F.Cu')
  added   R37 (72.55, 3.4, '-90', 'F.Cu')
  added   R38 (74.9, 6.15, '0', 'F.Cu')
  added   R39 (66.3, 44.45, '180', 'B.Cu')
  added   R40 (63.96, 43.6, '90', 'B.Cu')
  added   R41 (72.7, 33.0, '0', 'B.Cu')
  added   R42 (72.7, 36.45, '180', 'B.Cu')
  added   R43 (63.96, 28.2, '90', 'F.Cu')
  added   R44 (57.75, 28.25, '180', 'F.Cu')
  added   R45 (65.5, 25.43, '135', 'B.Cu')
  added   R46 (60.2, 42.95, '90', 'B.Cu')
  added   R47 (59.8, 9.68, '90', 'B.Cu')
  added   TP7 (61.5, 25.25, '0', 'B.Cu')
  added   TP8 (65.83, 24.5, '0', 'F.Cu')
  added   TP9 (68.5, 6.5, '0', 'B.Cu')
  added   U6 (56.0, 31.0, '-90', 'F.Cu')
  moved   C10 (87.95, 11.95, '90', 'F.Cu') -> (68.4, 19.9, '90', 'F.Cu')
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
VIAS added 23  analog half: [('ADS_RESET', (54.3, 26.1))]
VIAS kept but net renamed: [((66.25, 10.25), 'VIN', 'AEN'), ((67.1, 13.6), 'VIN', 'AEN'), ((25.5, 44.5), 'SRB1', 'SRB2'), ((67.25, 28.25), 'MOSI', 'MOSI_X'), ((60.0, 28.25), 'MOSI', 'MOSI_X')]
