aryankalra404/Neuryo-Headset/(commit log)

2026-10-28 AR: pick up the headset or single electrode pods by hand; Reset puts them back
2026-10-29 Add design picker and v2 headset model from the 29 Oct research plan
    - Start page lists every design from designs/designs.json and switches
    between them in place (#v1, #v2 deep links).
    - v1 (26 Oct design) moved unchanged to designs/v1/.
    - v2: 6 channels (Fp1, Fp2, Fz, Pz, TP10, VEOG), TP9 reference alone,
    Fpz bias, hydrogel forehead snaps, semi-dry Fz/Pz pods, adhesive gel
    ear and eye pads, earlobe MAX30102 clip, ADS1299-6. Specs and sources
    cite the Neuryo-Research decisions.
    - README: links per design and how to add a new one.
2026-10-29 v2: realistic mannequin head with 10-20 measured electrode sites
    - Head, ears, neck and shoulders from the MakeHuman base mesh (CC0),
    smoothed and scaled to a 540 mm head circumference (Indian adult
    male/female mean midpoint).
    - Electrode sites measured on that head with the 10-20 rules (nasion,
    inion, preauricular points, midline and coronal arcs, circumference).
    TP9/TP10 slid 15 mm back along their ring to clear the ear.
    - Band now runs above the ears and round the occiput; TP9/TP10 pads hang
    on short leads; earlobe clip sits on the measured lobe; battery moved
    onto the band.
    - tools/: scripts that rebuild head.glb and head.json.
2026-10-29 Shared mannequin head with all 10-10 sites, clean bust cuts, and docs
    - designs/shared/head/: one head for every design, with 77 measured
    10-10 positions plus ear-clearing TP9/TP10 and below-eye EOG spots.
    v2 now loads it from there and picks sites by name.
    - Bust: smooth first, then cut flat at chest and shoulders, with crisp
    edges instead of the wavy cut.
    - v2: "All sites" toggle shows every measured position on the head.
    - docs/: v1.md, v2.md (every change from v1 with decision and evidence
    IDs), head.md (how the head was made, how to use it, all positions).
    - Start page: "Design notes" link for the open design.
    - tools/: updated head build scripts.
2026-10-29 v1: move onto the shared mannequin head
    v1 keeps its 26 Oct layout (AF7, AF8, Fz, Pz, sponge pods, mastoid pods
    on the band, forehead heart sensor) but now uses the shared MakeHuman
    head with sites at their measured 10-10 positions. Mastoid pods use the
    ear-clearing TP9/TP10 spots. Docs updated.
2026-10-29 Front module follows the eyebrow line on the new head (v1 and v2)
    The module height was carried over from the old formula head, so on the
    new head its lower edge covered the eyes. Its lower edge now follows the
    eyebrow line (shared head browY, about 16 mm above the eye centres), and
    the module centre and status LED are set from it. Electrode positions
    are unchanged.
2026-10-29 Add v3 headset model from the 29 Oct review
    - designs/v3: 8-channel ADS1299 at gain 12, M1 mastoid-bone reference on SRB2,
    M2 channel, one 4 mm snap socket per site with swappable inserts (paste,
    semi-dry, dry test arms), sliding Fz/Pz mounts, earlobe lead in front of the ear
    - Test kit toggle (ECG pads on ch 7, insert picker), Confidence colours,
    v2 sites ghost, Channels tab, updated board guide and electrode build
    - Shared head: M1/M2 measured by tools/mastoid.py (head.json extra)
    - docs/v3.md with spec, channel map, changes from v2 and how sure each is;
    v2 marked superseded
2026-10-29 v3 page: build pack, changes, shareable links, measure, cleaner controls
    - Controls: Product/Test kit mode switch, Display menu for overlays, bottom bar
    for views + explode + Measure + Guides menu, keyboard shortcuts
    - Details: Build tab (parts list matching the revised budget, wiring table that
    lights up each lead, tests with pass marks) and Changes tab (every change from
    v2 with reason and confidence, click to see it); part cards show confidence and
    what to buy
    - Copy link: address keeps part, view, mode, inserts and overlays; the start page
    passes #v3/<state> through to the design
    - Labels no longer overlap; two-point measure tool; first-visit how-to card
    - Confidence colours ke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
2026-11-07 v4 product design: launch headset, fit & finish, session walkthrough
    - designs/v4: 7 channels on the head (adds Cz on ch 7, ECG to ch 8),
    single-use 3-pad hydrogel forehead strip, semi-dry pods in wipe-clean
    caps, S/M/L frames with rear fit dial, removable knit cover, BMI270,
    1000 mAh battery, test-kit forehead heart window
    - Page controls: head-size slider, cover on/see-through/off, cover and
    shell colours, channel numbers, single-use vs reusable overlay,
    9-step session walkthrough, Session tab, rewritten Build/Changes/Specs
    - docs/v4.md, designs.json, README and docs index; v3 marked superseded
2026-11-07 v4.1 frame: bought ratchet halo, printed spine, spring-loaded pods
    - Soft midline strap replaced by a rigid 3D-printed spine with a
    slide-lock length joint; Fz, Cz, Pz pods hang in spring carriages
    (spring visible in see-through view)
    - Halo and fit dial are a bought hard-hat ratchet suspension, one size
    52-64 cm; S/M/L frames dropped; fit slider now 520-620 mm
    - Knit cover dropped for a wipe-clean silicone/TPU lining (kept only as
    a "knit idea" comparison)
    - Build tab: buy/print sources, frame build steps, frame test first;
    specs, changes, sources, session and pod guide text updated (D34)
    - docs/v4.md, README, designs.json
2026-11-07 Docs: frame build notes (helmet harness, spring carriage, version 1)
    - docs/v4.md: Karam PN521 harness (what to keep/remove), how printed
    parts attach, spring carriage details, fixed-hole version 1, sleeve
    fit test, measurements needed, order of work; budget updated
    - v4 page Build tab: helmet harness as the halo source, priced
2026-11-07 Docs: ideas from the 7 Nov v4 review (not decisions)
    Hair pods, threaded carriages, spine depth, weight estimate, frame-test additions, doc wording fixes.
2026-11-07 v4.2: flexible midline band, template-placed forehead strip, 500-580 mm fit
    The rigid spine stood at one height, but across 500-580 mm heads the scalp
    under Cz moves about 7 mm with size and up to 10 mm with shape, more than the
    6 mm spring travel. Replace it with a 26 x 2 mm band that lies on the head on a
    thin lining, a cam lock at the back, and carriages clamped to the band.
    - Pods set from one nasion-inion tape: band reads 0 over Fpz; Fz, Cz, Pz at
    0.2, 0.4, 0.6 x NI. Fit slider now 500-580 mm (D19) with these readings.
    - Forehead strip placed on the skin with a nasion template (centre pad at
    10% NI), one size with 27 mm centres, 3-way tail into the brow module;
    locator notch unde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
2026-11-07 v4.3: size-number band holes, wet tip cartridge pods, wetting check
    - Band: five numbered pin holes per pod (size 1-5 = nasion-inion 304-344 mm
    in 10 mm steps) instead of a slot and mm readings. Pods stay within 1 mm
    (Fz), 2 mm (Cz), 3 mm (Pz) of their sites. Fit readout shows one size number.
    - Hair pods: no 1 ml reservoir. Pre-wetted single-use foam tip in a snap-on
    collar; 2 mm lid hole for 2-4 drops of 0.9% saline only when flagged.
    Watertight print and epoxy seal notes; dome vs fingered tip under test.
    - Contact check: per-pod green/amber/red from AC lead-off between blocks,
    with "add drops" prompts; channel-noise flags during recording.
    - Build tab: impedance calibration and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
2026-11-07 v4.3: shorter pod, visible tip collar, numbered size holes
    - Hair cup 13 -> 8 mm now there is no reservoir; carriage top 28.5 -> 24 mm
    above the scalp, so less sideways lever on the band.
    - Cap skirt stops above the snap-on tip collar; carriage stands on two feet
    either side of the pod window, so the single-use tip is visible.
    - Band size holes larger, with printed numbers 1-5 beside each window.
    - Build guide and docs/v4.md updated.
2026-11-07 v4.3: size holes at true spacing, staggered, behind each carriage
    One size step moves Fz 2 mm, Cz 4 mm and Pz 6 mm, so the holes sit in two
    staggered rows (1, 3, 5 and 2, 4) on the band just behind each carriage, with
    numbers beside them and a pin tab from the carriage. Keeps them printable and
    readable instead of hidden under the housing.
2026-11-07 v4.3: board fits the brow module (60 x 32 mm, ESP32-S3-MINI-1), no light bar
    The 60 x 45 mm v1 board was as tall as the curved brow module, so its corners
    poked through where the shell thins. Board is now 60 x 32 mm with every part
    position mapped onto it, the ESP32-S3-MINI-1 (15.4 x 20.5 mm, X03) lies
    sideways with its antenna keep-out at the left edge, and the board guide's
    callouts, zones and flows follow. Front status light removed for the MVP.
2026-11-07 v4.3: continuous sensor leads to their connectors; J6 and J7 on the board
    Mastoid pads, earlobe clip and test-kit ECG leads were drawn only up to the
    halo, and the wire to the board started a few mm away, so in electronics view
    they looked cut. Each is now one cable from the snap or clip, along the halo,
    into the brow module and onto its connector (M1 to J2, M2 to J3, earlobe to
    J6, ECG pair to J7). J6 and J7 now sit on the main board, not only in the
    board guide.
2026-11-07 v4.3: pad and clip leads end where the cable continues (no stubs)
2026-11-07 v4.3: one continuous cable per sensor in see-through and electronics views
    The outside pad and clip leads and the full cable to the board were two
    tubes in different colours, so the joint showed. In see-through and
    electronics views the outside stubs now hide and each sensor shows a single
    cable from its snap or clip to its connector (M1, M2, eye and earlobe), each
    in its own colour. The normal view still shows the short outside leads.
2026-11-07 v4.3: printable pod (3 parts), cables along band edges, real ear clip, I2C fix
    Pod: no separate cap or socket ring and no LEDs. Three printed parts: a
    one-piece carriage (housing, feet, size-pin tab, side slot for the lead), a
    9 mm sealed pod body (cup + epoxied lid, 4 mm stud, 2 mm top-up hole) and the
    wet tip cartridge. The snap lead clips onto the stud, loops through the side
    slot for the spring travel and runs along the band edge (Fz, Pz left; Cz
    right) to J1, so no cable passes under a pod window. Electrode build guide
    redrawn at 9 mm with the bonded lid and a 2-4 drop top-up.
    Ear clip: hinge below the lobe, pocket for the MAX30102 breakout with a
    flush window, black jaws and pad again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
2026-11-07 v4.3: fix ear-clip cable start; docs for pod parts, cables, ear clip, I2C
    The clip's cable-exit point was converted to world coordinates in place, so
    the second cable started far below the clip. docs/v4.md: pod as three
    printed parts with a parts table, cable routing along the band edges, a new
    "Ear clip and heart-sensor wiring" section (buy the MAX30102 breakout, print
    the clip, 5-wire lead, pull-up check, second I2C bus for the test-kit sensor).
2026-11-07 v4.3: electrode guide labels match the sealed pod (stud for the snap lead, epoxied lid)
2026-11-07 v4.3: brow module clears the forehead pads; MVP forehead = 3 snap pads + leads
    The module's underside now sits 6.5 mm off the skin over the forehead pads
    and rests on a soft brow pad above them, so it never presses on the gel. The
    board and the halo's front ends move up with it. MVP forehead contacts are
    three separate snap pads placed with the template card and three snap leads;
    the custom strip with one tail stays the product version, and a click-on
    socket insert is noted as a later option. Setup steps, parts list, Changes
    tab and docs/v4.md updated.
2026-11-07 v4.3: carriage keeps a solid wall with a small 5 x 6 mm window for the snap lead (no full-height slit)
2026-11-07 v4.3: carriage feet are curved continuations of the housing wall; pin tab runs from under the housing with its pin in the size hole
2026-11-07 v4.3: midline band in FR4 fibreglass (bare PCB, 0.6-0.8 mm); PETG print for first fit tests only
    Bent PETG creeps over months; FR4 is a spring with fab-cut holes and silkscreen size numbers.
    Model band now 0.8 mm in white solder mask; parts, buy map, BOM, frame step 3, changes and docs/v4.md updated.
2026-11-07 v4.4: size range 300-390 mm (9 sizes), band printed in the head's curve with TPU tail, halo small-head insert, damp 2-3 mm foam tip, upright session
    - Nasion-inion measured separately (fit slider), 9 sizes cover 300-390 mm (Campbell 2009; Rashid 2025);
    one row of size holes beside each window, pin under the carriage foot; Fz holes serve two sizes
    - FR4 band dropped: JLCPCB caps 0.6 mm at 100 x 100 and 0.8-1.0 mm at 300 x 300 mm; pod section printed
    pre-curved (PETG fit tests, PA12 Study 1), spliced behind Pz to a TPU tail
    - PN521 range unpublished: assume 54 cm, 3 mm lining or 7 mm small-head insert
    - Foam tip 2-3 mm proud, wetted to a set weight, spring from ~1 N with shims; hydrogel ti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
2026-11-07 v4.4: fit order (dial before band lock) and room for the ratchet strap ends in the battery pod
2026-11-07 Add rev A EEG board (KiCad project and JLCPCB fab files) in pcb/
    [neuryo-B_Cu.gbl, neuryo-B_Mask.gbs, neuryo-B_Paste.gbp, neuryo-B_Silkscreen.gbo, neuryo-Edge_Cuts.gm1, neuryo-F_Cu.gtl, neuryo-F_Mask.gts, neuryo-F_Paste.gtp]
2026-11-07 v5 trial: board in a side box above the left ear (v4 unchanged)
2026-11-07 v4.5: XIAO ESP32-S3 main board in the brow module, drop v5
    - v4 page: Seeed XIAO ESP32-S3 (21 x 17.8 mm) soldered flat replaces the
    bare ESP32-S3-MINI-1; USB-C, charger and 3.3 V come from the XIAO; flex
    antenna on U.FL, no antenna keep-out; board guide, parts, Build list,
    Changes and Sources updated; battery estimate 8-10 h (was 14 h).
    - Third MAX30102 for the test-kit forehead window.
    - docs/v4.md: Main board (v4.5) section with options compared and the
    rev B changes from rev A.
    - pcb/README: rev A is the v3 board; v4 needs rev B.
    - Remove the v5 side-box trial (design, doc, designs.json entry).
2026-11-07 v4.5: rev B copies Low-Cost-EEG's analog half; bigger brow module
    - pcb/: remove rev A (in history); add the Low-Cost-EEG reference design
    (Altium project, Gerbers, schematic, report; GPL-3.0, commit 3730d31)
    and the rev B plan: analog half copied unchanged, XIAO ESP32-S3 on the
    digital side, draft pin map, steps, licence.
    - v4 page: board about 70 x 50 mm; brow module about 140 x 65 mm and
    29.5 mm off the skin (fit check on the head model); halo and band stay
    where they were; input protection, power and board guide follow the
    reference design; sources added.
    - docs/v4.md: Main board section rewritten with the fit check table,
    options compared and the correction that the report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
    [ADS ESP EEG.GBL, ADS ESP EEG.GBO, ADS ESP EEG.GBP, ADS ESP EEG.GBS, ADS ESP EEG.GM1, ADS ESP EEG.GTL, ADS ESP EEG.GTO, ADS ESP EEG.GTP]
2026-11-07 v5 arch concept: board and battery pods above the ears, spring arch over Cz, pivot bar for Fz/Pz, rear hook and dial
2026-11-07 v5: hide forehead sockets with the strip, frame views higher
2026-11-07 pcb README: note the v5 left pod
2026-11-07 v5 doc: keep the hydrogel forehead strip, with clinical precedents
    BIS Quatro, SedLine and Entropy all use frameless single-use pre-gelled
    adhesive strips; Masimo warns pressure lowers signal quality.
2026-11-07 v5: strip runs to both temple pads; electrode leads soldered to the board
    The forehead strip gets thin S-bend arms to both temple pads so it reads
    as part of the headset. The reference board's 8.4 mm input headers are
    left off and leads soldered in, so the left pod stays about 20.5 mm proud;
    the PCB layout is unchanged.
2026-11-07 v5: fix the midline bar for other head sizes; soft springs; dial from PN521
    The bar followed this head's curve, so on other heads the scalp under the
    Fz/Pz holes moved 4-8 mm closer or 1-2 mm further than the spring could
    take. It now runs straight along the Cz-Fz and Cz-Pz lines through the hole
    rows (shallow V at the pivot), leaving about +/-3 mm from head shape, taken
    by a softer 0.13 N/mm spring with ~10 mm stroke (carriages +4 mm, bar 26 mm,
    arch 35 mm). Rear dial: cut the matched ratchet out of a PN521 harness.
    Adds tools/bar_gap.py (the check) and the frame-test force limits.
2026-11-07 v5.1: elastic midline strap replaces the pivot bar; pod caps with side fill port
    The bar only fit the model head (pods ~20 deg off it, reach changing with
    head size). An elastic strap over the Fz/Cz/Pz pods presses each straight
    in with ~0.82-0.99 N per N of tension across 300-390 mm nasion-inion and
    +-8% shape (tools/strap_force.py). Front Y clip with legs back along the
    hair, slider on the rear band, size marks on the strap. Docs updated; the
    bar sections are marked superseded.
2026-11-07 v5.1b: non-stretch webbing middle with size holes, elastic ends
    Size marks on elastic drift when it stretches; the Fz-Cz-Pz section is now
    PP webbing with heat-punched size holes the pods pin into, elastic only at
    the ends. Webbing bends freely, so the tension still presses each pod.
    Cz cap sits in a saddle on the arch to register the strip to the ears.
2026-11-07 v5.1b: Cz cap fork straddles the arch with vertical play, so no frame weight rests on Cz
2026-11-07 v5.1b: strap ends at a back clip with legs to the rear band; Pz riser
    A straight run from Pz to the rear band passed ~12 mm inside the scalp, so
    the strap would wrap the occiput. Back clip behind Pz (150 deg) with elastic
    legs to sliders on the rear band; Pz cap 6 mm taller. Per N of tension:
    Fz 0.92-0.99, Cz 0.76-0.89, Pz 0.84-0.91 (tools/strap_force.py).
2026-11-07 Buy plan: strap tension mark at 1.5 N on the back legs
2026-11-07 v5 model: remove the old pivot-bar code and leftovers
    Drop the unused bar, pivot, spring carriages and hole rows; remove the
    stale 'Pivot at Cz' label; size dims now measure the webbing holes; the
    strap parts hide with the frame in the electronics and skin-side views.
2026-11-07 v5: Display toggle for the suggested strap fix (TPU band + constant-force spring)
2026-11-07 Ultracortex pod adapter: test rig to hold a Neuryo pod in a Mark IV frame node
    Node ring (glued in place of the OpenBCI insert, M20 x 2), pod tube with
    spring seat, knob, fill and lead holes and pin slots, pod body with fill-tube
    force mark, tip collar. STLs generated by tools/uc_adapter.py; viewer page at
    designs/uc-adapter/. Listed in designs.json, README and docs/v5.md.
    [node-ring.stl, pod-body.stl, pod-tube.stl, tip-collar.stl]
2026-11-07 v5.2: rigid midline spine with a spring per pod replaces the strap
    The 7 Nov bar (straight hole rows, soft 0.13 N/mm springs, wedge seats,
    fill tube with 1 N band) comes back as a spine clipped rigidly to the arch
    at Cz (saddle, 2 x M3, no pivot). Strap, Y clip and legs, back clip and
    legs, sliders, stretch marks and the constant-force spring are gone. Fit:
    arch sliders set until the Cz fill-tube band meets its port (1 N), saved
    per patient. Reasons and evidence IDs (C77-C85, L54) in docs/v5.md. Buy
    plan: webbing and elastic out, stainless spring assortment in (est.).
2026-11-07 v5.2: Cz band at 1.1 N and 13 mm pod stroke after the rigid-clip head-shape check
    Worst Fz/Pz gap with the rigid clip is +3.1 to -2.9 mm. At 1 N round heads
    fell to about 0.6 N and long heads passed the 10 mm stroke; now every pod
    stays at about 0.7-1.5 N. Spine 29 mm above the scalp, arch 38 mm over Cz.
    bar_gap.py gains --rigid.
2026-11-07 wip: v5.2b spine, clip and carriages as real solids
2026-11-07 wip: expose camera
2026-11-07 v5.2b: spine, clip and carriages as real parts that fit together
    Spine as two straight printed halves with seats, fill-tube slots and real
    size holes; carriages cut to the spine's underside with snap lips and a pin;
    fill tube up through the spine (band reads against its top); arch moved
    27 mm behind Cz with a clip that has a cable channel; temple pads sit on the
    strip tabs. tools/collide.js finds overlapping solids in the page.
2026-11-08 wip: v6 right-handed frames for tongue, splice plate, numbers
2026-11-08 v6: head ring + v4 midline band, small front anchor, board and battery above the ears
    New design page designs/v6: v4's midline band lying on the head (real
    windows and lining, size holes 1-9, spring carriages with a lead slot)
    held between a small front anchor on a front band and a cam lock above
    the rear dial; v5's side pods and rear band. docs/v6.md, designs.json
    and README updated; v4 and v5 marked superseded.
2026-11-08 v6: rear band as a U, so the dial's toothed straps run on one smooth curve
    The V met at an angle at the dial; a ratchet drives both straps past each
    other on one gear, so they must run along one curve through it. Now a
    level section about 84 mm long under the occiput (bend radius about 69 mm
    or more within 70 mm of the dial), arms at about 31 degrees rising to the
    lower back corner of each pod, and a 60 x 18 mm hook pad along the level
    section. Checked on the page: the band presses 91% into the skin under
    the occiput (skin there faces 29-38% downward).
2026-11-08 v6: socket on the forehead strip's left end tab and a short tail cable to the left pod
    The eye lead and the strip ended in mid-air in the normal view. The strip's
    traces and the eye lead now meet in a small socket on the strip's left end
    tab, and one 4-core tail cable runs from it to the underside of the left
    pod's front corner (same route in the wiring layer).
2026-11-08 pcb: review of rev B against the reference, datasheet and XIAO wiki
    Reference SRB2 is unfiltered (move REF filter to SRB2 for D25), analog
    off while USB is plugged in, charge batteries outside (XIAO charges at
    50 mA), tie START/RESET/PWDN, 51 kOhm bias resistor, keep bottom-side
    parts, XIAO underside pads, stock check. Correct the noise note: the
    reference measured 1.10 uVpp shorted on its own board.
2026-11-08 pcb: full upstream Low-Cost-EEG (3730d31) in pcb/low-cost-eeg
    Replaces pcb/reference/low-cost-eeg: now also firmware, receiver source,
    test scripts, case STLs and docs. Left out: the 12 MB Windows receiver
    build and Altium/Inventor history folders (listed in NOTICE.md).
    [ADS ESP EEG.GBL, ADS ESP EEG.GBO, ADS ESP EEG.GBP, ADS ESP EEG.GBS, ADS ESP EEG.GM1, ADS ESP EEG.GTL, ADS ESP EEG.GTO, ADS ESP EEG.GTP]
2026-11-08 pcb: rev B in KiCad 10 (XIAO ESP32-S3, review changes 1-8, I2C headers, 77x50 outline), change list and review checklist
    Low-Cost-EEG (3730d31) imported into KiCad, Altium clearance rules translated, every edit scripted and
    checked with kicad-cli ERC, DRC (schematic parity, refilled zones) and a pin-by-pin netlist diff after
    each step. Board and schematic agree on all 75 multi-pin nets; DRC 0 unconnected. Not ordered.
    [Low_Cost_EEG.kicad_pcb, Low_Cost_EEG.kicad_sch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]
2026-11-08 Rev B second pass: battery at the right end, PCM12 switch, XIAO pad 25 to GND, KiCad SOT-23, JLC 1.6 mm stack-up, silkscreen, firmware
    - SW1 -> C&K PCM12SMTR; J1/SW1/D6/C49 back at the digital end, analog half free of battery copper
    - U6 pad 25 GND with via (checked against Seeed's module PCB); pads 15-22 copper only
    - Q1 on KiCad's SOT-23; interlock in the top-right corner
    - Stack-up JLC04161H-7628 1.6 mm, ENIG
    - Reference designators re-placed; orphan teardrops removed
    - firmware/: upstream firmware adapted to rev B (pins, SRB2, RESET/START commands, USB interlock, status characteristic)
    - ERC/DRC/netlist/copper diffs and docs updated
    [Neuryo_RevB-Bottom 3D Body.gbr, Neuryo_RevB-Bottom Component Center.gbr, Neuryo_RevB-Bottom Courtyard.gbr, Neuryo_RevB-Bottom Layer.gbl, Neuryo_RevB-Bottom Overlay.gbo, Neuryo_RevB-Bottom Paste.gbp, Neuryo_RevB-Bottom Solder.gbs, Neuryo_RevB-Edge_Cuts.gm1]
2026-11-08 Rev B: rename electrode headers J3A-J3J to J10-J19 (BOM no longer shows J3A?); no connection change
    [Neuryo_RevB-Bottom 3D Body.gbr, Neuryo_RevB-Bottom Component Center.gbr, Neuryo_RevB-Bottom Courtyard.gbr, Neuryo_RevB-Bottom Layer.gbl, Neuryo_RevB-Bottom Overlay.gbo, Neuryo_RevB-Bottom Paste.gbp, Neuryo_RevB-Bottom Solder.gbs, Neuryo_RevB-Edge_Cuts.gm1]
2026-11-08 Docs: fix stale PCB status, pin and pod references; index v6
    - README: rev B is laid out (77 x 50 mm, final pin map, checks, firmware), waiting for review, not ordered; shared head used by v1 to v6
    - pcb/README: USB-present sense is on D9 (GPIO8), not D2; step 5 refers to the v6 left pod
    - docs/README: add v6.md to the index
    - Remove committed __pycache__ and ignore it
2026-11-08 Rev B 3rd pass: restore reference part numbers, battery polarity marks, review items
    - Schematic: hidden MPN field on every part (94 added from the reference's
    production BOM), LCSC on U1/U3/U4/D1-D5, the 19 wrong "100 OHM" resistor
    descriptions corrected. No connection, value or footprint change.
    - Board: "+" and "-" beside J1 pads 2 (VBAT) and 1 (GND). Silkscreen only.
    - scripts/edit_sch_mpn.py (the edit), scripts/jlcbom.py and
    review/fab-draft-do-not-order/bom-jlc.csv (BOM with part numbers).
    - CHANGES R14, B14 and two deliberate non-changes (input-cap DNP, SW1 ON mark);
    checklist: gain vs D29, SPI release scope check, bench A/B for the input caps,
    corrected fault-current estima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
    [Neuryo_RevB.kicad_pcb, Neuryo_RevB.kicad_sch, bom-jlc.csv]
2026-11-08 Rev B 3rd pass: KiCad ERC/DRC, renders and fab draft regenerated
    [Neuryo_RevB-Bottom 3D Body.gbr, Neuryo_RevB-Bottom Component Center.gbr, Neuryo_RevB-Bottom Courtyard.gbr, Neuryo_RevB-Bottom Layer.gbl, Neuryo_RevB-Bottom Overlay.gbo, Neuryo_RevB-Bottom Paste.gbp, Neuryo_RevB-Bottom Solder.gbs, Neuryo_RevB-Edge_Cuts.gm1]
2026-11-08 v6.1: real rev B board in the v6 model, pods sized to it
    - Board placed from Neuryo_RevB.kicad_pcb: 77 x 50 mm, copper/pad/silkscreen
    textures drawn from the file (revb-top.jpg, revb-bottom.jpg), all parts at
    their KiCad positions and heights, electrode end forward.
    - Pods resized to about 98 x 77 mm, 22 mm off the skin (flatter top): every
    part clears a 2 mm wall + 0.5 mm air by >= 0.9 mm; head ring ends follow the
    pod edges.
    - Leads end on their real pads (channels on the - holes, M1 on REF, bias on
    BIAS, ECG on 8+/8-, earlobe clip on J6, battery in J1); BMI270 breakout on J7.
    - Board guide rewritten for rev B; part texts, docs/v6.md, designs.json,
    README, pcb/README and the re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
2026-11-08 Buy plan for v6 (9 Nov): rev B at JLCPCB, re-read prices
    docs/buy-plan/data_v6.py + make_pdf_v6.py -> Neuryo-v6-buy-plan.pdf.
    Standard double-sided PCBA (rev B has 28 bottom parts); XIAO x3 at Robu;
    950 mAh YB-503450 (only protected cell in stock) + JST-PH lead + TP4056
    charger; BMI270 Nano x2; FRI TDE-211 x6; drops DevKitC, Koss, PA12, board
    BMI270 chips. About Rs 62,000 through VIT (Rs 58,400 if the lab has
    filament, scale and caliper).
2026-11-08 v6 try-on: webcam try-on page for v6
    designs/v6/tryon.html (from the v1 try-on) with neuryo-v6.glb exported
    from the v6 page (board and battery left out), the shared head as the
    occluder, and the nasion/scale matched to MediaPipe's canonical face.
    "Try it on" button on the v6 page.
2026-11-08 v6 try-on: default fit from a real-face check (115%, +1, -8 mm), wider size range, remember each viewer's fit
2026-11-10 v6.2: captive click-in carriages, 3 mm rails, Cz pod to test kit, docs and try-on model updated
2026-11-10 v6.2 follow-up: lead clips, strap scale and trimmed forehead pads drawn; guides checked; stale Cz mentions fixed
    - v6 page: two lead clips on the midline band, paper scale on the left dial strap with an index line (plain knob),
    test-kit forehead option with three trimmed gel pads; walkthrough text now says two hair pods
    - try-on model re-exported with tools/export_glb.js and checked in tryon.html
    - pcb/README channel map: ch 7 free on the product headset (no board changes)
    - buy plan: Cz lead and pod core listed as test-kit items, dowel pins removed, PDF rebuilt
    - docs/v6.md: drawn details and second-pass checks
2026-11-10 Rev B 4th pass: XIAO battery holes, SPI series resistors, I2C pull-ups, D10 to RESET, test pads
    Implements REVB-4TH-PASS-PLAN.md (10 Nov review), steps A-I, each scripted
    (scripts/edit_sch4.py, scripts/edit_pcb4.py) and checked with kicad-cli 10.0.8
    (ERC, DRC with schematic parity and refilled zones, netlist, renders) after
    every step.
    - A: XIAO BAT+/BAT- plated holes (0.7 mm), no paste on any XIAO pad
    - B: interlock labels on the bottom silkscreen (no room on top near Q1)
    - C: 330R on SCLK/MOSI/CS (R43-R45); CS resistor on the bottom between two vias
    - D: 4.7k I2C pull-ups to XIAO_3V3 (R46, R47)
    - E: XIAO D10 -> ADS1299 RESET, via the reference's own RESET corridor
    - F: 1.0 mm test pads on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
    [Neuryo_RevB-Bottom 3D Body.gbr, Neuryo_RevB-Bottom Component Center.gbr, Neuryo_RevB-Bottom Courtyard.gbr, Neuryo_RevB-Bottom Layer.gbl, Neuryo_RevB-Bottom Overlay.gbo, Neuryo_RevB-Bottom Paste.gbp, Neuryo_RevB-Bottom Solder.gbs, Neuryo_RevB-Edge_Cuts.gm1]
2026-11-10 Rev B 4th pass: firmware builds (normal and bench), build log
    Both PlatformIO environments, xiao_esp32s3 and xiao_esp32s3_bench, build
    with 0 errors and 0 warnings (espressif32 6.13.0, Arduino core 2.0.17).
    The static_assert confirms XIAO D10 is GPIO9. Docs updated to match.
2026-11-10 Rev B 5th pass: BOM part numbers, R37 10k, J1 drill 0.8, JLCPCB placement file, order folder, firmware fixes
    Applies the 11 Nov review (review/REVB-REVIEW-11NOV.md). Scripted
    (scripts/edit_sch5.py, edit_pcb5.py, jlccpl.py), with kicad-cli 10.0.8
    ERC, DRC (refilled) and netlist diff after every step.
    1. Every assembled part has an LCSC number: 8 exact MPNs, 9 in-stock
    equivalents (same value, tolerance, case; R9 thick film, C14 50 V),
    each JLCPCB part page re-opened, stock from LCSC pages.
    2. R37 100k -> 10k (C25804): Q1 gate leakage margin on battery.
    3. J1 drill 0.7 -> 0.8 mm, board and library; one new DRC item (hole
    0.05 mm into C49's courtyard), left for the owner.
    4. cpl-jlc.c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
    [Neuryo_RevB-Bottom 3D Body.gbr, Neuryo_RevB-Bottom Component Center.gbr, Neuryo_RevB-Bottom Courtyard.gbr, Neuryo_RevB-Bottom Layer.gbl, Neuryo_RevB-Bottom Overlay.gbo, Neuryo_RevB-Bottom Paste.gbp, Neuryo_RevB-Bottom Solder.gbs, Neuryo_RevB-Edge_Cuts.gm1]
2026-11-10 v6.3: no Cz anywhere (D36), two-window midline band, size table fix
    - Model: Cz window, pod, carriage, spring, lead, label, parts entry, guide and tab text removed; channel 7 shown as free.
    - Band: Fz and Pz windows only; the section between them stays solid 1.8 mm (tools/band_fit.py: lift change at the
    carriages within 0.3 mm of v6.2; a thicker section lifts Fz at low tail tension). Two lead clips on that section.
    - Size table centred 305-385 mm (300-309 is size 1 ... 380-390 is size 9): a 390 mm head was 3.6 mm off at Pz.
    - Try-on model re-exported; docs (v6.3 section), READMEs, designs.json, pcb channel map, buy plan (FRI 4 -> 3, PDF rebuilt).
    - Checks: no page errors in Product or Test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
2026-11-11 v7: continuous head ring, flat-faced pods, nasion gauge, fixed Fz
    From the 11 Nov change spec (review of v6.3 at de1e33d). New folder
    designs/v7/; designs/v6/ unchanged and kept as the adjustable-Fz
    alternative. Nothing printed or measured: sizes are model estimates.
    - R1/R2: one ring strap pivot to pivot, pods ride on it (tunnel, 2 x M3);
    PN521 nape section whole, pivoting on the strap ends
    - R3: chin-strap tabs; chin strap in the test kit
    - P1: pods with a flat face 15 mm off the skin (was 22), about 90 x 51 mm
    along the skin; JP1/TP1 left off; BMI270 lower
    - M1: nasion gauge on the anchor; strip after the headset
    - M2: Fz fixed at 69 mm behind the zero; only Pz has a size setting
    - M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
    [bom-hand.csv]
2026-11-11 v7.1: fixes from the review of v7 (edited in place in designs/v7)
    F1 3.0 mm pod clearance, 15.5 mm face, lower/upper/back chamfers, BMI270 to the
    board middle; pod_fit reports outer box and headset width (180.4 mm, was 183.1).
    F2 spare tail folded in half under two 6 mm sliding keepers; tail_travel fold margins.
    F3 Pz window front end 2 mm forward; band_fit_v7 rerun; note in docs/v6.md.
    F4 walkthrough shows each part, lead and label from its own step.
    F5 flat ring strap print (to test); ring_check reports outline and developed length.
    F6 Fz placed by interpolation.
    L1 grey leads with colour end bands, cable groove, anchor cap, two-tone option.
    M5 Midline module display toggle (forehead-only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
2026-11-11 v7.1 review fixes: ring strap print wording, crown strap text, strap tunnel clearance
    Ring strap: printed on its edge as a flat outline, no supports, no heat; it twists
    into place when worn (text said printed flat and heat-formed).
    Crown strap: runs from the anchor over the top to the cam lock (docs said left pod).
    Strap tunnel roof 4.3 to 4.7 mm off the skin: at least 0.44 mm print clearance
    (was 0.04); battery cell 0.4 mm higher. Pod fit 3.01 mm and headset width 180.4 mm
    unchanged; outer box 107.0 x 69.1 x 25.7 mm. Try-on model not re-exported.
2026-11-11 v7.2: hair pod and carriage rework (edited in place in designs/v7)
    From the v7.2 change spec (written against 61dba76) and the 11 Nov electrode review.
    Pod: one printed body (14.2 x 8.5 mm, open cavity, solid top, fill tube opening on the
    foam), 2 x 4 mm Ag/AgCl pin standing 1.5 mm into the foam, epoxy pot, single-use tip
    cartridge pressed into the cavity (12.6 mm chamfered nose, foam 2.5 mm proud).
    Carriage: 14.8 mm bore, guide lip, slit, two closed pin slots with force ticks, 10 mm
    spring space, top at 23.8 mm, stud puck with the snap head; pigtail from pod to puck.
    Pod guide rebuilt in 8 steps from the same POD numbers. Page texts, parts list (3 rows
    edited, 6 added to quote), walkthrough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
    [bore-test.stl, pod-body-rig.stl, pod-body.stl, stud-puck.stl, tip-collar.stl]
