aryankalra404/Neuryo-Headset/(notices)

Notices in the files:
parts and their libraries:
Ultraminiature Surface Mount Slide Switch, right-angle, https://www.ckswitches.com/media/1424/pcm.pdf (KiCad library, KiCad/kicad-footprints Button_Switch_SMD, CC-BY-SA 4.0 with KiCad exception)
